Cloudhunter77/szakdolgozat/docs/kontextus/DONTESEK.md

# Döntésnapló

Állapot: **elfogadva** = Balázs megerősítette · **javaslat** = Claude javasolta, nincs megerősítve ·
**elvetve** = már nem érvényes. Új sor a táblázat aljára. Ha egy döntés megváltozik, a régi sort ne töröld,
hanem állítsd *elvetve*-re, és hivatkozz az újra.

> **Számozás (2026-10-14-i összefésülés):** a repóban 2026-10-11-én D26-ként rögzített STM32F303RET6-döntés a
> claude.ai Projekt számozásában a **D27**; a D26 a projekt neve. A D04 elvetése (repó, 2026-10-11) a D04 sorába
> került. Innentől a Projekt és a repó számozása azonos.

| # | Dátum | Döntés | Indoklás | Állapot | Forrás |
|---|---|---|---|---|---|
| D01 | 2026-09-18 | A központi vezérlő MCU **ESP32-C6** | WiFi 6 + BLE 5.3 + 802.15.4 (Thread) egy chipen, hivatalos Matter SDK | elfogadva | [c6-firmware](beszelgetesek/2026-09-18-c6-firmware-tervezes.md) |
| D02 | 2026-09-18 | A C6 firmware-alapja az **ESP-Matter** (Espressif SDK, `connectedhomeip` alapon) | Gyártói, karbantartott, kész példák | elfogadva | [c6-firmware](beszelgetesek/2026-09-18-c6-firmware-tervezes.md) |
| D03 | 2026-09-30 | Relé: **Schrack 24 V SPDT** (~50 db, kézben) a Songle SRD-24VDC-SL-C helyett | Megbízhatóbb, VDE, megerősített tekercs–érintkező szigetelés a 230 V-os oldalon | javaslat (típuskód függ) | [relek](beszelgetesek/2026-09-30-schrack-relek-io-expander.md) |
| D04 | 2026-09-30 | I/O expander: **TCA9554/PCA9554** a PCF8574 helyett | A PCF8574 bootkor HIGH → a relék meghúznak; a TCA9554 bemenetként indul, push-pull, ESPHome támogatja | elvetve (2026-10-11 → D18, D27: az ULN2803A-t a modul STM32-je hajtja, nem kell I/O expander) | [relek](beszelgetesek/2026-09-30-schrack-relek-io-expander.md) |
| D05 | 2026-10-02 | Ajtóérzékelés: **AH1911 Hall-kapcsoló + mágnes** a lézeres modul helyett | ~1,6 µA, nincs lézer, egyszerű bekötés, a szakdolgozatban könnyű indokolni | elfogadva (a demó erre épül) | [alkatreszek](beszelgetesek/2026-10-02-alkatreszek-led-ajtoerzekelo.md) |
| D06 | 2026-10-02 | LED-meghajtás új tervben: **logic-level FET** (pl. AO3400A); a nem logic-level FET-ek csak driverrel | 3,3 V-on a nagy FET-ek nem nyitnak ki rendesen | elvetve (→ D17) | [alkatreszek](beszelgetesek/2026-10-02-alkatreszek-led-ajtoerzekelo.md) |
| D07 | 2026-10-09 | Fejlesztés **Linux Mint** alatt, Claude Code-dal a laptopon | – | elfogadva | [mai nap](beszelgetesek/2026-10-09-esphome-demo-matter-git.md) |
| D08 | 2026-10-09 | Gyors demó **ESPHome**-mal: helyi (edge) logika a node-on, webes felület, relé bootkor KI | Még aznap bemutatható legyen, HA nélkül is működjön | elfogadva, tesztelve (`cp-01`) | [mai nap](beszelgetesek/2026-10-09-esphome-demo-matter-git.md) |
| D09 | 2026-10-09 | Végleges irány: **Matter over Thread**, vezérlő: **Home Assistant** | Balázs otthoni hálózata HA + Thread | elfogadva | [mai nap](beszelgetesek/2026-10-09-esphome-demo-matter-git.md) |
| D10 | 2026-10-09 | Matter kiindulás: esp-matter `release/v1.6` `managed_component_light`, ESP-IDF v5.5.5, `esp_matter` ~1.5.0 komponens | Nem kell connectedhomeip klón; a hivatalos CI ugyanígy fordítja a C6 Thread buildet | kiinduló alap | [mai nap](beszelgetesek/2026-10-09-esphome-demo-matter-git.md) |
| D11 | 2026-10-09 | Verziókezelés: GitHub, `firmware/` szerkezet, `cp-NN-*` annotált tag csak **hardveren tesztelt** állapotra + `CHECKPOINTS.md` | Visszaállítható, bemutatható mérföldkövek | elfogadva | [mai nap](beszelgetesek/2026-10-09-esphome-demo-matter-git.md) |
| D12 | 2026-10-09 | Munkaszabály: **minden módosító lépés előtt kérdezni** | Balázs kérése | elfogadva | [mai nap](beszelgetesek/2026-10-09-esphome-demo-matter-git.md) |
| D13 | 2026-10-09 | A megbeszéltek a repóban (`docs/kontextus/`) és a claude.ai Projekt tudástárában is | A Claude Code és a claude.ai chatek ugyanazt a képet lássák | elfogadva | [mai nap](beszelgetesek/2026-10-09-esphome-demo-matter-git.md) |
| D14 | 2026-10-09 | Fejlesztéshez a HA Matter Serverben **test-net DCL** bekapcsolva (teszt PAA/DAC elfogadása) | A példa firmware teszt tanúsítvánnyal (VID 0xFFF1) jelentkezik, enélkül a HA az attesztációnál elutasítja | elfogadva | [NAPLO](NAPLO.md) 2026-10-09 |
| D15 | 2026-10-09 | Breadboard LED-meghajtó: kétfokozatú NPN szintillesztő (BC546B) + **FDP2532** low-side, ≈ 12 V gate, 2 csatorna (GPIO20, GPIO21), PWM ≤ 1 kHz | A kézben lévő alkatrészekből; nem invertál, bootkor KI | elfogadva, megépítve és bemérve | [led-breadboard](beszelgetesek/2026-10-09-led-meghajto-breadboard-cct.md) |
| D16 | 2026-10-10 | Egy **CCT szalag** (3000/6000 K, 24 V, 16 W/m, 18 m; táp 15 A) a két csatornán: Matter Color Temperature Light, maximális fényerős keverés, áramszünet után KI, 0,5 s átmenet, BOOT 1×: ki/be, 2×: színléptetés; a board RGB LED-je állapotjelző; GPIO20 = meleg, GPIO21 = hideg (nem végleges) | Balázs válaszai | elfogadva (firmware még nincs kész) | [led-breadboard](beszelgetesek/2026-10-09-led-meghajto-breadboard-cct.md) |
| D17 | 2026-10-10 | Végleges LED-modul: csatornánként **10 A**, PWM **20 kHz felett (25 kHz)**, **gate driver** (pl. UCC27524, 12 V) + **60 V-os normál FET** (pl. IPD053N06N); a PWM-et a modul MCU-ja adja | 3,3 V-ról a logic-level FET sem nyit ki biztosan, a PWM-forrás kevés áramot ad → 25 kHz-en W-os veszteség; driverrel kb. 1 W/csatorna, hűtőborda nélkül | követelmény és irány elfogadva; típusok javaslat; csatornaszám → D39, D43 | [architektura](beszelgetesek/2026-10-10-node-modul-architektura.md) |
| D18 | 2026-10-10 | **Node = ESP32-C6 vezérlő + modulok**; minden modulon saját MCU (STM32), modul–vezérlő ≤ 0,5 m, JST-lánc; a node-ok Matter over Thread / WiFi / Ethernet kapcsolattal | Okos, cserélhető modulok; kb. 20 STM32 kézben | elfogadva | [architektura](beszelgetesek/2026-10-10-node-modul-architektura.md) |
| D19 | 2026-10-10 | Modul-busz: **CAN** (C6 TWAI + 3,3 V transceiver, pl. TCAN330); JST-XH 4 tű: +24 V, GND, CAN_H, CAN_L; 120 Ω a vezérlőn + lezáródugó a lánc végén | UID-alapú címkiosztás plusz vezeték nélkül, eseményvezérelt, bírja a GND-eltolódást; az RS-485 itt nem ad többet | elfogadva; a feltétel (CAN az STM32-ben) teljesül → D27; a lánc kiosztása és a modulok transceivere módosult → D28; a lezárás módja → D49, D52; a vezérlő transceivere TCAN1044AV → D60 | [architektura](beszelgetesek/2026-10-10-node-modul-architektura.md) |
| D20 | 2026-10-10 | Okos modulok: **automatikus címkiosztás az STM32 UID-jával**, egységes regisztertábla (típus, HW/FW verzió, UID, képességek, állapot, hőmérséklet, hibaszámlálók); modul-firmware frissítése a buszon **bootloaderrel** | Minden automatikus legyen; 20 modult nem lehet egyenként ST-Linkkel frissíteni | elfogadva (a bootloader a NYÁK-rendelés után; a NYÁK-on: SWD, BOOT0 pad, ≥ 64 KB flash) | [architektura](beszelgetesek/2026-10-10-node-modul-architektura.md) |
| D21 | 2026-10-10 | Matter: a node **Matter-híd** (Aggregator + modulonként Bridged Node endpoint, Reachable attribútum, UID → endpoint az NVS-ben) | Új modul újrapárosítás nélkül jelenik meg a HA-ban | elfogadva (a váltás egyszer újrapárosítással jár; a HA dinamikus endpoint-kezelését tesztelni kell) | [architektura](beszelgetesek/2026-10-10-node-modul-architektura.md) |
| D22 | 2026-10-10 | Állapot: busz- vagy vezérlőkiesésnél a modul **tartja az utolsó állapotot**; a hiteles állapot a vezérlőnél, modul-újrainduláskor visszaküldi; teljes áramszünet → StartUpOnOff | Balázs kérése; a modul nem koptatja a flash-t | elfogadva | [architektura](beszelgetesek/2026-10-10-node-modul-architektura.md) |
| D23 | 2026-10-10 | Táp: a JST-láncon csak logikai táp; nagyáramú modulnak saját sorkapocs + biztosíték; csillagpont; a 24 V bemeneten TVS + fordított polaritás elleni P-FET; modulonként ≥ 60 V-os buck (pl. LMR36006) | Földhurok, túlfeszültség (a TVS kb. 45 V-on vág), JST-áramkorlát | elfogadva (típusok javaslat); a láncon nincs többé 24 V, csak a busz 5 V-ja → D28; a modulmag buckja helyett P78E05 + NCP1117 → D56, D57 · a fordított polaritás elleni P-FET helyett Schottky / ideális dióda (D65, D71) | [architektura](beszelgetesek/2026-10-10-node-modul-architektura.md) |
| D24 | 2026-10-10 | EMC: fázistolás és frekvencia-dithering firmware-ből, lassított él, kis hurkok; CAN ESD-dióda + osztott lezárás; snubber / CM fojtó / ferrit csak footprintként | A kereskedelmi termékek olcsó eszközei; alkatrész csak mérés alapján | elfogadva (irányelv); az osztott lezárás helyett sima 120 Ω → D52 | [architektura](beszelgetesek/2026-10-10-node-modul-architektura.md) |
| D25 | 2026-10-10 | Védésre: **vezérlő + 3 modul** (LED CCT, relé, szenzor), közös „modulmag” blokk; NYÁK-rendelés legkésőbb **≈ 2026-10-31** | Balázs határideje; a modulmagot egyszer kell megtervezni | elfogadva | [architektura](beszelgetesek/2026-10-10-node-modul-architektura.md) |
| D26 | 2026-09-18 | A projekt neve: **Moduláris okosotthon platform** (a ModuNode munkanév helyett) | Balázs döntése („a modunode-ot felejtsd el”) | elfogadva (a dokumentumokban még ModuNode szerepel) | [can-izolacio](beszelgetesek/2026-10-13-can-izolacio-stm32f303.md) |
| D27 | 2026-10-11 / 2026-10-13 | Modul-MCU a prototípushoz: **STM32F303RET6** (8 db kézben): 1× bxCAN, 512 KB flash, 72 MHz, LQFP64. CAN a **PA11/PA12** lábakon. A gyári ROM bootloader nem tud CAN-t → saját bootloader (D20). Firmware: MCU-független protokoll + vékony hardverréteg (`can_hw`, `pwm_hw`, `flash_hw`) | Van benne CAN → a D19 feltétele teljesül; 25 kHz-en ~11,5 bites PWM; 3 modul + 5 tartalék. A PA11/PA12, mert a G4-en a PB8 = BOOT0 | elfogadva (MCU); a repóban 2026-10-11-én D26-ként rögzítve. Csereút: STM32G431RBT6 (FDCAN) – javaslat; az ST AN5094 szerint a G4 LQFP64-es lábkiosztása eltér az F303-étól → új layout kell, a CAN-meghajtó absztrakciós réteg mögé · MCU → **D78** (STM32L433RCT3, 75 db kézben) | [can-izolacio](beszelgetesek/2026-10-13-can-izolacio-stm32f303.md), [NAPLO](NAPLO.md) 2026-10-11 |
| D28 | 2026-10-13 | **Galvanikusan leválasztott modulbusz:** modulonként izolált CAN transceiver; lánc, JST-XH 4 tű: **V_BUS 5 V, GND_BUS, CAN_H, CAN_L** – nincs 24 V a láncon; a V_BUS-t a vezérlő adja áramkorlátozva, a modulok V_BUS-bemenete védett (polyfuse + TVS); a szenzormodul járhat V_BUS-ról | Bármely modul bármely tápra / fázisra köthető; elvesző föld esetén nincs út a 10–20 A-nek a vékony láncon; a lánc zárlata nem zár rövidre 24 V-os tápot; a busz túléli a félredugást | irány elfogadva (Balázs: „hajlok az igen felé”); a kiosztás javaslat; az IC → D33; a prototípusban opcionális → D35, D36; a V_BUS túlfeszültség-védelme → D55. Elvetve: ISOW1044 (drága, ~47 % hatásfok, EMC); ISO1540 (I²C-izolátor, nem CAN) · **a galvanikus leválasztás, a GND_BUS és a modulok saját 24 V-os logikai tápja megszűnt → D71** (közös föld, V_BUS = minden modul logikai tápja) | [can-izolacio](beszelgetesek/2026-10-13-can-izolacio-stm32f303.md) |
| D29 | 2026-10-13 | **Audió kikerül a modulrendszerből:** a hangkijátszó egység önálló, saját Wi-Fi-vel; a vezérlőnek nem kell I²S | Balázs döntése; CAN-en hang egyébként sem vihető (≤ 1 Mbit/s vs. ~1,4 Mbit/s) | elfogadva | [can-izolacio](beszelgetesek/2026-10-13-can-izolacio-stm32f303.md) |
| D30 | 2026-10-13 | Tűzvédelem a teljesítményúton: biztosíték a forrás oldalán; a LED-táp ágakra bontva (≤ 100 W/ág, ágankénti biztosíték); rugós sorkapocs + érvéghüvely; álmennyezetben/tetőtérben V-0 vagy fém ház, relémodul elosztódobozban; firmware-NTC csak harmadik réteg | Az izoláció a jelutat védi, a teljesítményutat nem | javaslat · a blokk-biztosíték értéke a szalaghoz → D76 · a LED-modul 20 A-es útján csavaros sorkapocs → D79 | [can-izolacio](beszelgetesek/2026-10-13-can-izolacio-stm32f303.md) |
| D31 | 2026-10-13 | Modul-protokoll: saját, **CANopen-fogalmakra** építve (heartbeat, SDO-szerű regiszterelérés, PDO-szerű események, LSS-szerű UID-címkiosztás), nem teljes CANopen-stack | Egyszerű, de szabványra hivatkozható a dolgozatban | javaslat | [can-izolacio](beszelgetesek/2026-10-13-can-izolacio-stm32f303.md) |
| D32 | 2026-10-13 | Multi-protocol: a node felé a **Matter** (Thread / Wi-Fi / Ethernet, node-onként választható firmware; MQTT később); a modulbusz egységes CAN marad, a protokoll-sokféleség a modulon belül van (átjáró-modul = új modultípus) | C6: egyszerre egy 802.15.4-stack, a Wi-Fi a Threaddel osztozik; egy busz = egy modulmag, kevesebb tesztelés | javaslat | [can-izolacio](beszelgetesek/2026-10-13-can-izolacio-stm32f303.md) |
| D33 | 2026-10-13 | Izolált CAN transceiver: **TI ISO1042BDWVR** (8 lábú SOIC, 7,5 mm széles test, 1,27 mm lábtáv), 10 db DigiKey-ről; az ISO1050DUBR elvetve | ±70 V-os buszlábak (48 V-ot is bír), 5 kVrms; a TI új tervekhez ezt ajánlja; DigiKey-n 30 221 db raktáron. Az ISO1050 csak −27 … +40 V, más tok (2,54 mm) és felcserélt RXD/TXD → nem csereszabatos | típus elfogadva; a DigiKey-rendelés elvetve (költség) → beszerzés: D35 · **→ D71: a v1-ben nincs ISO1042, minden lapon TCAN1044AV** | [can-izolacio](beszelgetesek/2026-10-13-can-izolacio-stm32f303.md) |
| D34 | 2026-10-13 | **24 V-ra tervezünk.** Esetleges 48 V-os (pl. kerti, nagyobb távolságú) változat később: a busz oldal kész (ISO1042), a teljesítményoldalt (TVS, buck, FET, relé, kondenzátorok) és a V_BUS táplálását akkor kell újratervezni; a CAN-bitráta firmware-ből állítható | A 48 V nem fix; a határidőig a 24 V-os prototípus a cél | elfogadva (→ `V2-OTLETEK.md`) · a busz-oldal D71 óta TCAN1044AV (±58 V); a táp 12–26 V (D71) | [can-izolacio](beszelgetesek/2026-10-13-can-izolacio-stm32f303.md) |
| D35 | 2026-10-13 | Az ISO1042 **csak TI-sample-ből**; ha nem érkezik meg, a prototípus **izoláció nélkül** készül. A modulmagon kettős footprint: ISO1042 (DWV) **vagy** szabványos SO-8-as, 3,3 V-os nem izolált CAN transceiver; nem izolált módban a GND_BUS–modul-GND átkötés polyfuse-on át, és minden modul + a vezérlő egy tápról, csillagpontos földdel | Balázs: most nem fér bele a költség, a prototípusban az izoláció elhagyható | beszerzés (TI-sample) elfogadva; a kettős footprint elvetve → D36 · → D71 (izoláció nincs) | [can-izolacio](beszelgetesek/2026-10-13-can-izolacio-stm32f303.md) |
| D36 | 2026-10-13 | A modulmag NYÁK-ján **csak az ISO1042 (DWV) footprintje** van, nincs kettős footprint. Ha a sample nem érkezik meg: ideiglenesen nem izolált 3,3 V-os transceiver-breakout (pl. SN65HVD230) az ISO1042 padjeire kötve (1 VCC1 → 3V3, 2 TXD, 3 RXD, 4 GND1 → GND, 5 GND2 összekötve a 4-gyel, 6 CANL, 7 CANH; a 8 VCC2 szabad); a breakout 120 Ω-os lezárását le kell venni; minden modul + a vezérlő egy tápról | Balázs: a végleges változatban biztosan ISO1042 lesz → tiszta NYÁK. Izolált transceiver nélkül a modul egyáltalán nem kommunikálna, ezért kell a tartalék | elfogadva; a breakout-tartalék javaslat · → D71 (izoláció nincs, a breakout-tartalék tárgytalan) | [can-izolacio](beszelgetesek/2026-10-13-can-izolacio-stm32f303.md) |
| D37 | 2026-10-13 | **v2-re halasztva:** fogyasztásmérés a relémodulon (ADE7953 / SCT-013-030) és PoE a vezérlőn; a v2-ötletek külön jegyzetben | Balázs döntése; a határidőbe nem férnek, a v1 maradjon egyszerű | elfogadva | [V2-OTLETEK](V2-OTLETEK.md) |
| D38 | 2026-10-13 | Buszcsatlakozó: **JST-XH** (2,5 mm) a PH (2,0 mm) helyett | A láncon már nincs 24 V, így az áram (XH 3 A vs. PH 2 A) nem szempont; az XH kézzel könnyebben krimpelhető, vastagabb eret is fogad (AWG 22–30 vs. 24–32), mindenhol olcsón kapható; a helykülönbség egy 4 tűs csatlakozónál kb. 2 mm. Biztos reteszhez ugyanebben a méretben a JST XA lenne, de nehezebben beszerezhető | elfogadva | [NYAK-ELOKESZITES](NYAK-ELOKESZITES.md) |
| D39 | 2026-10-13 | **LED-modul: 5 csatorna** (R, G, B, CW, WW): 3 db UCC27524 (egy csatornája szabad), 5 FET + 5 Schottky; PWM az STM32 két szinkronizált timerén (pl. TIM1 CH1–4 + egy csatorna egy másikon); kimenet 6 pólusú push-in (közös +24 V + 5 csatorna, a szalagok közös anódúak); csatornánként 10 A, a modul össz-árama 20 A (betáp, biztosíték, NYÁK-sáv), a csatornák összegét a firmware korlátozza | Balázs döntése; RGBCCT szalag is van | elvetve → D43 (6 csatorna) | [NYAK-ELOKESZITES](NYAK-ELOKESZITES.md) |
| D40 | 2026-10-13 | **Szenzormodul: 8 általános digitális bemenet** (a 6 fiókos komód + 2 tartalék), az érzékelők 3,3 V-ot kapnak (polyfuse-on át); bemenetenként soros ellenállás + RC-szűrő + ESD (2 × TPD4E05U06); egyetlen 10 tűs XH-csatlakozó (8 jel + 3,3 V + GND); a 8 bemenet különböző lábszámú legyen (külön EXTI-vonal) + HDC3020 | Bemenetenként csak pár fillér; 8 felett már a csatlakozó növeli a lapot; általános bemenetként Hall-szenzor, reed, nyomógomb, PIR is mehet | elvetve → D44 (érzékelőnként külön csatlakozó, minél több bemenet) | [NYAK-ELOKESZITES](NYAK-ELOKESZITES.md) |
| D41 | 2026-10-13 | **Ethernet-hely a vezérlőn**, opcionálisan beültetve (PoE nélkül; a PoE v2, D37) | Balázs döntése | elfogadva; a megvalósítás (tüskesor a W5500-modulnak) elvetve → D45 (W5500 közvetlenül a NYÁK-on) | [NYAK-ELOKESZITES](NYAK-ELOKESZITES.md) |
| D42 | 2026-10-13 | **Lapméret minél kisebb; 4 rétegű NYÁK, ha nem sokkal drágább** | Balázs döntése; a 4 réteg tömör földsíkot ad (EMC a 25 kHz-es PWM mellett, CAN) és sűrűbb, kisebb lapot | elfogadva (az árat a JLC-ajánlatkérőben a tényleges méretekkel ellenőrizni); a lapméretek → D50 | [NYAK-ELOKESZITES](NYAK-ELOKESZITES.md) |
| D43 | 2026-10-13 | **LED-modul: 6 csatorna** → 2 × RGB, 3 × CCT vagy 6 × egyszínű szalag. 3 db UCC27524 (mind a 6 drivercsatorna kihasználva), 6 FET + 6 Schottky. Low-side kapcsolás → a szalagok **közös vezetéke a +24 V** (nem a GND). Kimenet 3 × 3 pólusú push-in blokk: [+24 V, CH1, CH2] [+24 V, CH3, CH4] [+24 V, CH5, CH6] – CCT: blokkonként egy szalag; RGB: R-G-B három egymást követő csatornán, bármelyik +24 V-ról; egyszínű: két szalag egy +24 V-on, iker érvéghüvellyel. Csatornánként 10 A, **össz-áram max. 20 A** (firmware-korlát). Betáp: 2 pólusú push-in 2,5 mm²-hez, **3 eres kábel** (barna +24 V, kék GND, a zöld-sárga nem használható, a kábelt „24 V DC” jelöléssel), 20 A-es mini lapos biztosíték a NYÁK-on. PWM: TIM1 CH1–3 + TIM8 CH1–3, szinkronizálva | Balázs döntése; a 6 csatorna 3 driverrel kihasználja az UCC27524 mindkét csatornáját; a 3 blokkos kiosztás mindhárom szalagtípushoz jó. 20 A-hez 2,5 mm² kell (1,5 mm² kevés, és 24 V-on a feszültségesés is számít) | elfogadva (6 csatorna, 20 A, 3 eres kábel); a kiosztás, a keresztmetszet, a biztosíték és a timerek javaslat | [NYAK-ELOKESZITES](NYAK-ELOKESZITES.md) |
| D44 | 2026-10-13 | **Szenzormodul → általános bemeneti modul:** érzékelőnként külön 3 tűs JST-XH (3,3 V, GND, JEL); a lehető legtöbb STM32-lábat kihasználni (az F303RET6-on kb. 36–38 szabad láb). Javaslat: **16 csatlakozó** a lap két hosszú élén + a többi szabad láb egy **bővítő tüskesoron**; bemenetenként soros ellenállás + ESD (4 × TPD4E05U06) + opcionális felhúzó/lehúzó-ellenállás footprint (osztóként 12/24 V-os jelhez is); néhány csatlakozó ADC-képes lábon; az érzékelők 3,3 V-ja polyfuse-on át; + HDC3020 | Balázs: ahol csak egy dolgot kell figyelni, ne kelljen 10 tűs csatlakozó; minél több láb legyen kihasználva. Mind a ~36 láb külön csatlakozóval kb. 100 × 100 mm-es lapot adna; 16-tal kb. 80–90 mm hosszú | elfogadva (külön csatlakozó, általános bemenetek); a darabszám és a bővítő tüskesor → D48; a csatlakozótípus → D51 | [NYAK-ELOKESZITES](NYAK-ELOKESZITES.md) |
| D45 | 2026-10-13 | **Ethernet közvetlenül a vezérlő NYÁK-ján:** W5500 (LQFP48) + RJ45 beépített trafóval (MagJack) + 25 MHz-es kvarc, a WIZnet referencia-kapcsolása szerint, opcionálisan beültetve; a két differenciális érpár rövid, 100 Ω-os, folytonos földsík fölött (4 réteg, a JLC impedancia-kalkulátorával) | Balázs: nem akar külön modult. A W5500-ban MAC és PHY is van, kevés a külső alkatrész; a trafó egyben galvanikus leválasztás | elfogadva | [NYAK-ELOKESZITES](NYAK-ELOKESZITES.md) |
| D46 | 2026-10-13 | **Vezérlő tápja: két buck a 24 V-ról** – LMR36015 → 3,3 V (C6 + W5500 + TCAN330), LMR36006 → 5 V (V_BUS). Ugyanaz a buck-blokk (hierarchikus lap), mint a modulmagban, csak más IC-vel / visszacsatoló ellenállással; a NYÁK mellé stencil a reflow-hoz | Egyszer kell megtervezni és bemérni; 5 V → 3,3 V LDO-val a C6 + W5500 áramánál túl melegedne | lezárva → D59: a 3,3 V marad LMR36015, a V_BUS-t a P78E05 adja (az LMR36006 elmarad) | [NYAK-ELOKESZITES](NYAK-ELOKESZITES.md) |
| D47 | 2026-10-13 | **LED-modul mérései:** (1) bemeneti 24 V (biztosíték előtt) és a biztosíték utáni +24 V-os sín (= a LED-ek felé menő feszültség) – 100 kΩ/10 kΩ-os osztók az ADC-re; (2) **össz-áram**: 1 mΩ-os sönt (2512, ≥ 1 W, Kelvin-bekötés) a közös visszatérő ágban + **INA181A3** (×100 → 20 A = 2,0 V); offset-nullázás induláskor; (3) **hardveres túláramvédelem**: az F303 belső komparátora az INA kimenetén → a TIM1/TIM8 break bemenete (a PWM firmware nélkül leáll); (4) **csatornánkénti áram nincs**: induláskori önteszt (csatornánként rövid, halvány villanás, kisebb PWM-frekvencián, a bekapcsolt szakasz közepén timer-triggerelt ADC-vel) → csatornánkénti csúcsáram; üzem közben a csatornánkénti teljesítmény a kitöltésből és a mért feszültségből becsülve | Balázs: az össz-áram + kitöltés-alapú becslés elég, az indulási villanás elfogadható. Kb. 8 alkatrész; a hardveres lekapcsolás a tűzvédelemhez sokat ad | elfogadva (alkatrészértékek javaslat); az erősítő, a küszöb és az osztók pontosítva → D53, D54 | [NYAK-ELOKESZITES](NYAK-ELOKESZITES.md) |
| D48 | 2026-10-13 | **Bemeneti modul: 16 általános bemenet**, mindegyik külön 3 tűs csatlakozón, **bővítő tüskesor nélkül**. Ha egy helyen több kell, még egy bemeneti modul kerül a láncra – modulhoz nem kerül kiegészítő modul. A fel nem használt STM32-lábak firmware-ben analóg módban (legkisebb fogyasztás, EMC) | Balázs: 16-nál több bemenet sehol nem kell; a modulrendszer épp a bővítésre való | elvetve → D100 (7 bemenet) | [NYAK-ELOKESZITES](NYAK-ELOKESZITES.md) |
| D49 | 2026-10-13 | **CAN-lezárás jumperrel** minden modulon és a vezérlőn (a vezérlőn és a lánc utolsó modulján bedugva); a jumper az osztott lezárást (2 × 60 Ω + 4,7 nF) kapcsolja; lezáródugó nincs | Balázs döntése; nem vész el egy dugó, és a vezérlő a lánc közepére is kerülhet | elfogadva (jumper); a kapcsolás pontosítva → D52 (sima 120 Ω) | [NYAK-ELOKESZITES](NYAK-ELOKESZITES.md) |
| D50 | 2026-10-13 | **Mechanika: DIN 43880 szerinti moduláris ház-forma** (90 mm magas, 45 mm-es előlap, szélesség 17,5/18 mm-es modulosztásban, kb. 53–58 mm mély), a NYÁK a ház alján fekszik. **Felső váll:** 24 V-os betáp + CAN-busz be/ki (XH) + lezáró jumper; **alsó váll:** a „terepi” csatlakozók (LED-kimenetek, relékimenetek, érzékelők); **előlap:** állapot-LED-ek fényvezetővel. A NYÁK-ot egy kereskedelmi DIN-ház (pl. Camdenboss CNMB) belső méretére tervezni, a 3D-nyomtatott ház ugyanezt a formát követi. Becsült méretek: vezérlő 4 M (~70 mm, NYÁK ~66 × 85 mm), LED-modul 4 M, relémodul 4 M, bemeneti modul 6 M (~106 mm, NYÁK ~100 × 85 mm) | Elosztószekrény fedele alá is befér (a relémodulnak ott a helye, D30); a kábelek a vállakon a kábelcsatornába futnak; a 230 V (relé) és a törpefeszültség természetes módon felül/alul szétválik; a gyári ház és a nyomtatott ház is jó | javaslat · a ház kiválasztva → D73 | [NYAK-ELOKESZITES](NYAK-ELOKESZITES.md) |
| D51 | 2026-10-13 | **Érzékelőcsatlakozók: 3 tűs JST-PH** (2,0 mm) a bemeneti modulon; a busz marad XH | Egy 3 tűs PH kb. 8 mm, az XH kb. 10 mm széles → a 16 bemenet a busz mellett kényelmesen elfér egy 6 modulos ház két vállán. Ráadásul egy érzékelő-dugó fizikailag nem dugható a buszcsatlakozóba (más lábtáv) | javaslat · megvalósítva (bemeneti modul, J301–J316) | [NYAK-ELOKESZITES](NYAK-ELOKESZITES.md) |
| D52 | 2026-10-13 | **CAN-lezárás: sima 120 Ω egy jumperrel** (CAN_H → jumper → 120 Ω → CAN_L), nem osztott lezárás; csak a lánc két végén bedugva | Egyetlen jumperrel az osztott lezárás nem kapcsolható ki tisztán (nyitva a 60 Ω + 4,7 nF a CAN_L-en maradna → aszimmetrikus terhelés); 0,5 m-es buszon a sima 120 Ω tökéletes | javaslat | [MODULMAG-SPEC](MODULMAG-SPEC.md) |
| D53 | 2026-10-13 | **LED-modul túláramvédelem pontosítva:** **INA181A2** (×50; 20 A → 1,0 V, ~66 A-ig mér) alacsony oldali 1 mΩ-os söntön; a kimenet a PA7-re (ADC2_IN4 + COMP2 nem invertáló bemenet); a COMP2 invertáló bemenete a **DAC1_OUT1 (PA4, foglalt)** → telepítésenként állítható küszöb (alapból ~22 A; tartalék fix küszöb: VREFINT ≈ 24 A, ¾ ≈ 18 A, ½ ≈ 12 A); a COMP2 kimenete a TIM1 BKIN2 + TIM8 BKIN2-re; a firmware a COMP2-t és a DAC-ot a DRV_EN előtt állítja be | Egy fix 24 A-es küszöb egy 15 A-es tápnál soha nem oldana ki; a DAC-küszöbbel a ténylegesen beállított maximumhoz igazítható | javaslat | [MODULMAG-SPEC](MODULMAG-SPEC.md) |
| D54 | 2026-10-13 | **Modulmag-lábkiosztás és -tápleágazás:** CAN = PA11/PA12, SWD = PA13/PA14, debug-UART = USART1 PC4/PC5, HSE = PF0/PF1, állapot-LED = PC13 (nyelő), HW-ID = PC0, VIN_SENSE = PC1 (150 kΩ/10 kΩ); modulspecifikus lábak a MODULMAG-SPEC 7. fejezete szerint (LED: TIM1 PA8–PA10, TIM8 PC6–PC8, I_SENSE PA7, DAC PA4, V_RAIL PC2, NTC PC3, DRV_EN PB12 4,7 kΩ lehúzással; relé: PB12–PB15; bemeneti: IN0–IN15 = PA0–PA10, PB11–PB15, I²C1 PB8/PB9). A LED-modul logikai tápja a 20 A-es főbiztosíték **előtt** ágazik le (saját 0,5 A-es F1) | Az ST pin-adatai alapján ütközésmentes; a bemenetek 16 különböző EXTI-vonalon; a főbiztosíték kiégése így jelezhető | javaslat (CubeMX-ben ellenőrizendő) | [MODULMAG-SPEC](MODULMAG-SPEC.md) |
| D55 | 2026-10-13 | **V_BUS túlfeszültség-védelem a modulokon:** (1) TVS + PTC („legjobb erőfeszítés”), vagy (2) TPS2660 eFuse (OVP ~5,7 V) minden modulon | Az ISO1042 VCC2-je és a TLV75533 bemenete abszolút max. 6 V; az 5 V-os TVS ~6,4 V-tól vezet, a PTC lassú → egy félredugott 24 V-ot nem véd biztosan | **lezárva (Balázs, 2026-10-14): nincs 24 V elleni védelem** („nem lesz 24 V a buszon”, D28); a modulokról a PTC is kikerül (a TPS2553 előbb korlátoz), az 5 V-os TVS marad az ESD / hot-plug ellen; TPS2660 nem kell · → D71: a túlfeszültség (5,7 V) és a túláram (2 A) ellen központi TPS2595 eFuse véd a vezérlőn | [MODULMAG-SPEC](MODULMAG-SPEC.md) |
| D56 | 2026-10-13 | **Modulmag tápja (A változat): P78E05-1000** (CUI/Bel, 24 V → 5 V, 1 A, SIP-3, a 7805 lábkiosztásával) **+ NCP1117ST33** (onsemi LDO, 5 V → 3,3 V, SOT-223) az LMR36006BRNXR helyett; az 5 V-os sín a modul lapján elérhető. A B változat (TLV75533 a V_BUS-ról) változatlan | Kézben ~200 db P78E05 és egy tekercs NCP1117 → nem kell TI-sample, tekercs, buck-layout és VQFN-reflow; a modulmag 3,3 V-os fogyasztása < 100 mA → az LDO-n ~0,17 W. Ára: a P78E05 bemenete max. 36 V (abszolút maximum nincs megadva) a 60 V-os buck helyett → kisebb tüsketartalék (→ D57); egy 48 V-os változathoz (D34) más táp kell | elfogadva (Balázs: „van vagy 200 db a p78e05-ből, úgyhogy szerintem az lesz”); az értékek javaslat (MODULMAG-SPEC 2.); a vezérlő tápja → D59 · **→ D71: a modulokon nincs P78E05/NCP1117, a logika a V_BUS-ról jár (AP2112K)** | [alkatreszkeszlet](beszelgetesek/2026-10-14-alkatreszkeszlet-p78e05.md) |
| D57 | 2026-10-14 | **A modulmag 24 V-os bemenetének védelme a P78E05 36 V-os határa miatt:** (1) a bemeneti **elektrolit kötelező** (C12, 47 µF / 50 V, low-ESR) a kerámiák mellett; (2) az SMBJ28A marad; (3) a 24 V-os tápot **≤ 26 V**-ra állítani; (4) opcionális **10 Ω-os soros ellenállás** (R6, 1206, impulzusbíró) a D1 után, 0 Ω-mal áthidalható | Bedugáskor / hosszú betápkábelen csak kerámiával az LC-lengés a 24 V közel kétszereséig (~48 V) is felmehet – az elkó ESR-je csillapítja. Az SMBJ28A kis áramnál ~31–35 V-on, teljes impulzusáramnál ~45 V-on fog → R6 nélkül csak kiegészítő védelem; az R6 a C12-vel ~0,5 ms-os RC-szűrő, és korlátozza a TVS áramát. A tüske-veszély a modul **24 V-os betápján** van – a JST-láncon D28 óta nincs 24 V | (1)–(3) elfogadva (Balázs: „rendben”); (4) javaslat · → D71: a modulmagon nincs 24 V; a ≤ 26 V szabály a vezérlő LMR33630-a (36 V) miatt marad; a 47 µF a vezérlőn és a relémodul tekercs-tápján | [alkatreszkeszlet](beszelgetesek/2026-10-14-alkatreszkeszlet-p78e05.md) |
| D58 | 2026-10-13 | **Vezérlő kialakítása:** az USB-C-ről is jár (programozás, asztali teszt), de akkor busz nélkül; **2 átmenő XH** (a vezérlő a lánc végén vagy közepén is lehet); állapotjelzés: **RGB LED (GPIO8) + táp-LED**; bővítő tüskesor nincs, csak debug (UART0 + EN + BOOT) | Balázs válaszai; a 2 XH a D49 indoklását követi (a vezérlő a lánc közepére is kerülhet); az RGB LED-et a mostani firmware (D16) is használja | elfogadva · **→ D71: USB-ről a busz is jár (LM66200)** | [VEZERLO-SPEC](VEZERLO-SPEC.md) |
| D59 | 2026-10-14 | **Vezérlő tápja:** V_BUS (és a CAN transceiver, az RGB LED) a kézben lévő **P78E05-1000**-ről (5,0 V ± 3 %), a 3,3 V (C6 + W5500) **LMR36015BRNXR** buckról (6,8 µH); az LMR36006 elmarad. A P78E05 elé a modulmaggal azonos védelem: 10 Ω (2512) + 47 µF-os elkó + SMBJ28A | Kézben van, nem kell hozzá TI-sample; USB-ről (8 V alatt) magától nem indul. A modulon legrosszabb esetben ~4,7 V marad (az ISO1042-nek 4,5 V kell) – szűken belefér. A 3,3 V-hoz a C6 + W5500 ~0,55 A-je miatt buck kell (D46 indoklása) | elfogadva (Balázs, 2026-10-14) · **→ D71: az 5 V LMR33630 + LM66200, a V_BUS-kapcsoló TPS2595** | [VEZERLO-SPEC](VEZERLO-SPEC.md) |
| D60 | 2026-10-14 | **Vezérlő CAN transceivere: TCAN1044AVDRQ1** (SOIC-8, 5 V-os VCC + 3,3 V-os VIO) a TCAN330 helyett; két 3 padas forrasztható jumperrel ugyanarra a footprintre MCP2562FD, TCAN330 vagy SN65HVD230 is beültethető | A TCAN330 buszlábai csak ±14 V-ot bírnak, a TCAN1044AV ±58 V-ot (az MCP2562FD is) – közel az ISO1042 ±70 V-jához; a busz oldali 5 V azonos a modulokéval | elfogadva (Balázs, 2026-10-14); a TI-sample-listára fel kell venni | [VEZERLO-SPEC](VEZERLO-SPEC.md) |
| D61 | 2026-10-14 | **Vezérlő táp- és busz-logikája, lábkiosztása:** az USB külön diódás ágon (60 V-os Schottky) csak a 3,3 V-os buckot táplálja; a V_BUS-kapcsoló (TPS2553) EN-je osztóval a 24 V-os ágról jön → a V_BUS hardveresen csak 24 V mellett kapcsol be, a C6 újraindulása alatt is bekapcsolva marad, a GPIO20 BAT54-en át letilthatja; áramkorlát 61,9 kΩ (382/425/476 mA); RGB LED (WS2812B-V5) az 5 V-ról, 74HCT14-es szintillesztéssel (vagy közvetlenül); C6-lábak: W5500 SPI GPIO6/7/2 + CS 10, RST 11, INT 3; CAN 18/19; VBUS_EN 20, FAULT 21; VIN_SENSE 0, VBUS_SENSE 1; tartalék 4, 5, 22, 23 | A független ellenőrzés szerint alapból bekapcsolt V_BUS USB-ről táp-ingadozási hurkot okozna, a 40 V-os USB-dióda túlfeszültségnél zárlatosan tönkremehetne (24 V az USB-portra), a WS2812B 3,3 V-ról specifikáción kívül van | javaslat · → D71: USB-ről is van V_BUS, a TPS2595 EN-je a +5V-ról jön (a GPIO20-as tiltás marad) | [VEZERLO-SPEC](VEZERLO-SPEC.md) |
| D62 | 2026-10-14 | **Relémodul:** 4 × **Schrack RTD14024** (RT1, 1 váltóérintkező, 16 A / 250 V AC, 24 V DC-s, 400 mW-os tekercs; 5 mm-es lábtáv, mosásálló – KiCad: `Relay_THT:Relay_SPDT_Schrack-RT1-16A-FormC_RM5mm`) + ULN2803A; kimenet **csak COM + NO, 4 × 2 pólus** (az NC nincs kivezetve); **230 V-ra tervezve:** ≥ 8 mm kúszóút és légköz a törpefeszültségű résztől, marás a relék alatt, a hálózati rész alatt egyik rétegen sincs törpefeszültségű réz | A kézben lévő ~50 relé típusa (Balázs leolvasta); az NC otthoni kapcsolásban ritkán kell, a 8 pólus kisebb lapot ad; forrasztható választó 16 A-hez / 230 V-hoz nem alkalmas; a 230 V-os kialakítás törpefeszültségre is jó, fordítva nem | elfogadva (Balázs, 2026-10-14) · 230 V a belső rétegeken, csatornák közti távolság → D77 | [ATTEKINTES](ATTEKINTES.md) |
| D63 | 2026-10-14 | **ESP32-C6-WROOM-1 és -1U ugyanazon a footprinten** (`modularis:ESP32-C6-WROOM-1`), saját footprint nem kell | Az Espressif adatlap (v1.4, 11-1/11-2. ábra) és KiCad-footprintjei szerint a jelpadek és a GND-pad (EPAD) is azonos helyen vannak; a korábbi „2,5 mm-es EPAD-eltolás” téves volt | elfogadva (Balázs, 2026-10-14) | [VEZERLO-SPEC](VEZERLO-SPEC.md) |
| D64 | 2026-10-14 | **V_BUS marad 5 V-os, a TPS2553 425 mA-en (R12 = 61,9 kΩ)**; a V_BUS-mérleg pontosítva: I ≈ 73 mA (az éppen adó ISO1042) + 4 mA × A változatú modul + ~80 mA × bemeneti modul → 2 bemeneti modul mellett ~35 további modul is belefér. A TPS2553 marad (a P78E05 zárlatbiztos, de a TPS2553 ad távoli busz-újraindítást, FAULT-jelzést, bedugási áramkorlátot). 24 V a buszon (helyi 5 V-tal) elvetve | Az ISO1042 VCC2 recesszívben ≤ 4,1 mA, a 73 mA csak adáskor; a korábbi „modulonként 73 mA” becslés túl szigorú volt. A 24 V-os busz az izoláció értelmét vinné el (modulonként második P78E05 a busz-oldalra), és az XH-n nagyobb a hibaáram | elfogadva (Balázs, 2026-10-14) · **→ D71: V_BUS 2 A (TPS2595), a modulok teljes logikai fogyasztása a buszról** | [MODULMAG-SPEC](MODULMAG-SPEC.md) |
| D65 | 2026-10-14 | **LED-modul részletei:** (1) csatorna-FET **NTD5C648NL** (60 V, ~4–5 mΩ, DPAK), tartalék IRFR1205 ugyanarra a footprintre; (2) a 20 A-es főbiztosíték mellett **blokkonként SMD biztosíték** (Littelfuse NANO² 451/453, 2410, alapból 10 A) a 3 kimeneti blokk +24 V-ján; (3) csatornánként **gate-LED** (driver-kimenet → 4,7 k → LED) és **drain-LED** (blokk +24 V → 10 k → LED → drain); (4) **drain-feszültség az ADC-re** (470 k / 56 k, 10 nF) a PA0–PA3, PA5, PA6 lábakon – kikapcsolva ≈ V_RAIL (szalag rajta), ≈ V_RAIL − ~2 V (nincs szalag, a drain-LED-en át), ~0 V (kiolvadt blokk-biztosíték); bekapcsolva ≈ V_RAIL × (1 − kitöltés); mindig ~0 V = átütött FET; a gate nincs visszakötve; (5) **6 × RC snubber footprint** (10 Ω + 2,2 nF, 1206) DNP, közös módusú fojtó nincs; (6) **fordított polaritás:** LM74700-Q1 ideális dióda-vezérlő + NTMFS5C604NL (60 V, ~1,2 mΩ, SO-8FL) a +24 V-os ágban a főbiztosíték után, S–D dróttal áthidalható; egyéb: szabadonfutó B360B (SMB) a blokk +24 V-jára, gate 10 Ω + 10 k lehúzás, 12 V: MC78L12 a sínről, 470 µF + 3 × 10 µF a sínen (a GND-oldaluk a sönt előtt), NTC 10 k (PC3), HW-ID 10 k / 3,3 k; **DRV_EN-lehúzás 1 kΩ** (a D54 4,7 kΩ-ja helyett: a 6 EN-láb 200 kΩ-os belső felhúzása párhuzamosan ~33 kΩ → 4,7 kΩ-mal ~1,5 V lenne, a küszöb 0,8 V) | Balázs válaszai; a SUM110P08 (készlet) 20 A-en 4,5–6 W-ot fűtene, a GND-ágbeli N-FET a sönt- és a feszültségmérést eltolná; a drain-mérés firmware-ből hibajelzést ad a HA felé | elfogadva (Balázs, 2026-10-14) · a HW-ID értéke → D71 (16 sáv: 10 k / 715 Ω) · gate-LED 10 k, blokk-biztosíték a szalaghoz → D76 · az ideális dióda (LM74700) helyett N-FET a GND-ágban, az NTC helyett MCP9701A → D78 | [led-modul.py](../../hardware/gen/led-modul.py) |
| D66 | 2026-10-16 | **Bemeneti modul részletei:** (1) **saját 24 V-ról jár** (A változat, izolált) – a B változat (TLV75533 a V_BUS-ról) elvetve; (2) a modulmagon **opcionális buszos táp**: D6 (SS14, `V_BUS_P` → `+5V`) + JP2 (`GND_BUS` ↔ `GND`), alapból üres – így bármelyik modul 24 V nélkül, izoláció nélkül a buszról is járhat; (3) bemenetenként **1 k soros + 10 k felhúzás + 10 nF**, + üres lehúzás-footprint osztónak (5 V: 2k2/3k9; 12/24 V: 68k/10k) + ESD (4 × TPD4E05U06, MCU-oldalon); (4) **érzékelő-táp: 4 csoport × 4 PH**, csoportonként 3 padas forrasztható választó (alap 3,3 V, átforrasztva 5 V) + PTC 0,2 A; a 3,3 V-os érzékelősín külön NCP1117 az 5 V-ról; (5) **HDC3020 a NYÁK-on** (0x44, ALERT → PC2) + **4 tűs PH I²C-csatlakozó** külső érzékelőhöz (100 Ω + ESD, saját PTC); (6) bemenetenkénti LED nincs; HW-ID 3,3 k / 10 k (6. sáv) | Balázs: „a lehető legtöbb szenzor bekötése”; az A változattal mindhárom modulon azonos a modulmag és megmarad az izoláció, a busz terhelése nem nő; a 24 V nélküli használatot a buszos táp opció adja; az STM32F303 ADC-s lábai TTa (≤ 3,6 V), csak a PA8–PA10 5 V-tűrő | elfogadva (Balázs, 2026-10-16) · **→ D71: (1)–(2) megszűnt – nincs 24 V a bemeneti modulon, a buszos táp az egyetlen; az érzékelősín LDO-ja AP2112K; HW-ID 10 k / 2,49 k** · a bemeneti szűrő (felhúzás a csatlakozó oldalán, 10 k soros) → D75 | [bemeneti-modul.py](../../hardware/gen/bemeneti-modul.py) |
| D67 | 2026-10-19 | **Kapcsolási rajzok forrása:** amíg egy lapot Balázs nem szerkeszt kézzel, a `hardware/gen/*.py` generátor a forrás; amint kézzel átrendez rajta valamit, **onnantól a `.kicad_sch` a forrás**, arra a lapra a generátort nem futtatjuk újra (a szkript csak kiindulásként marad). Claude ezután közvetlenül a fájlban vagy a KiCad MCP-vel (írható mód) módosít, ERC + netlista-összevetés + vizuális ellenőrzés mellett; egyszerre csak egyikünk szerkeszti a lapot (Balázs ment → Claude módosít → KiCad-ben újratöltés) | A generátor minden futáskor a teljes fájlt újraírja, a kézi mozgatások elvesznének; a mozgatásokat visszavezetni a szkriptbe lassú és hibalehetőség | elfogadva (Balázs, 2026-10-19) | [gen/](../../hardware/gen/) |
| D68 | 2026-10-19 | **LoRa-előkészítés a vezérlőn, minden DNP:** Ebyte **E22-900M22S** (SX1262, 868 MHz, 22 dBm, 14 × 20 mm) + **u.FL** (J7, pigtail a ház SMA-jához); SPI a W5500-zal közös; **CS = GPIO22** (R51 10k felhúzás), **BUSY = GPIO23**, **DIO1 = GPIO4**, **NRST = W5500_RST (közös reset)**; TXEN = DIO2, RXEN = ¬DIO2 (U11 74LVC1G04) → firmware: `setDio2AsRfSwitch`; táp: R46 0 Ω + C51 10 µF + C52 100 nF (+3V3_LORA). A TP1–TP4 (GPIO4/5/22/23) tesztpontok megszűntek | Balázs: kerti eszközhöz később kapcsolat, a bemutatóig nem kell működnie; a közös reset egy GPIO-t (GPIO5) szabadon hagy; a DIO1 magas aktív, a W5500 INT alacsony aktív → nem közösíthető | elfogadva (Balázs, 2026-10-19) · EU-s TX-teljesítmény (14 dBm) → D77 | [vezerlo.py](../../hardware/gen/vezerlo.py) |
| D69 | 2026-10-19 | **Future-proofing:** (1) vezérlő: **J8 bővítő** (PH 3 tűs: 3V3, GPIO5 = ADC1_CH5, GND) + DNP 4,7k felhúzás és DNP lehúzás/osztó; (2) vezérlő: **mérőpontok** +24V_P, +5V, +3V3, V_BUS, CAN_H, CAN_L, GND; (3) modulmag: **revízió-osztó** egy szabad ADC-lábon (HW_REV); (4) modulmag: **DNP 2 × 5-ös bővítő-tüskesor** a szabad STM32-lábakra (SPI, I²C, PA15) – ha a layoutban elfér; (5) relémodul: **DNP SCT-013-jack** + terhelő-ellenállás + középfeszültség egy szabad ADC-lábon (D37 előkészítése); (6) layout: 3 fiducial, szerelőfuratok, selyemnyomat-feliratok, revízió + dátum. Közben a VEZERLO-SPEC hiányzó DNP-footprintjei is bekerültek (USB C49/C50, R47 1 MΩ, R48–R50 PMODE, L2 CAN-fojtó + JP4/JP5 áthidaló), és az U1 saját RNX-footprintet kapott | olcsó (többnyire DNP), a v2-ig újrarendelés nélkül bővíthető | elfogadva (Balázs, 2026-10-19) · a HW_REV v1-értéke → D71 (1. sáv) | [vezerlo.py](../../hardware/gen/vezerlo.py) |
| D70 | 2026-10-19 | **A 24 V-os bemeneti soros ellenállás 0 Ω** a modulmagon (R6, 1206) és a vezérlőn (R7, 2512); a footprint marad, szükség esetén 10 Ω impulzusbíró ültethető (módosítja a D57-et). A 47 µF-os elkó és a TVS marad. A VIN_SENSE firmware-korrekciójából az R-esés kimarad | Balázs: nem szükséges. 10 Ω-mal a relémodulon ~1 V / 0,1 W, a bemeneti modulon legrosszabb esetben ~2,4 V / 0,6 W esett volna rajta; az ára, hogy bedugáskor a TVS nagyobb áramon, magasabban fog (a P78E05 36 V-os határához közelebb) – a 24 V-os táp ≤ 26 V szabály ezért fontosabb | elfogadva (Balázs, 2026-10-19) · a modulmagon az R6 a D71-gyel megszűnt; a vezérlő R7-je marad | D57 |
| D71 | 2026-10-20 | **Központi 5 V (konzultáció után):** a 24 V → 5 V-os átalakító **csak a vezérlőn** van, 2–3 A-re méretezve; ez táplálja a buszon (V_BUS) a modulokat és minden ráköthető eszközt. A modulokról a P78E05 (és a hozzá tartozó 5 V-os ág) kikerül, a modul logikája a V_BUS-ról jár (módosítja a D56-ot, D64-et, D66-ot). **Balázs válaszai (10-20):** (1) a CAN-izoláció **elmarad** – közös föld, sima transceiver; (2) a busz **marad 4 tűs XH** (a 3 A bőven elég, a nagy fogyasztók 24 V-ot kapnak); (3) a **bemeneti modulon nincs 24 V**, csak a buszról jár. Grilling 1. kör (10-20): 5 V = **LMR33630** (TI, 36 V, 3 A, HSOIC-8, 400 kHz, ~2 A-re méretezve; a ≤ 26 V szabály marad); V_BUS-kapcsoló = **TPS2595** eFuse (5,7 V-os túlfeszültség-vágás, **2 A** korlát) a TPS2553 helyett; modul-transceiver = **TCAN1044AV** (VCC = V_BUS, VIO = 3,3 V); a **modulmag 24 V-mentes** (F1/SS16/SMBJ28A/elkó/VIN_SENSE kikerül; a LED-modul a saját ágán méri a 24 V-ot, a relémodul kis 24 V-os bemenetet kap a tekercseknek + VIN_SENSE); a D66 buszos tápja lesz az egyetlen: D6 és JP2 kikerül, V_BUS közvetlenül +5V, GND fixen összekötve; a modulokon csak az 5 V-os ESD-TVS; a vezérlő 3,3 V-ja marad az LMR36015; a HW-ID és a HW_REV marad; **USB-ről is legyen 5 V a buszon** (1–2 modul teszteléséhez 24 V nélkül – a D61 „USB-ről a V_BUS KI” elve módosul); a modulok 3,3 V-ja kis ejtésű LDO lesz (vásárolva). 2. kör (10-20): **közös föld + bekötési szabály** (a vezérlő és minden modul ugyanarról a tápról, csillagpontosan); modul-LDO = **AP2112K-3.3** (a bemeneti modul érzékelősínjén is, az NCP1117 helyett); USB-ág: **LM66200** kettős ideális dióda (buck 5,2 V + VUSB) → TPS2595, a V_BUS bármelyik forrásról magától bekapcsol, GPIO20-szal kikapcsolható; **12–26 V-os táp** mindenhol (a szalag feszültsége = a tápé); relémodul 12 V-on: **beültetési változat** 12 V-os tekercsű relével, a firmware a VIN_SENSE alapján tilt; HW-ID és HW_REV **16 sáv**: 1–14 modulfajta/revízió, 0 = hiba, **15 = a firmware-ből megadott érték** (ha nincs kéznél ellenállás) 3. kör (10-20): a modulmag **PC1 = V_BUS_SENSE** (10 k / 10 k), a 24 V-mérés a LED- és a relélapra kerül; HW-ID **2 = relé 24 V-os tekercs, 4 = relé 12 V-os tekercs**; 15 = csak a felső 10 k beültetve, a fajta a flash-beállításból, ha nincs beírva: minden kimenet KI; busz-kábel AWG22, a nagy fogyasztású modulok a vezérlő közelében; beszerzés: LMR33630ADDA, TPS2595 (5,7 V), LM66200, TCAN1044AV ×3 → DigiKey/Mouser, AP2112K-3.3 → kínai kör; rajzlezárás **10-22**; utána a rendszerleírás és a kurzus frissül **Megvalósítás (10-20, Claude):** vezérlő: U2 LMR33630ADDA 5,22 V (L3 8,2 µH, 4 × 22 µF), U12 LM66200, U3 TPS259531 (R_ILM 1,02 k → 2 A, dVdt 22 nF, EN-osztó 100 k / 47 k a +5V-ról); a 12 V-os működéshez **F1 2 A, D1 B360** (a bemeneti áram 12 V-on ~1,2 A); modulmag: U5 AP2112K, U2 TCAN1044AV (STB → R12 0 Ω), R3/R4 10 k / 10 k → PC1; HW-ID R_bottom: LED 715 Ω, relé 1,54 k, bemeneti 2,49 k (12 V-os relé 3,65 k), HW_REV v1 = 715 Ω; relémodul: F100 0,5 A, D100 SS16, D105 SMBJ28A, C104/C105, VIN_SENSE (PB11). | Konzultáció 2026-10-20: egy erős táp a központban, a modulokon ne legyen külön 24 V → 5 V átalakító | elfogadva (Balázs, 2026-10-20) · modul-MCU → D78 (L433), modul-transceiver → D79 (SN65HVD230) | — |
| D72 | 2026-10-20 | **W5500: nincs breadboard-teszt, a kapcsolás a WIZnet „W5500-Ref-RJ45WithMag” referencia szerint.** Az RX-oldal ehhez igazítva: soros 6,8 nF (C19, C61) a W5500 RX-lábai és a MagJack között, a 2 × 49,9 Ω közös pontja az RCT-re megy + 10 nF a GND-re (C17); a MagJack 8-as lába (Bob Smith-lezárás) és árnyékolása `ETH_CGND`, ami 1 nF / 2 kV-on (C20) át megy a GND-re. Az SPI-lábak (GPIO6/7/2 – IO_MUX, CS GPIO10) az ESP-IDF W5500-driverével kompatibilisek | Balázs: a W5500-modul mégsincs nála; a referenciától eltérő RX-lezárás (a VEZERLO-SPEC korábbi 4.2-je) kockázat lett volna; a W5500 opcionálisan beültethető, a C6 Thread/Wi-Fi-vel enélkül is működik | elfogadva (Balázs, 2026-10-20) | [VEZERLO-SPEC 4.2](VEZERLO-SPEC.md) |
| D73 | 2026-10-21 | **DIN-ház és NYÁK-körvonal:** a vezérlő, a LED- és a relémodul **86,5 × 68 mm** (a 4 modulos DIN 43880-as házak alsó NYÁK-helye); a **bemeneti modul 6 modul, 86,5 × 103 mm** (16 PH ≈ 128 mm + busz/I²C ≈ 35 mm élhossz – a 4 modulos ház két vállán ~136 mm van, ez nem elég). Ház a prototípushoz: **Gainta D4MG** (71 × 90,2 × 57,5 mm, ABS UL94 V-0, ~4,4 €, TME-n raktáron); ugyanez a NYÁK megy a **CamdenBoss CNMB/4**-be és az **OKW RAILTEC C 4 M**-be is (azonos NYÁK-táblázat). A felső szintek (57 × 67, 42 × 67 mm) opcionálisak | Balázs: olcsó és beszerezhető legyen, a 86 × 68-ra mindennek rá kell férnie; három gyártó azonos méretű házába illik → nincs beszerzési függés. A Phoenix BC 71,6 (81,5 × 67) és a Hammond 1597DIN4 (~82,8 × 65) más méretű, elvetve | elfogadva (Balázs, 2026-10-21) · a bemeneti modul 6 M-es része elvetve → D100 (4 M) | [beszélgetés 10-21] |
| D74 | 2026-10-21 | **Busz-GND és CAN-fojtó a modulokon (szakértői átnézés):** (1) a busz GND-sávja (XH 2-es tű) a modulmagon `GND_BUS` hierarchikus jel, amit a modul a saját lapján egy 1206-os ellenálláson át köt a GND-re: **LED-modul R293 = 1 Ω**, relémodul R113 = 0 Ω, bemeneti modul R390 = 0 Ω; a TCAN1044, az ESD2CAN24 és a D5 a modul GND-jén marad; (2) a TCAN1044 és a busz közé **L1 közös módusú fojtó (DNP) + JP2/JP3 zárt áthidaló**, mint a vezérlőn | A D71 óta (közös föld) a LED-modul 20 A-es visszatérő árama a busz GND-ján is folyhat: ~10 mΩ-os tápvezeték és ~100 mΩ-os busz-út mellett 0 Ω-mal 1–2 A, 1 Ω-mal ~0,2 A; a CAN ±12 V közös módust tűr. Izoláció nélkül a fojtó olcsó EMC-tartalék a 25 kHz-es PWM mellett | elfogadva (Balázs: „ami meg tudsz csinálni csináld”, 2026-10-21) | [MODULMAG-SPEC 5.1](MODULMAG-SPEC.md) |
| D75 | 2026-10-21 | **Védelmi kiegészítések:** (1) vezérlő: **D10 SMBJ6.0A a +5V_BUCK-on** – a buck átütésekor rövidre zár, az F1 kiolvad, a TPS2595 közben 5,7 V-ra vág; (2) vezérlő: **D11 SMF5.0A a VUSB-n** (USB-bedugási túllövés, az LM66200 VIN2 abs. max. 6 V); (3) bemeneti modul: **a felhúzás (R330–R345, 10 k) a csatlakozó oldalára, a soros ellenállás (R310–R325) 1 k → 10 k** | (1) az LM66200 (6 V) és a TPS2595 (20 V) abs. maximuma a 12–26 V alatt van – az eFuse csak enyhe túlfeszültség ellen véd; (3) egy osztó nélküli bemenetre kötött 24 V eddig ~20 mA-t hajtott volna az MCU védődiódájába (megengedett ±5 mA), most ~2 mA-t; a zárt érintkező továbbra is ~0 V | elfogadva (Balázs: „ami meg tudsz csinálni csináld”, 2026-10-21) | [VEZERLO-SPEC 2.3, 7.](VEZERLO-SPEC.md), [bemeneti-modul.py](../../hardware/gen/bemeneti-modul.py) |
| D76 | 2026-10-21 | **LED-modul:** (1) a blokk-biztosíték (F202–F204) értéke a bekötött szalaghoz igazodik: **≤ 100 W-os ághoz 4 A (24 V) / 8 A (12 V)**, legfeljebb 10 A – így a D30 (≤ 100 W/ág) és a D65 (10 A-es blokkok) összhangban van; (2) a gate-LED-ek ellenállása (R241–R246) **4,7 k → 10 k** | (1) a D30 és a D65 eddig ellentmondott (10 A × 24 V = 240 W/ág); (2) a 12 V-os sínt (MC78L12, 26 V-ról ~0,3 W) kevésbé terheli, ~1 mA-en is jól látható | elfogadva (Balázs: „ami meg tudsz csinálni csináld”, 2026-10-21) | [led-modul.py](../../hardware/gen/led-modul.py) |
| D77 | 2026-10-21 | **230 V, rádió, dokumentáció:** (1) relémodul NYÁK: a 230 V-os padok körül **8 mm-en belül a belső rétegeken nincs réz** (rule area, a legfelső 230 V-os pad 59,6 mm-nél → 51,6 mm-től); a csatornák között ≥ 4 mm (két fázisra kötés esetére), különben csak egyfázisú bekötés; (2) vezérlő NYÁK: az ESP-modul antennája alatt **minden rézrétegen tiltás** (rule area); (3) SCT-013-jack footprint: CUI SJ1-3513N (élkivágás nélkül); (4) LoRa: a firmware a TX-teljesítményt 14 dBm-re korlátozza (22 dBm csak 869,4–869,65 MHz-en); (5) HDC3020: a ház belsejét méri, a szobához a külső I²C-érzékelő (nem 0x44-en); (6) a busz bővítése áramtalanítva; (7) több lebegő SELV-táp megengedett, 0 V egy ponton; (8) BOOT0: a ROM-bootloader USART1-e a PA9/PA10-en (AN2606), a J1-ről csak SWD | Szakértői átnézés (2026-10-21); a régi CUI SJ1-3523N élkivágása nyitott körvonalat adott a DRC-ben | elfogadva (Balázs: „ami meg tudsz csinálni csináld”, 2026-10-21) | [pcbgen.py](../../hardware/gen/pcbgen.py), [MODULMAG-SPEC 5.5](MODULMAG-SPEC.md) |
| D78 | 2026-10-22 | **Modul-MCU: STM32L433RCT3 (75 db kézben) – mindhárom v1-modulra** (a D27 F303RET6-ja helyett; a patch-jegyzetben „D74” néven). Lábra kompatibilis (LQFP64, azonos táp- és földlábak; 48 = VDDUSB, 60 = PH3-BOOT0), ugyanaz a bxCAN a PA11/PA12-n. Átpinezés: VIN_SENSE PB11 → **PB1** (LED- és relémodul); a LED-modulon CH4–CH6 a TIM8 helyett TIM15/TIM16-ra, az I_SENSE a COMP2 új bemenetére (részletek: 2. kör). A relé- és a bemeneti lap az F303-mal is beültethető marad. **Ugyanebben a körben (Balázs, 10-22):** N-FET a GND-ágban a vezérlőn, a LED- és a relémodulon (fordított polaritás közös földdel; az LM74700 és a vezérlő D1-e kikerül); a W5500-nál **marad a 25 MHz-es kvarc** (Hestore); **TC2117-3.3** (SOT-223, 200 db kézben) az AP2112K helyett (modulmag U5, bemeneti modul U301); **MCP9701A** a LED-modul NTC-je helyett; **nincs** MCP121-es reset-IC a C6 EN-jén; a zöld táp-LED-ek (modulmag D3, vezérlő D5) a **+5V**-ról; **nincs** TSR 1-2433-tartalékhely; RFID-olvasó modul (MFRC522) a V2-ötletek közé | 75 db kézben (az F303-ból csak 8, otthon ~10 modul a cél); a modul-firmware még nincs megírva, így most a legolcsóbb váltani; L433-on a COMP2 a TIM1, TIM15 és TIM16 break-bemenetét is meghajtja (CubeMX-adatbázis), így a hardveres túláram-lekapcsolás mind a 6 csatornán megmarad; −40…125 °C. Ára: 1 ADC (13 csatorna elég), 256 KB flash, a LED-lap F303-mal nem megy | elfogadva (Balázs, grilling 1. kör, 2026-10-22); a részletek a 2. körben | [alkatreszkeszlet-2](beszelgetesek/2026-10-21-alkatreszkeszlet-2.md) |
| D79 | 2026-10-22 | **A D78 részletei (grilling 2. kör, Balázs):** (1) a LED-modul lábkiosztása L433-ra: CH4/CH5 = **TIM15 CH1/CH2 (PB14/PB15)**, CH6 = **TIM16 CH1 (PB8)**, I_SENSE a **PA3**-on (COMP2+ és ADC1_IN8), DS4 a PA7-en, VIN_SENSE a **PB1**-en (relémodulon is); a COMP2 kimenete a TIM1, TIM15 és TIM16 break-bemenetére, a DRV_EN marad második rétegnek; (2) **NUCLEO-L433RC-P** a Mouser-rendelésbe (firmware a NYÁK-ok előtt); (3) a modulokon a kézben lévő **SN65HVD230** a TCAN1044AV helyett (3,3 V; buszlábak −4…16 V – Balázs vállalja: „ha sikerül kiégetni egy sort 24 V-tal, nem gáz”, más csatlakozó); a vezérlőn marad a TCAN1044AV (JP2/JP3-mal HVD230 is mehet); (4) **2 oz-os külső réz a LED- és a relémodulon**; a LED-modul is a Gainta-házba kerül (Balázs: nem fog 20 A menni rajta), a 24 V-os betáp a felső vállon marad (D50); (5) sorkapocs: **csavaros (Phoenix MKDS 3, 5,08 mm) a LED-modul 20 A-es útján**, push-in a relé 230 V-os kimenetein és a kis áramú betápokon; (6) a buck marad **5,22 V** (Balázs: 1 A-es terhelés mellett egy laptop sem ad 5,25 V-ot, így a buck nyer) | A D78 után minden L433-specifikus láb rögzítése, a layout előtt; a kézben lévő alkatrészek előnyben | elfogadva (Balázs, grilling 2. kör, 2026-10-22) · a 2 oz → D82 (1 oz + fedetlen sávok) · a relékimenet sorkapcsa → D83 (5,08 mm-es THT a készletből) | [led-modul.py](../../hardware/gen/led-modul.py), [cubemx.py](../../hardware/gen/cubemx.py) |
| D80 | 2026-10-22 | **A modulok 3,3 V-os LDO-ja marad az AP2112K-3.3** (modulmag U5, bemeneti modul U301); a kézben lévő TC2117-3.3 nem kerül a NYÁK-ra | A TC2117 adatlapja (DS21665D, 4.1) 0,2–10 Ω ESR-ű kimeneti kondenzátort ír elő (tantál / elektrolit) – csupa kerámiával az adatlapon kívül esne, és a modulmag 3,3 V-ján sok a kerámia; tantált is venni kellene, így a TC2117 nem spórol beszerzést. Az AP2112K kerámiával stabil, a footprint kész | elfogadva (Balázs, 2026-10-22: „legyen az a LDO”) | [MODULMAG-SPEC](MODULMAG-SPEC.md) 2. fejezet |
| D81 | 2026-10-22 | **Javaslat (Balázs dönt): a bemeneti modul U303–U306 ESD-tömbje TPD4E05U06 → TPD4E02B04** (lábra azonos USON-10 / DQA: 1, 2, 4, 5 IO; 3, 8 GND; 6, 7, 9, 10 NC – TI SLVSD85B); az U307 (külső I²C) marad TPD4E05U06. A D75 állítása („24 V-os félrekötésnél ~2 mA az MCU védődiódájába, nem teszi tönkre”) pontatlan volt: az L433 (és az F303) 5 V-tűrő lábán nincs dióda a VDD felé – a ~2 mA az MCU-oldali ESD-tömbbe folyik, és a láb a tömb letörési feszültségére áll be | A TPD4E05U06 letörése 6,4 V min., 8,7 V tip. (1 mA) – a láb abszolút határa VDD + 4 V ≈ 7,3 V, így 12/24 V-os félrekötésnél ez túlléphető. A TPD4E02B04: VRWM ±3,6 V, letörés 5,5–7,5 V (tip. 6,4 V), utána 5,8 V-on tart (snapback) → a láb tipikusan 6 V körül marad. Ára: a 3,6 V-os standoff miatt osztó nélküli 5 V-os jelnél már szivárghat (a D66 szerint 5 V-hoz amúgy is osztó kell); be kell szerezni (~4 db). Az U307 a külső I²C-n 5 V-os felhúzást is kaphat, ott a 3,6 V-os tömb rossz lenne | **elvetve** (Balázs, 2026-10-22): marad a TPD4E05U06 – 12/24 V-os jelhez az osztó beültetése kötelező (D66) | [TPD4E02B04 adatlap](https://www.ti.com/lit/ds/symlink/tpd4e02b04.pdf) |
| D82 | 2026-10-22 | **1 oz-os réz minden NYÁK-on (a D79 2 oz-a helyett); a nagyáramú vezetősávok fedetlenek** (forrasztásgátló lakk nélkül), és beültetés után ónnal vagy csupasz rézvezetékkel megvastagítva: LED-modul – a +24 V-os út (J201 → F201 → sín → F202–F204 → J202–J204), a csatornák drain-sávjai a sorkapcsokig, a visszatérő út (FET-source-ok → PGND_SH → sönt → GND → Q201 → J201); relémodul – a COM/NO sávok a relétől a J101–J104-ig. **A söntöt (R209) és a Kelvin-pontjait nem szabad ónnal áthidalni** | A JLC 2 oz-nál ≥ 8 mil (0,2 mm) szélességet és távolságot kér – az LQFP-64 padjai közti rés épp 0,2 mm; 1 oz-zal ez a gond megszűnik, és kb. 25–50 e Ft-tal olcsóbb. Balázs: a LED-modulon úgysem fog 20 A menni; ha kell, ónnal / vezetékkel erősíti | elfogadva (Balázs, 2026-10-22) | [NYAK-ELOKESZITES](NYAK-ELOKESZITES.md) |
| D83 | 2026-10-22 | **A relémodul 230 V-os kimenetein (J101–J104) 5,08 mm-es THT sorkapocs a kézben lévő készletből** (a D79 push-in-je helyett); a footprint marad (2 pólus, 5,08 mm) | Balázsnak van belőle egy csomag, így nem kell venni, és a footprint sem változik. Beültetés előtt: a névleges érték ≥ 16 A / ≥ 250 V legyen (az olcsó kék 5,08-asok jellemzően 16 A / 300 V – épp elég); a LED-modul 20 A-es betápjára (J201) ez kevés lehet, oda 24 A-es (MKDS 3) kell; a magasság a Gainta-ház vállához | elfogadva (Balázs, 2026-10-22) | [rele-modul.py](../../hardware/gen/rele-modul.py) |
| D84 | 2026-10-22 | **Beszerzés a legolcsóbb úton: Hestore + DigiKey**, és ahol a Hestore-ban van megfelelő, oda igazítjuk a rajzot (a layout még nem indult el – Balázs: „legyen a lehető legolcsóbb”): vezérlő **J1** és relé **J100** → Degson **DG250-3.5-02P** (rugós, 8 A); LED-modul **J201** → Degson **DG128-5.0-02P** (15 A UL / 18 A IEC), **J202–J204** → **KF128-5.0-3P** (10 A; a blokkbiztosíték ≤ 10 A), mindkettő 5,00 mm-es MKDS-1,5 footprinten; **F201 20 A → 15 A** (a J201 névleges árama – a LED-modul össz-árama így 15 A); **L1/L3** → FerroCore **HPI0630-6R8 / -8R2** (saját footprint `modularis:L_FerroCore_HPI0630`; a 8R2 DCR-je 59,5 mΩ – 2 A-en ~0,24 W); **R209** → Bourns CRE2512 (2 kivezetésű, a Kelvin-padokon összeforrasztva); **C40/C41 18 → 12 pF** (Kyocera CX3225 kvarc, CL = 10 pF, ESR ≤ 30 Ω); SW1/SW2 → PTS525S5215A (a TL3342-footprinten jó); típuscserék a rajzon is: D3 SS56C, D9 BAT54HT1G, D211–D216 STPS3L60U, FB1 BLM18EG221 (vezérlő + modulmag), C4 10 µF / 50 V, C9 22 pF, U4 **ESP32-C6-WROOM-1-N8**. A DigiKey-re marad: LMR33630, TPS2595, NUCLEO-L433RC-P, NTD5C648NL, NTMFS5C604NL, MC78L12ACD, SMBJ28A / 6.0A, NANO², 1206-os biztosítékok, Keystone 3568 + 15 A-es mini betét, néhány kondenzátor és az E96-os ellenállások | A Hestore-ban a Phoenix MKDS/PT, a Coilcraft/Bourns tekercs, a WSK2512 és a TL3342 nincs; a DigiKey-nél 15 000 Ft felett ingyenes a szállítás (a Mousernél csak 75 € felett), és a maradék ennél többet ér. A típusok a Hestore-adatlapok alapján ellenőrizve (padkép, lábköz, névleges áram); a firmware 4 MB-os flashre van állítva, így az N8 elég. Ellenőrzés: `gen/ellenorzes.py` 0 hiba; bekötés változatlan (netlista 0 / 0). Lista: `hardware/bom/beszerzes.csv` |
| D85 | 2026-10-23 | **Beszerzés: LCSC (a JLC-s NYÁK-rendeléshez csapva) – a D84 Hestore + DigiKey felállása helyett; Hestore-rendelés nincs.** Balázs: „keresd meg a legolcsóbb megoldást, mindegy hogyan”; a házak (Gainta D4MG/D6MG) később, ST-Link és Nucleo kézben (a NUCLEO-L433RC-P nem kell – D79 módosul). A rajzon: **Q202–Q207 NTD5C648NL → NCE6080K** (60 V, 8,5 mΩ, DPAK; az NTD megszűnt), **Q201 NTMFS5C604NL → NCEP6090AGU** (60 V, 2,8 mΩ, power-SO8 az SO-8FL padképén; az NTMFS nem kapható), **F201 → NANO² 15 A** (0451015.MRL, beforrasztva; a Keystone 3568 nem kapható), **D211–D216 → SS56B**, **J1 és J100 → Degson DG128-5.0-02P** (mint a J201), L1/L3 → LCSC-s 0630-as tekercs (SLO0630H6R8MTT / APS0630M8R2A, ugyanaz a footprint), Y1 (vezérlő) → SX3B25.000F1010F30 (CL 10 pF, ESR ≤ 30 Ω), Y1 (modulmag) → 3TJ480000JWLAC (CL 10 pF, ESR ≤ 120 Ω) | A DigiKey-rész ~100 USD + ÁFA lett volna (az NTD5C648NL 10 db 37 USD; a 15 000 Ft-os ingyenes küszöb téves volt, valójában 90 USD), a Hestore-kosár 42,9 eFt. Az LCSC-n ugyanez ~15,2 eFt ÁFA-val (~33 USD, 1 USD = 360 Ft-tal), és a JLC-s csomaggal jön. A 8 MHz-es kvarcnál nem a legolcsóbb (300 Ω): azzal az L4 HSE erősítési tartaléka ~3 lenne (ST AN2867: ≥ 5), a választottal ~7. Ellenőrzés: `gen/ellenorzes.py` 0 hiba, bekötés változatlan (netlista 0 / 0). Lista: `hardware/bom/beszerzes.csv`, kosár: `hardware/bom/lcsc-kosar.csv` |
| D86 | 2026-10-23 | **Layout-előkészítés:** (1) **gyártói szabályok laponként `.kicad_dru`-ban** (JLC, 4 réteg, 1 oz: sáv / rés ≥ 0,127 mm, lapszél 0,3 mm, szitanyomat ≥ 0,8 / 0,15 mm), név szerinti feltételekkel (a nyitott KiCad nem írja felül); **via: jel 0,3 / 0,45 mm** (a JLC felár nélküli legkisebbje), **táp 0,4 / 0,7 mm** (1 A felett több), **nagyáram (LED-modul 15 A) 0,6 / 1,0 mm viamezőben**, 230 V-on nincs via; táp- és nagyáramú sávszélességek; 230 V ↔ SELV ≥ 8 mm, 230 V ↔ 230 V ≥ 3 mm (az NC-láb is 230 V-os); Ethernet 0,2 / 0,15 mm, USB 0,25 mm (a USB_DP/DM-et a KiCad nem ismeri fel párnak). (2) **Modulmag-blokk** (`pcbgen.py` `MODULMAG_BLOKK`, ~34 × 42 mm): mindhárom modulon azonos relatív elrendezés – felül a busz (J2, J3, JP1), alatta védelem és CAN (U2 a lábaival a PA11/PA12 felé), balra a táp, középen az STM32 a hidegítőkkel, kvarccal, VDDA-szűrővel, jobbra az SWD; LED- és relémodulon a jobb felső részen, a bemeneti modulon a bal felsőn – a jelölések azonosak, a kész layout átvihető. (3) **Gainta D4MG** (`docs/d4mg.pdf`): a belső tér 86,7 × 68 mm (a NYÁK 86,5 × 68 ✓); a vállfedél (GUARD) 12 csavarfurata 5,08 mm-es osztású, a ház közepére szimmetrikus (68 mm-es lapon x = 6,06 … 61,94 mm) – a sorkapcsok csavarjai ide esnek (a lábak ≤ 0,08 mm-re: J1, J100, J201–J204, J101–J104; a relék a sorkapcsuk fölött); (4) a mechanikailag kötött helyű alkatrészek (betáp- és kimeneti sorkapcsok, busz, relék, ESP32, USB-C, RJ45, PH-k) **zárolva** (`lock`); (5) **elrendezés** (`pcbgen.py`): a modulmag-blokkba más alkatrész nem kerül, minden nem zárolt alkatrész 0,25 mm-es rácson; LED-modul: a 12 csatorna-LED egy sorban a saját FET-je fölött, alatta az ellenállásaik, a meghajtók két-két FET között, a táphálózatos kondenzátorok / TVS a saját alkatrészüknél; relé: a 24 V-os elemek a betápnál, a relé-LED-ek egy sorban; bemeneti modul: bemenetenként egy oszlop (felhúzó, soros 10 k, 10 nF, osztóhely) a csatlakozó mellett, az ESD-tömbök a blokk szélén; (6) **lábhoz rendelés** (`pin_attach`): hidegítő a tápjához, gate-ellenállás / -lehúzás a FET gate-jéhez, kvarc-kondenzátor a kvarchoz – szakértői mérés (kritikus párok pad-távolsága): a három modulon rendben (a relé 3 kisáramú eleme 0,3–2 mm-rel a küszöb felett); **a vezérlő még nincs elrendezve** (az U4 helye Balázs döntése, utána a buckok környéke) | Balázs: „kezdd a szabályokkal és a ház méreteivel”, „a modulmag egy négyzetbe?”, „via a JLC alapján a lehető legkisebb, amiért nem kell fizetni; ahol nagyobb áram megy, ott nagyobb”. Forrás a viára: JLC felár nélküli fúrt via 0,3 / 0,45 mm (JITX JLC-könyvtár, JLC-fórum). Ellenőrzés: `ellenorzes.py` 0 hiba; a blokk ütközésmentes mindhárom lapon |
| D87 | 2026-10-23 | **A vezérlő elrendezése és a LED-modul huzalozásának indulása:** (1) **U4 (ESP32-C6) a jobb élen**, az antenna kifelé (az oldalfal felé), az előlapi ablak magasságában (y 24,9–44,8 mm) – a J1/J2/J3 sorkapcsoktól, az RJ45-től és az USB-C-től ≥ 15 mm-re; antenna-tiltás minden rézrétegen x ≥ 60,7 mm, y 20,9–48,8 mm (±4 mm a modul két oldalán), ide alkatrész sem kerül; (2) **a két buck a TI-adatlapok layout-ajánlása szerint, rögzített relatív elrendezéssel** (`pcbgen.py` `VEZ_U1`, `VEZ_U2`): LMR36015 – C5/C6 a két VIN–PGND lábpáron, a SW lefelé az L1-re (~2 mm), a kimeneti 3 × 22 µF az L1 alatt, közvetlenül az U4 3V3-lába fölött (a C27 100 nF / C26 22 µF ~1,5 mm-re a lábtól), az FB-osztó (R4) az FB-lábnál, távol a SW-től; LMR33630 – C53 a VIN–PGND lábakon, C2 mögötte, C55 a BOOT–SW-n, C54 a VCC-n, az L3 a SW fölött, a 4 × 22 µF tőle balra, a GND-padjuk a C53 GND-je mellett; (3) bal felül a betáp (F1, Q1 a GND-ágban, TVS-ek, R7 + C1), a csatlakozók alatt az U12/U3 (V_BUS) és a CAN (U7 a J2–J3 között, L2, U6 a TXD/RXD-vel lefelé); lent balra a LoRa (DNP) az u.FL-lel, a W5500 az RJ45 fölött (MDI lefelé, SPI felfelé, kvarc a XI/XO-nál); jobbra lent a kezelőszervek (SW1, SW2, D5, D6) és az U9; (4) **lábhoz rendelés javítva:** a felhúzó a jel-, nem a táplábhoz kerül, és több azonos tápú lábnál (W5500 VDD-k) sorban mindegyikhez jut egy hidegítő; (5) **a LED-modul NYÁK-ját Balázs huzalozza** (10-23) – onnantól a `.kicad_pcb` a forrás (D67), a `pcbgen` nem írja felül; (6) a LED-FET-ek egy sorban maradnak (11–12 mm-es osztás): a melegedést a FET-enkénti réz dönti el – drain-kitöltés felül és alul, 6–8 via a fül mellett (nem a padben) | Balázs: „mehet a jobb él … de akkor a kondenzátorok nem lesznek messze a lábaktól?”, „minden komponens egyoldalon legyen?” (igen, D42), „az nem baj, hogy egyhelyen van az összes mosfet?”. A hidegítők az IC-jükhöz kerülnek, nem az U4-hez; a 3,3 V a buck kimenetéről rövid úton jut a modulhoz. Becslés (NCE6080K, ~12 mΩ melegen): 3,3 A/csatorna ~0,15 W (+7 °C), 10 A ~1,3 W (+55–65 °C 2–3 cm² rézzel). Ellenőrzés: szakértői mérés – a vezérlő 47 kritikus párja rendben; DRC: csak huzalozatlan + szitanyomat; `ellenorzes.py` 0 hiba |
| D88 | 2026-10-23 | **Nincs via-in-pad, legkisebb furat 0,3 mm:** (1) a JLC-nél a kitöltött-lefedett via-in-pad (POFV) 4 rétegen felárat kérnek érte (6 rétegtől ingyenes) → nem használjuk: a kis padeknél (0603, SOT, SOIC, a FET-fülek) a via a pad mellé kerül rövid sávval; a nagy hűtőpadekbe (U2 PowerPAD, ESP32 GND-pad, U1) mehet több 0,3 mm-es nyitott via; (2) **U3 (TPS2595) a via nélküli WSON-8 footprinten** (`Texas_DSG0008A_WSON-8-1EP_2x2mm_P0.5mm_EP0.9x1.6mm`) – a `_ThermalVias` változat két 0,2 mm-es furata miatt az egész lap a kisfurat-felárba esett volna; 2 A-en ~0,15 W, a GND-láb és a kitöltés elég (szükség esetén egy 0,3 mm-es via a pad mellé); (3) a NYÁK legkisebb furata 0,3 mm (`pcbgen.py`, a `.kicad_dru` már eddig is ezt kérte) | Balázs: „jlc-nél extrába kerül az in pad via?” → „igen” (a footprint-csere). Forrás: JLC-blog „Free Via in Pad on 6-20 Layer PCBs with POFV” („POFV for 4-layer PCBs still requires charges”). Ellenőrzés: a bekötés változatlan (netlista 117/117), ERC 0, `ellenorzes.py` 0 hiba, a vezérlő legkisebb furata 0,3 mm |
| D89 | 2026-10-26 | **A HW_REV-osztó a modul saját lapjára (mint a HW-ID):** (1) a modulmag-lapról kikerült az R10/R11/C20, a PB0 `HW_REV` hierarchikus jel lett, a lapszimbólumon új láb; a modul saját lapján 10 k / 715 Ω / 100 nF (v1 = 1. sáv) – LED: R295/R296/C295, relé: R115/R116/C107, bemeneti: R303/R304/C308; (2) a NYÁK-on is a blokkon kívül (a hálózat neve `/HW_REV`): a LED-lapon a HW-ID-oszlop mellett (x ≈ 130 mm), a régi helyükhöz vezető sávok törölve (8 × HW_REV, 4 × +3V3 a C7-től); relé / bemeneti: `pcbgen.py` `pin_attach` az U6 PB0-lábához (26), a blokk-sablonból kivéve; (3) `pcbgen.py` a rajz DNP-jelzőjét, BOM-kizárását és mezőit (pl. Megjegyzés) is átviszi – a relé- és a bemeneti NYÁK újragenerálva, NYÁK ↔ rajz 0 eltérés (előtte 54 / 124: DNP, mezők) | Balázs: „a led modulon a hw rev ellenallasok meg mindig a modulmagon belul vannak”, „generáld újra a relét és a bemenetit”;  Balázs: „a hwid ne kerüljön be a modulmagba? vagy akkor a rev id is kerüljön ki?” → „csináld, vedd ki a rev id-t is”. Indok: a modulmag közös lap, az értékei mindhárom modulban azonosak; a revízió az adott NYÁK tulajdonsága – ha csak egy modulból lesz v2, csak az ő ellenállása változik. Ellenőrzés: netlista 119/119, 100/100, 120/120 (csak a szándékolt eltérés), ERC 0 (relé: a 4 ismert lib-jelzés), NYÁK ↔ rajz: a HW_REV-re 0 eltérés, `ellenorzes.py` 1–5. lépés hibátlan |
| D90 | 2026-10-27 | **A konzulens (Pali) visszajelzése alapján:** (1) **NRST: 10 k felhúzás a +3V3-ra** a modulmagon (mindhárom modul); (2) **a ferritgyöngyök törölve** (modulmag FB1 a VDDA előtt, vezérlő FB1 a W5500 AVDD-je előtt) – a +3V3A a +3V3 része lesz; (3) vezérlő: **D7 törölve** (a második SMBJ28A a +24V_F-en – az R7 = 0 Ω miatt a D2-vel egy csomóponton); (4) vezérlő: **R31 törölve** (33 Ω a WS2812 DIN előtt) – vezeték; (5) relémodul: **D100 törölve** (soros SS16 a tekercs-tápban – a GND-ági FET, D78, már véd) – vezeték; (6) **tápszimbólum minden tápsínen** a hálózati címke helyett (a hálózatnév a „/” előtag nélkül; a LED-NYÁK és a `.kicad_dru` átnevezve); (7) **olvashatóság:** a D-hivatkozások kikerülnek a rajzokról és a konzulensnek szánt anyagokból, a mérőpontok a hálózatukra, vezeték címke helyett ahol rövid (C19/C61, VIN_BUCK, USB-C a D3/D8 mellett), a gombok az ESP32 mellé, a polaritásvédő FET-ek a GND-visszatérő úton rajzolva, az STM32-lábaknál a címke vezetékcsonk végén, a LED-modul PGND_SH-ja csatornánként vezetékkel | Konzulensi átnézés (2026-10-26, a kapcsolási rajzok PDF-je + komponenslista). Balázs: „a 0 ohmok helyett csak legyen törölve”; a ferritekről: „elhagyhatjuk szerintem, legyenek törölve”. A ferritgyöngy a kerámiákkal csillapítatlan LC-kör (rezonanciáján erősít, DC-áramnál az induktivitása is csökken); az NRST belső felhúzása (~40 k) gyenge. A többi kérdés (5,2 V, C1/D57, polaritásvédelem leírása, LED-modul földelése, Schottky, I_SENSE-szűrő, ULN2803A, bemeneti modul méretezése) a megbeszélésre | elfogadva (Balázs, 2026-10-27), folyamatban | konzulensi e-mail (Discord), 2026-10-26 |
| D91 | 2026-10-27 | **Táp-sávok minimuma 0,2 mm a DRC-szabályban, a fő áramutakat külön ellenőrizzük:** mind a négy lap `.kicad_dru`-jában a táp- és nagyáramú szabályok `min`-je 0,2 mm (az `opt` marad – a huzalozó azt használja); kivétel a relémodul 230 V-os érintkező-útja (2 mm, ott nincs mellékág). A fő utak legszűkebb pontját a `gen/aramut.py` nézi (a keskenyebb sávokat elhagyva egyben marad-e az út): nagyáramú út ≥ 1,5 mm (hiba), javasolt ≥ 2,5 mm; busz +5V / GND_BUS ≥ 0,5 mm; relé-érintkező ≥ 2 mm – az `ellenorzes.py` 6. lépése futtatja | A szabály az egész hálózatra vonatkozott, így a mérő- és LED-ágak (0,2 mm) 180 álhibát adtak a LED-lapon, a vezérlőn a kis lábaknál is zavart volna; a valódi kérdés az, hogy a fő út elég széles-e. Balázs: „igen, csináld meg a szabályokat” (0,25 mm-t javasoltam, a LED-lap meglévő 0,2 mm-es ágai miatt 0,2 lett). A LED-lapon az egyetlen figyelmeztetés: FET-ek → sönt 2,4 mm (a Q203-nál 1,65 mm) | elfogadva (Balázs, 2026-10-27) | – |
| D92 | 2026-10-28 | **LED-vezérlés: prémium minőség kis fényerőn is (firmware-követelmény):** 16 bites belső fényerő-skála érzeti (CIE-L*/gamma) görbével; a 25 kHz-es PWM 3200 lépése között kitöltés-dithering (szigma-delta), hogy a legalsó tartományban se legyen látható lépcső; a legalsó tartományra kalibrációs görbe (a kábel ~1,5 µs-os időállandója miatt a rövid impulzusok nem futnak fel); sima átmenetek (Matter TransitionTime); minden csatorna azonos frekvencián (közös órajel), a fázistolás fix, a frekvencia-dithering csak minden időzítőn egyszerre; bekapcsoláskor villanás nélkül | Balázs: „szeretném, ha kis fényerőn is szépen működne, profi megoldásként … tényleg prémium érzetű vezérlés”; eltérő frekvenciáknál lebegés (látható lüktetés) lenne | elfogadva (cél); a hardvert nem érinti | [valaszok](../konzultacio/2026-10-27-valaszok.md) |
| D93 | 2026-11-01 | **A konzultáció (10-28) után:** (1) **vezérlő: az R7 és a `+24V_F` törölve** – a buck bemenete a `+24V_P`-n, a csillapítást a C1 elkó ESR-je adja (a megjegyzés pontosítva: ESR ~0,2–1 Ω, nem polimer; a `+24V_F` PWR_FLAG-je is törölve); (2) **LED-modul: R207 100 Ω → 1 kΩ** (az INA181 kimenetén); (3) a bemeneti modulon **marad a TPD4E05U06** | (1) Balázs: „nem kell a külön 24V F és P” – a 10 Ω-os opció a központi 5 V óta úgysem használható; (2) az INA181 közvetlenül legfeljebb 1 nF-ot bír (adatlap), a nagyobb soros ellenállás jobban leválaszt, és a sávszélességet az erősítőéhez igazítja (~160 kHz); (3) a funkcióra kell (ESD-lefogás a hosszú érzékelőkábeleken), olcsó és kézben van – a GHz-es tulajdonsága itt nem számít, de nem is árt | elfogadva (Balázs, 2026-11-01) | [valaszok](../konzultacio/2026-10-27-valaszok.md) |
| D94 | 2026-11-01 | **A LED-modul leválasztása a busztól – a busz bemeneténél („A” változat):** (1) a modulmag CAN-transceivere **CA-IS3052G** (Chipanalog, izolált, 5 kVrms, ±58 V, 1 Mbit/s, SOIC8-WB; lábkompatibilis a TI ISO1042BDWVR-rel) mindhárom modulon, az SN65HVD230 és az R12 helyett; (2) a busz-oldal (J2/J3, ESD2CAN24, D5, lezárás, fojtó, a transceiver VCC2/GND2-je + C20/C21) a **`V_BUS` / `GND_BUS`**-on, a modul-oldal (+5V, GND) a modul lapján kapcsolódik: **relé R100 + R113, bemeneti R300 + R390 0 Ω** (nincs leválasztva), **LED-modul U208 B0505S-1WR3** (1 W-os izolált DC-DC, SIP-4) + C216/C217, **C218** EMC-kondenzátor helye (DNP), az **R293 kikerült**; (3) LED-NYÁK: a busz-oldal és a modul-oldal között ≥ 0,8 mm minden rétegen (DRC-szabály), a GND_BUS-nak külön zóna; (4) a modulmag-blokk új elrendezése a `pcbgen.py`-ban (az U2 fekve, bal oldalt a modul-, jobb oldalt a busz-oldal) – a relé- és a bemeneti NYÁK újragenerálva | A konzultáción (10-28) Pali: a GND_IN szakadásakor a szalag árama ne mehessen a buszon (a hibaút: R293 → D5 → V_BUS, a V_BUS ~7 V-ra is felment volna). Két helyet javasolt: a busz bemenetén vagy a MOSFET-ek előtt; a MOSFET-eknél ~18 jel lépne át (6 PWM, hibajel, ~10 analóg mérés, a COMP2-es túláramvédelem is), a busznál csak a CAN és a táp – ott a legolcsóbb és a LED-modul áramköre változatlan marad. A TI ISO1042BDWVR az LCSC-n kis tételben ~6000 Ft/db, a CA-IS3052G ~540 Ft/db; a DC-DC ~315 Ft. A B_S-1WR3 család (B1205S, B2405S) ugyanerre a footprintre – nagyobb buszfeszültséghez a V_BUS TVS-ét és a transceiver VCC2-jét is át kellene tervezni (V2) | elfogadva (Balázs: „mehet az A”, 2026-11-01) | [MODULMAG-SPEC 4–5.](MODULMAG-SPEC.md), [valaszok](../konzultacio/2026-10-27-valaszok.md) |
| D95 | 2026-11-01 | **A relé- és a bemeneti modulon is az izolált DC-DC helye (DNP):** U100 + C100/C108/C109 (relé), U300 + C300/C309/C326 (bemeneti) – ugyanaz a B0505S-1WR3 blokk, mint a LED-modulon, a 0 Ω-os átkötők (R100+R113, R300+R390) mellett, „vagy-vagy” (a kettő együtt ne legyen); a leválasztási DRC-szabály (≥ 0,8 mm) ezeken a lapokon is | Balázs: „a footprint mindenképp legyen ott, legfeljebb átkötöm”. Alapból nincs leválasztva, mert: a relén csak ~70 mA-es tekercsáram folyik, a GND_IN szakadásakor sem okoz gondot; a bemeneti modul érzékelői (≤ ~1 A) az 1 W-os DC-DC-ből nem kapnának elég áramot (leválasztva ~100 mA marad nekik). A relé-NYÁK középső sávja tele van: a generátor a DC-DC-t a C105 helyére tette, a C105 (és a korábban is kimaradt J4) kézzel helyezendő | elfogadva (Balázs, 2026-11-01) | [MODULMAG-SPEC 5.1](MODULMAG-SPEC.md) |
| D96 | 2026-11-02 | **A konzultáció (10-28) után nyitott három kérdés lezárva:** (1) **vezérlő: az U2 (LMR33630, 36 V) marad**, nincs 60 V-os buck; (2) **relé: D107 BZT52C15** a ULN2803A COM-lába (10) és a `+24V_P` közé (katód a COM-on) + **R117 0 Ω (0603, DNP)** áthidalás – NYÁK: a D107/R117 a COM mellé, a C104 a D105 (+24V_P TVS) mellé, az R9 a D4 mellé, a többi elhelyezés változatlan; (3) **bemeneti: nincs új alkatrész**, a rajzon és a komponenslistában leírva: osztó nélkül csak ≤ 5 V-os jel; 12/24 V-os aktív érzékelőhöz az osztót beültetni, a felhúzást (R_fel) kihagyni | (1) a ≤ 26 V-os bekötési szabály (D57) + a C1 ESR-je elég, a csere a huzalozás előtt újratervezést kérne; (2) a puszta diódás kioltás lassítja az elengedést → 230 V-on, induktív terhelésnél nagyobb ív; a Zenerrel a kimenet ~24 + 15 V-on fog (26 V-nál ~42 V, az ULN2803A 50 V-os határa alatt); a BZT52C15 már a BOM-ban van; (3) a visszatáplálás (félrekötött 24 V-nál bemenetenként ~2 mA a +3V3-ra) csak hibás bekötésnél lép fel | elfogadva (Balázs: „1 marad, 2 mehet, 3 elég leírni”, 2026-11-02) | [valaszok](../konzultacio/2026-10-27-valaszok.md) |
| D97 | 2026-11-02 | **Új NYÁK-rendelési dátum: 2026-11-05** (a D25-ös 10-31 helyett) – vezérlő + LED- + relé- + bemeneti modul, stencillel, az LCSC-s alkatrészekkel együtt (D85) | A konzultáció (10-28) utáni módosítások (D93–D96) a huzalozás előtt kellettek | elfogadva (Balázs, 2026-11-02) | [UTEMTERV](UTEMTERV.md) |
| D98 | 2026-11-02 | **LED-modul: az U208 (B0505S-1WR3, ~10 mm magas) a J3 alatt marad** (y ≈ 9–21 mm, Balázs elrendezése) – átnyúlik a Gainta D4MG ~13 mm-es belső bordáján (ott ~2–2,5 mm a szabad magasság), ezért **a bordát helyben ~7 mm szélesen ki kell vágni** (x ≈ 54–61 mm); a J3 fölött a fésűfogakat amúgy is le kell vágni. A busz-sarok: a kondenzátorok szerep szerint (C20/C21 az U2 VCC2/GND2-je fölött, C18/C19 a VCC1/GND1 alatt, C216 az U208 bemenete mellett, C217 a kimenete mellett), a JP2/JP3 állva az U2 fölött; **az In1-en GND_BUS-zóna a busz-sarokban** (a modul GND-síkja nincs a busz-oldal alatt – D94), a 0,8 mm-es rést a DRC-szabály adja | A borda alatti hely (y ≥ 15) csak a jobb felső rész teljes átrendezésével (J1, U2, C6) lenne meg, három nappal a rendelés előtt; a vezérlő RJ45-jénél (J6) is kell bordakivágás. A ház méreteit (±1 mm) a rendelés előtt egy valódi házon le kell mérni | elfogadva (Balázs, 2026-11-02) | [NYAK-ELOKESZITES](NYAK-ELOKESZITES.md) |
| D99 | 2026-11-03 | **LED-modul: 15 A össz / 10 A csatornánként – az áram- és hőátnézés után:** (1) **F201 20 A** (Littelfuse 0451020.MRL, NANO² 2410, ugyanaz a footprint) a 15 A helyett – a biztosíték tartósan legfeljebb a névleges 75 %-ával terhelhető; a blokkbiztosítékoknál (F202–F204) a szalag árama ≤ a biztosíték 75 %-a, 10 A-es csatornához 15 A (0451015.MRL); (2) **a csatorna-FET-ek (Q202–Q207) drain-hűtése:** CHx_D-zóna az In2-n és a B.Cu-n a FET alatt + 9–19 termikus via (0,3/0,6 mm, alul lefedve) a fülben → a drain-réz ~0,9 cm²-ről ~2,5–3 cm²-re; (3) **réz drót (~1 mm²) forrasztva** a 15 A-es és a 10 A-es utakra (+24V_IN, +24V_RAIL, +24V_B1–B3, CHx_D, PGND_SH, a felső GND-sáv a söntől a Q201-ig, GND_IN) – 1 oz-on a 2,4–3 mm-es sávok ónozva sem elegendők; (4) **C203 low-ESR** (ERG50V470M10X20, 1,56 A @ 100 kHz, 43 mΩ – nem polimer, az ESR csillapítja a bemeneti LC-kört) a 705 mA-es általános elkó helyett, és **firmware: a TIM1 csatornái fázisban eltolva** (azonos fázisban 3 × 5 A, 50 % → ~7,5 A RMS a pufferen); (5) a GND-visszatérés (sönt → Q201) a felső GND-sávon marad, a dróttal ez viszi az áram nagyobb részét, a maradék az In1-en | Átnézés (11-03): 10 A-en egy FET ~1,3–1,5 W (vezetés forrón + kapcsolás, Qg = 90 nC) – 0,9 cm²-en ~120 °C-os melegedés; a 15 A-es biztosíték tartósan ~11 A-t engedne; 1 oz-on 2,4 mm-en 15 A ~150 °C (IPC-2221). Balázs: „nagyobb biztosíték”, „kapjanak rézkitöltést és viákat”, „forrasztok rá rezet”, „van egy vastag GND-sáv a top layeren”, „15/10” | elfogadva (Balázs, 2026-11-03) | [NYAK-ELOKESZITES](NYAK-ELOKESZITES.md) |
| D100 | 2026-11-03 | **Bemeneti modul: 7 bemenet (IN0–IN6 = PA0–PA6, mind ADC-képes) a 16 helyett, 2 érzékelő-tápcsoport (IN0–IN3, IN4–IN6; csoportonként 3,3/5 V-os jumper + PTC), a HDC3020 és a külső I²C-csatlakozó marad; a NYÁK 4 M-es, 86,5 × 68 mm (Gainta D4MG, mint a többi lap)** – a rajzról kikerült a J308–J316 és a csatornáik (R317–R325, R337–R345, R357–R365, C317–C325), az U305/U306 (ESD), a JP303/JP304, az F303/F304, a C306/C307; a modulmag PA7–PA10 és PB11–PB15 lába szabad (no-connect); a NYÁK kezdő elhelyezése újragenerálva (alul a 7 PH egy sorban) | Balázs: „a bemeneti modul túl nagy, sok a 15 bemenet, legyen csak 7 és fele ekkora a NYÁK”. A 3 M-es (~52 mm) lapon a 7 PH (~56 mm) egy vállon nem fér el, a felső vállon a busz (~31 mm) mellett sem – ezért a 4 M (a mostani 103 mm ~2/3-a). Több bemenethez még egy modul kerül a láncra (D48) | elfogadva (Balázs, 2026-11-03) | [MODULMAG-SPEC 7.](MODULMAG-SPEC.md) |
| D101 | 2026-11-03 | **A vezérlő-NYÁK blokkokba rendezve (a D87 elrendezését módosítja):** bal oldalt a betáp (F1, Q1, D2, R56/D12, C1) a VIN-méréssel (R1/R2/C3), alatta a mérőpont-sor (GND, +24V_P, +5V, V_BUS); a J2 alatt a V_BUS (U12 + U3 eFuse, EN-osztó R10/R11/D9, VBUS-mérés R13/R14/C14, R34); középen az 5 V-os buck (U2, TI-elrendezés, a kimeneti oszlop a V_BUS felé, FB-osztó az U2 alatt); a J3 alatt a CAN fentről lefelé (U7 → L2 + JP4/JP5 → U6 → R35/C42/C43 → JP2/JP3); jobbra fent a 3,3 V-os buck 90°-kal elforgatva (SW jobbra) – **az L1 a vállon, a ~13 mm-es borda fölött**, a kimeneti 1206-osok alatta; ez alatt a VIN_BUCK VAGY-diódák (D3, D8) + C4; az U4 felső lábsora fölött egy sorban az ESP-alkatrészek (R26/R27, C49/C50, C28/R19, C15/R15, C26/C27); az alsó fél: Ethernet (az U5 körül, a lezárás az RJ45 felé), LoRa (DNP), USB, kezelő (R17 az SW1 fölött), debug/bővítő. A blokkok körvonala és neve a User.Comments rétegen (gyártásba nem megy) | Balázs: „nagyon össze vissza vannak a komponensek … rendezd el értelmesen, hogy felismerhetőbbek legyenek a részek pl buck, can, eth”, majd „rakj át mindent, még ha be is van kötve, inkább megcsinálom újra”. A felső fél bekötése törölve (189 sáv/via), újrahuzalozandó; az L1 korábbi határesete a bordánál így megszűnt | elfogadva (Balázs, 2026-11-03) | [VEZERLO-SPEC 10.](VEZERLO-SPEC.md) |
| D102 | 2026-11-06 | **A vezérlő-NYÁK kész (Balázs huzalozta, 11-03 – 11-06), átnézés után:** GND-via minden GND-pad mellé (141 db, a D88 szerint nem a padba), F.Cu GND-kitöltés az 5 V-os buck és az ESP középső padjai alatt (tömör bekötés), a két buck forró hurka F.Cu-n zárva; kvarc: az Y1 és az R47 180°-kal elforgatva, a C40 az XI-, a C41 az XO-láb mellé (rövid, via nélküli XI/XO); a +3V3 a J8 felé In2-n az USB-C alatt; **feliratok** szkripttel: a hivatkozási jelek nem lógnak padra és egymásra (1,0 / 0,8 mm; 33 apró alkatrészé nem fér ki → beültetési PDF), felül a JP2/JP3 állásai („5V: 1044/2562 · 3V3: 330/230”, VEZERLO-SPEC 5.), RESET/BOOT, CAN H/L, 120Ω; alul a csatlakozók lábkiosztása (J1, J2/J3, J5, J8), a jumperek és a mérőpontok magyarázata, a lap neve + „JLCJLCJLCJLC” (a rendelésszám helye). DRC: 0 hiba, 0 bekötetlen, rajz ↔ NYÁK 0. Konzulensnek: `hardware/out/zip/modularis-vezerlo-2026-11-06.zip` (a LED-modul zipjének formájában). Nyitva, opcionális: az R40 (EXRES1) a W5500 10-es lábától 11 mm-re, az Ethernet-párok nem szorosan párban | A DRC-n túli átnézés: a GND-padok viái, a buckok hurka, a kvarc XO-ja egy ~10 mm-es kerülőn (~1 pF), a +3V3 az USB-C fém háza alatt, a JP2 felirata a spec szerint kötelező (rossz állásban a 3,3 V-os CAN-meghajtó tönkremegy) | elfogadva (Balázs: „igen mindenre, a vezerlot most kuldom”, 2026-11-06) | [VEZERLO-SPEC](VEZERLO-SPEC.md) |
| D103 | 2026-11-06 | **A relé-NYÁK huzalozása (Claude, egy második agent, saját szkriptelt routerrel):** minden kisfeszültségű háló bekötve (+24V_IN / GND_IN 0,8 mm, +24V_P és COIL1–4 0,5 mm, V_BUS / GND_BUS / +5V 0,6 mm a D95-ös 0,8 mm-es leválasztással, +3V3 0,4 mm, jelek 0,2–0,25 mm), 22 új GND-via; a C105 a C104 és az ULN2803A közé (6,85; 29,1); a K1–K4-en a dupla lábak jumpernek jelölve (a relén belül összekötve); **230 V: rézzónák a felső és az alsó rétegen** (a NO-utak ~4–6 mm, a K2 COM-ja a K2–K3 közti résen ~3,8 mm), a .kicad_dru 8 mm / 3 mm-es szabályával; **a K1, K3, K4 COM-ja (11-es láb) → a sorkapocs 1-es lába: 1,5 mm²-es szigetelt réz drót alul, beültetéskor** (a DRC-ben 3 várt bekötetlen pont; az alsó szitanyomaton kiírva); feliratok, mint a D102-ben. Zip: `hardware/out/zip/modularis-rele-modul-2026-11-06.zip` | A COM-sor a NC- és a NO-sor között van, a sorkapocs a NO-sor alatt: a COM-nak a NO-padok mellett kellene elmennie, de a két NO-pad között 4,5 mm, a szomszéd reléig 4,74 mm, a lapszélig 3,35 mm a hely (3 + sáv + 3 mm kellene); csak a K2 mellett van 9,8 mm-es rés. A drót 16 A-re jobb is, mint egy sáv; a relésor újratervezése (fekvő relék) túl nagy munka a rendelés előtt, a szabály lazítása 16 A-re nem jó | elfogadva (Balázs: „igen mindenre”, 2026-11-06) | [rele-modul.kicad_dru](../../hardware/rele-modul/rele-modul.kicad_dru) |
| D104 | 2026-11-06 | **A bemeneti NYÁK huzalozása (Claude, egy második agent; a relé saját routerének átírt másolatával – D103):** minden háló bekötve (V_BUS / GND_BUS 0,6–0,8 mm a D95-ös 0,8 mm-es leválasztással, +5V 0,5–0,6 mm, SUP1 / SUP2 / +3V3S / SUP_I2C és a jumperek közepe 0,4 mm, +3V3 0,3–0,6 mm, IN0–IN6, I²C és a többi jel 0,2–0,25 mm), GND-via a padok mellé (D88; összesen 52); **kis mozgatás:** az R390 (0 Ω, GND_BUS ↔ GND) 1 mm-rel lejjebb (y 30,75 → 31,75), mert a 0,8 mm-es leválasztása miatt az U304 középső bemenete (IN5) nem tudott kijönni; az U303/U304 két GND-lába (3 és 8) a tok alatt összekötve, egy-egy via a felső GND-láb fölött; a HDC3020 2-es GND-lába saját viát kapott; a modulmag-blokk másolásából maradt lógó csonkok (+5V, HW_ID, HW_REV, STATUS_LED) törölve. **Feliratok** a D102 szerint: felül a JP301/JP302 „3V3 / 5V”, alul a lap neve + „JLCJLCJLCJLC”, bemenetenként „+ G S” és IN0–IN6, az I²C és a busz lábkiosztása, „LEZÁRÁS”, a tápcsoportok magyarázata; 25 apró alkatrész jele nem fér ki → beültetési PDF. DRC: 0 hiba, 0 bekötetlen, rajz ↔ NYÁK 0 (előtte 140 bekötetlen, 4 lógó csonk). Zip: `hardware/out/zip/modularis-bemeneti-modul-2026-11-06.zip` | A rendelés előtti időhiány (D97): Balázs nem tudja kézzel huzalozni. **Kompromisszum:** az ESD-diódák (U303/U304) az MCU mellett vannak, nem a csatlakozóknál, ezért a bemeneti vezetékek a lap alján lévő szűrőtől (10 k + 10 nF) végigfutnak a lapon (~50 mm, sok hosszú átlós sáv) – villamosan rendben, a v2-ben az U303/U304 a csatlakozók mellé | elfogadva (Balázs: „mehet mindkettő hajrá”, 2026-11-06) | [bemeneti-modul.kicad_dru](../../hardware/bemeneti-modul/bemeneti-modul.kicad_dru) |
