Cloudhunter77/szakdolgozat/docs/konzultacio/2026-10-27-valaszok.md

# Pali visszajelzése (2026-10-26) – válaszok és amit átvezettem

Jegyzet a megbeszéléshez. Az új rajzok: `hardware/out/kapcsolasi-rajzok-2026-10-27.pdf` (a döntés: D90).

## Amit már átvezettem

- **„D70, D71…”:** a saját döntésnaplóm sorszámai voltak – kívülről tényleg nem érthetők. Kivettem a rajzokból és a komponenslistából.
- **Ferritgyöngyök:** kivettem (a modulmag VDDA-ja és a W5500 analóg tápja előtt is). A videóból azt tanultam, hogy a gyöngy a
  hidegítő kerámiákkal csillapítatlan LC-kört alkot, a rezonanciáján inkább erősít, és DC-áramnál az induktivitása is csökken.
  A VDDA-nál az 1 µF + 10 nF maradt a lábnál.
- **NRST:** 10 k felhúzás került rá (R6) – mindhárom modulon, mert a modulmag közös lap.
- **CAN-fojtó:** a footprintje (L1, a vezérlőn L2) rajta volt a NYÁK-on, a forrasztott áthidaló (JP) csak kiváltja, amíg nincs
  beültetve. A megjegyzés tényleg félreérthető volt, átírtam. *Kérdés: így jó, vagy máshogy gondoltad?*
- **Polaritásvédelem rajza:** a FET most a csatlakozó negatív pólusa és a GND közötti vonalon ül (vezérlő Q1, LED-modul Q201,
  relémodul Q100), így látszik, hogy a visszafolyó áram útjában van.
- **Mérőpontok** a saját hálózatukon; **C19/C61** és a **VIN_BUCK** vezetékkel. A D3 (USB) a D8 (24 V) mellé került, így a
  buck bemenetének dióda-VAGY-a egy helyen látszik. Az USB-C blokk a helyén maradt, mert a táp-rész mellé nem fért.
- **D2 / D7:** igen, elég az egyik – az R7 most 0 Ω, így ugyanazon a csomóponton voltak. A D7-et kivettem.
- **Tápszimbólumok** minden tápsínen (címke helyett).
- **Gombok** az ESP32 mellett: a RESET a CHIP_EN vezetéken, a BOOT a felhúzó ellenállása mellett (a GPIO9 lábánál nem fért el).
- **R31:** kivettem.
- **STM32:** a címkék rövid vezeték végén vannak, nem közvetlenül a lábon. **LED-modul:** a PGND_SH csatornánként egy vezeték.
- **Relémodul D100:** kivettem (lásd lent).

## A kérdésekre

### Polaritásvédelem – a magyarázat
Ahogy én értem: N-FET a GND-ágban, a drain a csatlakozó negatív pólusán, a source a lap GND-jén. Helyes bekötésnél először a
body-dióda vezet, utána a gate (a 24 V-ról, 10 k-n át, 15 V-os Zenerrel korlátozva) kinyitja a FET-et, és a csatorna söntöli a diódát – az áram tehát
„visszafelé”, a source-tól a drain felé folyik. Fordított bekötésnél a gate–source feszültség nulla (bedugott busszal) vagy
≈ −0,7 V, a FET zár, és a body-dióda is záróirányú – így a táp + pólusa nem jut a lap GND-jére. A védelem a body-dióda irányán
múlik: fordítva beforgatott FET-tel nem működne. Ez a közös föld miatt fontos: a + ági védelem a saját lapot megvédené, de a GND_IN
kapocs közvetlenül a lap GND-je lenne, így a táp + pólusa a busz GND-erén át, a többi modulon keresztül zárlatot okozna.
A TVS a FET utáni oldalon van (különben fordított bekötésnél nyitóirányban rövidre zárná a tápot).
Egy hibát biztosan találtam a leírásban: a LED-modulnál „20 A-en ~24 mV” állt, pedig 2,8 mΩ × 15 A ≈ 42 mV (~0,6 W).
*Kérdés: mi sántít még benne?*

### C1 – a D57-es megjegyzés
Az eredeti indok: hosszú betápkábelnél és csak kerámia kondenzátorokkal, élő tápra kötéskor a kábel induktivitása és a kerámia
LC-kört alkot, a feszültség a táp közel kétszereséig is túllőhet (Linear Technology AN88). Az elkó ezt csillapítja.
Amit utólag pontosítanék:
- **Nem a kapacitás csillapít, hanem az elkó ESR-je.** A kerámiák a 24 V-on DC-előfeszítés miatt kb. 10 µF-ot adnak, a kábel 2–5 m-en
  ~1,5–3,5 µH → a rezgőkör hullámimpedanciája √(L/C) ≈ 0,4–0,6 Ω, a csillapító ág ideális ESR-je ennek kb. a fele (~0,2–0,4 Ω),
  a kapacitása pedig a kerámiák többszöröse. A rajzon „low-ESR” állt – egy nagyon kis ESR-ű (polimer) kondenzátor nem csillapítana,
  csak lejjebb vinné a rezonanciát. A választott RVT-sorozatú elkó általános célú, az ESR-je nincs megadva, ezért ezt pontosítani kell.
- **A „kétszeres” a veszteségmentes legrosszabb eset:** a kábel és az F1 ellenállása is csillapít, és csak élő tápra kötéskor fordul
  elő (a tápegység lágyindítása mellett nem).
- **A „≤ 26 V” szabály, nem hardveres védelem:** az SMBJ28A kis áramnál ~31–35 V-on, névleges impulzusáramnál ~45 V-on vág, az
  LMR33630 pedig 36 V-ig üzemel – a TVS egymagában nem védi meg. A tisztább megoldás egy 60 V-os 5 V-os buck lenne (az U1 már 60 V-os).
- **Az R7-nél a „szükség esetén 10 Ω” elavult:** a központi 5 V óta az U2 24 V-on ~0,5 A-t, 12 V-on ~1 A-t vesz fel, ezen 10 Ω 5–10 V-ot
  ejtene.
- **Alternatíva – soros ellenállás az R7 helyén:** ~0,5 Ω (2512, ≥ 1 W) az U2 ágában a C1-gyel együtt túlcsillapítja a kört, akármekkora
  az elkó ESR-je (√(L/C) ≈ 0,2 Ω a 47 µF-tal), és ~25 µs-os RC-szűrőt ad az U2 elé. Ára: 24 V-on teljes terhelésnél ~0,25 V és ~0,1 W,
  12 V-on ~0,5 V és ~0,5 W; tipikus terhelésnél elhanyagolható. Az U1 ágát (D8 után) és a tartós túlfeszültséget nem védi.
*Kérdés: melyik részével nem értesz egyet – és a 36 V-os buckot cseréljem 60 V-osra, vagy elég a csillapítás + a szabály?
Az R7 = 0,5 Ω jobb-e, mint az elkó ESR-jére hagyatkozni?*
**Döntés (2026-11-02, D96):** az U2 (LMR33630) marad; a ≤ 26 V-os szabály és a C1 ESR-je a csillapításhoz (az R7 a D93-mal kikerült).

### Miért 5,2 V a busz?
Három feltétel közé kellett beférni (névlegesen 5,22 V: 1,0 V-os FB, 100 k / 23,7 k; a tűrésekkel kb. 5,1–5,35 V):
- **Alsó korlát – az USB fölött:** az LM66200 a két bemenete közül a nagyobbat választja; a bucknak az USB fölött kell lennie, hogy
  24 V mellett ne a laptop USB-portja táplálja a modulokat. A laptop-portok terhelve 5,0 V körül vannak. Ha egy töltő mégis
  magasabb (USB 2.0: ≤ 5,25 V, USB-C: ≤ 5,5 V), az USB csak addig visz terhet, amíg a kábelén le nem esik 5,2 V alá – ez önkorlátozó,
  és az ideális diódák a visszatáplálást is megakadályozzák.
- **Felső korlát – az 5 V-os alkatrészek:** a WS2812B-V5 ajánlott tartománya ≤ 5,3 V (a tűrés legrosszabb sarkán épp a határon), a
  TCAN1044AV, a 74HCT14 és az LM66200 ≤ 5,5 V, a TPS2595 5,7 V-on vág. Az SMF5.0A záróirányú feszültsége 5,0 V – 5,2 V-on többet
  szivárog, de a letörése ≥ 6,4 V, kárt nem okoz.
- **Ejtés a lánc végéig:** modulonként tipikusan 50–100 mA, a 2 A az eFuse korlátja. 2 A-nél a vezérlő kapcsolóin ~0,15 V, 2 m
  AWG22-n oda-vissza ~0,4 V, és laponként az átmenő sáv + 4 XH-érintkező is pár tíz mΩ → a lánc végén ~4,5 V. Az AP2112K-nak ~3,6 V is
  elég; szűk csak a bemeneti modul 5 V-os érzékelőinek lehet, teljes terhelésnél.
*Kérdés: maradjon így, vagy inkább 5,0 V és egy prioritásos tápválasztó (pl. TPS2121)? – az utóbbi új alkatrész, és az ejtésre
kevesebb tartalék marad.*

### A (D76) megjegyzés
A megjegyzés két korábbi döntésem ellentmondását oldotta fel, de a rajzon csak a végeredmény látszott:
- A LED-modulon 3 blokk van, mindegyik egy 3 tűs sorkapocs (+24 V, CHa, CHb). A szalag közös + vezetéke a blokk + kapcsára megy,
  és ebben a vezetékben ül a blokk biztosítéka (F202–F204). Egy szalag vagy kábel zárlata így csak a saját blokkját viszi le, a
  15 A-es F201 és a többi blokk megmarad, és a kis biztosíték a vékony szalagvezetéket is védi.
- A blokkot (FET-ek, sávok, sorkapocs) 10 A-re terveztem, a tűzvédelmi elvem viszont ágonként ≤ 100 W (a kis teljesítményű
  források 100 VA-es határa nyomán). 10 A × 24 V = 240 W – a kettő ellentmondott.
- A feloldás: a NYÁK 10 A-t bír, de a beültetett biztosíték a bekötött szalaghoz igazodik: 100 W-hoz 24 V-on 100 / 24 ≈ 4 A,
  12 V-on 100 / 12 ≈ 8 A; nagyobb szalaghoz legfeljebb 10 A (ekkor az ág tudatosan 100 W fölött van).
- Gyenge pontja: a NANO² beforrasztott, tehát az értéket építéskor kell eldönteni, a szerelő nem cseréli. A kiolvadást a firmware
  látja: kikapcsolt csatornánál a drain ~0 V.
A rajzon a megjegyzést érthetőbbre írom: „Blokkbiztosíték a szalag + vezetékében: 100 W-os szalaghoz 4 A (24 V) / 8 A (12 V);
legfeljebb 10 A (a blokk terhelhetősége)”.

### A LED-modul földelése
**Hol milyen áram folyik:**
- **Teljesítmény (≤ 15 A):** betáp + → F201 → sín → blokkbiztosíték → szalag → csatorna-FET → PGND_SH → 1 mΩ-os sönt → GND → Q201 →
  betáp −. A PWM-élek áramát a sínen lévő 470 µF (C203) helyben zárja, a vezetékpáron csak a középérték megy.
- **Logika (~0,1 A):** a buszról jön (+5V → AP2112K), és a modul GND-jéről két úton tér vissza: az R293-on át a busz-GND-n, vagy a
  modul tápvezetékén át a csillagpontba, onnan a vezérlő tápvezetékén – a nagyobb része az utóbbin, mert az kisebb ellenállású.
- **Hurokáram:** a busz-GND a tápvezetékekkel hurkot alkot. A 15 A a modul GND-vezetékén (2 m, 2,5 mm² ≈ 14 mΩ) ~0,2 V-ot ejt, és ez
  a hurokban áramot hajt. R293 nélkül ~1,2 A menne PWM-mel modulálva az AWG22-es busz-GND-n és az XH-n át; 1 Ω-mal ~0,2 A, a modul
  GND-je ~0,2 V-tal a busz fölött ül (a CAN közös módusú tartománya −2…7 V).

**Mitől csillagpontos:** a vezérlő és minden modul külön vezetékpárral megy a tápegységhez, a 0 V-ok egy ponton találkoznak. A busz-GND
elkerülhetetlen második kapcsolat (a CAN referenciája és a V_BUS visszatérője) – az R293 azt biztosítja, hogy a teljesítményáram ne
ezt válassza.

**Mi történik, ha nem az:**
- **Nem csillagpontos bekötés** (pl. a LED-modul 0 V-ja a vezérlő kapcsáról): a 15 A a vezérlő tápvezetékén is átfolyik, a vezérlő
  földje voltokkal elmozdul, és a hurokáram is nagyobb.
- **Leesik a GND_IN vezeték működés közben:** a szalag árama a busz felé keres utat. Végiggondolva:
  1. Először az R293-on át: a modul GND-je néhány V-tal a busz fölé ugrik, az R293-on amperek folynak (1206-os – hosszabb ideig nem
     bírja).
  2. ~6 V-nál a D5 (az 5 V-os TVS a modul +5V-ján) nyitóirányba kerül, és a hibaáram a V_BUS-vezetékbe folyik. Ez a V_BUS-t ~7 V-ra
     húzhatja (a vezérlő D4-e fogja meg), ami a többi modul LDO-jának (abs. max. ~6,5 V) határa fölött van; a modul CAN-lábai is a
     −4 V-os határ közelébe kerülnek.
  3. A modul MCU-ja eközben táp nélkül marad (a +5V és a GND közti különbség eltűnik), a gate driver EN-je lehúzva → a FET-ek
     lekapcsolnak, a hibaáram megszűnik. Ha ez gyors (a 3,3 V a kondenzátorokon ~0,1–1 ms alatt esik le), az első eseményt
     valószínűleg minden túléli.
  4. **A veszély az újraindulás:** az MCU feléled, a firmware visszaállítja az utolsó állapotot, és kezdődik elölről – ismétlődő
     impulzusok, amíg valami ki nem ég.
- Valódi biztosíték vagy PTC az R293 helyén **nem segítene**: ha kiold, a hibaáram a V_BUS-on és a CAN-vonalakon keres utat.

**Javaslatom (hardvermódosítás nélkül, firmware-ből):** a VBUS_SENSE (PC1) a busz +5V-ját a modul saját GND-jéhez méri, ezért látja
a földeltolódást. ADC-watchdoggal: ha a mért +5V hirtelen ~0,7 V-nál többet esik, miközben a szalagon áram folyik → DRV_EN le,
reteszelve, és hibajelzés a buszon; indulásnál pedig ne kapcsoljon vissza, amíg a VBUS_SENSE nincs rendben. A végleges megoldás a
galvanikus leválasztás lenne (izolált CAN + izolált 5 V), de azt a költség miatt elhagytam.
**Amit a rendelés előtt még fontolgatok:** a LED-modul busz-oldali leválasztása – ISO1042 (izolált CAN) + 1 W-os izolált DC-DC
(5 V → 5 V, pl. B0505S-1WR3) a V_BUS-ról. Ezzel a modul GND-je és a busz GND-je között nincs galvanikus kapcsolat: nincs hurokáram,
a GND_IN szakadásakor a szalag egyszerűen kialszik, és a LED-modul tápja bárhogy beköthető (a csillagpont-szabály csak a nem
leválasztott lapokra marad). Ára: két új alkatrész, a modulmag módosítása és a LED-modul busz-sarkának újrahuzalozása.
*Kérdés: elég a bekötési szabály + R293 + firmware-es felismerés, vagy érdemes most leválasztani – és ha igen, ez a felépítés jó?*

**A konzultáció után (10-28):** a leválasztás kell. Pali két helyet javasolt – összevetés (2026-11-01):

| | **(A) a busz bemenetén** – ISO1042 + izolált 5 V-os DC-DC | **(B) a MOSFET-ek előtt** – a teljesítményfokozat külön földön |
|---|---|---|
| Mi lép át a határon | a CAN (2 digitális jel, az ISO1042-ben) + a logika tápja (1 W) | 6 PWM + DRV_EN ki, hibajel vissza, ~10 analóg mérés be (összáram, 2 × 24 V, hőmérséklet, 6 drain) |
| A LED-modul áramköre | változatlan (mérések, COMP2 + DAC + TIM-break, PWM) | a mérésekhez izolált erősítők vagy egy második MCU, a túláramvédelemhez külső komparátor kell |
| Új alkatrész | ISO1042 (+ a relén/bemenetin is, a közös modulmag miatt), 1 W-os DC-DC | 2 db 4 csatornás digitális izolátor + táp a túloldalon + izolált analóg átvitel |
| Érintett lapok | modulmag (mindhárom modul), a LED-NYÁK busz-sarka | csak a LED-modul, de szinte az egész NYÁK |
| Halványítás (D92) | nem érinti | az izolátorok néhány ns-os impulzustorzítása a legkisebb lépéseknél (12,5 ns) számít |
| Egyéb | a DC-DC SIP-4, ~10 mm magas; debug közben a laptop összekötheti a földeket | a logika a buszon marad (nincs DC-DC), a nagyáramú rész a legtisztábban elválik |

Javaslatom: **(A)** – a határ ott a legolcsóbb, ahol a legkevesebb és leglassabb jel lép át: a busznál ez 2 digitális jel és a táp, a
MOSFET-eknél ~18 jel, köztük gyors analógok. Ez az izolált CAN-csomópontok bevett felépítése is. A Q201 (polaritásvédelem) marad:
fordított bekötésnél nélküle a TVS nyitna, és az F201 kiolvadna.

**Döntés (2026-11-01, D94):** (A) – a transceiver CA-IS3052G (a TI ISO1042-vel lábkompatibilis, de az LCSC-n ~540 Ft az
ISO1042 ~6000 Ft-jával szemben), a LED-modul logikája B0505S-1WR3 izolált DC-DC-ről jár, az R293 kikerült.

### Schottky-dióda a szalag mellett
Nem a szalag induktivitása a gond, hanem a kábelé. A szalagon a + és a − vezeték egymás mellett fut (kis hurok), és az áram a
hossza mentén oszlik el – becslésem szerint néhány tized µH. A modul és a szalag közti kábel viszont egy 5 m-es érpárnál ~3–4 µH
(szétváló ereknél több). 10 A-nél kikapcsoláskor ½·L·I² ≈ 175 µJ; 25 kHz-en ez ~4 W, ami dióda nélkül minden ciklusban a FET
lavinaletörésében (~70 V) alakulna hővé. Ez a drain-mérőosztót is túlhajtaná (70 V → ~7 V az ADC-lábon).
A dióda (SS56B, a drain és a blokk +24 V-ja között) a kikapcsoláskor körbe vezeti a kábel áramát: + vezeték → szalag → csatorna-
vezeték → dióda → vissza. Az energia néhány µs alatt a szalagban és a diódában emésztődik el; a dióda átlagárama kicsi (~0,4 A),
a csúcs 10 A bőven a lökőáram-tűrésén belül van. Mellette egy RC-snubber helye is ott van (10 Ω + 2,2 nF, alapból nincs beültetve,
mérés után).

### Az I_SENSE szűrője
Őszintén: nem szűrőként méreteztem. Az R207 (100 Ω) + C241 (1 nF) töréspontja ~1,6 MHz – ez az ADC mintavevőjének töltéstartaléka
(1 nF a ~5 pF-os mintavevő mellett: < 0,5 % visszarúgás) és az INA181 kimenetének leválasztása a kapacitív terheléstől. A
sávszélességet valójában az INA181A2 (~200 kHz, τ ≈ 0,75 µs) korlátozza.
A jelnek két felhasználója van, eltérő igénnyel – ezért nem akartam lassú szűrőt:
- **COMP2 → TIM-break (hardveres zárlatvédelem):** a szalag zárlatakor az áramot a kábel induktivitása korlátozza (24 V / 3,5 µH
  ≈ 7 A/µs). A lánc késése: INA181 + RC ~1 µs, a COMP2 és a break ~0,1 µs, a FET kikapcsolása ~0,1 µs → ~30 A-es küszöbnél a csúcs
  ~40 A körül marad, ezt a FET impulzusárama bőven bírja. A bekapcsolási tüskék ellen a COMP2 kioltását (blanking a timerről) és a
  break digitális szűrőjét tervezem, nem RC-t.
- **ADC (firmware-es árammérés):** a PWM-mel szinkronban mintavételez (timer-trigger), így ismert pillanatokban – akár
  csatornánként – lehet mérni; az átlagot (a 15 A-es korláthoz) a firmware számolja. Ehhez a jelnek gyorsan be kell állnia, a lassú
  szűrő elrontaná.
Amit közben észrevettem: a fázistolt csatornák átlapolódásakor a pillanatnyi összáram jóval 15 A fölött is lehet (pl. 3 csatorna
× 10 A egyszerre), ezért a COMP2 küszöbe zárlati szint (a beállított csatornaáramokból), nem a 15 A; a 15 A-es korlát a firmware
dolga.
**Lehetséges megoldások (egyszerűtől a nagyobb változtatásig):**
1. **R207 → 1 kΩ** (~160 kHz, az INA181 sávszélességéhez igazítva): a zajt és az INA-nál gyorsabb, csatolt tüskéket levágja, a
   komparátor ~1 µs-mal lassabb – csak alkatrészcsere, a NYÁK marad.
2. **Kioltás + digitális szűrő (firmware):** a COMP2 blanking a timerről (a bekapcsolás utáni első pillanatban nem figyel) és a
   TIM-break bemenet digitális szűrője – hardver nem kell hozzá, az 1.-gyel együtt is mehet.
3. **Külön láb a mérésnek:** az INA181 kimenetéről két ág – a gyors (kis RC) a COMP2-re (PA3), egy lassú (pl. 10 k + 100 nF,
   ~160 Hz) egy másik ADC-lábra az átlagáramhoz. Ehhez szabad ADC-láb és NYÁK-módosítás kell.
**Fázistolás:** a csatornák nem egyszerre kapcsolnak be – a terv (EMC-döntés, 10-10) szerint el vannak tolva egymáshoz képest. Így
kisebb a pillanatnyi összáram, a bemeneti kondenzátor és a tápvezeték áramlüktetése, kevesebb az egyidejű él (kisebb zavarkibocsátás),
és a bekapcsolási tüskék sem adódnak össze a komparátoron. Korlát: a TIM1 három csatornája (CH1–CH3) közös számlálón jár, ezek között
csak a PWM-módok (elöl / hátul igazított impulzus) adnak eltolást; a TIM15 és a TIM16 az indítási időponttal tolható el. A mérésnél
(ADC) a firmware tudja, mikor melyik csatorna van bekapcsolva – a „szinkron mintavétel” azt jelenti, hogy az ADC-t a PWM-időzítő
indítja, nem azt, hogy a csatornák egyszerre kapcsolnak.
Villogás nem lesz belőle, mert minden csatorna pontosan ugyanazon a frekvencián jár (közös órajel), az eltolás csak a 40 µs-os
perióduson belüli sorrendet változtatja. Lebegés (lassú, látható ingadozás) csak eltérő frekvenciáknál lenne – ezért a frekvencia-
ditheringet minden időzítőn egyszerre kell állítani, vagy el kell hagyni. Látható lépcső inkább a legkisebb fényerőn lehet (80 MHz /
25 kHz = 3200 lépés, és a kábel ~1,5 µs-os időállandója miatt a nagyon rövid impulzusok nem futnak fel teljesen) – ez firmware-es
kalibrációs görbe és kitöltés-dithering kérdése.
**Az árammérés felbontása:** 1 mΩ × 50 = 50 mV/A; 12 bites ADC, 3,3 V-os referencia → 0,8 mV ≈ **16 mA / lépés**, ~65 A-ig
(hardveres túlmintavétellel finomabb). A pontosságot nem a felbontás, hanem az INA181 ofszetje (max. ±150 µV → ±0,15 A) és a
sönt, az erősítés és a referencia ~1–2 %-os tűrése határozza meg: kb. ±(2–3 % + 0,15 A); indításkori nullpont-kalibrálással
(minden csatorna KI) az ofszet kiesik, így kis áramnál ~±30 mA. Egy csatorna árama akkor mérhető, ha legalább néhány µs-ig be van
kapcsolva (a jel ~2–3 µs alatt áll be).
*Kérdés: te hogy méreteznéd – elég az 1. + 2., vagy válasszam szét a gyors (komparátor) és a lassú (ADC) ágat?*

### Relémodul: D100 és a FET-es polaritásvédelem
A D100 volt az eredeti védelem a + ágban. Amikor a közös föld miatt bekerült a GND-ági FET, a D100 feleslegessé vált –
bennmaradt. Kivettem.

### Elég-e az ULN2803A belső diódája?
Áramra bőven: a tekercs 400 mW / 24 V ≈ 17 mA – kikapcsoláskor ennyi folyik tovább a diódán, ami több száz mA-t bír; az energia
(½·L·I², ~1 H-s tekercsnél ~0,1 mJ) elhanyagolható. A COM láb (10) a tekercs-tápon (+24V_P) van, a kimenet ~25 V-ra van fogva, az
ULN2803A 50 V-ot bír.
Amit a kérdés mögött sejtek: a puszta diódás kioltás **lassítja a relé elengedését** (a tekercsáram lassan cseng le), ezért az
érintkezők lassabban nyílnak, és 230 V-on, induktív terhelésnél (motor, szivattyú) nagyobb az ív → rövidebb élettartam.
Megoldás: Zener-dióda a COM és a +24V_P közé (katód a COM-on) – a kioltás ~24 + Vz feszültségen történik, az áram gyorsabban
lecseng. A már használt BZT52C15-tel 26 V-os tápnál ~42 V, az ULN2803A 50 V-os határa alatt; mellé 0 Ω-os áthidalás, ha mégsem kell.
A relé-NYÁK még nincs huzalozva, így ez könnyen belefér. *Kérdés: érdemes a Zenert betenni?*
**Döntés (2026-11-02, D96):** bekerült – D107 (BZT52C15, katód a COM-on) + R117 0 Ω áthidalás (alapból nincs beültetve).

### Bemeneti modul
- **Jelek:** nyomógomb, reed, Hall-érzékelő (ajtó), PIR, impulzusos mérőóra (S0: ≥ 30 ms-os impulzus) – ezek 100 Hz alatt
  vannak. A leggyorsabb, amire gondoltam, egy Hall-es átfolyásmérő: néhány száz Hz. A pergésmentesítés firmware-ben lesz.
- **Méretezés** (bemenetenként, a csatlakozótól a lábig): 10 k felhúzás a csatlakozó oldalán a +3V3-ra (ez ad áramot a száraz
  érintkezőnek és a nyitott kollektoros érzékelőnek), 10 k soros ellenállás, 10 nF a mikrovezérlő lábánál → τ = 100 µs (~1,6 kHz),
  zárásnál; nyitáskor a felhúzáson át 200 µs. A töréspont így a leggyorsabb jel fölött van, de a hosszú érzékelőkábelen beszedett
  nagyfrekvenciás zavart levágja. A soros 10 k a félrekötést is korlátozza (24 V-nál ~2 mA), és az ESD-áramot is. Az osztó alsó
  tagjának helye (DNP) a 12/24 V-os aktív érzékelőkhöz van.
- **ESD-tömb:** a TPD4E05U06 a soros 10 k *után*, a láb mellett ül. Az RC a tüskét csak lassítja: egy 8 kV-os ESD-impulzus a 10 k-n
  ~0,8 A-t hajtana a csomópontba, és lefogás nélkül a 10 nF-ot több tíz V-ig töltené – a mikrovezérlő lábai csak néhány mA-es
  befolyó áramot engednek (az 5 V-tűrő lábakon a +3V3 felé nincs is dióda). Ezért kell egy lefogó elem. A gyorsaságára és a
  0,5 pF-os kapacitására itt nincs szükség – mellette ott a 10 nF. Azért választottam, mert TI-mintaként kértem, és egy kis tokban
  4 csatorna; bármelyik 4 csatornás 5 V-os ESD-tömb (olcsóbb is) megfelelne.
- **Amit most vettem észre:** a felhúzás a mikrovezérlő +3V3-jára megy, így egy félrekötött 24 V bemenetenként ~2 mA-t tol vissza a
  3,3 V-os sínre (16 bemeneten ~33 mA), amit az LDO nem tud elnyelni – a sín feszültsége megemelkedhet. Lehetőségek:
  1. elfogadni és leírni: osztó nélkül csak ≤ 5 V-os jel mehet; 12/24 V-os aktív érzékelőhöz az osztót beültetni és a felhúzást
     kihagyni;
  2. a felhúzás egy Schottky-diódán át a +3V3-ra (bemenetenként vagy csoportonként) – a dióda a visszatáplálást megakadályozza,
     a magas szint ~3,0 V lesz;
  3. egy 3,6 V-os Zener / kis terhelés a +3V3-on, ami a visszatáplált áramot elnyeli.
  *Kérdés: melyiket javasolnád – vagy a felhúzás menjen az érzékelő saját tápjára?*
  **Döntés (2026-11-02, D96):** az 1. – leírás a rajzon és a komponenslistában, új alkatrész nincs.

## Időpont
A NYÁK-rendelés ≈ 10-30/31, és a még huzalozatlan lapok (vezérlő, relé, bemeneti) előtt jó lenne lezárni a nyitott kérdéseket –
ezért inkább ma vagy holnap, mint péntek.
