Cloudhunter77/szakdolgozat/docs/kontextus/beszelgetesek/2026-10-21-alkatreszkeszlet-2.md

# Alkatrészkészlet átnézése (2. kör), STM32L433RCT3 – 2026-10-21

Forrás: claude.ai chat, a `2026-10-14-alkatreszkeszlet-p78e05.md` folytatása. Balázs fotókat küld a készletéről;
minden fotónál: mi az, kell-e a szakdolgozathoz, más projekthez jó-e. Döntés: **D74 (nyitott – Balázs este dönt)**.

## Átnézett alkatrészek

| Alkatrész | Db | Mi ez | Szakdolgozat | Verdikt |
|---|---|---|---|---|
| **WNS20S100CQ** (WeEn) | 395 | kettős Schottky, 100 V, 2 × 10 A, közös katód, TO-220AB | a NYÁK-okra nem kell (SMD-s, ideális dióda a LED-modulon); breadboardon szabadonfutó diódának jó | 10–20 db marad, a többi mehet |
| **MT48LC4M32B2P-6A IT:L** (Micron) | ? | SDRAM, 128 Mbit (16 MB), ×32, 3,3 V, 166 MHz, TSOP-II-86; „IT” = ipari hőmérséklet-tartomány (−40…85 °C), gyártás 2017/30 | nem kell: az F303RET6 64 lábú tokjában nincs FMC, a C6-hoz nem köthető külső RAM; az audiómodulnál sem segít (a squeezelite PSRAM-ja SPI-s) | FPGA-s / STM32F4–H7-es projekthez 2–3 db, különben mehet; MSL – kisütni (2020-as zacskó) |
| **MFRC52202HN1** (NXP MFRC522) | 15 | 13,56 MHz-es RFID/NFC olvasó (ISO 14443A, MIFARE), 3,3 V, SPI/I²C/UART, HVQFN32 | v1-be nem; **v2-ötlet: RFID-olvasó modul** (kártyás zár, jelenlét-tag) – I²C-n a bemeneti modul I²C-csatlakozójára is köthető; kell hozzá NYÁK-hurokantenna + illesztőhálózat + 27,12 MHz-es kvarc | mind a 15 marad |
| **ATWINC1500** (Microchip, -MR210UB1961, u.FL) | két zacskó: ~120 + 150 | 2,4 GHz-es Wi-Fi-modul SPI-n (a TCP/IP és a TLS a modulon) | nem kell (a C6-ban van Wi-Fi, a modulokon CAN; a modul ne beszéljen közvetlenül Wi-Fi-n, D18) | 3–5 db marad; MSL – kisütni (2020), régi firmware → WiFi101 FirmwareUpdater; u.FL-es antenna kell |
| **BC857B** (Nexperia) | 248 | PNP, 45 V, 100 mA, SOT-23 | a kapcsolási rajzokon nincs kis tranzisztor (2026-10-21-i ellenőrzés), legfeljebb javításhoz | ~50 db marad (vagy az egész orsó, ha nem foglal helyet) |
| **SN65HVD230D** (TI) | 86 | 3,3 V-os CAN transceiver, 1 Mbit/s, SO-8 | **tartalék a TCAN1044AV helyett:** a vezérlőn a JP2/JP3 jumperrel ugyanarra a footprintre ültethető (JP2 → 3V3, JP3 nyitva, D60); a modulmagon **nem** (ott a 3-as láb fixen +5V, az 5-ös fixen 3V3 – a HVD230 5-ös lába Vref-kimenet) | mind marad – a transceiver-kockázatot fedezi |
| **MC33063ADR** (TI) | 10 | klasszikus kapcsolóüzemű szabályzó (buck/boost/invertáló), 3–40 V, 1,5 A-es kapcsoló, SO-8 | nem kell (LMR33630, LMR36015, a 12 V-os gate-táp lineáris MC78L12) | maradhat, kicsi; más tápos projekthez |
| **ISM97-3251BH-25.000** (ILSI) | 35 | **25 MHz-es, 3,3 V-os CMOS oszcillátor** (aktív, nem kvarc), 3,2 × 2,5 mm | **kiválthatja a W5500 25 MHz-es kvarcát** (beszerzési listán volt): a W5500 adatlapja szerint az XI/CLKIN-re 3,3 V-os külső órajel köthető, az XO nyitva marad; a két terhelőkondenzátor elmarad. Rajz-változtatás kell (oszcillátor-footprint: 1 OE → VDD, 2 GND, 3 OUT → XI, 4 VDD + 100 nF). Forgalmazói adatok: ±50 ppm (az Ethernet-határ ±50 ppm – épp megfelel; a W5500 kvarcra ±30 ppm-et ír), −40…85 °C, max. 20 mA, az 1-es láb tri-state (OE) – a lábkiosztást a ILSI-adatlapból ellenőrizni | mind marad; **javaslat a vezérlőre – Balázs dönt** |
| **MCP2517FDT-H/SL** (Microchip) | 105 | külső CAN FD vezérlő SPI-n, SOIC-14 (4/20/40 MHz-es órajel kell) | a NYÁK-okra nem kell (C6: 2 TWAI, STM32: bxCAN); **fejlesztői eszköznek jó:** Raspberry Pi + MCP2517FD + SN65HVD230 = CAN-buszfigyelő (Linux `mcp251xfd` driver, `candump`, Wireshark) a modulforgalom hibakereséséhez és a dolgozat méréseihez. v2: CAN FD a vezérlőn (a C6 TWAI-ja csak klasszikus CAN; a TCAN1044AV FD-képes) – a modulokon FDCAN-os MCU kellene (G0/G4; az L433 bxCAN-ja nem FD) | ~10 db marad, a többi eladható |
| **MAX3232EIDR** (TI) | 10 | RS-232 transceiver, 3–5,5 V, 2 meghajtó + 2 vevő, SOIC-16 | nem kell | marad – soros konzol régi / hálózati eszközökhöz (pl. switch-konzol), ipari berendezésekhez |
| **INA170EA/2K5** (TI) | 2500 (orsó) | **felső oldali**, kétirányú söntáram-figyelő, áramkimenet (az erősítést a kimeneti ellenállás adja), közös módus 2,7–60 V, táp 2,7–40 V, MSOP-8 | a mostani LED-modulhoz **nem jó**: ott a sönt alsó oldali (közös módus ~0 V), az INA170-nek min. 2,7 V kell – marad az INA181A2. **v2-höz jó:** blokkonkénti árammérés a három kimeneti blokk +24 V-ján (felső oldali sönt, 60 V-ig bírja) → a „csatornánkénti árammérés” v2-ötlet olcsóbb változata | 20–50 db marad, a többi eladható |
| **MCP2120-I/SL** (Microchip) | 1 cső | IrDA infravörös kódoló/dekódoló (UART ↔ IrDA SIR-impulzusok), 2,5–5,5 V, SOIC-14, 2019/07 | nem kell | mehet (legfeljebb 2–3 db érdekességnek) – IR-távirányítóhoz (38 kHz) és a fogyasztásmérők optikai portjához (IEC 62056-21) sem jó |
| **NCD9830DBR2G** (onsemi) | 350 | 8 bites, 8 csatornás (vagy 4 differenciális) ADC I²C-n, 2,7–5,5 V, belső 2,5 V-os referencia, címek 0x48–0x4B, max. 70 kS/s, TSSOP-16 | v1-hez nem kell (az STM32-kben bőven van ADC). A bemeneti modul I²C-csatlakozójára köthető bővítőnek (a HDC3020 0x44–0x47-en van, nincs ütközés), de a 8 bit durva (~10 mV/lépés) | ~10 db marad (pl. Raspberry Pi-hez, amiben nincs ADC), a többi eladható |
| **AT32UC3A0512-U** (Atmel) | 1 tálca | 32 bites AVR32 (UC3A0) MCU, 66 MHz, 512 KB flash, 64 KB SRAM, 10/100-as Ethernet-MAC, USB OTG; 144 lábú tok (a tálcán valószínűleg BGA), 2012/27 | nem kell | mehet – az AVR32 elhalt architektúra (régi, külön GCC, csak a Microchip Studio/ASF támogatja), új tervbe nem való; BGA-nál a forrasztás sem ellenőrizhető röntgen nélkül |
| **CPC1014N** (IXYS/Littelfuse OptoMOS) | ~90 | félvezető relé, 1 záró érintkező (SPST-NO), 60 V AC/DC, 400 mA, 2 Ω, LED-vezérlés (max. 50 mA), SOP-4, galvanikus leválasztás | a v1 NYÁK-okon nincs helye (a relémodul 230 V-os, erre nem jó). **v2-ötlet:** kis áramú, potenciálmentes kimeneti modul – kazán-/termosztát-bemenet (24 V AC), kapunyitó, kaputelefon, klíma-vezérlőjel (hasonló a kézben lévő LH1522-höz) | mind marad |
| **MIC5504-2.8YM5-TR** (Microchip) | 100 | 300 mA-es LDO, **fix 2,8 V**, bemenet 2,5–5,5 V, SOT-23-5 (1 VIN, 2 GND, 3 EN, 4 NC, 5 VOUT – ugyanaz, mint az AP2112K-é) | nem kell. Lábra ugyan beférne a modulmag AP2112K-3.3 helyére (az F303 2,8 V-on is megy), de akkor a VDDA = 2,8 V, és a 3,3 V-ra méretezett mérőosztók végkitérése megváltozik – nem javaslom | 10–20 db marad – 2,8 V-os tápághoz, pl. kameraszenzor (OV2640: 2,8 V-os analóg táp) |
| **STM32F756BGT6** (ST) | 1 | Cortex-M7, 216 MHz, 1 MB flash, 320 KB RAM, LCD-TFT-vezérlő, kripto/hash, Ethernet-MAC, FMC, 2 × bxCAN, USB OTG HS/FS, LQFP208 (0,5 mm-es lábtáv) | v1-hez nem kell. Az FMC-n a kézben lévő **MT48LC4M32B2 SDRAM**-mal párban (mint az ST STM32F746G-DISCO-n) → v2-ötlet: **fali érintőkijelzős panel** a rendszerhez (bxCAN-nel a buszra vagy Ethernettel) – nagy munka (LQFP208, 4–6 réteg); egyszerűbb út egy kész ESP32-S3-as kijelzőpanel | marad |
| **STM32L031F6P6TR** (ST) | 100 | Cortex-M0+, 32 MHz, 32 KB flash, 8 KB RAM, 1 KB EEPROM, rendkívül kis fogyasztás, TSSOP-20; **nincs CAN és USB** | modul-MCU-nak nem jó (nincs CAN). **v2-ötlet:** elemes LoRa-érzékelők (postaláda, kert, garázs) az L031 + Ebyte E22 párossal, a vezérlő LoRa-előkészítéséhez (D68) – pont-pont LoRa belefér a 32 KB-ba, LoRaWAN-hoz kevés; vagy kis I²C-s érzékelőpanel a bemeneti modul I²C-csatlakozójára | mind marad |
| **CT10-1030-G1** (Coto) | 5 | SMD reed-kontaktus (záró), 10–30 AT érzékenység, 10 W, 11,6 × 2,9 × 2,4 mm, műanyag tokban | **jól jön:** a bemeneti modul bármilyen kapcsoló-érzékelőt fogad (D44) – a reed a JEL és a GND közé, a modul felhúzása miatt mágnesnél LOW, mint az AH1911-nél; táp nem kell, 2 ér elég. **5 AH1911 + 5 reed = 10 → a 6 fiókos komódhoz nem kell AH1911-et rendelni, csak mágnest** (javaslat). A reed a tengelye irányú mezőre érzékeny – a mágnes helyzetét ki kell próbálni | mind marad |
| **TSV632IYDT** (ST) | 1 zacskó szalagdarab | kettős, rail-to-rail ki-/bemenetű, mikrofogyasztású műveleti erősítő (~60 µA/csatorna, ~880 kHz), 1,5–5,5 V, SO-8, autóipari (IY) | nem kell. Az INA181A2 tartalékának **nem jó**: a néhány mV-os ofszet az 1 mΩ-os söntön ×50-nel több amperes hibát adna | marad – elemes érzékelők jelkondicionálásához, kis fogyasztású analóg részekhez |
| **ABS07L-32.768KHZ-T** (Abracon) | 60 | 32,768 kHz-es órakvarc, CL = 12,5 pF, 3,2 × 1,5 mm | v1-hez nem kell (a moduloknak nem kell RTC, az idő a vezérlőnél van). STM32 LSE-hez 12,5 pF-nál közepes/nagy LSE-meghajtás kell (LSEDRV) | marad – az elemes L031/L433-as érzékelők RTC-jéhez / LPTIM-ébresztéséhez |
| **MCOT064032A1V-YI** (Midas) | 10 | 0,49"-os, 64 × 32-es sárga OLED, I²C, beépített töltéspumpa, VDD 2,8–3,3 V, 14 tűs TAB-kivezetés (~0,7 mm), külső 4 kondenzátor + IREF-ellenállás, 14,5 × 11,6 mm | v1-be nem: a NYÁK a DIN-ház alján fekszik, az előlapi ablak ~40 mm-rel feljebb van → kijelzőhöz felálló kis lap kellene (a LED-ek is fényvezetőt kapnak, D50) | mind marad – kis kütyük, elemes eszközök állapotkijelzője |
| **ATWINC1500-XPRO** (Microchip) | 2 | Xplained Pro bővítőpanel: ATWINC1510 Wi-Fi-modul + ATECC108 és ATSHA204 kriptochip, 3,3 V, SPI/I²C | nem kell | mind marad – ezzel a kézben lévő ATWINC1500-ak forrasztás nélkül kipróbálhatók (WiFi101, firmware-frissítés); az ATECC108 kripto-hitelesítéshez érdekes |
| **NCS20072DR2G** (onsemi) | 200 | kettős műveleti erősítő, 3 MHz, rail-to-rail kimenet, a bemenet a negatív tápig ér, táp 2,7–36 V (±1,35…±18 V), SO-8 | nem kell (az INA181A2 tartalékának az ofszet miatt ez sem jó) | 20–30 db marad – általános célú, az LM358/LM2904 jobb utódja, 12/24 V-ról is megy (érzékelő-erősítő, puffer, vonalszintű hang) |
| **VSMB3940X01-GS08** (Vishay) | 5 | 940 nm-es infravörös LED, 100 mA, SMD, MSL3 | v1-hez nem kell. **v2-ötlet: IR-adó modul** – a 940 nm a távirányítók szabványos hullámhossza (38 kHz-es vivő: STM32-timer vagy a C6 RMT-perifériája) → klíma, TV, hifi vezérlése a HA-ból; tanuláshoz IR-vevő kell mellé (pl. TSOP38238) | mind marad |
| **MCP6542-E/P** (Microchip) | néhány | kettős komparátor, push-pull kimenet, rail-to-rail bemenet, 1,6–5,5 V, ~1 µA, **DIP-8** (2019) | nem kell (az STM32-kben van belső komparátor) | marad – DIP-tokja miatt breadboardra jó (ablakkomparátor, akkufeszültség-figyelés, Schmitt-trigger) |
| **MCP9701AT-E/TT** (Microchip) | ~21 (a címke szerint, 2 zacskóban) | lineáris analóg hőmérséklet-érzékelő: 19,5 mV/°C, 0 °C-on 400 mV (125 °C-on ~2,84 V), VDD 3,1–5,5 V, SOT-23-3 | **jól jöhet a LED-modulon:** a FET-ek melletti NTC (TH201 10k B3435 + R208 10k, PC3) helyett – lineáris kimenet közvetlenül az ADC-re, nincs táblázat, és az NTC-t nem kell megvenni. Bekötés: 3V3 + 100 nF, kimenet → `NTC` net (PC3); a meglévő 100 nF-os C242 elé ~200 Ω soros ellenállás kell (nagy kapacitív terhelés – az adatlapban ellenőrizni). Rajz-változtatás – **javaslat, Balázs dönt** | mind marad |
| **LT4320IMSE#PBF** (ADI/Linear) | 29 | ideális diódás hídvezérlő: 4 N-FET-tel váltja ki a diódahidat (9–72 V, DC vagy 50/60 Hz AC), MSOP-12 | **Rávilágított egy v1-es hibára (lásd lent: „Fordított polaritás közös földdel”).** Híddal a modul bármelyik polaritással működne, de a 20 A-es ágon 2 FET vezet egyszerre és 4 FET kell; egyszerűbb megoldás a GND-ágba tett N-FET. v2: PoE-PD bemenet (37–57 V) a diódahidak helyett | mind marad – 24 V AC-s eszközökhöz (termosztát, csengő, öntözőszelep) és a v2 PoE-hez |
| **MCP121T-300E/TT** (Microchip) | 22 | feszültségfelügyelő (reset-IC), ~2,9–3,0 V-os küszöb, open-drain, aktív alacsony, SOT-23-3 | **opcionális a vezérlőn:** a C6 EN-lábára, a meglévő RC (R15 10 k / C15 1 µF) és az SW1 mellé párhuzamosan – a C6-ot addig tartja resetben, amíg a 3,3 V el nem éri a ~3,0 V-ot (lassú felfutásnál és tápletörésnél az Espressif reset-IC-t javasol). Az STM32-nek nem kell (belső POR/PDR + PVD) | marad – 3,3 V-os MCU-s projektekhez |
| **LM2676S-12** (NSC/TI) | 1 tubus | 3 A-es, 12 V-os fix kimenetű buck (Simple Switcher), 8–40 V be, 260 kHz, TO-263-7 | nem kell: a LED-modul gate-driver-tápja néhány mA (MC78L12 elég), és 12 V-os tápról nem tudna 12 V-ot adni | marad – 24 V → 12 V, 3 A-es táp más projektekhez (ventilátor, 12 V-os eszközök a 24 V-os sínről) |
| **Schrack RT334005** (TE) | ≥ 2 | RT1-es teljesítményrelé, 1 záró (NO), 16 A / 250 V AC, **5 V-os tekercs** (~80 mA) | a relémodul footprintjére illik (csak COM + NO van kivezetve, D62), de a tekercssín ott 24 V (12 V-os változat: HW-ID 4); 4 db 5 V-os tekercs a V_BUS-ról ~320 mA lenne – a D71 szerint a nagy fogyasztók 24 V-ot kapnak, ezért v1-hez nem | marad – 5 V-os relés panelekhez (ESP32/Arduino), 230 V-os kapcsolás |
| **MCP3008-I/SL** (Microchip) | 10 | 10 bites, 8 csatornás SPI-s ADC, 2,7–5,5 V, SOIC-16 | nem kell: az STM32-k 12 bites ADC-je bőven elég, a vezérlőn nincs szükség több analóg bemenetre | marad – Raspberry Pi-hoz (nincs saját ADC-je) |
| **TEMD7100X01** (Vishay) | 5 | PIN fotodióda, IR-re érzékeny (~950 nm), 0805 | v1-hez nem kell. A **VSMB3940X01** (940 nm-es IR LED) párja: reflexiós vagy fénysorompós érzékelő, v2-ben akár a bemeneti modul egy bemenetére (pl. fiók- vagy ajtóérzékelés mágnes nélkül) | marad – IR-közelítés, fénysorompó; az MCP2120-szal + VSMB3940-nel saját IrDA-adó-vevő |
| **DS1307Z+** (Maxim/ADI) | 50 | I²C-s valós idejű óra (RTC) + 56 bájt elemes SRAM, **csak 4,5–5,5 V-os táp**, SO-8; külső 32,768 kHz-es kvarc (12,5 pF) + gombelem kell | nem kell: a vezérlő a hálózatról (SNTP/Matter) kapja az időt, a modulok nem igényelnek pontos időt (az STM32-ben belső RTC is van) | marad – offline órákhoz, adatgyűjtőkhöz 5 V-os Arduinóval; a kézben lévő ABS07L kvarc illik hozzá, ha 12,5 pF-os (ellenőrizni). Pontosabb időhöz DS3231 kell |
| **VSMY1940ITX01** (Vishay) | ? | **gyors** 940 nm-es IR LED, adatátvitelre (IrDA, optikai link), SMD, MSL4 | v1-hez nem kell. Ugyanabból a DigiKey-rendelésből (2024-10), mint a TEMD7100 fotodióda – a kettő + MCP2120 egy komplett IrDA-/optikai adatkapcsolat; v2-ben esetleg galvanikusan leválasztott szervizport egy modulhoz | marad |
| **HL-PST-1608U51GC** (Honglitronic) | 150 | **zöld 0603-as LED**, 522 nm (InGaN „igazi” zöld, nyitófeszültség ~2,8–3,2 V) | **igen, v1:** a rajzokon ~20 db zöld 0603-as LED van egy készletben (LED-modul: 6 gate + 6 drain, relé: 4, modulmag: 1/modul, vezérlő: 1 táp-LED). A 12/24 V-ról járókhoz (gate 4,7 k, drain és relé 10 k) tökéletes. **A 3,3 V-ról járó táp-LED-eknél (modulmag D3, vezérlő D5, 2,2 k) alig marad feszültség** → halvány, példányonként eltérő; megoldás: a felső végüket a +5V-ra kötni (~1 mA), vagy oda sárgászöld (~570 nm, ~2 V-os) LED | **felhasználni a v1-ben** |
| **MIC94070YC6-TR** (Microchip/Micrel) | 24 | felső oldali terheléskapcsoló, 1,7–5,5 V, 1,2 A, ~120 mΩ, SC-70-6; EN belső lehúzással (alapból KI), lágyindítás és áramkorlát nélkül | v1-hez nem kell (a V_BUS-t a TPS2595 kapcsolja). **v2-ötlet:** a bemeneti modul 4 érzékelő-tápcsoportja (D66) a PTC után egy-egy ilyen kapcsolóval → a firmware ki-be tudja kapcsolni egy lefagyott érzékelő tápját (4 szabad GPIO kell). Nagy kondenzátoros terhelésnél a gyors bekapcsolás miatt áramlökés lehet (a lágyindításos a MIC94072/73) | marad |
| **IRFR120NTRLPBF** (Infineon/IR) | 20 | N-FET, 100 V, 9,4 A, **~0,21 Ω**, DPAK | a LED-modul csatorna-FET-jének (NTD5C648NL, 4–5 mΩ) nem jó: 10 A-nél ~21 W-ot fűtene, pedig a footprint azonos. Ha a fordított polaritásra az (a) megoldás jön: **a relémodul GND-ági FET-jének jó** (ott csak a tekercsek ~70 mA-je folyik → ~15 mV) | marad – 24–48 V-os kis áramú kapcsolás (szelep, relé, mágnes) |
| **LM2675M-5.0** (NSC/TI) | 2 | 1 A-es, 5 V-os fix kimenetű buck (Simple Switcher), 6,5–40 V be, 260 kHz, SO-8; kell hozzá ~33–47 µH fojtó + Schottky | v1-hez nem: a V_BUS-hoz 2 A kell (LMR33630, 3 A); tartaléknak is kevés. Breadboardon jól jöhet 24 V → 5 V-ra (DevKit, 1–2 modul) | marad – 12/24 V → 5 V, 1 A-es táp ESP32-es/érzékelős projektekhez |
| **LM339DG4** (TI) | 1 tubus | 4 komparátor, open-collector kimenet, egytápos 2–36 V, a bemenet a GND-ig ér, SO-14 | nem kell: a LED-modul túláram-lekapcsolása az STM32 belső COMP2 + DAC → TIM-break útján megy, a bemeneti modul bemenetei közvetlenül a (Schmitt-triggeres) GPIO-kra mennek | marad – küszöbfigyelés 12/24 V-ról (akkufigyelő, ablakkomparátor), szintillesztés, egyszerű oszcillátor |
| **IR2104S** (Infineon/IR) | 1 tubus | félhíd-gate-driver: bootstrapos felső + alsó FET, 600 V, IN + SD bemenet, beépített holtidő (~0,5 µs), gyenge meghajtás (0,13/0,27 A), Vcc 10–20 V, SO-8 | nem kell: a LED-modul low-side csatornáit a UCC27524 hajtja (2 csatorna/tok, 4 A); az IR2104 tokonként csak 1 alsó FET-et tudna, lassan | marad – H-híd (2 db), BLDC-motor (3 db), szinkron buck, D-osztályú erősítő |
| **IQD LFSPXO050757** | 60 | 40 MHz-es CMOS-oszcillátor, 3,2 × 2,5 mm (a tápfeszültséget az adatlapból ellenőrizni) | a NYÁK-okra nem kell (STM32 HSE: max. 32 MHz, 8 MHz-es kvarc; W5500: 25 MHz; a C6-modulban saját kvarc van). **Az MCP2517FD (105 db) órajele** – az ajánlott 40 MHz → a kézben lévő alkatrészekből megépíthető a **CAN-FD-s buszfigyelő** (Raspberry Pi + MCP2517FD + SN65HVD230/TCAN1044, Linuxon `mcp251xfd` driver) a modul-protokoll fejlesztéséhez | marad |
| **STM32F407ZET6** (ST) | 1 | Cortex-M4F, 168 MHz, 512 KB flash, 192 KB RAM, Ethernet-MAC, 2 × bxCAN, USB OTG FS/HS, FSMC, LQFP144 | v1-hez nem: a vezérlő a C6 (Thread/Matter), a modulok F303-asok (LQFP64). Elvben Ethernet + CAN vezérlő lehetne, de Thread nélkül | marad – egyedi projekthez (pl. Ethernet–CAN átjáró, saját fejlesztőpanel) |
| **TP0610K-T1-E3** (Vishay) | 350 | P-FET, 60 V, 185 mA, ~6 Ω, SOT-23 | nem kell (kis áramú felső oldali kapcsolás, szintillesztés; 24 V-on a gate-et ±20 V-ra korlátozni) | marad |
| **BSS138P,215** (Nexperia) | ? (a címke alig látszik) | N-FET, 60 V, 0,36 A, SOT-23 – a klasszikus I²C-szintillesztő (3,3 ↔ 5 V) | **ha a fordított polaritásra az (a) megoldás jön: a relémodul GND-ági FET-je lehet** (SOT-23, kisebb, mint a DPAK-os IRFR120N; ~70 mA folyik). A bemeneti modul külső I²C-je 3,3 V-os, oda nem kell | marad |
| **MCSJK-3N-25.00-3.3-50-C** (Multicomp Pro; az EM-matricán „ISM97-3251BH25.00”) | 28 | 25 MHz-es, 3,3 V-os CMOS-oszcillátor, ±50 ppm, 3,2 × 2,5 mm | ugyanaz a szerep, mint a fenti ISM97-é: **a W5500 órajele** az XI/CLKIN-re. Ha ez egy második zacskó (nem a 35 db-os), **összesen ~63 db** – Balázs megerősítésére vár. A lábkiosztást a Multicomp-adatlapból ellenőrizni (a 3225-ös oszcillátoroké általában 1 OE, 2 GND, 3 OUT, 4 VDD) | marad – a vezérlőre |
| **BSS84P** (Infineon) | 50 | P-FET, −60 V, −0,17 A, SOT-23 – a BSS138 P-csatornás párja | nem kell (ugyanaz a szerep, mint a TP0610K-é: kis áramú felső oldali kapcsolás, szintillesztés) | marad |
| **74HC4051D** (NXP) | 1 tubus | 8 csatornás analóg multiplexer/demultiplexer, 2–10 V, SO-16 | nem kell: a bemeneti modul 16 bemenete külön EXTI-vonalon van, az F303-ban bőven van ADC-csatorna | marad – analóg bemenet-bővítés ESP32-höz/Arduinóhoz (1 ADC-láb → 8 jel), jelkapcsolás |
| **MIC4422ZM** (Micrel/Microchip) | 1 tubus | 9 A-es (csúcs) low-side MOSFET-driver, nem invertáló, 4,5–18 V, TTL-bemenet (3,3 V-ról is megy), SO-8 | a LED-modulon a UCC27524 marad (2 csatorna/tok, EN-lábakkal – a „bekapcsoláskor minden KI” elvhez kell). A MIC4422 nem cserélhető be: tokonként 1 csatorna, más lábkiosztás, nincs EN. **Breadboardon** jó (pl. a 24 V-os LED-meghajtó tesztjéhez, SO-8 adapteren) | marad – nagy FET-ek/IGBT-k, motor, mágnesszelep, kapcsolóüzemű táp |
| **TRACO TSR 1-2433** | 1 tubus (db ?) | kapcsolóüzemű 78xx-csere modul: 3,3 V / 1 A, bemenet 4,75–36 V, SIP-3 (THT), külső alkatrész nélkül | **a vezérlő 3,3 V-os tápjának tartaléka:** a `SAMPLE-KERESEK.md` szerint az LMR36015-nek „nincs tartaléka”; a 3,3 V-os mérleg ≈ 0,54 A (+ LoRa adáskor ~0,1 A) → az 1 A elég, a 12–26 V-os bemenet belefér. Más footprint (SIP-3), ezért vagy egy DNP-footprint kell a vezérlőre, vagy csak vezetékkel beépíthető vész-megoldás. Breadboardon 24 V → 3,3 V-ra azonnal használható | **marad – tartalék a vezérlőhöz** |
| **BT139-800E** (NXP) | 10 | triak, 16 A, 800 V, érzékeny gate (E), TO-220 | v1-hez nem (a relémodul mechanikus relékkel kapcsol). v2-ötlet: 230 V-os fázishasításos dimmer-modul – nullátmenet-érzékelés, optotriak és szigorú leválasztás kell hozzá | marad – AC-dimmer, fűtésvezérlés (a BT137 mellé) |
| **TC2117-3.3VDBTR** (Microchip) | 200 | 3,3 V-os CMOS LDO, 800 mA, ejtés 600 mV @ 800 mA (kis áramnál jóval kevesebb), 80 µA nyugalmi áram, SOT-223-3, **1117-es lábkiosztás**; bemenet max. ~6 V | **kiválthatja az AP2112K-t** (modulmag U5 + bemeneti modul U301 – a „kínai kör” beszerzési tétele): a V_BUS 5 V-járól a modul ~0,1 A-jénél az ejtés < 0,1 V, és a TPS2595 5,7 V-on vág → belefér. Ára: nagyobb footprint (SOT-223 a SOT-23-5 helyett), nincs EN (az AP2112K EN-je amúgy is VIN-re van kötve); a kerámia kimeneti kondenzátorral való stabilitást az adatlapból ellenőrizni | **marad – javaslat a modulokra, Balázs dönt** |
| **STM32L433RCT3** (ST) | **75** | Cortex-M4F, 80 MHz, 256 KB flash, 64 KB RAM, **LQFP64**, bxCAN, USB FS, 1 ADC, 2 komparátor, 2 csatornás DAC | **a legfontosabb lelet:** a v2 „olcsóbb modul-MCU” sora kézben van → lásd lent, D74 | **mind a 75 marad**; MSL3 (2022-es zacskó) |

## STM32L433RCT3 vs. STM32F303RET6 (ST STM32_open_pin_data alapján ellenőrizve, 2026-10-21)

**Azonos:** LQFP64-es tok; a táplábak helye (1 VBAT, 12/13 VSSA/VDDA, 18/31/47/63 VSS, 19/32/64 VDD; a **48-as láb
az L433-on VDDUSB** – a 3,3 V-ra kötve ugyanúgy jó); HSE az 5/6-os lábon (L433-on PH0/PH1); NRST; a **60-as láb
PH3-BOOT0** (a 10 kΩ-os lehúzással jó); **bxCAN a PA11/PA12-n** – ugyanaz a CAN-periféria, a `can_hw` réteg
átvihető; SWD (PA13/PA14); PC0, PC1 ADC-s (HW-ID, VBUS_SENSE); PB0 ADC-s (HW_REV); TIM1 CH1–3 a PA8–PA10-en;
DAC1_OUT1 a PA4-en; COMP2_INM a PA4-en; I²C1 a PB8/PB9-en; PB12–PB15 GPIO.

**Eltér:**
- **Nincs TIM8 (és TIM3/TIM4 sincs)** – időzítők: TIM1, TIM2, TIM15, TIM16, TIM6/7, LPTIM1/2. → A LED-modul
  CH4–CH6 (PC6–PC8, TIM8) nem megy.
- **Csak 1 ADC, 16 külső csatornával:** PA0–PA7, PC0–PC5, PB0, PB1. → A **PB11 nem ADC-s** (VIN_SENSE a LED- és a
  relémodulon), a PB12–PB15 sem (a bemeneti modul IN12–IN15 analóg módja).
- **COMP2 nem invertáló bemenete:** F303-on PA7, L433-on PA3 / PB4 / PB6. → A LED-modul I_SENSE-útja nem megy.
  (A COMP2 kimenete az L433-on is mehet belül a TIM1 break bemenetére.)
- A debug-UART a PC4/PC5-ön az L433-on **USART3** (az F303-on USART1) – csak firmware.
- 256 KB flash (az F303-é 512 KB) – a CAN-bootloaderhez + két firmware-képhez is elég.

**Modulonként, a mostani rajzokkal:**

| Modul | L433-mal | Mi kellene hozzá |
|---|---|---|
| **Bemeneti** | **változtatás nélkül megy** | – (8 ADC-s bemenet a 12 helyett: IN0–IN7; a IN11–IN15 csak digitális) |
| **Relé** | **egy változtatással** | VIN_SENSE: PB11 → **PB1** (mindkét MCU-n ADC-s: F303 ADC3_IN1, L433 ADC1_IN16; a spec 7. táblája szerint szabad – a rajzon ellenőrizni) |
| **LED** | nem megy | CH4–CH6 új timerre (pl. TIM15 CH1/CH2 a PB14/PB15-ön – mindkettőn megvan – + egy TIM2-csatorna), I_SENSE közös COMP2-bemenetre, a drain-mérés (DS) lábainak átrendezése; a PWM-szinkron és a hardveres lekapcsolás (COMP → break) bonyolultabb |

## Nyitott döntés – D74 (Balázs: „jegyezd fel, este döntök”)
1. **(a) javaslat:** a v1 marad F303-ra tervezve (8 db: 3 modul + 5 tartalék), az L433 a v2. Olcsó kiegészítés most,
   a layout előtt: **VIN_SENSE PB11 → PB1** → a relé- és a bemeneti modul NYÁK-ja már most mindkét MCU-val
   beültethető. A LED-modul marad F303-only.
2. **(b):** most átrakni a teljes lábkiosztást úgy, hogy mindhárom modulra mindkét MCU beültethető legyen (a LED-modul
   PWM- és túláram-útja is) – kb. 1 nap a CubeMX-ellenőrzéssel együtt, a 10-30-i határidő előtt.

## Nyitott – fordított polaritás közös földdel (az LT4320 kapcsán, 2026-10-21) – a layout előtt
- **A probléma:** a D71 óta a busz GND-je minden lap GND-jét összeköti. Ha egy modul (vagy a vezérlő) 24 V-os
  bemenetét fordítva kötik be, a GND-sorkapcsára +24 V kerül, és ez a **busz GND-érén (AWG22, JST-XH 3 A) át
  rövidzár** a vezérlő GND-je, vagyis a táp − pólusa felé. A mostani védelem (LED: LM74700 ideális dióda, relé és
  vezérlő: soros Schottky) a + ágat zárja le, a GND-utat nem. A D65 (10-14) még izolált busszal (ISO1042) készült,
  akkor ez nem jelentett gondot.
- **(a) javaslat:** **N-FET a GND-ágban** minden 24 V-os bemenetű lapon (vezérlő, LED-, relémodul). A gate a +24 V-ról
  kap feszültséget (10 k + 15 V-os Zener), így fordított bekötésnél a FET zárva marad, és a GND-ág nem vezet.
  A LED-modulon egy 20 A-es FET kell (pl. a Q201-gyel azonos NTMFS5C604NL), a másik két lapon egy kis FET – kézből is megoldható: a relémodulon BSS138P (SOT-23) vagy IRFR120N (DPAK) – ott csak ~70 mA folyik, a vezérlőn IRFR1205 (DPAK, 27 mΩ; 12 V-on ~1,2 A folyik).
  Az LM74700 ezután elhagyható.
- **(b):** LT4320 + 4 FET (hídkapcsolás) – a lap bármelyik polaritással működik, de több alkatrész és helyigény.
- **(c):** marad így, csak bekötési szabály és kódolt (polarizált) csatlakozó – olcsó, de a vezeték a dugóban
  így is fordítva köthető.

## Nyitott (nem sürgős)
- RFID-olvasó modul (MFRC522) felvétele a `V2-OTLETEK.md`-be – Balázs még nem válaszolt.
- **25 MHz-es oszcillátor a W5500-hoz** (ISM97, 35 db kézben) a kvarc helyett – a vezérlő rajzán Y1 + 2 kondenzátor
  → oszcillátor-footprint; a layout előtt kellene eldönteni. Javaslat: igen (egy beszerzendő tétellel kevesebb).
- **MCP9701A a LED-modul NTC-je helyett** (lásd a táblázatot) – a layout előtt; javaslat: igen, ha a rajzot úgyis módosítjuk
  (pl. a D74 vagy az oszcillátor miatt), különben marad az NTC.
- Opcionális: a vezérlő JP2/JP3-megoldása (3 padas jumper a transceiver 3-as és 5-ös lábán) a modulmagra is → a
  kézben lévő 86 SN65HVD230 a modulokon is tartalék lenne. A TCAN1044AV a TI-rendelésben van, így ez csak biztosíték.
- **MCP121T-300 a vezérlő EN-lábára** (22 db kézben): egy SOT-23-3-as footprint az RC mellé, beültethető vagy DNP –
  olcsó biztosíték lassú tápfelfutás és tápletörés ellen. Javaslat: igen, ha a vezérlő layoutjában még elfér.
- **Zöld táp-LED-ek a 3,3 V-ról** (modulmag D3, vezérlő D5): a kézben lévő 150 db 522 nm-es zöld LED nyitófeszültsége
  ~2,8–3,2 V, 3,3 V-ról 2,2 k-on át alig világítana. Javaslat: a két LED felső végét a +5V-ra kötni (csak a net változik,
  footprint nem) – a layout előtt. Alternatíva: oda sárgászöld vagy piros LED.
- **TSR 1-2433 mint az LMR36015 tartaléka** a vezérlőn: opcionális SIP-3 footprint (DNP) a 3,3 V-os ágra – ha az LMR36015 nem
  érkezik meg, vagy a VQFN-HR forrasztása nem sikerül. Balázs dönt, a layout előtt; ha nem fér el, vezetékkel is beköthető.
- **TC2117-3.3 az AP2112K helyett** (200 db kézben): modulmag U5 + bemeneti modul U301 → kiesik egy „kínai kör”-ös
  beszerzési tétel (és a szállítási idő kockázata). Ára a nagyobb SOT-223-as footprint. A layout előtt kell eldönteni.

## Források
- [ST STM32_open_pin_data – STM32L433R(B-C)Tx, STM32F303R(D-E)Tx](https://github.com/STMicroelectronics/STM32_open_pin_data)
- [STM32L433RC – ST termékoldal](https://www.st.com/en/product/stm32l433rc)
