Cloudhunter77/szakdolgozat/firmware/matter-c6/matter-qr.png

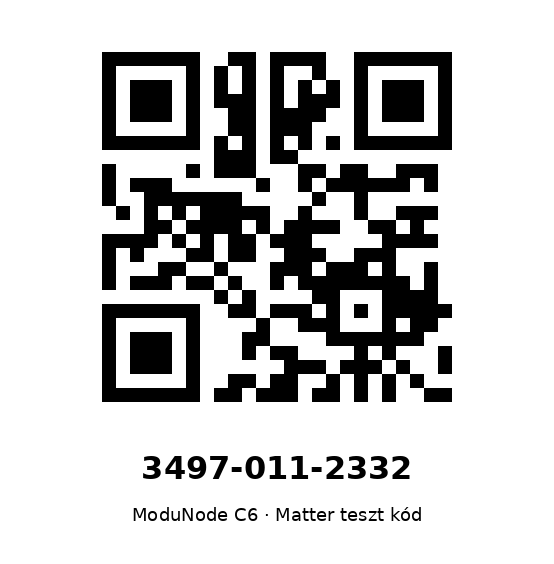
firmware/matter-c6/matter-qr.png
