Cloudhunter77/szakdolgozat/hardware/bom/bemeneti-modul.csv

Jelölés | Érték | Footprint | Db | Megjegyzés
C2 C3 C303 | 10µ | Capacitor_SMD:C_0805_2012Metric | 3 | X7R, 10 V – kerámia,X7R, 10 V – kerámia (az AP2112 stabil vele),X7R, 16 V – a buszról érkező 5 V puffere
C4-C9 C16 C18 C20 C301 C308 C330 | 100n | Capacitor_SMD:C_0603_1608Metric | 12
C10 C11 | 12p | Capacitor_SMD:C_0603_1608Metric | 2 | C = 2 × (CL − 3…5 pF) a választott kvarcból
C13 C19 C21 | 4µ7 | Capacitor_SMD:C_0603_1608Metric | 3
C14 C304 C305 | 1µ | Capacitor_SMD:C_0603_1608Metric | 3
C15 C310-C316 | 10n | Capacitor_SMD:C_0603_1608Metric | 8
C302 | 10µ/10V | Capacitor_SMD:C_0805_2012Metric | 1
D3 | zöld | LED_SMD:LED_0603_1608Metric | 1 | táp-LED: a busz 5 V-ja (HL-PST-1608U51GC, 522 nm)
D4 | piros | LED_SMD:LED_0603_1608Metric | 1 | állapot-LED, a PC13 nyeli
D5 | SMF5.0A | Diode_SMD:D_SOD-123F | 1 | ESD / hot-plug tüskék ellen, a J2/J3 mellé
F301 F302 F305 | PTC 0,2A | Fuse:Fuse_1206_3216Metric | 3 | tartóáram ≈ 0,2 A, ≥ 6 V (pl. Bourns MF-NSMF020)
J1 | DEBUG | Connector_PinHeader_2.54mm:PinHeader_1x07_P2.54mm_Vertical | 1
J2 | BUS_IN | Connector_JST:JST_XH_B4B-XH-A_1x04_P2.50mm_Vertical | 1
J3 | BUS_OUT | Connector_JST:JST_XH_B4B-XH-A_1x04_P2.50mm_Vertical | 1
J301 | IN0 | Connector_JST:JST_PH_B3B-PH-K_1x03_P2.00mm_Vertical | 1 | 1. tápcsoport
J302 | IN1 | Connector_JST:JST_PH_B3B-PH-K_1x03_P2.00mm_Vertical | 1 | 1. tápcsoport
J303 | IN2 | Connector_JST:JST_PH_B3B-PH-K_1x03_P2.00mm_Vertical | 1 | 1. tápcsoport
J304 | IN3 | Connector_JST:JST_PH_B3B-PH-K_1x03_P2.00mm_Vertical | 1 | 1. tápcsoport
J305 | IN4 | Connector_JST:JST_PH_B3B-PH-K_1x03_P2.00mm_Vertical | 1 | 2. tápcsoport
J306 | IN5 | Connector_JST:JST_PH_B3B-PH-K_1x03_P2.00mm_Vertical | 1 | 2. tápcsoport
J307 | IN6 | Connector_JST:JST_PH_B3B-PH-K_1x03_P2.00mm_Vertical | 1 | 2. tápcsoport
J320 | I2C KÜLSŐ | Connector_JST:JST_PH_B4B-PH-K_1x04_P2.00mm_Vertical | 1 | külső HDC3020 / I²C-érzékelő, kábel ≤ 2 m, 100 kHz
JP1 | LEZÁRÁS | Connector_PinHeader_2.54mm:PinHeader_1x02_P2.54mm_Vertical | 1
JP2 JP3 | áthidaló | Jumper:SolderJumper-2_P1.3mm_Bridged_RoundedPad1.0x1.5mm | 2 | alapból zárt; fojtó beültetésekor átvágni
JP301 | CSOPORT 1 | Jumper:SolderJumper-3_P1.3mm_Bridged12_RoundedPad1.0x1.5mm | 1 | 1. csoport tápja: 1–2 = 3,3 V (alap), 2–3 = 5 V
JP302 | CSOPORT 2 | Jumper:SolderJumper-3_P1.3mm_Bridged12_RoundedPad1.0x1.5mm | 1 | 2. csoport tápja: 1–2 = 3,3 V (alap), 2–3 = 5 V
R1 R2 R6 R310-R316 R330-R336 R373 | 10k | Resistor_SMD:R_0603_1608Metric | 18 | BOOT0 lehúzás – normál indulás a flashből,NRST felhúzás (a belső ~40 k mellé, zavarvédelem),felhúzás a csatlakozó oldalán; 12/24 V-os jelnél kivenni,soros: 24 V-os félrekötésnél ~2 mA az ESD-tömbbe (U303–U306), a láb a letörési feszültségén – 12/24 V-os jelhez osztó (68k)
R3 R4 R301 R303 | 10k 1% | Resistor_SMD:R_0603_1608Metric | 4 | HW_REV felső ellenállása mindig 10 k; az alsó adja a revíziót (16 sáv, 0 és 15 fenntartva)
R5 | 120R | Resistor_SMD:R_0805_2012Metric | 1
R8 | 2k2 | Resistor_SMD:R_0603_1608Metric | 1 | A +5V-ról – a kézben lévő zöld LED (522 nm) nyitófeszültsége ~3 V, a 3,3 V-ról alig világítana
R9 | 1k | Resistor_SMD:R_0603_1608Metric | 1
R300 R390 | 0R | Resistor_SMD:R_1206_3216Metric | 2 | 0 Ω – a bemeneti modul teljesen a buszról jár, itt ellenállás nem lehet,0 Ω: V_BUS → +5V – ez a modul nincs leválasztva a busztól (a LED-modulon itt izolált DC-DC van)
R302 | 2k49 1% | Resistor_SMD:R_0603_1608Metric | 1
R304 | 715R 1% | Resistor_SMD:R_0603_1608Metric | 1 | v1 = 1. sáv (0,22 V); csak a felső: 15. sáv = a firmware-ből megadott
R371 R372 | 4k7 | Resistor_SMD:R_0603_1608Metric | 2
R374 R375 | 100R | Resistor_SMD:R_0603_1608Metric | 2
TP1 | BOOT0 | TestPoint:TestPoint_Pad_D1.5mm | 1 | 3V3-ra húzva: ROM-bootloader – a USART-jai nem a J1-en vannak (AN2606; a PC4/PC5 a USART3, F303-on USART1); a programozás SWD-n
TP2 | 3V3 | TestPoint:TestPoint_Pad_D1.5mm | 1
U2 | CA-IS3052G | Package_SO:SOIC-8_7.5x5.85mm_P1.27mm | 1 | VCC1 = +3V3 (modul-oldal), VCC2 = V_BUS (busz-oldal, 4,5–5,5 V); lábkompatibilis: TI ISO1042BDWVR (a CA-IS3050G nem!). A LED-modulon leválaszt, a relé- és a bemeneti modulon a két oldal 0 Ω-mal össze van kötve
U3 | ESD2CAN24-Q1 | Package_TO_SOT_SMD:SOT-23 | 1
U5 U301 | AP2112K-3.3TRG1 | Package_TO_SOT_SMD:SOT-23-5 | 2 | 600 mA, ejtés ~0,25 V; bemenet abs. max. 6,5 V,600 mA, kis ejtésű; csak az érzékelőknek – az MCU 3,3 V-ja a modulmag U5-je
U6 | STM32L433RCT3 | Package_QFP:LQFP-64_10x10mm_P0.5mm | 1 | 75 db kézben, −40…125 °C, MSL3 – reflow előtt kisütni; tartalék: STM32F303RET6 (a LED-modulon nem)
U302 | HDC3020DEFR | modularis:TI_WSON-8-1EP_2.5x2.5mm_DEF0008A | 1 | a ház belsejének klímáját méri (elosztószekrény), nem a szobáét – szobához a külső I²C-érzékelő; cím 0x44, a külső ne legyen 0x44
U303 U304 U307 | TPD4E05U06DQAR | Package_SON:USON-10_2.5x1.0mm_P0.5mm | 3
Y1 | 8MHz | Crystal:Crystal_SMD_3225-4Pin_3.2x2.5mm | 1 | 3TJ480000JWLAC (LCSC C3031779) – CL = 10 pF, ESR ≤ 120 Ω (HSE gm-tartalék ~7)
