Cloudhunter77/szakdolgozat/hardware/bom/beszerzes.csv

Forrás | Kód | Termék | Kell | Vesz | Egységár | Összesen | Készlet | Mire | Megjegyzés | Link | Alternatíva
LCSC | C151133 | 0466.500NRHF – -55℃~+90℃ 0.006 1.6mm 3.2mm 500mA 50A 63V 63V Surface Mount Fuse 1206 Disposable fuses ROHS | 1 | 2 | 32.8 | 66 | LCSC: 234091 db | 0,5A ×1 (rele-modul F100) |  | https://www.lcsc.com/product-detail/C151133.html
LCSC | C49652988 | GR0603F0RT5G00 – -55℃~+155℃ 0Ω 100mW 75V Thick Film Resistor ±1% 0603 Chip Resistor - Surface Mount ROHS | 2 | 10 | 0.6 | 6 | LCSC: 29632 db | 0R ×2 (vezerlo R19 R43) |  | https://www.lcsc.com/product-detail/C49652988.html | Hestore 100.436.34: 101 Ft
LCSC | C54921387 | HRC1206F0000HNTN – 0Ω 250mW Thick Film Resistor ±1% 1206 Chip Resistor - Surface Mount ROHS | 4 | 10 | 1.7 | 17 | LCSC: 1292918 db | 0R ×4 (rele-modul R100 R113, bemeneti-modul R300 R390) |  | https://www.lcsc.com/product-detail/C54921387.html | Hestore 100.013.21: 101 Ft
LCSC | C3016170 | SCR0603F1K02 – -55℃~+155℃ 1.02kΩ 100mW 75V Thick Film Resistor ±1% ±100ppm/℃ 0603 Chip Resistor - Surface Mount ROHS | 1 | 10 | 0.5 | 5 | LCSC: 46 db | 1,02k 1% ×1 (vezerlo R12) |  | https://www.lcsc.com/product-detail/C3016170.html
LCSC | C177652 | RCT03100RFLF – -55℃~+155℃ 100mW 100Ω 75V Thick Film Resistor ±1% ±100ppm/℃ 0603 Chip Resistor - Surface Mount ROHS | 2 | 10 | 0.7 | 7 | LCSC: 54163 db | 100R ×2 (bemeneti-modul R374 R375) |  | https://www.lcsc.com/product-detail/C177652.html | Hestore 100.514.17: 123 Ft
LCSC | C177608 | RCT03100KFLF – -55℃~+155℃ 100kΩ 100mW 75V Thick Film Resistor ±1% ±100ppm/℃ 0603 Chip Resistor - Surface Mount ROHS | 5 | 10 | 0.7 | 7 | LCSC: 765056 db | 100k 1% ×2 (vezerlo R3 R54); 100k ×3 (vezerlo R10 R13, led-modul R203) |  | https://www.lcsc.com/product-detail/C177608.html | Hestore 100.433.66: 96 Ft
LCSC | C30926 | 0603B104K500NT – 100nF 50V X7R ±10% 0603 Multilayer Ceramic Capacitors MLCC - SMD/SMT ROHS | 61 | 74 | 2.7 | 200 | LCSC: 1619511 db | 100n ×61 (vezerlo C3 C7 C14 C23 C24 C27 C31-C37 C42 C44-C46 C55, led-modul C4-C9 C16 C18 C20 C201 C207 C211 C213 C215 C240 C242 C243 C290 C295, rele-modul C4-C9 C16 C18 C20 C101 C106 C107, bemeneti-modul C4-C9 C16 C18 C20 C301 C308 C330) |  | https://www.lcsc.com/product-detail/C30926.html | Hestore 100.243.56: 645 Ft
LCSC | C44479 | 0451010.MRL – -55℃~+125℃ 10A 125V 125V 2.5mm 26.46 35A、50A 6.1mm Surface Mount Fuse 2410 Disposable fuses ROHS | 3 | 4 | 108.7 | 435 | LCSC: 28908 db | 10A ×3 (led-modul F202-F204) | D76: a szalaghoz kisebb is (0451004.MRL, 4 A) | https://www.lcsc.com/product-detail/C44479.html
LCSC | C177661 | RCT0310RFLF – -55℃~+155℃ 100mW 10Ω 75V Thick Film Resistor ±1% ±200ppm/℃ 0603 Chip Resistor - Surface Mount ROHS | 7 | 10 | 0.7 | 7 | LCSC: 891185 db | 10R 1% ×1 (vezerlo R24); 10R ×6 (led-modul R211-R216) |  | https://www.lcsc.com/product-detail/C177661.html | Hestore 100.494.31: 115 Ft
LCSC | C702829 | RCT0510KFLF – -55℃~+155℃ 10kΩ 125mW 150V Thick Film Resistor ±1% ±100ppm/℃ 0805 Chip Resistor - Surface Mount ROHS | 10 | 12 | 1.3 | 15 | LCSC: 224533 db | 10k ×10 (led-modul R251-R256, rele-modul R103-R106) |  | https://www.lcsc.com/product-detail/C702829.html | Hestore 100.403.38: 121 Ft
LCSC | C25804 | 0603WAF1002T5E – -55℃~+155℃ 100mW 10kΩ 75V Thick Film Resistor ±1% ±100ppm/℃ 0603 Chip Resistor - Surface Mount ROHS | 64 | 77 | 0.7 | 56 | LCSC: 36871881 db | 10k ×52 (vezerlo R2 R15-R18 R34-R38 R56, led-modul R1 R2 R6 R204 R221-R226 R241-R246 R291 R294, rele-modul R1 R2 R6 R112 R114, bemeneti-modul R1 R2 R6 R310-R316 R330-R336 R373); 10k 1% ×12 (led-modul R3 R4 R201 R295, rele-modul R3 R4 R101 R115, bemeneti-modul R3 R4 R301 R303) |  | https://www.lcsc.com/product-detail/C25804.html | Hestore 100.239.10: 389 Ft
LCSC | C100042 | CC0603KRX7R9BB103 – 10nF 50V X7R ±10% 0603 Multilayer Ceramic Capacitors MLCC - SMD/SMT ROHS | 19 | 23 | 2.4 | 56 | LCSC: 1785670 db | 10n ×19 (vezerlo C16 C17 C30, led-modul C15 C231-C236, rele-modul C15, bemeneti-modul C15 C310-C316) |  | https://www.lcsc.com/product-detail/C100042.html | Hestore 100.277.91: 325 Ft
LCSC | C1713 | CL21A106KOQNNNE – 10uF 16V X5R ±10% 0805 Multilayer Ceramic Capacitors MLCC - SMD/SMT ROHS | 12 | 15 | 18.1 | 272 | LCSC: 756617 db | 10µ/16V ×1 (vezerlo C25); 10µ ×10 (vezerlo C38 C39, led-modul C2 C3 C217, rele-modul C2 C3, bemeneti-modul C2 C3 C303); 10µ/10V ×1 (bemeneti-modul C302) |  | https://www.lcsc.com/product-detail/C1713.html | Hestore 100.344.52: 588 Ft
LCSC | C9807 | CL31A106KAHNNNE – 10uF 25V X5R ±10% 1206 Multilayer Ceramic Capacitors MLCC - SMD/SMT ROHS | 1 | 10 | 23.9 | 239 | LCSC: 528957 db | 10µ/25V ×1 (led-modul C209) |  | https://www.lcsc.com/product-detail/C9807.html
LCSC | C172721 | C1210X106K050T – 10uF 50V X7R ±10% 1210 Multilayer Ceramic Capacitors MLCC - SMD/SMT ROHS | 6 | 10 | 102.0 | 1020 | LCSC: 5113 db | 10µ/50V ×6 (vezerlo C2 C4, led-modul C204-C206, rele-modul C104) |  | https://www.lcsc.com/product-detail/C172721.html | Hestore 100.383.74: 2110 Ft
LCSC | C22356561 | RCA0312K4FLF – -55℃~+155℃ 100mW 12.4kΩ 75V Thick Film Resistor ±1% ±100ppm/℃ 0603 Chip Resistor - Surface Mount ROHS | 1 | 10 | 0.5 | 5 | LCSC: 54428 db | 12,4k 1% ×1 (vezerlo R40) |  | https://www.lcsc.com/product-detail/C22356561.html | Hestore 100.494.35: 167 Ft
LCSC | C5140933 | SC0805F1200F4ANRH – -55℃~+155℃ 120Ω 125mW 150V Thick Film Resistor ±1% ±100ppm/℃ 0805 Chip Resistor - Surface Mount ROHS | 4 | 10 | 0.8 | 8 | LCSC: 12 db | 120R ×4 (vezerlo R25, led-modul R5, rele-modul R5, bemeneti-modul R5) |  | https://www.lcsc.com/product-detail/C5140933.html | Hestore 100.277.57: 100 Ft
LCSC | C482468 | HGC0603G0120J500NTHJ – 12pF 50V C0G ±5% 0603 Multilayer Ceramic Capacitors MLCC - SMD/SMT ROHS | 8 | 10 | 1.7 | 17 | LCSC: 17 db | 12p ×8 (vezerlo C40 C41, led-modul C10 C11, rele-modul C10 C11, bemeneti-modul C10 C11) |  | https://www.lcsc.com/product-detail/C482468.html
LCSC | C328337 | AECR0603F150KK9 – -55℃~+155℃ 100mW 150kΩ 50V Thick Film Resistor ±1% ±100ppm/℃ 0603 Chip Resistor - Surface Mount ROHS | 3 | 10 | 0.3 | 3 | LCSC: 17 db | 150k ×3 (vezerlo R1, led-modul R290, rele-modul R111) |  | https://www.lcsc.com/product-detail/C328337.html | Hestore 100.494.38: 102 Ft
LCSC | C177649 | RCT031KFLF – -55℃~+155℃ 100mW 1kΩ 75V Thick Film Resistor ±1% ±100ppm/℃ 0603 Chip Resistor - Surface Mount ROHS | 5 | 10 | 0.7 | 7 | LCSC: 395447 db | 1k ×5 (led-modul R9 R205 R207, rele-modul R9, bemeneti-modul R9) |  | https://www.lcsc.com/product-detail/C177649.html | Hestore 100.494.34: 104 Ft
LCSC | C100784 | CR0603FA1541G – -55℃~+125℃ 1.54kΩ 100mW 50V Thick Film Resistor ±1% ±100ppm/℃ 0603 Chip Resistor - Surface Mount ROHS | 1 | 10 | 0.5 | 5 | LCSC: 12 db | 1k54 1% ×1 (rele-modul R102) |  | https://www.lcsc.com/product-detail/C100784.html
LCSC | C349181 | ECSR2512FR001K9 – 1mΩ 3W Current Sense Resistor ±1% ±100ppm/℃ 2512 Current Sense Resistors / Shunt Resistors ROHS | 1 | 2 | 19.2 | 38 | LCSC: 7966 db | 1m 1% ×1 (led-modul R209) | 2 kivezetésű 2512 – a Kelvin-footprint két-két padját összeforrasztja | https://www.lcsc.com/product-detail/C349181.html | Hestore 100.370.11: 639 Ft
LCSC | C77438 | 0603B102K101CT – 100V 1nF X7R ±10% 0603 Multilayer Ceramic Capacitors MLCC - SMD/SMT ROHS | 1 | 10 | 2.4 | 24 | LCSC: 77169 db | 1n ×1 (led-modul C241) |  | https://www.lcsc.com/product-detail/C77438.html | Hestore 100.277.92: 118 Ft
LCSC | C23631 | CC1206KKX7RDBB102 – 1nF 2kV X7R ±10% 1206 Multilayer Ceramic Capacitors MLCC - SMD/SMT ROHS | 1 | 10 | 9.9 | 99 | LCSC: 1629239 db | 1n/2kV ×1 (vezerlo C20) |  | https://www.lcsc.com/product-detail/C23631.html
LCSC | C89188 | 0603X105K160NT – 16V 1uF X5R ±10% 0603 Multilayer Ceramic Capacitors MLCC - SMD/SMT ROHS | 11 | 14 | 5.1 | 71 | LCSC: 7398 db | 1µ/16V ×2 (vezerlo C8 C54); 1µ ×9 (vezerlo C15 C21 C22 C43, led-modul C14, rele-modul C14, bemeneti-modul C14 C304 C305) |  | https://www.lcsc.com/product-detail/C89188.html | Hestore 100.360.59: 270 Ft
LCSC | C146681 | FS21X105K250ECG – 1uF 25V X7R ±10% 0805 Multilayer Ceramic Capacitors MLCC - SMD/SMT ROHS | 3 | 10 | 6.2 | 62 | LCSC: 10 db | 1µ/25V ×3 (led-modul C210 C212 C214) |  | https://www.lcsc.com/product-detail/C146681.html | Hestore 100.277.53: 369 Ft
LCSC | C28323 | CL21B105KBFNNNE – 1uF 50V X7R ±10% 0805 Multilayer Ceramic Capacitors MLCC - SMD/SMT ROHS | 1 | 10 | 14.3 | 143 | LCSC: 2078219 db | 1µ/50V ×1 (led-modul C208) |  | https://www.lcsc.com/product-detail/C28323.html | Hestore 100.330.68: 196 Ft
LCSC | C3152135 | SC0603F2201F2BNRH – -55℃~+155℃ 100mW 2.2kΩ 75V Thick Film Resistor ±1% ±100ppm/℃ 0603 Chip Resistor - Surface Mount ROHS | 5 | 10 | 0.5 | 5 | LCSC: 11 db | 2,2k ×2 (vezerlo R30 R44); 2k2 ×3 (led-modul R8, rele-modul R8, bemeneti-modul R8) |  | https://www.lcsc.com/product-detail/C3152135.html | Hestore 100.368.42: 96 Ft
LCSC | C3016249 | SCR0603F200R – -55℃~+155℃ 100mW 200Ω 75V Thick Film Resistor ±1% ±100ppm/℃ 0603 Chip Resistor - Surface Mount ROHS | 1 | 10 | 0.5 | 5 | LCSC: 49 db | 200R ×1 (led-modul R208) |  | https://www.lcsc.com/product-detail/C3016249.html | Hestore 100.514.18: 116 Ft
LCSC | C178980 | 0451020.MRL – -55℃~+125℃ 100A、150A 154 2.5mm 20A 6.1mm 65V 65V Surface Mount Fuse 2410 Disposable fuses ROHS | 1 | 2 | 172.8 | 346 | LCSC: 25405 db | 20A ×1 (led-modul F201) | D99: F201 – 20 A, a 75 %-os szabállyal tartósan 15 A | https://www.lcsc.com/product-detail/C178980.html
LCSC | C344195 | TCC0603X7R224K500CT – 220nF 50V X7R ±10% 0603 Multilayer Ceramic Capacitors MLCC - SMD/SMT ROHS | 3 | 10 | 5.9 | 59 | LCSC: 1210160 db | 220n/50V ×3 (vezerlo C5 C6 C53) |  | https://www.lcsc.com/product-detail/C344195.html
LCSC | C54920884 | HRC0603F22R0ENTN – -55℃~+155℃ 100mW 22Ω 50V Thick Film Resistor ±1% ±200ppm/℃ 0603 Chip Resistor - Surface Mount ROHS | 2 | 10 | 0.5 | 5 | LCSC: 407752 db | 22R ×2 (vezerlo R26 R27) |  | https://www.lcsc.com/product-detail/C54920884.html | Hestore 100.239.27: 96 Ft
LCSC | C103416 | RTT032202FTP – -55℃~+155℃ 100mW 22kΩ 75V Thick Film Resistor ±1% ±100ppm/℃ 0603 Chip Resistor - Surface Mount ROHS | 1 | 10 | 0.6 | 6 | LCSC: 21 db | 22k ×1 (vezerlo R14) |  | https://www.lcsc.com/product-detail/C103416.html | Hestore 100.238.90: 15 Ft
LCSC | C282677 | TCC0603X7R223K500CT – 22nF 50V X7R ±10% 0603 Multilayer Ceramic Capacitors MLCC - SMD/SMT ROHS | 2 | 10 | 2.6 | 26 | LCSC: 43387 db | 22n ×2 (vezerlo C18 C60) |  | https://www.lcsc.com/product-detail/C282677.html | Hestore 100.277.96: 280 Ft
LCSC | C465158 | HGC0603G0220J500NTHJ – 22pF 50V C0G ±5% 0603 Multilayer Ceramic Capacitors MLCC - SMD/SMT ROHS | 1 | 10 | 1.7 | 17 | LCSC: 13 db | 22p ×1 (vezerlo C9) |  | https://www.lcsc.com/product-detail/C465158.html | Hestore 100.277.87: 118 Ft
LCSC | C29277 | CL21A226MPQNNNE – 10V 22uF X5R ±20% 0805 Multilayer Ceramic Capacitors MLCC - SMD/SMT ROHS | 1 | 10 | 18.7 | 187 | LCSC: 465916 db | 22µ ×1 (vezerlo C26) |  | https://www.lcsc.com/product-detail/C29277.html | Hestore 100.494.25: 885 Ft
LCSC | C5672 | CL31A226KPHNNNE – 10V 22uF X5R ±10% 1206 Multilayer Ceramic Capacitors MLCC - SMD/SMT ROHS | 8 | 10 | 39.1 | 391 | LCSC: 86848 db | 22µ ×7 (vezerlo C10-C12 C56-C59); 22µ/10V ×1 (vezerlo C13) |  | https://www.lcsc.com/product-detail/C5672.html
LCSC | C168293 | WR06X2372FTL – -55℃~+155℃ 100mW 23.7kΩ 75V Thick Film Resistor ±1% ±100ppm/℃ 0603 Chip Resistor - Surface Mount ROHS | 1 | 10 | 0.3 | 3 | LCSC: 18 db | 23,7k 1% ×1 (vezerlo R55) |  | https://www.lcsc.com/product-detail/C168293.html
LCSC | C711349 | DG128-5.0-02P-14-00A(H) – -40℃~+105℃ 1 12~30 1x2P 2 2.5 20A 2P 300V 5mm Green Through Hole 插件,P=5mm Screw Terminal Blocks ROHS | 3 | 4 | 121.9 | 488 | LCSC: 16068 db | 24V IN ×2 (vezerlo J1, rele-modul J100); 24V IN 15A ×1 (led-modul J201) | Degson DG128, 15 A UL / 18 A IEC (J1, J100, J201 – D85) | https://www.lcsc.com/product-detail/C711349.html | Hestore 100.433.73: 808 Ft
LCSC | C2901684 | SX3B25.000F1010F30 – -40℃~+85℃ 10pF 25MHz 30Ω Crystal Oscillator ±10ppm ±30ppm SMD3225-4P Crystals ROHS | 1 | 2 | 39.6 | 79 | LCSC: 8031 db | 25MHz ±30ppm ×1 (vezerlo Y1) | CL = 10 pF, ESR ≤ 30 Ω (W5500) → C40/C41 = 12 pF | https://www.lcsc.com/product-detail/C2901684.html
LCSC | C3105 | 0466002.NRHF – -55℃~+90℃ 0.2326 1.6mm 2A 3.2mm 50A 63V 63V Surface Mount Fuse 1206 Disposable fuses ROHS | 1 | 2 | 33.2 | 66 | LCSC: 68544 db | 2A ×1 (vezerlo F1) |  | https://www.lcsc.com/product-detail/C3105.html
LCSC | C22356472 | RCA032K49FLF – -55℃~+155℃ 100mW 2.49kΩ 75V Thick Film Resistor ±1% ±100ppm/℃ 0603 Chip Resistor - Surface Mount ROHS | 1 | 10 | 0.6 | 6 | LCSC: 121396 db | 2k49 1% ×1 (bemeneti-modul R302) |  | https://www.lcsc.com/product-detail/C22356472.html
LCSC | C328355 | AECR0603F330RK9 – -55℃~+155℃ 100mW 330Ω 50V Thick Film Resistor ±1% ±100ppm/℃ 0603 Chip Resistor - Surface Mount ROHS | 2 | 10 | 0.4 | 4 | LCSC: 19 db | 330R ×2 (vezerlo R41 R42) |  | https://www.lcsc.com/product-detail/C328355.html | Hestore 100.238.83: 101 Ft
LCSC | C101043 | CR0603FA4322G – -55℃~+125℃ 100mW 43.2kΩ 50V Thick Film Resistor ±1% ±100ppm/℃ 0603 Chip Resistor - Surface Mount ROHS | 1 | 10 | 0.5 | 5 | LCSC: 2901 db | 43,2k 1% ×1 (vezerlo R4) |  | https://www.lcsc.com/product-detail/C101043.html
LCSC | C54920920 | HRC0603F4703ENTN – -55℃~+155℃ 100mW 470kΩ 50V Thick Film Resistor ±1% ±100ppm/℃ 0603 Chip Resistor - Surface Mount ROHS | 6 | 10 | 0.5 | 5 | LCSC: 69183 db | 470k ×6 (led-modul R261-R266) |  | https://www.lcsc.com/product-detail/C54920920.html | Hestore 100.239.41: 15 Ft
LCSC | C51904474 | ERG50V470M10X20 – -40℃~+105℃ 1.56A@100kHz 10mm 20mm 3000hrs@105℃ 43mΩ@100kHz 470uF 50V 5mm Polarized ±20% Plugin,D10xL20mm Aluminum Electr | 1 | 2 | 75.1 | 150 | LCSC: 25718 db | 470µ/50V ×1 (led-modul C203) | D99: low-ESR, 1,56 A @ 100 kHz (nem polimer – az ESR csillapít); Ø10 × 20 mm | https://www.lcsc.com/product-detail/C51904474.html
LCSC | C103657 | RTT034702FTP – -55℃~+155℃ 100mW 47kΩ 75V Thick Film Resistor ±1% ±100ppm/℃ 0603 Chip Resistor - Surface Mount ROHS | 1 | 10 | 0.7 | 7 | LCSC: 199 db | 47k ×1 (vezerlo R11) |  | https://www.lcsc.com/product-detail/C103657.html | Hestore 100.239.01: 96 Ft
LCSC | C970679 | RVT1H470M0607 47UF 50V – -55℃~+105℃ 2800hrs@105℃ 47uF 50V 6.3mm 66mA@120Hz 7.7mm ±20% SMD,D6.3xL7.7mm Aluminum Electrolytic Capacitors - SMD ROHS | 2 | 3 | 17.1 | 51 | LCSC: 38035 db | 47µ/50V ×2 (vezerlo C1, rele-modul C105) |  | https://www.lcsc.com/product-detail/C970679.html
LCSC | C168328 | WR06X4990FTL – -55℃~+155℃ 100mW 499Ω 75V Thick Film Resistor ±1% ±100ppm/℃ 0603 Chip Resistor - Surface Mount ROHS | 1 | 10 | 0.4 | 4 | LCSC: 12 db | 499R ×1 (vezerlo R39) |  | https://www.lcsc.com/product-detail/C168328.html
LCSC | C3016250 | SCR0603F49R9 – -55℃~+155℃ 100mW 49.9Ω 75V Thick Film Resistor ±1% ±100ppm/℃ 0603 Chip Resistor - Surface Mount ROHS | 4 | 10 | 0.5 | 5 | LCSC: 515 db | 49R9 ×4 (vezerlo R20-R23) |  | https://www.lcsc.com/product-detail/C3016250.html | Hestore 100.444.61: 116 Ft
LCSC | C177609 | RCT034K7FLF – -55℃~+155℃ 100mW 4.7kΩ 75V Thick Film Resistor ±1% ±100ppm/℃ 0603 Chip Resistor - Surface Mount ROHS | 2 | 10 | 0.7 | 7 | LCSC: 88306 db | 4k7 ×2 (bemeneti-modul R371 R372) |  | https://www.lcsc.com/product-detail/C177609.html | Hestore 100.315.70: 94 Ft
LCSC | C107365 | CL21B475KOFNNNE – 16V 4.7uF X7R ±10% 0805 Multilayer Ceramic Capacitors MLCC - SMD/SMT ROHS | 2 | 10 | 15.6 | 156 | LCSC: 48893 db | 4µ7 ×2 (vezerlo C29, led-modul C216) |  | https://www.lcsc.com/product-detail/C107365.html | Hestore 100.427.11: 268 Ft
LCSC | C167655 | 0603X475M6R3NT – 4.7uF 6.3V X5R ±20% 0603 Multilayer Ceramic Capacitors MLCC - SMD/SMT ROHS | 9 | 11 | 5.3 | 58 | LCSC: 6744 db | 4µ7 ×9 (led-modul C13 C19 C21, rele-modul C13 C19 C21, bemeneti-modul C13 C19 C21) |  | https://www.lcsc.com/product-detail/C167655.html | Hestore 100.371.67: 173 Ft
LCSC | C177641 | RCT035K1FLF – -55℃~+155℃ 100mW 5.1kΩ 75V Thick Film Resistor ±1% ±100ppm/℃ 0603 Chip Resistor - Surface Mount ROHS | 2 | 10 | 0.6 | 6 | LCSC: 80 db | 5,1k ×2 (vezerlo R28 R29) |  | https://www.lcsc.com/product-detail/C177641.html | Hestore 100.365.39: 15 Ft
LCSC | C5140721 | SC0603F5602F2BNRH – -55℃~+155℃ 100mW 56kΩ 75V Thick Film Resistor ±1% ±100ppm/℃ 0603 Chip Resistor - Surface Mount ROHS | 6 | 10 | 0.2 | 2 | LCSC: 19 db | 56k ×6 (led-modul R271-R276) |  | https://www.lcsc.com/product-detail/C5140721.html | Hestore 100.239.37: 15 Ft
LCSC | C123518 | 0603B682K500CT – 50V 6.8nF X7R ±10% 0603 Multilayer Ceramic Capacitors MLCC - SMD/SMT ROHS | 2 | 10 | 2.3 | 23 | LCSC: 39573 db | 6,8n ×2 (vezerlo C19 C61) |  | https://www.lcsc.com/product-detail/C123518.html | Hestore 100.494.21: 202 Ft
LCSC | C207841 | SLO0630H6R8MTT – 4.5A 45mΩ 6.8uH 8A Magnetic Shielded Inductor ±20% SMD,7.3x6.6mm Power Inductors ROHS | 1 | 2 | 49.1 | 98 | LCSC: 4844 db | 6,8µH ×1 (vezerlo L1) |  | https://www.lcsc.com/product-detail/C207841.html | Hestore 100.428.09: 492 Ft
LCSC | C170667 | WR06X7150FTL – -55℃~+155℃ 100mW 715Ω 75V Thick Film Resistor ±1% ±100ppm/℃ 0603 Chip Resistor - Surface Mount ROHS | 4 | 10 | 0.4 | 4 | LCSC: 22 db | 715R 1% ×4 (led-modul R202 R296, rele-modul R116, bemeneti-modul R304) |  | https://www.lcsc.com/product-detail/C170667.html
LCSC | C47327206 | APS0630M8R2A – 5.05A 59.5mΩ 6.05A 8.2uH ±20% SMD,7.7x6.6mm Power Inductors ROHS | 1 | 2 | 59.1 | 118 | LCSC: 6588 db | 8,2µH ×1 (vezerlo L3) |  | https://www.lcsc.com/product-detail/C47327206.html | Hestore 100.428.10: 459 Ft
LCSC | C3031779 | 3TJ480000JWLAC – 10pF 120Ω 8MHz Crystal Oscillator ±20ppm SMD3225-4P Crystals ROHS | 3 | 4 | 94.9 | 379 | LCSC: 1973 db | 8MHz ×3 (led-modul Y1, rele-modul Y1, bemeneti-modul Y1) | CL = 10 pF, ESR ≤ 120 Ω (STM32L4 HSE: gm-tartalék ~7) → a rajz szerinti 12 pF | https://www.lcsc.com/product-detail/C3031779.html | Hestore 100.430.00: 924 Ft
LCSC | C22365427 | AP2112K-3.3TRG1(MS) – -40℃~+125℃@(Tj) 1 2uA 3.3V 320mV@(600mA) 600mA 6V 75dB@(1kHz) Fixed Over Current Protection、Over Temperature Protection、 | 4 | 5 | 36.3 | 182 | LCSC: 42745 db | AP2112K-3.3TRG1 ×4 (led-modul U5, rele-modul U5, bemeneti-modul U5 U301) |  | https://www.lcsc.com/product-detail/C22365427.html | Hestore 100.474.83: 525 Ft
LCSC | C55019941 | B0505S-1WR3 – -40℃~+85℃ 1 1.5kV 10mm 11.5mm 15mA 1W 200mA 2400uF 250kHz 4.5V~5.5V 5V 6mm 80mVp-p 88.3% Short Circuit Protection Unregu | 1 | 2 | 315.0 | 630 | LCSC: 3053 db | B0505S-1WR3 ×1 (led-modul U208) | SIP-4, 1 W; a B1205S / B2405S-1WR3 ugyanerre a footprintre (más buszfeszültséghez) | https://www.lcsc.com/product-detail/C55019941.html
LCSC | C397611 | BAT54WS – -55℃~+125℃ 1V@520mA 200mA 2uA@25V 30V 600mA Independent SOD-323 Schottky Diodes ROHS | 1 | 2 | 5.2 | 10 | LCSC: 2371 db | BAT54HT1G ×1 (vezerlo D9) |  | https://www.lcsc.com/product-detail/C397611.html | Hestore 100.345.67: 217 Ft
LCSC | C474951 | KF128-5.0-3P – -40℃~+105℃ 1 12~22 1x3P 2.5 24A 250V 3 3P 5mm Green Through Hole 插件,P=5mm Screw Terminal Blocks ROHS | 3 | 4 | 111.1 | 444 | LCSC: 9605 db | BLOKK 1 ×1 (led-modul J202); BLOKK 2 ×1 (led-modul J203); BLOKK 3 ×1 (led-modul J204) | KF128-5.0-3P, 10 A (Hestore) / 24 A (LCSC-adat) | https://www.lcsc.com/product-detail/C474951.html | Hestore 100.522.28: 961 Ft
LCSC | C144395 | B4B-XH-A(LF)(SN) – -25℃~+85℃ 1 12.4mm 1x4P 2.5mm 250V 3A 4 4P 5.75mm 7mm Brass K Pin PA66 Through Hole Tin UL94V-0 White XH 插件,P=2.5mm Wire | 8 | 9 | 26.1 | 235 | LCSC: 595483 db | BUS (XH) ×2 (vezerlo J2 J3); BUS_IN ×3 (led-modul J2, rele-modul J2, bemeneti-modul J2); BUS_OUT ×3 (led-modul J3, rele-modul J3, bemeneti-modul J3) |  | https://www.lcsc.com/product-detail/C144395.html | Hestore 100.415.51: 947 Ft
LCSC | C571376 | BZT52C15 – 1 Independent 100nA@10.5V 13.8V~15.6V 15V 200Ω 30Ω 500mW SOD-123 Zener Diodes ROHS | 4 | 5 | 5.6 | 28 | LCSC: 2988 db | BZT52C15 ×4 (vezerlo D12, led-modul D202, rele-modul D106 D107) |  | https://www.lcsc.com/product-detail/C571376.html | Hestore 100.399.13: 281 Ft
LCSC | C51940127 | XY-B3B-PH-K-S – -25℃~+85℃ 1 1x3P 250V 2A 2mm 3 3P Brass PA66 Surface Mount, Right Angle Tin UL94V-0 White SMD,P=2mm,卧贴 Wire To Board Con | 8 | 9 | 13.0 | 117 | LCSC: 16 db | BŐVÍTŐ ×1 (vezerlo J8); IN0 ×1 (bemeneti-modul J301); IN1 ×1 (bemeneti-modul J302); IN2 ×1 (bemeneti-modul J303); IN3 ×1 (bemeneti-modul J304); IN4 ×1 (bemeneti-modul J305); IN5 ×1 (bemeneti-modul J306); IN6 ×1 (bemeneti-modul J307) |  | https://www.lcsc.com/product-detail/C51940127.html | Hestore 100.491.14: 692 Ft
LCSC | C528764 | CA-IS3052G – -40℃~+125℃ 150kV/us 1Mbps 5000 Bus Fault Detection and Protection、Fail-safe SOIC-8-300mil Isolated CAN Transceivers ROHS | 3 | 4 | 540.0 | 2160 | LCSC: 6330 db | CA-IS3052G ×3 (led-modul U2, rele-modul U2, bemeneti-modul U2) | lábkompatibilis: TI ISO1042BDWVR (LCSC C484409, ~6000 Ft/db) – a CA-IS3050G NEM | https://www.lcsc.com/product-detail/C528764.html
LCSC | C53200710 | XY-PZ254V-11-40P – -40℃~+105℃ 1 1x40P 2.54mm 2.5mm 3A 3mm 40P 6mm Black Brass Gold Pin Header Through Hole 弯插,P=2.54mm Pin Headers ROHS | 8 | 2 | 94.0 | 188 | LCSC: 270 db | DEBUG ×1 (vezerlo J5); LEZÁRÁS ×4 (vezerlo JP1, led-modul JP1, rele-modul JP1, bemeneti-modul JP1); DEBUG ×3 (led-modul J1, rele-modul J1, bemeneti-modul J1) | 40 pólusú, tördelhető (35 tű kell) | https://www.lcsc.com/product-detail/C53200710.html
LCSC | C5366877 | ESP32-C6-WROOM-1-N8 – -40℃~+85℃ -99.2dBm 2.4GHz 20.5dBm 382mA 3V~3.6V 78mA ESP32-C6 On-board PCB Antenna UART、SPI、I2C、I2S、USB SMD,25.5x18mm Wi | 1 | 1 | 1880.9 | 1881 | LCSC: 4219 db | ESP32-C6-WROOM-1-N8 ×1 (vezerlo U4) | 8 MB flash – a firmware 4 MB-ra van beállítva | https://www.lcsc.com/product-detail/C5366877.html | Hestore 100.494.43: 2784 Ft
LCSC | C131334 | B4B-PH-K-S(LF)(SN) – -25℃~+85℃ 1 100V 1x4P 2A 2mm 4 4.5mm 4P 6mm 9.9mm Brass K Pin PA66 PH Through Hole Tin UL94V-0 White 插件,P=2mm Wire To Bo | 1 | 2 | 20.8 | 42 | LCSC: 180572 db | I2C KÜLSŐ ×1 (bemeneti-modul J320) |  | https://www.lcsc.com/product-detail/C131334.html
LCSC | C3235556 | LM66200DRLR – -40℃~+125℃ 1.32uA 1.6V~5.5V 2 74mΩ Reverse current blocking、Over temperature protection、With enable SOT-583 ORing Contro | 1 | 2 | 191.4 | 383 | LCSC: 13129 db | LM66200DRLR ×1 (vezerlo U12) |  | https://www.lcsc.com/product-detail/C3235556.html | Hestore 100.515.66: 403 Ft
LCSC | C841384 | LMR33630ADDAR – -40℃~+125℃@(TJ) 1 1V~24V 24uA 3.8V~36V 3A 400kHz Adjustable Buck Buck Built-in Yes ESOP-8 DC-DC Converters ROHS | 1 | 2 | 336.4 | 673 | LCSC: 34085 db | LMR33630ADDA ×1 (vezerlo U2) |  | https://www.lcsc.com/product-detail/C841384.html
LCSC | C19626999 | MC78L12ACDR2G-HXY – 0℃~+125℃ 1 1.7V 100mA 12V 35V 42dB@(120Hz) 80uV Fixed Over Temperature Protection、Short Circuit Protection Positive SOP- | 1 | 2 | 68.0 | 136 | LCSC: 459 db | MC78L12ACDR2G ×1 (led-modul U205) |  | https://www.lcsc.com/product-detail/C19626999.html
LCSC | C341705 | NCE6080K – -55℃~+175℃ 1 N-channel 110W 210pF 4V 4nF 60V 8.5mΩ@10V 80A 90nC@10V N-Channel TO-252-2L MOSFETs ROHS | 6 | 7 | 154.9 | 1085 | LCSC: 15017 db | NCE6080K ×6 (led-modul Q202-Q207) | D85 – az NTD5C648NL megszűnt | https://www.lcsc.com/product-detail/C341705.html
LCSC | C502993 | NCEP6090AGU – -55℃~+150℃ 1 N-channel 100W 1V 2.8mΩ@10V 23pF 4nF 60V 67nC@30V 90A DFN5X6-8L MOSFETs ROHS | 1 | 2 | 332.7 | 665 | LCSC: 5364 db | NCEP6090AGU ×1 (led-modul Q201) | D85 – az NTMFS5C604NL nem kapható; power-SO8 (5 × 6), az SO-8FL padképére | https://www.lcsc.com/product-detail/C502993.html
LCSC | C561573 | JK-NSMD020-30V – 1.6mm 200mA 3.2mm 30V 40A 460mA 600mW 80ms 1206 Resettable Fuses ROHS | 3 | 4 | 13.4 | 54 | LCSC: 79634 db | PTC 0,2A ×3 (bemeneti-modul F301 F302 F305) |  | https://www.lcsc.com/product-detail/C561573.html | Hestore 100.397.42: 492 Ft
LCSC | C318884 | TS-1187A-B-A-B – -30℃~+85℃ 1.5mm 1.6N 100,000 cycles 12V 5.1mm 5.1mm 50mA Gold No Round Button SPST Surface Mount,Vertical Without Bracke | 2 | 3 | 9.5 | 28 | LCSC: 1180012 db | RESET ×1 (vezerlo SW1); BOOT ×1 (vezerlo SW2) | 5,1 × 5,1-es, 4 lábú (TS4415/PTS525-típus): lábköz 3,7 mm, a TL3342-footprinten jó | https://www.lcsc.com/product-detail/C318884.html | Hestore 100.409.03: 198 Ft
LCSC | C2892469 | KSMBJ28A-E3/52 – -55℃~+150℃ 1 13.3A 1uA 28V 34.4V 45.4V 600W TVS Unidirectional SMB ESD and Surge Protection (TVS/ESD) ROHS | 3 | 4 | 18.1 | 72 | LCSC: 3000 db | SMBJ28A ×3 (vezerlo D2, led-modul D201, rele-modul D105) |  | https://www.lcsc.com/product-detail/C2892469.html
LCSC | C284027 | SMBJ6.0A – -55℃~+150℃ 10.3V 58.25A 6.67V 600W@10/1000us 6V 800uA TVS Unidirectional SMB(DO-214AA) ESD and Surge Protection (TVS/ESD | 1 | 2 | 17.8 | 36 | LCSC: 5823 db | SMBJ6.0A ×1 (vezerlo D10) |  | https://www.lcsc.com/product-detail/C284027.html
LCSC | C2857263 | SMF5.0A – -55℃~+150℃ 1 200W@10/1000us 200uA 21.7A 5V 6.4V 9.2V TVS Unidirectional SOD-123FL ESD and Surge Protection (TVS/ESD) ROH | 5 | 6 | 8.6 | 52 | LCSC: 335626 db | SMF5.0A ×5 (vezerlo D4 D11, led-modul D5, rele-modul D5, bemeneti-modul D5) |  | https://www.lcsc.com/product-detail/C2857263.html | Hestore 100.489.02: 405 Ft
LCSC | C908233 | SS16 – -55℃~+150℃ 100uA@60V 1A 60V 700mV@1A Independent SMA(DO-214AC) Schottky Diodes ROHS | 1 | 2 | 4.5 | 9 | LCSC: 81923 db | SS16 ×1 (vezerlo D8) |  | https://www.lcsc.com/product-detail/C908233.html | Hestore 100.389.74: 125 Ft
LCSC | C5343335 | SS56B – 20uA@60V 5A 60V 700mV@5A Standalone SMB Schottky Diodes ROHS | 6 | 7 | 16.1 | 113 | LCSC: 58272 db | SS56B ×6 (led-modul D211-D216) |  | https://www.lcsc.com/product-detail/C5343335.html
LCSC | C53433007 | SS56C – SMC Schottky Diodes ROHS | 1 | 2 | 22.7 | 45 | LCSC: 2570 db | SS56C ×1 (vezerlo D3) |  | https://www.lcsc.com/product-detail/C53433007.html | Hestore 100.432.11: 317 Ft
LCSC | C2155674 | TPS259531DSGR – -40℃~+125℃@(Tj) 0.75mm 1 2.7V~18V 2mm 2mm 34mΩ Integrated FET Surface Mount WSON-8-EP(2x2) Surge Protection Devices (SPD | 1 | 2 | 400.7 | 801 | LCSC: 2245 db | TPS259531DSGR ×1 (vezerlo U3) |  | https://www.lcsc.com/product-detail/C2155674.html
LCSC | C165948 | TYPE-C-31-M-12 – -30℃~+80℃ 1 10,000 cycles 16P 20V 5A 7.35mm Female Surface Mount, Right Angle Type-C SMD USB Connectors ROHS | 1 | 2 | 85.4 | 171 | LCSC: 332629 db | USB-C 16P ×1 (vezerlo J4) |  | https://www.lcsc.com/product-detail/C165948.html | Hestore 100.502.33: 464 Ft
LCSC | C5180249 | USBLC6-2SC6-ES – -40℃~+85℃ 0.6pF 15V 1uA 2 4.5A 5V 6V 70W@8/20us ESD IEC 61000-4-2 Unidirectional SOT-23-6L ESD and Surge Protection (TVS | 1 | 2 | 13.8 | 28 | LCSC: 4 db | USBLC6-2SC6 ×1 (vezerlo U8) |  | https://www.lcsc.com/product-detail/C5180249.html | Hestore 100.343.99: 272 Ft
LCSC | C32843 | W5500 – -40℃~+85℃ 10BASE-T、100BASE-TX 3.3V 32KB 8 SPI SPI Yes LQFP-48(7x7) Ethernet Controllers ROHS | 1 | 1 | 1292.6 | 1293 | LCSC: 11757 db | W5500 ×1 (vezerlo U5) |  | https://www.lcsc.com/product-detail/C32843.html | Hestore 100.356.22: 1447 Ft
LCSC | C2874885 | WS2812B-V5/W – -40℃~+65℃ 0.6mA 1.57mm 2kHz 5.4mm 5V 5mm 800Kbit/s B:465nm~475nm、R:620nm~630nm、G:515nm~525nm Built-in power-on reset cir | 1 | 2 | 54.9 | 110 | LCSC: 40461 db | WS2812B-V5 ×1 (vezerlo D6) |  | https://www.lcsc.com/product-detail/C2874885.html | Hestore 100.488.41: 253 Ft
LCSC | C100114 | 2.54Short Circuit Cap Closed – 1x2 2.54mm 3A Black Capped Unshrouded P=2.54mm Shunts, Jumpers ROHS | 4 | 5 | 4.3 | 21 | LCSC: 442030 db | jumper a LEZÁRÁS tüskesorokra (JP1) |  | https://www.lcsc.com/product-detail/C100114.html
LCSC | C205445 | ORH-R36A – -25℃~+80℃ 1.6V~2.4V 100mW 120° 20mA 618nm~630nm 630nm 63mcd~210mcd Discrete Diode Orange Red Water Clear 0603 LED Indica | 3 | 4 | 3.0 | 12 | LCSC: 260832 db | piros ×3 (led-modul D4, rele-modul D4, bemeneti-modul D4) |  | https://www.lcsc.com/product-detail/C205445.html | Hestore 100.366.70: 222 Ft
LCSC | C12074 | HR911105A – 0℃~+70℃ 1 Filtered Gold Non-PoE Phosphor bronze RJ45 Jack Right Angle Shielded With LED 插件 Ethernet Connectors / Modular | 1 | 1 | 787.9 | 788 | LCSC: 53688 db | HR911105A ×1 (vezerlo J6) | opcionális (D45) | https://www.lcsc.com/product-detail/C12074.html | Hestore 100.435.64: 1456 Ft
LCSC | C54583245 | XY-PHR-3PJK – P=2mm Housings (Wire To Board / Wire To Wire ) ROHS | 10 | 10 | 3.0 | 30 | LCSC: 1700 db | kábeloldal: PH-ház, 3 pólusú (érzékelőkábelek) | opcionális | https://www.lcsc.com/product-detail/C54583245.html | Hestore 100.406.23: 289 Ft
LCSC | C42422476 | CPHR-4N-JK – -25℃~+85℃ 1 1x4P 2mm 4 Female Non-Latching PA66 PH UL94V-0 White Without Fins P=2mm Housings (Wire To Board / Wire To Wi | 1 | 2 | 4.6 | 9 | LCSC: 3902 db | kábeloldal: PH-ház, 4 pólusú (külső I²C) | opcionális | https://www.lcsc.com/product-detail/C42422476.html | Hestore 100.465.85: 119 Ft
LCSC | C111515 | SPH-002T-P0.5S – 0.05~0.22 0.8mm~1.5mm 24~30 PH Phosphor bronze Tin - Housing Contact ROHS | 34 | 40 | 3.9 | 157 | LCSC: 1748776 db | kábeloldal: PH-érintkező | opcionális | https://www.lcsc.com/product-detail/C111515.html | Hestore 100.385.22: 756 Ft
LCSC | C54110151 | W-XHP-4-J – P=2.5mm Housings (Wire To Board / Wire To Wire ) ROHS | 8 | 8 | 4.3 | 34 | LCSC: 1394 db | kábeloldal: XH-ház a buszkábelekhez (4 kábel × 2 vég) | opcionális | https://www.lcsc.com/product-detail/C54110151.html | Hestore 100.415.45: 543 Ft
LCSC | C140573 | SXH-001T-P0.6 – 0.08~0.33 0.9mm~1.9mm 22~28 Phosphor bronze Tin XH - Housing Contact ROHS | 32 | 40 | 5.9 | 236 | LCSC: 760788 db | kábeloldal: XH-érintkező | opcionális | https://www.lcsc.com/product-detail/C140573.html | Hestore 100.350.76: 1321 Ft
TI-rendelés |  |  | 4 |  |  |  |  | ESD2CAN24-Q1 ×4 (vezerlo U7, led-modul U3, rele-modul U3, bemeneti-modul U3)
TI-rendelés |  |  | 1 |  |  |  |  | HDC3020DEFR ×1 (bemeneti-modul U302) |  |  | ha nem jön: LCSC C7472806 HDC3020DEFR – -40℃~+125℃ 0%RH~100%RH 1.6 – 2308 Ft
TI-rendelés |  |  | 1 |  |  |  |  | INA181A2IDBVR ×1 (led-modul U206) |  |  | ha nem jön: LCSC C53198613 INA181A2IDBVR(LX) – -200mV~3V -40℃~+125℃ – 138 Ft
TI-rendelés |  |  | 1 |  |  |  |  | LMR36015BRNXR ×1 (vezerlo U1) |  |  | ha nem jön: LCSC C1850340 LMR36015BRNXR – -40℃~+150℃@(TJ) 1 1.5A 1 – 2726 Ft
TI-rendelés |  |  | 1 |  |  |  |  | TCAN1044AVDRQ1 ×1 (vezerlo U6) |  |  | ha nem jön: LCSC C3234993 TCAN1044AVDRQ1 – -40℃~+150℃ 1.5uA 4.5V~5 – 396 Ft
TI-rendelés |  |  | 3 |  |  |  |  | TPD4E05U06DQAR ×3 (bemeneti-modul U303 U304 U307) |  |  | ha nem jön: LCSC C5199181 TPD4E05U06DQAR-ES – -40℃~+125℃ 0.6pF 12V – 51 Ft
TI-rendelés |  |  | 3 |  |  |  |  | UCC27524DR ×3 (led-modul U201-U203) |  |  | ha nem jön: LCSC C20623206 UCC27524DR(UMW) – -40℃~+125℃ 1.5mA 15ns – 568 Ft
TI-rendelés |  |  | 1 |  |  |  |  | ULN2803ADWR ×1 (rele-modul U101) |  |  | ha nem jön: LCSC C493377 ULN2803A – -40℃~+85℃ 1.6V 15pF 40V 4mA 5 – 195 Ft
kézben |  |  | 1 |  |  |  |  | 74HCT14D ×1 (vezerlo U9)
kézben |  |  | 1 |  |  |  |  | IRFR1205 ×1 (vezerlo Q1)
kézben |  |  | 1 |  |  |  |  | IRFR120N ×1 (rele-modul Q100)
kézben |  |  | 1 |  |  |  |  | MCP9701AT-E/TT ×1 (led-modul U207)
kézben |  |  | 4 |  |  |  |  | RELÉ 1 ×1 (rele-modul J101); RELÉ 2 ×1 (rele-modul J102); RELÉ 3 ×1 (rele-modul J103); RELÉ 4 ×1 (rele-modul J104) | D83: 5,08 mm-es THT a készletből – a csomagot megnézni (≥ 16 A / 250 V)
kézben |  |  | 4 |  |  |  |  | RTD14024 ×4 (rele-modul K1-K4)
kézben |  |  | 3 |  |  |  |  | STM32L433RCT3 ×3 (led-modul U6, rele-modul U6, bemeneti-modul U6)
kézben |  |  | 20 |  |  |  |  | zöld ×20 (vezerlo D5, led-modul D3 D221-D226 D231-D236, rele-modul D3 D101-D104, bemeneti-modul D3)
később | 100.399.81 | D4MG – Műszerdoboz, DIN sínre, Mód. szám: 4, 71mm, 90.2mm, 57.5mm, szürke, ABS | 4 | 4 | 1928.9 | 7716 | Raktáron > 5; 3 munkanap > 7500 | DIN-ház, 4 M: vezérlő, LED-, relé- és bemeneti modul – D73, D100 |  | https://www.hestore.hu/prod_10039981.html
