Cloudhunter77/szakdolgozat/hardware/bom/led-modul.csv

Jelölés | Érték | Footprint | Db | Megjegyzés
C2 C3 C217 | 10µ | Capacitor_SMD:C_0805_2012Metric | 3 | X7R, 10 V – kerámia (az AP2112 stabil vele),X7R, 16 V – a buszról érkező 5 V puffere
C4-C9 C16 C18 C20 C201 C207 C211 C213 C215 C240 C242 C243 C290 C295 | 100n | Capacitor_SMD:C_0603_1608Metric | 19
C10 C11 | 12p | Capacitor_SMD:C_0603_1608Metric | 2 | C = 2 × (CL − 3…5 pF) a választott kvarcból
C13 C19 C21 | 4µ7 | Capacitor_SMD:C_0603_1608Metric | 3
C14 | 1µ | Capacitor_SMD:C_0603_1608Metric | 1
C15 C231-C236 | 10n | Capacitor_SMD:C_0603_1608Metric | 7
C203 | 470µ/50V | Capacitor_THT:CP_Radial_D10.0mm_P5.00mm | 1 | low-ESR, ≥ 1,5 A ripple 100 kHz-en (pl. ERG50V470M10X20), nem polimer – az ESR csillapítja a bemeneti LC-kört; GND-oldala a sönt ELŐTT
C204-C206 | 10µ/50V | Capacitor_SMD:C_1210_3225Metric | 3 | a FET-ek mellett
C208 | 1µ/50V | Capacitor_SMD:C_0805_2012Metric | 1
C209 | 10µ/25V | Capacitor_SMD:C_1206_3216Metric | 1
C210 C212 C214 | 1µ/25V | Capacitor_SMD:C_0805_2012Metric | 3
C216 | 4µ7 | Capacitor_SMD:C_0805_2012Metric | 1
C241 | 1n | Capacitor_SMD:C_0603_1608Metric | 1
D3 D221-D226 D231-D236 | zöld | LED_SMD:LED_0603_1608Metric | 13 | CH1 gate – előlap, fényvezető,CH1 kimenet (drain) – előlap,CH2 gate – előlap, fényvezető,CH2 kimenet (drain) – előlap,CH3 gate – előlap, fényvezető,CH3 kimenet (drain) – előlap,CH4 gate – előlap, fényvezető,CH4 kimenet (drain) – előlap,CH5 gate – előlap, fényvezető,CH5 kimenet (drain) – előlap,CH6 gate – előlap, fényvezető,CH6 kimenet (drain) – előlap,táp-LED: a busz 5 V-ja (HL-PST-1608U51GC, 522 nm)
D4 | piros | LED_SMD:LED_0603_1608Metric | 1 | állapot-LED, a PC13 nyeli
D5 | SMF5.0A | Diode_SMD:D_SOD-123F | 1 | ESD / hot-plug tüskék ellen, a J2/J3 mellé
D201 | SMBJ28A | Diode_SMD:D_SMB | 1 | TVS a sínen
D202 | BZT52C15 | Diode_SMD:D_SOD-123 | 1 | 15 V – a gate–source ±20 V-os határa alatt tartja (12 V-os tápnál nem vezet)
D211-D216 | SS56B | Diode_SMD:D_SMB | 6 | szabadonfutó, 5 A / 60 V, SMB
F201 | 20A | Fuse:Fuse_Littelfuse-NANO2-451_453 | 1 | Littelfuse 0451020.MRL (NANO² 20 A, 2410, 65 V) – beforrasztott; tartósan legfeljebb a 75 %-a → 15 A
F202-F204 | 10A | Fuse:Fuse_Littelfuse-NANO2-451_453 | 3 | Littelfuse 451/453 NANO² (2410), a szalaghoz választva: a szalag árama legfeljebb a biztosíték 75 %-a. ≤ 100 W-os ághoz 4 A (24 V) / 8 A (12 V) → a szalag ≤ 3 A / 6 A; 10 A-es csatornához 15 A (0451015.MRL)
J1 | DEBUG | Connector_PinHeader_2.54mm:PinHeader_1x07_P2.54mm_Vertical | 1
J2 | BUS_IN | Connector_JST:JST_XH_B4B-XH-A_1x04_P2.50mm_Vertical | 1
J3 | BUS_OUT | Connector_JST:JST_XH_B4B-XH-A_1x04_P2.50mm_Vertical | 1
J201 | 24V IN 15A | TerminalBlock_Phoenix:TerminalBlock_Phoenix_MKDS-1,5-2_1x02_P5.00mm_Horizontal | 1 | csavaros, liftes: Degson DG128-5.0-02P (5,0 mm, 15 A UL / 18 A IEC, 2,5 mm²); barna = +24 V, kék = GND
J202 | BLOKK 1 | TerminalBlock_Phoenix:TerminalBlock_Phoenix_MKDS-1,5-3_1x03_P5.00mm_Horizontal | 1 | 1 = +24 V, 2 = CH1, 3 = CH2; csavaros, KF128-5.0-3P (5,0 mm, 10 A – a blokkbiztosíték ≤ 10 A)
J203 | BLOKK 2 | TerminalBlock_Phoenix:TerminalBlock_Phoenix_MKDS-1,5-3_1x03_P5.00mm_Horizontal | 1 | 1 = +24 V, 2 = CH3, 3 = CH4; csavaros, KF128-5.0-3P (5,0 mm, 10 A – a blokkbiztosíték ≤ 10 A)
J204 | BLOKK 3 | TerminalBlock_Phoenix:TerminalBlock_Phoenix_MKDS-1,5-3_1x03_P5.00mm_Horizontal | 1 | 1 = +24 V, 2 = CH5, 3 = CH6; csavaros, KF128-5.0-3P (5,0 mm, 10 A – a blokkbiztosíték ≤ 10 A)
JP1 | LEZÁRÁS | Connector_PinHeader_2.54mm:PinHeader_1x02_P2.54mm_Vertical | 1
JP2 JP3 | áthidaló | Jumper:SolderJumper-2_P1.3mm_Bridged_RoundedPad1.0x1.5mm | 2 | alapból zárt; fojtó beültetésekor átvágni
Q201 | NCEP6090AGU | Package_SO:ONSemi_SO-8FL_488AA | 1 | NCE 60 V, 2,8 mΩ, DFN5×6 (power-SO8, az SO-8FL padképére; az NTMFS5C604NL nem kapható); D = GND_IN (J201), S = GND
Q202-Q207 | NCE6080K | Package_TO_SOT_SMD:TO-252-2 | 6 | NCE 60 V, 8,5 mΩ @ 10 V, DPAK (az NTD5C648NL megszűnt); 10 A-en ~0,85 W; tartalék: IRFR1205
R1 R2 R6 R204 R221-R226 R241-R246 R291 R294 | 10k | Resistor_SMD:R_0603_1608Metric | 18 | BOOT0 lehúzás – normál indulás a flashből,NRST felhúzás (a belső ~40 k mellé, zavarvédelem),gate a +24V_RAIL-ről (26 V-on ~1,1 mA),gate–source lehúzás
R3 R4 R201 R295 | 10k 1% | Resistor_SMD:R_0603_1608Metric | 4 | HW_REV felső ellenállása mindig 10 k; az alsó adja a revíziót (16 sáv, 0 és 15 fenntartva)
R5 | 120R | Resistor_SMD:R_0805_2012Metric | 1
R8 | 2k2 | Resistor_SMD:R_0603_1608Metric | 1 | A +5V-ról – a kézben lévő zöld LED (522 nm) nyitófeszültsége ~3 V, a 3,3 V-ról alig világítana
R9 R205 R207 | 1k | Resistor_SMD:R_0603_1608Metric | 3 | NE legyen nagyobb: 4,7 k-val ~1,5 V → a driverek engedélyezve lehetnek
R202 R296 | 715R 1% | Resistor_SMD:R_0603_1608Metric | 2 | v1 = 1. sáv (0,22 V); csak a felső: 15. sáv = a firmware-ből megadott
R203 | 100k | Resistor_SMD:R_0603_1608Metric | 1
R208 | 200R | Resistor_SMD:R_0603_1608Metric | 1 | a VOUT nagy kapacitív terhelés esetén soros ellenállást kér
R209 | 1m 1% | Resistor_SMD:R_Shunt_Vishay_WSK2512_6332Metric_T1.19mm | 1 | Bourns CRE2512-FZ-R001E-3 (2512, 3 W; 15 A-en 0,23 W) – 2 kivezetésű: a Kelvin-padokon összeforrasztva
R211-R216 | 10R | Resistor_SMD:R_0603_1608Metric | 6 | gate-ellenállás (élmeredekség, EMC)
R251-R256 | 10k | Resistor_SMD:R_0805_2012Metric | 6
R261-R266 | 470k | Resistor_SMD:R_0603_1608Metric | 6
R271-R276 | 56k | Resistor_SMD:R_0603_1608Metric | 6
R290 | 150k | Resistor_SMD:R_0603_1608Metric | 1 | fordított polaritásnál a Q201 zár, a lap nem kap feszültséget
TP1 | BOOT0 | TestPoint:TestPoint_Pad_D1.5mm | 1 | 3V3-ra húzva: ROM-bootloader – a USART-jai nem a J1-en vannak (AN2606; a PC4/PC5 a USART3, F303-on USART1); a programozás SWD-n
TP2 | 3V3 | TestPoint:TestPoint_Pad_D1.5mm | 1
TP201 | DAC_THR | TestPoint:TestPoint_Pad_D1.5mm | 1 | PA4 = DAC1_OUT1, a COMP2 küszöbe – kívül nincs bekötve
TP202 | I_SENSE | TestPoint:TestPoint_Pad_D1.5mm | 1
U2 | CA-IS3052G | Package_SO:SOIC-8_7.5x5.85mm_P1.27mm | 1 | VCC1 = +3V3 (modul-oldal), VCC2 = V_BUS (busz-oldal, 4,5–5,5 V); lábkompatibilis: TI ISO1042BDWVR (a CA-IS3050G nem!). A LED-modulon leválaszt, a relé- és a bemeneti modulon a két oldal 0 Ω-mal össze van kötve
U3 | ESD2CAN24-Q1 | Package_TO_SOT_SMD:SOT-23 | 1
U5 | AP2112K-3.3TRG1 | Package_TO_SOT_SMD:SOT-23-5 | 1 | 600 mA, ejtés ~0,25 V; bemenet abs. max. 6,5 V
U6 | STM32L433RCT3 | Package_QFP:LQFP-64_10x10mm_P0.5mm | 1 | 75 db kézben, −40…125 °C, MSL3 – reflow előtt kisütni; tartalék: STM32F303RET6 (a LED-modulon nem)
U201-U203 | UCC27524DR | Package_SO:SOIC-8_3.9x4.9mm_P1.27mm | 3
U205 | MC78L12ACDR2G | Package_SO:SOIC-8_3.9x4.9mm_P1.27mm | 1
U206 | INA181A2IDBVR | Package_TO_SOT_SMD:SOT-23-6 | 1
U207 | MCP9701AT-E/TT | Package_TO_SOT_SMD:SOT-23 | 1 | kézben ~21 db; ±2 °C (A); a 100 nF-os terhelés elé 200 Ω soros ellenállás
U208 | B0505S-1WR3 | Converter_DCDC:Converter_DCDC_TRACO_TME_03xxS_05xxS_12xxS_Single_THT | 1
Y1 | 8MHz | Crystal:Crystal_SMD_3225-4Pin_3.2x2.5mm | 1 | 3TJ480000JWLAC (LCSC C3031779) – CL = 10 pF, ESR ≤ 120 Ω (HSE gm-tartalék ~7)
