Cloudhunter77/szakdolgozat/hardware/bom/rele-modul.csv

Jelölés | Érték | Footprint | Db | Megjegyzés
C2 C3 | 10µ | Capacitor_SMD:C_0805_2012Metric | 2 | X7R, 10 V – kerámia (az AP2112 stabil vele),X7R, 16 V – a buszról érkező 5 V puffere
C4-C9 C16 C18 C20 C101 C106 C107 | 100n | Capacitor_SMD:C_0603_1608Metric | 12
C10 C11 | 12p | Capacitor_SMD:C_0603_1608Metric | 2 | C = 2 × (CL − 3…5 pF) a választott kvarcból
C13 C19 C21 | 4µ7 | Capacitor_SMD:C_0603_1608Metric | 3
C14 | 1µ | Capacitor_SMD:C_0603_1608Metric | 1
C15 | 10n | Capacitor_SMD:C_0603_1608Metric | 1
C104 | 10µ/50V | Capacitor_SMD:C_1210_3225Metric | 1
C105 | 47µ/50V | Capacitor_SMD:CP_Elec_6.3x7.7 | 1 | elektrolit: a betápkábel LC-lengését csillapítja (mint a vezérlőn a C1)
D3 D101-D104 | zöld | LED_SMD:LED_0603_1608Metric | 5 | 1. relé BE – előlap, fényvezető alatt,2. relé BE – előlap, fényvezető alatt,3. relé BE – előlap, fényvezető alatt,4. relé BE – előlap, fényvezető alatt,táp-LED: a busz 5 V-ja (HL-PST-1608U51GC, 522 nm)
D4 | piros | LED_SMD:LED_0603_1608Metric | 1 | állapot-LED, a PC13 nyeli
D5 | SMF5.0A | Diode_SMD:D_SOD-123F | 1 | ESD / hot-plug tüskék ellen, a J2/J3 mellé
D105 | SMBJ28A | Diode_SMD:D_SMB | 1 | TVS, 28 V standoff
D106 D107 | BZT52C15 | Diode_SMD:D_SOD-123 | 2 | 15 V – a gate–source-feszültség határa (±20 V) alatt,Tekercs-kioltás a COM-ágban: a kimenet ~24 + 15 V-on fog (26 V-os tápnál ~42 V, az ULN2803A 50 V-os határa alatt) → gyorsabb elengedés, kisebb ív az érintkezőn
F100 | 0,5A | Fuse:Fuse_1206_3216Metric | 1 | ≥ 32 V, gyors, 1206; 4 tekercs × ~17 mA
J1 | DEBUG | Connector_PinHeader_2.54mm:PinHeader_1x07_P2.54mm_Vertical | 1
J2 | BUS_IN | Connector_JST:JST_XH_B4B-XH-A_1x04_P2.50mm_Vertical | 1
J3 | BUS_OUT | Connector_JST:JST_XH_B4B-XH-A_1x04_P2.50mm_Vertical | 1
J100 | 24V IN | TerminalBlock_Phoenix:TerminalBlock_Phoenix_MKDS-1,5-2_1x02_P5.00mm_Horizontal | 1 | Degson DG128-5.0-02P – csavaros, 5,0 mm, 15 A (UL), 2,5 mm²
J101 | RELÉ 1 | TerminalBlock_Phoenix:TerminalBlock_Phoenix_MKDS-3-2-5.08_1x02_P5.08mm_Horizontal | 1 | 1 = COM, 2 = NO; 5,08 mm-es THT sorkapocs a készletből – névleges érték ≥ 16 A, ≥ 250 V AC
J102 | RELÉ 2 | TerminalBlock_Phoenix:TerminalBlock_Phoenix_MKDS-3-2-5.08_1x02_P5.08mm_Horizontal | 1 | 1 = COM, 2 = NO; 5,08 mm-es THT sorkapocs a készletből – névleges érték ≥ 16 A, ≥ 250 V AC
J103 | RELÉ 3 | TerminalBlock_Phoenix:TerminalBlock_Phoenix_MKDS-3-2-5.08_1x02_P5.08mm_Horizontal | 1 | 1 = COM, 2 = NO; 5,08 mm-es THT sorkapocs a készletből – névleges érték ≥ 16 A, ≥ 250 V AC
J104 | RELÉ 4 | TerminalBlock_Phoenix:TerminalBlock_Phoenix_MKDS-3-2-5.08_1x02_P5.08mm_Horizontal | 1 | 1 = COM, 2 = NO; 5,08 mm-es THT sorkapocs a készletből – névleges érték ≥ 16 A, ≥ 250 V AC
JP1 | LEZÁRÁS | Connector_PinHeader_2.54mm:PinHeader_1x02_P2.54mm_Vertical | 1
JP2 JP3 | áthidaló | Jumper:SolderJumper-2_P1.3mm_Bridged_RoundedPad1.0x1.5mm | 2 | alapból zárt; fojtó beültetésekor átvágni
K1-K4 | RTD14024 | Relay_THT:Relay_SPDT_Schrack-RT1-16A-FormC_RM5mm | 4
Q100 | IRFR120N | Package_TO_SOT_SMD:TO-252-2 | 1 | kézben; 100 V, ~0,21 Ω – a tekercsek ~70 mA-jén ~15 mV
R1 R2 R6 R112 R114 | 10k | Resistor_SMD:R_0603_1608Metric | 5 | BOOT0 lehúzás – normál indulás a flashből,NRST felhúzás (a belső ~40 k mellé, zavarvédelem)
R3 R4 R101 R115 | 10k 1% | Resistor_SMD:R_0603_1608Metric | 4 | HW_REV felső ellenállása mindig 10 k; az alsó adja a revíziót (16 sáv, 0 és 15 fenntartva)
R5 | 120R | Resistor_SMD:R_0805_2012Metric | 1
R8 | 2k2 | Resistor_SMD:R_0603_1608Metric | 1 | A +5V-ról – a kézben lévő zöld LED (522 nm) nyitófeszültsége ~3 V, a 3,3 V-ról alig világítana
R9 | 1k | Resistor_SMD:R_0603_1608Metric | 1
R100 R113 | 0R | Resistor_SMD:R_1206_3216Metric | 2 | 0 Ω (a tekercsek kis árama miatt); ha a busz GND-jén hurokáram mérhető: 1 Ω,0 Ω: V_BUS → +5V – ez a modul nincs leválasztva a busztól (a LED-modulon itt izolált DC-DC van)
R102 | 1k54 1% | Resistor_SMD:R_0603_1608Metric | 1 | 24 V-os tekercs: 1,54k (2. sáv); 12 V-os tekercs: 3,65k (4. sáv)
R103-R106 | 10k | Resistor_SMD:R_0805_2012Metric | 4
R111 | 150k | Resistor_SMD:R_0603_1608Metric | 1
R116 | 715R 1% | Resistor_SMD:R_0603_1608Metric | 1 | v1 = 1. sáv (0,22 V); csak a felső: 15. sáv = a firmware-ből megadott
TP1 | BOOT0 | TestPoint:TestPoint_Pad_D1.5mm | 1 | 3V3-ra húzva: ROM-bootloader – a USART-jai nem a J1-en vannak (AN2606; a PC4/PC5 a USART3, F303-on USART1); a programozás SWD-n
TP2 | 3V3 | TestPoint:TestPoint_Pad_D1.5mm | 1
U2 | CA-IS3052G | Package_SO:SOIC-8_7.5x5.85mm_P1.27mm | 1 | VCC1 = +3V3 (modul-oldal), VCC2 = V_BUS (busz-oldal, 4,5–5,5 V); lábkompatibilis: TI ISO1042BDWVR (a CA-IS3050G nem!). A LED-modulon leválaszt, a relé- és a bemeneti modulon a két oldal 0 Ω-mal össze van kötve
U3 | ESD2CAN24-Q1 | Package_TO_SOT_SMD:SOT-23 | 1
U5 | AP2112K-3.3TRG1 | Package_TO_SOT_SMD:SOT-23-5 | 1 | 600 mA, ejtés ~0,25 V; bemenet abs. max. 6,5 V
U6 | STM32L433RCT3 | Package_QFP:LQFP-64_10x10mm_P0.5mm | 1 | 75 db kézben, −40…125 °C, MSL3 – reflow előtt kisütni; tartalék: STM32F303RET6 (a LED-modulon nem)
U101 | ULN2803ADWR | Package_SO:SOIC-18W_7.5x11.6mm_P1.27mm | 1
Y1 | 8MHz | Crystal:Crystal_SMD_3225-4Pin_3.2x2.5mm | 1 | 3TJ480000JWLAC (LCSC C3031779) – CL = 10 pF, ESR ≤ 120 Ω (HSE gm-tartalék ~7)
