Cloudhunter77/szakdolgozat/hardware/bom/vezerlo.csv

Jelölés | Érték | Footprint | Db | Megjegyzés
C1 | 47µ/50V | Capacitor_SMD:CP_Elec_6.3x7.7 | 1 | elektrolit, 105 °C – KÖTELEZŐ: az ESR-je (~0,2–1 Ω) csillapítja a betápkábel LC-lengését; polimer / nagyon kis ESR-ű ne legyen
C2 C4 | 10µ/50V | Capacitor_SMD:C_1210_3225Metric | 2 | CIN az U2 VIN-lábánál; mellette C53 220 nF
C3 C7 C14 C23 C24 C27 C31-C37 C42 C44-C46 C55 | 100n | Capacitor_SMD:C_0603_1608Metric | 18 | AVDD-lábanként,D6 VDD,U9 VCC,VDD (28),a 3V3-lábnál
C5 C6 C53 | 220n/50V | Capacitor_SMD:C_0603_1608Metric | 3 | CHF – közvetlenül a VIN–PGND lábaknál,a 10-es VIN-lábnál,a 2-es VIN-lábnál
C8 C54 | 1µ/16V | Capacitor_SMD:C_0603_1608Metric | 2 | VCC – csak ez a kondenzátor,VCC–AGND, más terhelés nem mehet rá
C9 | 22p | Capacitor_SMD:C_0603_1608Metric | 1 | CFF, R3-mal párhuzamosan (20 pF helyett a kapható 22 pF)
C10-C12 C56-C59 | 22µ | Capacitor_SMD:C_1206_3216Metric | 7 | X7R, 10 V, 1206
C13 | 22µ/10V | Capacitor_SMD:C_1206_3216Metric | 1
C15 C21 C22 C43 | 1µ | Capacitor_SMD:C_0603_1608Metric | 4 | RC-késleltetés az EN-en
C16 C17 C30 | 10n | Capacitor_SMD:C_0603_1608Metric | 3 | a TXB csomópontnál,a WIZnet-referencia C15-je: az RX-lezárás közepe és az RCT, 10 nF a GND-re
C18 C60 | 22n | Capacitor_SMD:C_0603_1608Metric | 2 | dVdt: lassú felfutás, kis bekapcsolási áram
C19 C61 | 6,8n | Capacitor_SMD:C_0603_1608Metric | 2 | soros, a W5500 RX-lába és a MagJack között
C20 | 1n/2kV | Capacitor_SMD:C_1206_3216Metric | 1 | WIZnet-referencia C16: a MagJack árnyékolása és a Bob Smith-lezárás (8-as láb) → 1 nF / 2 kV → GND
C25 | 10µ/16V | Capacitor_SMD:C_0805_2012Metric | 1
C26 | 22µ | Capacitor_SMD:C_0805_2012Metric | 1 | a 3V3-lábnál
C29 | 4µ7 | Capacitor_SMD:C_0805_2012Metric | 1
C38 C39 | 10µ | Capacitor_SMD:C_0805_2012Metric | 2
C40 C41 | 12p | Capacitor_SMD:C_0603_1608Metric | 2 | C = 2 × (CL − 3…5 pF); a CX3225 CL-je 10 pF → 12 pF
D2 | SMBJ28A | Diode_SMD:D_SMB | 1
D3 | SS56C | Diode_SMD:D_SMC | 1 | 60 V-os kell (túlfeszültségnél VIN_BUCK ~45 V, VUSB ~0 V); SS56C: 60 V, 5 A, SMC
D4 D11 | SMF5.0A | Diode_SMD:D_SOD-123F | 2 | USB-bedugáskor a kábel induktivitása miatt túllövés – az LM66200 VIN2-je abs. max. 6 V
D5 | zöld | LED_SMD:LED_0603_1608Metric | 1 | táp-LED
D6 | WS2812B-V5 | LED_SMD:LED_WS2812B_PLCC4_5.0x5.0mm_P3.2mm | 1
D8 | SS16 | Diode_SMD:D_SMA | 1 | az USB ne táplálja vissza a 24 V-os oldalt
D9 | BAT54HT1G | Diode_SMD:D_SOD-323 | 1 | anód az EN-en, katód a GPIO20-on
D10 | SMBJ6.0A | Diode_SMD:D_SMB | 1 | Ha az U2 átüt (24 V a kimenetén), rövidre zár és kiolvasztja az F1-et – az LM66200 (6 V) és a TPS2595 (20 V) védelme
D12 | BZT52C15 | Diode_SMD:D_SOD-123 | 1 | 15 V – a gate–source ±20 V-os határa alatt
F1 | 2A | Fuse:Fuse_1206_3216Metric | 1 | ≥ 32 V, gyors; 12 V-on és 2 A-es buszterhelésnél ~1,2 A
J1 | 24V IN | TerminalBlock_Phoenix:TerminalBlock_Phoenix_MKDS-1,5-2_1x02_P5.00mm_Horizontal | 1 | Degson DG128-5.0-02P – csavaros, 5,0 mm, 15 A (UL), 2,5 mm² (mint a LED-modul J201-e)
J2 J3 | BUS (XH) | Connector_JST:JST_XH_B4B-XH-A_1x04_P2.50mm_Vertical | 2
J4 | USB-C 16P | Connector_USB:USB_C_Receptacle_HRO_TYPE-C-31-M-12 | 1
J5 | DEBUG | Connector_PinHeader_2.54mm:PinHeader_1x06_P2.54mm_Vertical | 1
J6 | HR911105A | Connector_RJ:RJ45_Hanrun_HR911105A_Horizontal | 1 | a lábkiosztást a megvett darab adatlapjából ellenőrizni (TCT és RCT külön lábon)
J8 | BŐVÍTŐ | Connector_JST:JST_PH_B3B-PH-K_1x03_P2.00mm_Vertical | 1 | 1 3V3 · 2 GPIO5 · 3 GND (mint a bemeneti modul PH-i)
JP1 | LEZÁRÁS | Connector_PinHeader_2.54mm:PinHeader_1x02_P2.54mm_Vertical | 1
JP2 | VCC: 1-2=5V / 2-3=3V3 | Jumper:SolderJumper-3_P1.3mm_Bridged12_RoundedPad1.0x1.5mm | 1 | SOHA ne legyen mindkét oldal összeforrasztva!
JP3 | VIO: 1-2=3V3 / 2-3=GND | Jumper:SolderJumper-3_P1.3mm_Bridged12_RoundedPad1.0x1.5mm | 1 | SN65HVD230-nál nyitva
JP4 JP5 | áthidaló | Jumper:SolderJumper-2_P1.3mm_Bridged_RoundedPad1.0x1.5mm | 2 | alapból zárt; fojtó beültetésekor átvágni
L1 | 6,8µH | modularis:L_FerroCore_HPI0630 | 1 | 0630-as árnyékolt, 6,8 µH, Isat ≥ 4,5 A – SLO0630H6R8MTT (LCSC) vagy HPI0630-6R8 (Hestore)
L3 | 8,2µH | modularis:L_FerroCore_HPI0630 | 1 | 0630-as árnyékolt, 8,2 µH, Isat ≥ 3,8 A, ≤ 60 mΩ – APS0630M8R2A (LCSC) vagy HPI0630-8R2 (Hestore)
Q1 | IRFR1205 | Package_TO_SOT_SMD:TO-252-2 | 1 | Polaritásvédelem a GND-ágban; kézben; 55 V, ~27 mΩ (12 V-on ~1,2 A → ~40 mW)
R1 | 150k | Resistor_SMD:R_0603_1608Metric | 1
R2 R15-R18 R34-R38 R56 | 10k | Resistor_SMD:R_0603_1608Metric | 11 | FLT felhúzás (nyitott drain),gate a +24V_P-ről,reset alatt recesszív busz,strapping: letöltéshez GPIO8 = 1
R3 R54 | 100k 1% | Resistor_SMD:R_0603_1608Metric | 2
R4 | 43,2k 1% | Resistor_SMD:R_0603_1608Metric | 1 | → 3,31 V (VFB = 1,0 V)
R10 R13 | 100k | Resistor_SMD:R_0603_1608Metric | 2
R11 | 47k | Resistor_SMD:R_0603_1608Metric | 1
R12 | 1,02k 1% | Resistor_SMD:R_0603_1608Metric | 1 | R = 2000 / (I − 0,04) → 2,0 A
R14 | 22k | Resistor_SMD:R_0603_1608Metric | 1
R19 R43 | 0R | Resistor_SMD:R_0603_1608Metric | 2 | 33 Ω-hoz footprint,STB → normál mód (nyitva készenlét!)
R20-R23 | 49R9 | Resistor_SMD:R_0603_1608Metric | 4 | 1 %
R24 | 10R 1% | Resistor_SMD:R_0603_1608Metric | 1
R25 | 120R | Resistor_SMD:R_0805_2012Metric | 1
R26 R27 | 22R | Resistor_SMD:R_0603_1608Metric | 2 | a C6 közelében
R28 R29 | 5,1k | Resistor_SMD:R_0603_1608Metric | 2
R30 R44 | 2,2k | Resistor_SMD:R_0603_1608Metric | 2 | A +5V-ról – a zöld LED (522 nm) nyitófeszültsége ~3 V,levezető: a D3 szivárgása ne húzza fel a kihúzott aljzat VBUS-át
R39 | 499R | Resistor_SMD:R_0603_1608Metric | 1 | Espressif-ajánlás
R40 | 12,4k 1% | Resistor_SMD:R_0603_1608Metric | 1
R41 R42 | 330R | Resistor_SMD:R_0603_1608Metric | 2 | sárga = aktivitás,zöld = link
R55 | 23,7k 1% | Resistor_SMD:R_0603_1608Metric | 1 | → 5,22 V (VFB = 1,0 V)
SW1 | RESET | Button_Switch_SMD:SW_SPST_TL3342 | 1
SW2 | BOOT | Button_Switch_SMD:SW_SPST_TL3342 | 1
TP1 | +24V_P | TestPoint:TestPoint_Pad_D1.5mm | 1
TP2 | +5V | TestPoint:TestPoint_Pad_D1.5mm | 1
TP3 | +3V3 | TestPoint:TestPoint_Pad_D1.5mm | 1
TP4 | V_BUS | TestPoint:TestPoint_Pad_D1.5mm | 1
TP5 | CAN_H | TestPoint:TestPoint_Pad_D1.5mm | 1
TP6 | CAN_L | TestPoint:TestPoint_Pad_D1.5mm | 1
TP7 | GND | TestPoint:TestPoint_Pad_D1.5mm | 1
U1 | LMR36015BRNXR | modularis:TI_VQFN-HR-12_RNX0012B | 1
U2 | LMR33630ADDA | Package_SO:Texas_HSOP-8-1EP_3.9x4.9mm_P1.27mm_ThermalVias | 1 | 400 kHz; TI 9-2. táblázat (5 V): L 8 µH, 4 × 22 µF, 10 µF + 220 nF
U3 | TPS259531DSGR | Package_SON:Texas_DSG0008A_WSON-8-1EP_2x2mm_P0.5mm_EP0.9x1.6mm | 1 | WSON-8 2 × 2 mm, a PAD a GND-re; abs. max. 20 V
U4 | ESP32-C6-WROOM-1-N8 | modularis:ESP32-C6-WROOM-1 | 1
U5 | W5500 | Package_QFP:LQFP-48_7x7mm_P0.5mm | 1
U6 | TCAN1044AVDRQ1 | Package_SO:SOIC-8_3.9x4.9mm_P1.27mm | 1
U7 | ESD2CAN24-Q1 | Package_TO_SOT_SMD:SOT-23 | 1
U8 | USBLC6-2SC6 | Package_TO_SOT_SMD:SOT-23-6 | 1
U9 | 74HCT14D | Package_SO:SOIC-14_3.9x8.7mm_P1.27mm | 1
U12 | LM66200DRLR | Package_TO_SOT_SMD:SOT-583-8 | 1 | VIN max. 5,5 V (abs. 6 V); a buck 5,2 V-ja 24 V mellett biztosan az USB fölött van
Y1 | 25MHz ±30ppm | Crystal:Crystal_SMD_3225-4Pin_3.2x2.5mm | 1 | SX3B25.000F1010F30 (LCSC C2901684) – CL = 10 pF, ESR ≤ 30 Ω; vagy Kyocera CX3225FB25000F0FZZH1
