Cloudhunter77/szakdolgozat/hardware/bemeneti-modul/bemeneti-modul.kicad_pcb

## KiCad design hardware/bemeneti-modul/bemeneti-modul.kicad_pcb (2026-11-06)

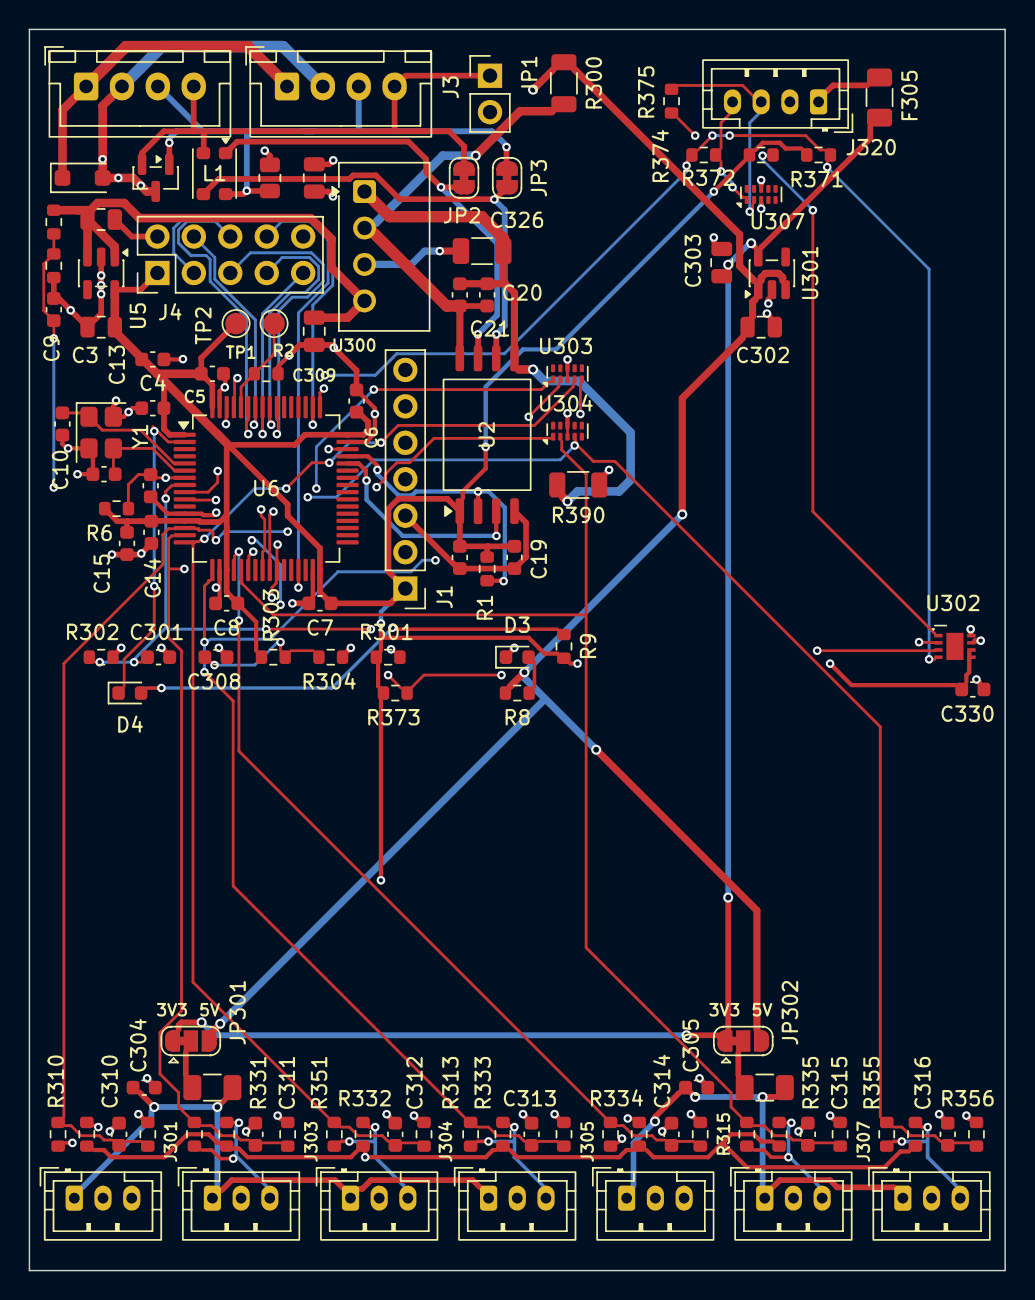
[picture p2: board bemeneti-modul.kicad_pcb from above]

Board: 4 copper layers, 68.0 x 86.5 mm, 112 parts (0 on the bottom side), 58 nets.

Parts:
C2, C3, C303, C309: 10µ; C_0805_2012Metric
C4, C5, C6, C7, C8, C9, C16, C18, C20, C301, C308, C330: 100n; C_0603_1608Metric
C10, C11: 12p; C_0603_1608Metric
C13, C19, C21: 4µ7; C_0603_1608Metric
C14, C304, C305: 1µ; C_0603_1608Metric
C15, C310, C311, C312, C313, C314, C315, C316: 10n; C_0603_1608Metric
C300: 4µ7; C_0805_2012Metric
C302: 10µ/10V; C_0805_2012Metric
C326: 2n2/1kV; C_1206_3216Metric
D3: zöld; LED_0603_1608Metric
D4: piros; LED_0603_1608Metric
D5: SMF5.0A; D_SOD-123F
F301, F302, F305: PTC 0,2A; Fuse_1206_3216Metric
J1: DEBUG; PinHeader_1x07_P2.54mm_Vertical
J2: BUS_IN; JST_XH_B4B-XH-A_1x04_P2.50mm_Vertical
J3: BUS_OUT; JST_XH_B4B-XH-A_1x04_P2.50mm_Vertical
J4: BŐVÍTŐ; PinHeader_2x05_P2.54mm_Vertical
J301: IN0; JST_PH_B3B-PH-K_1x03_P2.00mm_Vertical
J302: IN1; JST_PH_B3B-PH-K_1x03_P2.00mm_Vertical
J303: IN2; JST_PH_B3B-PH-K_1x03_P2.00mm_Vertical
J304: IN3; JST_PH_B3B-PH-K_1x03_P2.00mm_Vertical
J305: IN4; JST_PH_B3B-PH-K_1x03_P2.00mm_Vertical
J306: IN5; JST_PH_B3B-PH-K_1x03_P2.00mm_Vertical
J307: IN6; JST_PH_B3B-PH-K_1x03_P2.00mm_Vertical
J320: I2C KÜLSŐ; JST_PH_B4B-PH-K_1x04_P2.00mm_Vertical
JP1: LEZÁRÁS; PinHeader_1x02_P2.54mm_Vertical
JP2, JP3: áthidaló; SolderJumper-2_P1.3mm_Bridged_RoundedPad1.0x1.5mm
JP301: CSOPORT 1; SolderJumper-3_P1.3mm_Bridged12_RoundedPad1.0x1.5mm
JP302: CSOPORT 2; SolderJumper-3_P1.3mm_Bridged12_RoundedPad1.0x1.5mm
L1: DNP; L_CommonModeChoke_Coilank_ACM3225
R1, R2, R6, R310, R311, R312, R313, R314, R315, R316, R330, R331, R332, R333, R334, R335, R336, R373: 10k; R_0603_1608Metric
R3, R4, R301, R303: 10k 1%; R_0603_1608Metric
R5: 120R; R_0805_2012Metric
R8: 2k2; R_0603_1608Metric
R9: 1k; R_0603_1608Metric
R300, R390: 0R; R_1206_3216Metric
R302: 2k49 1%; R_0603_1608Metric
R304: 715R 1%; R_0603_1608Metric
R350, R351, R352, R353, R354, R355, R356: DNP; R_0603_1608Metric
R371, R372: 4k7; R_0603_1608Metric
R374, R375: 100R; R_0603_1608Metric
TP1: BOOT0; TestPoint_Pad_D1.5mm
TP2: 3V3; TestPoint_Pad_D1.5mm
U2: CA-IS3052G; SOIC-8_7.5x5.85mm_P1.27mm
U3: ESD2CAN24-Q1; SOT-23
U5, U301: AP2112K-3.3TRG1; SOT-23-5
U6: STM32L433RCT3; LQFP-64_10x10mm_P0.5mm
U300: B0505S-1WR3; Converter_DCDC_TRACO_TME_03xxS_05xxS_12xxS_Single_THT
U302: HDC3020DEFR; TI_WSON-8-1EP_2.5x2.5mm_DEF0008A
U303, U304, U307: TPD4E05U06DQAR; USON-10_2.5x1.0mm_P0.5mm
Y1: 8MHz; Crystal_SMD_3225-4Pin_3.2x2.5mm

Connections:
+3V3: C3.1, C4.1, C5.1, C6.1, C7.1, C8.1, C13.1, C14.1, C15.1, C18.1, C19.1, C330.1, J1.1, J4.1, R1.1, R6.1, R9.1, R301.1, R303.1, R330.1, R331.1, R332.1, R333.1, R334.1, R335.1, R336.1, R371.1, R372.1, R373.1, TP2.1, U2.1, U5.5, U6.1, U6.13, U6.19, U6.32, U6.48, U6.64, U302.5, U302.6
+3V3S: C303.1, F305.1, JP301.1, JP302.1, U301.5
+5V: C2.1, C302.1, C309.1, JP301.3, JP302.3, R3.1, R8.1, R300.2, U5.1, U5.3, U300.4, U301.1, U301.3
/GND_BUS: C20.2, C21.2, C300.2, C326.1, D5.2, J2.2, J3.2, R390.1, U2.5, U3.3, U300.1
/HDC_ALERT: R373.2, U6.10, U302.3
/HW_ID: C301.1, R301.2, R302.1, U6.8
/HW_REV: C308.1, R303.2, R304.1, U6.26
/I2C_SCL: R371.2, R374.1, U6.61, U302.4
/I2C_SDA: R372.2, R375.1, U6.62, U302.1
/IN0: C310.1, R310.2, R350.1, U6.14, U303.1
/IN1: C311.1, R311.2, R351.1, U6.15, U303.2
/IN2: C312.1, R312.2, R352.1, U6.16, U303.4
/IN3: C313.1, R313.2, R353.1, U6.17, U303.5
/IN4: C314.1, R314.2, R354.1, U6.20, U304.1
/IN5: C315.1, R315.2, R355.1, U6.21, U304.2
/IN6: C316.1, R316.2, R356.1, U6.22, U304.4
/SCL_EXT: J320.4, R374.2, U307.1
/SDA_EXT: J320.3, R375.2, U307.2
/modulmag/BOOT0: R2.1, TP1.1, U6.60
/modulmag/CAN_H: J2.4, J3.4, JP1.1, JP2.2, L1.2, U3.2
/modulmag/CAN_H_T: JP2.1, L1.1, U2.7
/modulmag/CAN_L: J2.3, J3.3, JP3.2, L1.4, R5.2, U3.1
/modulmag/CAN_L_T: JP3.1, L1.3, U2.6
/modulmag/CAN_RX: U2.3, U6.44
/modulmag/CAN_TX: R1.2, U2.2, U6.45
/modulmag/EXP_PA15: J4.3, U6.50
/modulmag/EXP_PB3: J4.5, U6.55
/modulmag/EXP_PB4: J4.7, U6.56
/modulmag/EXP_PB5: J4.9, U6.57
/modulmag/EXP_PB6: J4.4, U6.58
/modulmag/EXP_PB7: J4.6, U6.59
/modulmag/EXP_PB10: J4.8, U6.29
/modulmag/NRST: C16.1, J1.5, R6.2, U6.7
/modulmag/OSC_IN: C10.1, U6.5, Y1.1
/modulmag/OSC_OUT: C11.1, U6.6, Y1.3
/modulmag/STATUS_LED: D4.1, U6.2
/modulmag/SWCLK: J1.2, U6.49
/modulmag/SWDIO: J1.4, U6.46
/modulmag/UART_RX: J1.7, U6.25
/modulmag/UART_TX: J1.6, U6.24
/modulmag/VBUS_SENSE: C9.1, R3.2, R4.1, U6.9
GND: C2.2, C3.2, C4.2, C5.2, C6.2, C7.2, C8.2, C9.2, C10.2, C11.2, C13.2, C14.2, C15.2, C16.2, C18.2, C19.2, C301.2, C302.2, C303.2, C304.2, C305.2, C308.2, C309.2, C310.2, C311.2, C312.2, C313.2, C314.2, C315.2, C316.2, C326.2, C330.2, D3.1, J1.3, J4.2, J4.10, J301.2, J302.2, J303.2, J304.2, J305.2, J306.2, J307.2, J320.2, R2.2, R4.2, R302.2, R304.2, R350.2, R351.2, R352.2, R353.2, R354.2, R355.2, R356.2, R390.2, U2.4, U5.2, U6.12, U6.18, U6.31, U6.47, U6.63, U300.3, U301.2, U302.2, U302.7, U302.8, U303.3, U303.8, U304.3, U304.8, U307.3, U307.8, Y1.2, Y1.4
unnamed: D3.2, R8.2
unnamed: D4.2, R9.2
unnamed: J301.3, R310.1, R330.2
unnamed: J302.3, R311.1, R331.2
unnamed: J303.3, R312.1, R332.2
unnamed: J304.3, R313.1, R333.2
unnamed: J305.3, R314.1, R334.2
unnamed: J306.3, R315.1, R335.2
unnamed: J307.3, R316.1, R336.2
unnamed: JP1.2, R5.1
unnamed: F301.1, JP301.2
unnamed: F302.1, JP302.2
SUP1: C304.1, F301.2, J301.1, J302.1, J303.1, J304.1
SUP2: C305.1, F302.2, J305.1, J306.1, J307.1
SUP_I2C: F305.2, J320.1
V_BUS: C20.1, C21.1, C300.1, D5.1, J2.1, J3.1, R300.1, U2.8, U300.2
