Cloudhunter77/szakdolgozat/hardware/vezerlo/vezerlo.kicad_pcb

## KiCad design hardware/vezerlo/vezerlo.kicad_pcb (2026-11-06)

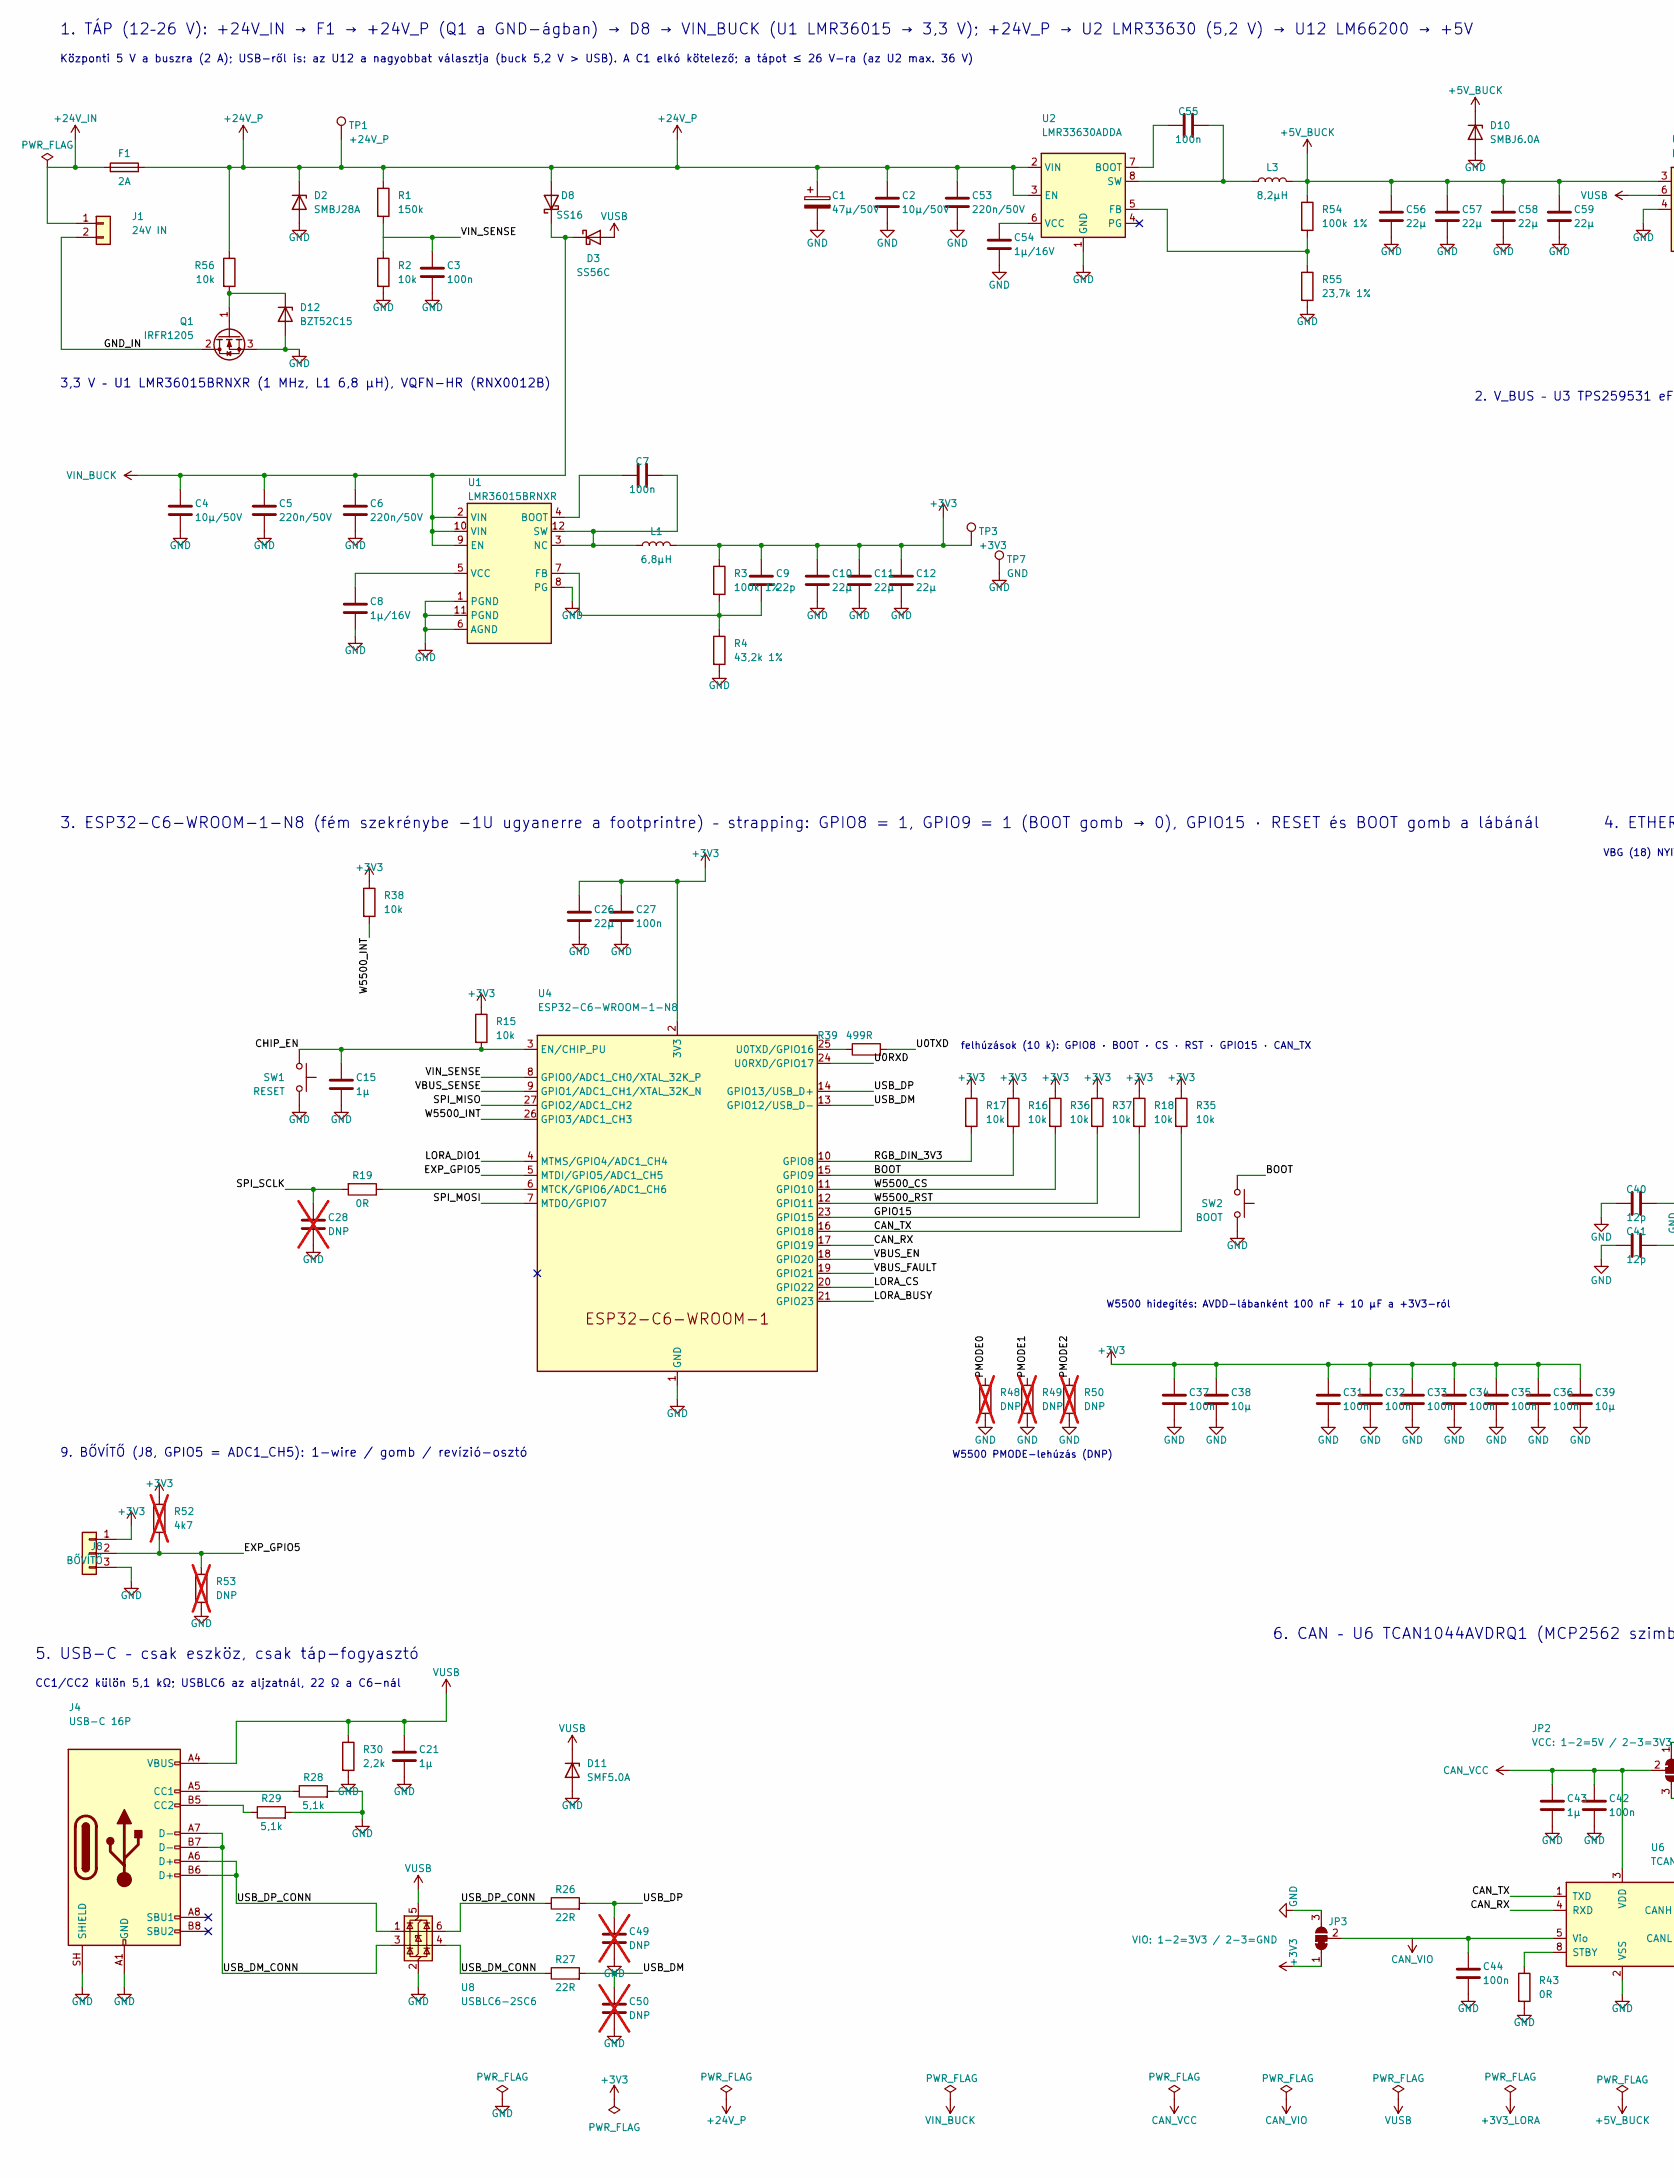
[picture p3: schematic vezerlo.kicad_sch, Vezérlő – ESP32-C6-WROOM-1 + W5500 + CAN + V_BUS, part in row 1, column 1]

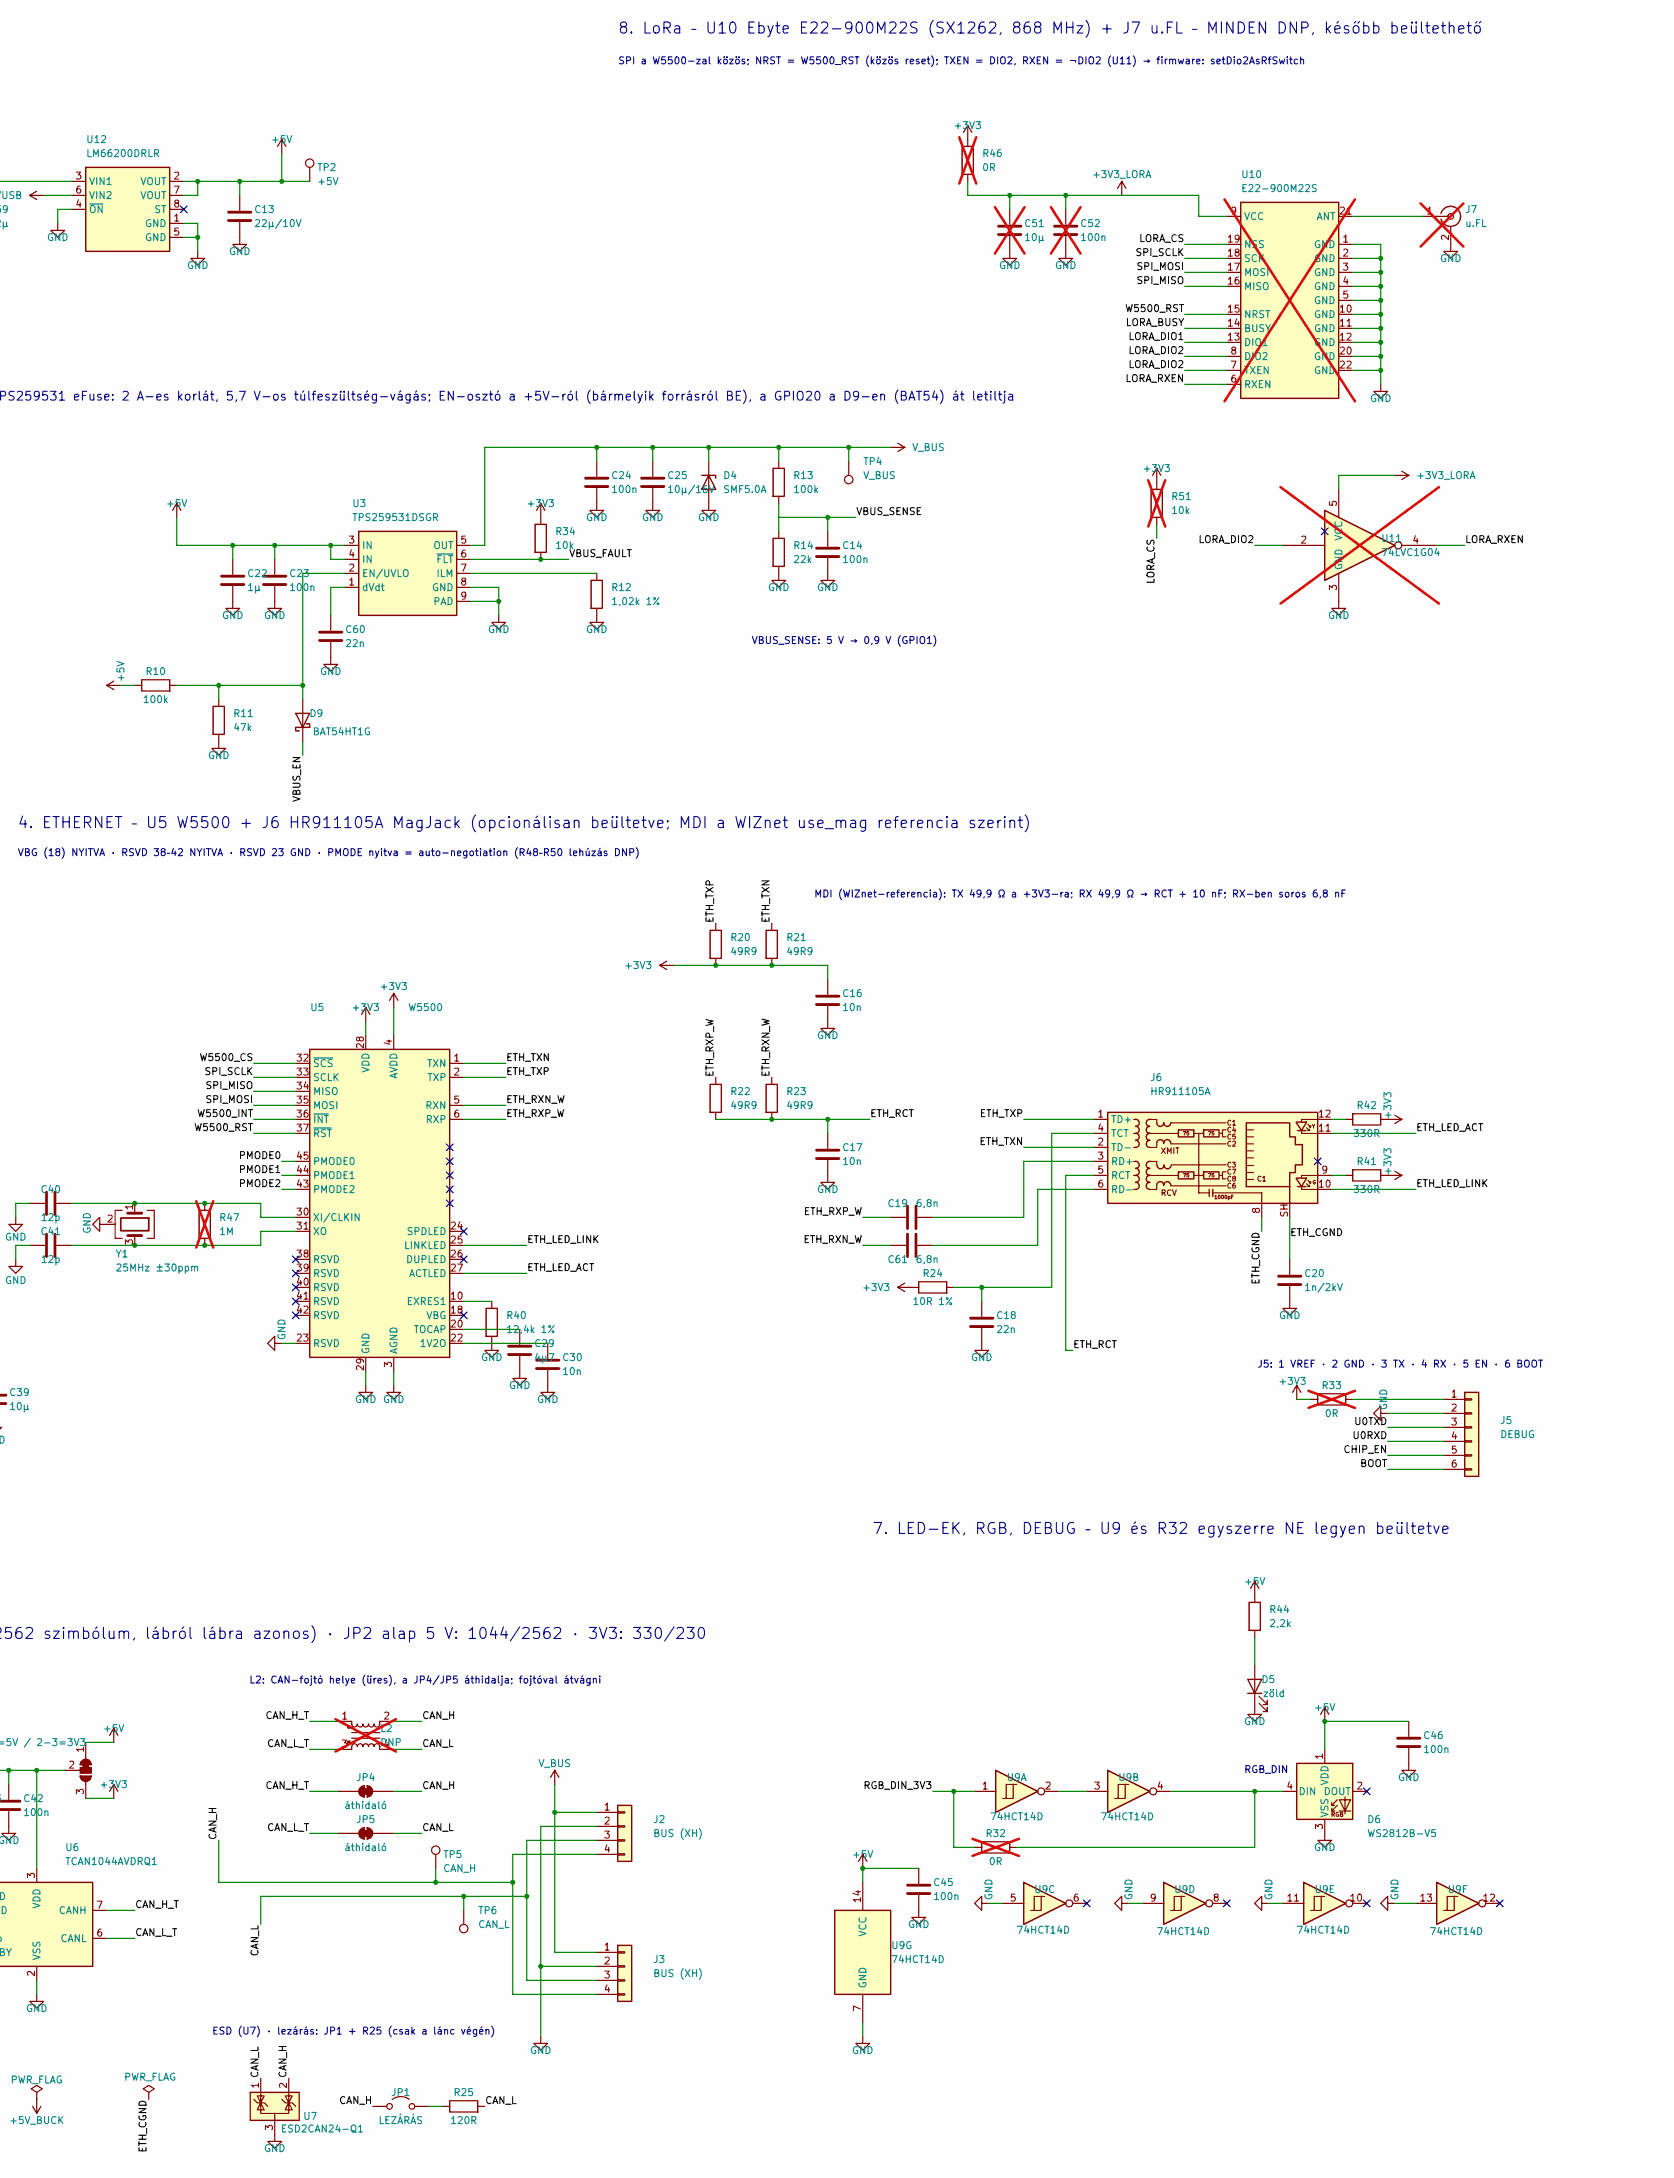
[picture p4: schematic vezerlo.kicad_sch, Vezérlő – ESP32-C6-WROOM-1 + W5500 + CAN + V_BUS, part in row 1, column 2]

Parts:
C1: 47µ/50V; CP_Elec_6.3x7.7
C2, C4: 10µ/50V; C_1210_3225Metric
C3, C7, C14, C23, C24, C27, C31, C32, C33, C34, C35, C36, C37, C42, C44, C45, C46, C55: 100n; C_0603_1608Metric
C5, C6, C53: 220n/50V; C_0603_1608Metric
C8, C54: 1µ/16V; C_0603_1608Metric
C9: 22p; C_0603_1608Metric
C10, C11, C12, C56, C57, C58, C59: 22µ; C_1206_3216Metric
C13: 22µ/10V; C_1206_3216Metric
C15, C21, C22, C43: 1µ; C_0603_1608Metric
C16, C17, C30: 10n; C_0603_1608Metric
C18, C60: 22n; C_0603_1608Metric
C19, C61: 6,8n; C_0603_1608Metric
C20: 1n/2kV; C_1206_3216Metric
C25: 10µ/16V; C_0805_2012Metric
C26: 22µ; C_0805_2012Metric
C28, C49, C50: DNP; C_0603_1608Metric; not fitted
C29: 4µ7; C_0805_2012Metric
C38, C39: 10µ; C_0805_2012Metric
C40, C41: 12p; C_0603_1608Metric
C51: 10µ; C_0805_2012Metric; not fitted
C52: 100n; C_0603_1608Metric; not fitted
D2: SMBJ28A; D_SMB
D3: SS56C; D_SMC
D4, D11: SMF5.0A; D_SOD-123F
D5: zöld; LED_0603_1608Metric
D6: WS2812B-V5; LED_WS2812B_PLCC4_5.0x5.0mm_P3.2mm
D8: SS16; D_SMA
D9: BAT54HT1G; D_SOD-323
D10: SMBJ6.0A; D_SMB
D12: BZT52C15; D_SOD-123
F1: 2A; Fuse_1206_3216Metric
J1: 24V IN; TerminalBlock_Phoenix_MKDS-1,5-2_1x02_P5.00mm_Horizontal
J2, J3: BUS (XH); JST_XH_B4B-XH-A_1x04_P2.50mm_Vertical
J4: USB-C 16P; USB_C_Receptacle_HRO_TYPE-C-31-M-12
J5: DEBUG; PinHeader_1x06_P2.54mm_Vertical
J6: HR911105A; RJ45_Hanrun_HR911105A_Horizontal
J7: u.FL; U.FL_Hirose_U.FL-R-SMT-1_Vertical; not fitted
J8: BŐVÍTŐ; JST_PH_B3B-PH-K_1x03_P2.00mm_Vertical
JP1: LEZÁRÁS; PinHeader_1x02_P2.54mm_Vertical
JP2: VCC: 1-2=5V / 2-3=3V3; SolderJumper-3_P1.3mm_Bridged12_RoundedPad1.0x1.5mm
JP3: VIO: 1-2=3V3 / 2-3=GND; SolderJumper-3_P1.3mm_Bridged12_RoundedPad1.0x1.5mm
JP4, JP5: áthidaló; SolderJumper-2_P1.3mm_Bridged_RoundedPad1.0x1.5mm
L1: 6,8µH; L_FerroCore_HPI0630
L2: DNP; L_CommonModeChoke_Coilank_ACM3225; not fitted
L3: 8,2µH; L_FerroCore_HPI0630
Q1: IRFR1205; TO-252-2
R1: 150k; R_0603_1608Metric
R2, R15, R16, R17, R18, R34, R35, R36, R37, R38, R56: 10k; R_0603_1608Metric
R3, R54: 100k 1%; R_0603_1608Metric
R4: 43,2k 1%; R_0603_1608Metric
R10, R13: 100k; R_0603_1608Metric
R11: 47k; R_0603_1608Metric
R12: 1,02k 1%; R_0603_1608Metric
R14: 22k; R_0603_1608Metric
R19, R43: 0R; R_0603_1608Metric
R20, R21, R22, R23: 49R9; R_0603_1608Metric
R24: 10R 1%; R_0603_1608Metric
R25: 120R; R_0805_2012Metric
R26, R27: 22R; R_0603_1608Metric
R28, R29: 5,1k; R_0603_1608Metric
R30, R44: 2,2k; R_0603_1608Metric
R32, R33, R46: 0R; R_0603_1608Metric; not fitted
R39: 499R; R_0603_1608Metric
R40: 12,4k 1%; R_0603_1608Metric
R41, R42: 330R; R_0603_1608Metric
R47: 1M; R_0603_1608Metric; not fitted
R48, R49, R50, R53: DNP; R_0603_1608Metric; not fitted
R51: 10k; R_0603_1608Metric; not fitted
R52: 4k7; R_0603_1608Metric; not fitted
R55: 23,7k 1%; R_0603_1608Metric
SW1: RESET; SW_SPST_TL3342
SW2: BOOT; SW_SPST_TL3342
TP1: +24V_P; TestPoint_Pad_D1.5mm
TP2: +5V; TestPoint_Pad_D1.5mm
TP3: +3V3; TestPoint_Pad_D1.5mm
TP4: V_BUS; TestPoint_Pad_D1.5mm
TP5: CAN_H; TestPoint_Pad_D1.5mm
TP6: CAN_L; TestPoint_Pad_D1.5mm
TP7: GND; TestPoint_Pad_D1.5mm
U1: LMR36015BRNXR; TI_VQFN-HR-12_RNX0012B
U2: LMR33630ADDA; Texas_HSOP-8-1EP_3.9x4.9mm_P1.27mm_ThermalVias
U3: TPS259531DSGR; Texas_DSG0008A_WSON-8-1EP_2x2mm_P0.5mm_EP0.9x1.6mm
U4: ESP32-C6-WROOM-1-N8; ESP32-C6-WROOM-1
U5: W5500; LQFP-48_7x7mm_P0.5mm
U6: TCAN1044AVDRQ1; SOIC-8_3.9x4.9mm_P1.27mm
U7: ESD2CAN24-Q1; SOT-23
U8: USBLC6-2SC6; SOT-23-6
U9: 74HCT14D; SOIC-14_3.9x8.7mm_P1.27mm
U10: E22-900M22S; Ebyte_E22-900M22S; not fitted
U11: 74LVC1G04; SOT-353_SC-70-5; not fitted
U12: LM66200DRLR; SOT-583-8
Y1: 25MHz ±30ppm; Crystal_SMD_3225-4Pin_3.2x2.5mm

Connections:
+3V3: C9.1, C10.1, C11.1, C12.1, C16.1, C26.1, C27.1, C31.1, C32.1, C33.1, C34.1, C35.1, C36.1, C37.1, C38.1, C39.1, J8.1, JP2.3 (B), JP3.1 (A), L1.2, R3.1, R15.1, R16.1, R17.1, R18.1, R20.2, R21.2, R24.1, R33.1, R34.1, R35.1, R36.1, R37.1, R38.1, R41.1, R42.1, R46.1, R51.1, R52.1, TP3.1 (1_1), U4.2 (3V3), U5.4 (AVDD), U5.8 (AVDD), U5.11 (AVDD), U5.15 (AVDD), U5.17 (AVDD), U5.21 (AVDD), U5.28 (VDD)
+3V3_LORA: C51.1, C52.1, R46.2, U10.9 (VCC), U11.5 (VCC)
+5V: C13.1, C22.1, C23.1, C45.1, C46.1, D6.1 (VDD), JP2.1 (A), R10.1, R44.1, TP2.1 (1_1), U3.3 (IN), U3.4 (IN), U9.14 (VCC), U12.2 (VOUT), U12.7 (VOUT)
+5V_BUCK: C56.1, C57.1, C58.1, C59.1, D10.1 (K), L3.2, R54.1, U12.3 (VIN1)
+24V_IN: F1.1, J1.1
+24V_P: C1.1, C2.1, C53.1, D2.1 (K), D8.2 (A), F1.2, R1.1, R56.1, TP1.1 (1_1), U2.2 (VIN), U2.3 (EN)
/BOOT: J5.6, R16.2, SW2.1, U4.15 (GPIO9)
/CAN_H: J2.4, J3.4, JP1.1 (A), JP4.2 (B), L2.2, TP5.1 (1_1), U7.2 (K)
/CAN_H_T: JP4.1 (A), L2.1, U6.7 (CANH)
/CAN_L: J2.3, J3.3, JP5.2 (B), L2.4, R25.2, TP6.1 (1_1), U7.1 (K)
/CAN_L_T: JP5.1 (A), L2.3, U6.6 (CANL)
/CAN_RX: U4.17 (GPIO19), U6.4 (RXD)
/CAN_TX: R35.2, U4.16 (GPIO18), U6.1 (TXD)
/CHIP_EN: C15.1, J5.5, R15.2, SW1.1, U4.3 (EN/CHIP_PU)
/ETH_CGND: C20.1, J6.8, J6.SH
/ETH_LED_ACT: J6.11, U5.27 (ACTLED)
/ETH_LED_LINK: J6.10, U5.25 (LINKLED)
/ETH_RCT: C17.1, J6.5 (RCT), R22.2, R23.2
/ETH_RXN_W: C61.1, R23.1, U5.5 (RXN)
/ETH_RXP_W: C19.1, R22.1, U5.6 (RXP)
/ETH_TXN: J6.2 (TD-), R21.1, U5.1 (TXN)
/ETH_TXP: J6.1 (TD+), R20.1, U5.2 (TXP)
/EXP_GPIO5: J8.2, R52.2, R53.1, U4.5 (MTDI/GPIO5/ADC1_CH5)
/GND_IN: J1.2, Q1.2 (D)
/GPIO15: R18.2, U4.23 (GPIO15)
/LORA_BUSY: U4.21 (GPIO23), U10.14 (BUSY)
/LORA_CS: R51.2, U4.20 (GPIO22), U10.19 (NSS)
/LORA_DIO1: U4.4 (MTMS/GPIO4/ADC1_CH4), U10.13 (DIO1)
/LORA_DIO2: U10.7 (TXEN), U10.8 (DIO2), U11.2
/LORA_RXEN: U10.6 (RXEN), U11.4
/PMODE0: R48.1, U5.45 (PMODE0)
/PMODE1: R49.1, U5.44 (PMODE1)
/PMODE2: R50.1, U5.43 (PMODE2)
/RGB_DIN_3V3: R17.2, R32.1, U4.10 (GPIO8), U9.1
/SPI_MISO: U4.27 (GPIO2/ADC1_CH2), U5.34 (MISO), U10.16 (MISO)
/SPI_MOSI: U4.7 (MTDO/GPIO7), U5.35 (MOSI), U10.17 (MOSI)
/SPI_SCLK: C28.1, R19.2, U5.33 (SCLK), U10.18 (SCK)
/U0RXD: J5.4, U4.24 (U0RXD/GPIO17)
/U0TXD: J5.3, R39.2
/USB_DM: C50.1, R27.2, U4.13 (GPIO12/USB_D-)
/USB_DM_CONN: J4.A7 (D-), J4.B7 (D-), R27.1, U8.3 (I/O2), U8.4 (I/O2)
/USB_DP: C49.1, R26.2, U4.14 (GPIO13/USB_D+)
/USB_DP_CONN: J4.A6 (D+), J4.B6 (D+), R26.1, U8.1 (I/O1), U8.6 (I/O1)
/VBUS_EN: D9.1 (K), U4.18 (GPIO20)
/VBUS_FAULT: R34.2, U3.6 (~FLT), U4.19 (GPIO21)
/VBUS_SENSE: C14.1, R13.2, R14.1, U4.9 (GPIO1/ADC1_CH1/XTAL_32K_N)
/VIN_SENSE: C3.1, R1.2, R2.1, U4.8 (GPIO0/ADC1_CH0/XTAL_32K_P)
/W5500_CS: R36.2, U4.11 (GPIO10), U5.32 (~SCS)
/W5500_INT: R38.2, U4.26 (GPIO3/ADC1_CH3), U5.36 (~INT)
/W5500_RST: R37.2, U4.12 (GPIO11), U5.37 (~RST), U10.15 (NRST)
CAN_VCC: C42.1, C43.1, JP2.2 (C), U6.3 (VDD)
CAN_VIO: C44.1, JP3.2 (C), U6.5 (Vio)
unnamed: D5.2 (A), R44.2
unnamed: D6.4 (DIN), R32.2, U9.4
unnamed: D9.2 (A), R10.2, R11.1, U3.2 (EN/UVLO)
unnamed: D12.1 (K), Q1.1 (G), R56.2
unnamed: J4.A5 (CC1), R28.1
unnamed: J4.B5 (CC2), R29.1
unnamed: J5.1, R33.2
unnamed: J6.9, R41.2
unnamed: J6.12, R42.2
unnamed: C19.2, J6.3 (RD+)
unnamed: C61.2, J6.6 (RD-)
unnamed: C18.1, J6.4 (TCT), R24.2
unnamed: J7.1 (In), U10.21 (ANT)
unnamed: JP1.2 (B), R25.1
unnamed: C7.1, U1.4 (BOOT)
unnamed: C9.2, R3.2, R4.1, U1.7 (FB)
unnamed: C7.2, L1.1, U1.3 (NC), U1.12 (SW)
unnamed: C8.1, U1.5 (VCC)
unnamed: C55.1, U2.7 (BOOT)
unnamed: R54.2, R55.1, U2.5 (FB)
unnamed: C55.2, L3.1, U2.8 (SW)
unnamed: C54.1, U2.6 (VCC)
unnamed: R12.1, U3.7 (ILM)
unnamed: C60.1, U3.1 (dVdt)
unnamed: R19.1, U4.6 (MTCK/GPIO6/ADC1_CH6)
unnamed: R39.1, U4.25 (U0TXD/GPIO16)
unnamed: R40.1, U5.10 (EXRES1)
unnamed: C29.1, U5.20 (TOCAP)
unnamed: C40.1, R47.1, U5.30 (XI/CLKIN), Y1.1
unnamed: C41.1, R47.2, U5.31 (XO), Y1.3
unnamed: R43.1, U6.8 (STBY)
unnamed: U9.2, U9.3
VIN_BUCK: C4.1, C5.1, C6.1, D3.1 (K), D8.1 (K), U1.2 (VIN), U1.9 (EN), U1.10 (VIN)
VUSB: C21.1, D3.2 (A), D11.1 (K), J4.A4 (VBUS), J4.A9 (VBUS), J4.B4 (VBUS), J4.B9 (VBUS), R30.1, U8.5 (VBUS), U12.6 (VIN2)
V_BUS: C24.1, C25.1, D4.1 (K), J2.1, J3.1, R13.1, TP4.1 (1_1), U3.5 (OUT)

Notes on the sheet:
L2: CAN-fojtó helye (üres), a JP4/JP5 áthidalja; fojtóval átvágni
9. BŐVÍTŐ (J8, GPIO5 = ADC1_CH5): 1-wire / gomb / revízió-osztó
felhúzások (10 k): GPIO8 · BOOT · CS · RST · GPIO15 · CAN_TX
3,3 V – U1 LMR36015BRNXR (1 MHz, L1 6,8 µH), VQFN-HR (RNX0012B)
VBUS_SENSE: 5 V → 0,9 V (GPIO1)
J5: 1 VREF · 2 GND · 3 TX · 4 RX · 5 EN · 6 BOOT
8. LoRa – U10 Ebyte E22-900M22S (SX1262, 868 MHz) + J7 u.FL – MINDEN DNP, később beültethető
Központi 5 V a buszra (2 A); USB-ről is: az U12 a nagyobbat választja (buck 5,2 V > USB). A C1 elkó kötelező; a tápot ≤ 26 V-ra (az U2 max. 36 V)
W5500 PMODE-lehúzás (DNP)
7. LED-EK, RGB, DEBUG – U9 és R32 egyszerre NE legyen beültetve
VBG (18) NYITVA · RSVD 38–42 NYITVA · RSVD 23 GND · PMODE nyitva = auto-negotiation (R48–R50 lehúzás DNP)
5. USB-C – csak eszköz, csak táp-fogyasztó
6. CAN – U6 TCAN1044AVDRQ1 (MCP2562 szimbólum, lábról lábra azonos) · JP2 alap 5 V: 1044/2562 · 3V3: 330/230
CC1/CC2 külön 5,1 kΩ; USBLC6 az aljzatnál, 22 Ω a C6-nál
4. ETHERNET – U5 W5500 + J6 HR911105A MagJack (opcionálisan beültetve; MDI a WIZnet use_mag referencia szerint)
W5500 hidegítés: AVDD-lábanként 100 nF + 10 µF a +3V3-ról
MDI (WIZnet-referencia): TX 49,9 Ω a +3V3-ra; RX 49,9 Ω → RCT + 10 nF; RX-ben soros 6,8 nF
ESD (U7) · lezárás: JP1 + R25 (csak a lánc végén)
3. ESP32-C6-WROOM-1-N8 (fém szekrénybe -1U ugyanerre a footprintre) – strapping: GPIO8 = 1, GPIO9 = 1 (BOOT gomb → 0), GPIO15 · RESET és BOOT gomb a lábánál
2. V_BUS – U3 TPS259531 eFuse: 2 A-es korlát, 5,7 V-os túlfeszültség-vágás; EN-osztó a +5V-ról (bármelyik forrásról BE), a GPIO20 a D9-en (BAT54) át letiltja
1. TÁP (12–26 V): +24V_IN → F1 → +24V_P (Q1 a GND-ágban) → D8 → VIN_BUCK (U1 LMR36015 → 3,3 V); +24V_P → U2 LMR33630 (5,2 V) → U12 LM66200 → +5V
SPI a W5500-zal közös; NRST = W5500_RST (közös reset); TXEN = DIO2, RXEN = ¬DIO2 (U11) → firmware: setDio2AsRfSwitch
RGB_DIN

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
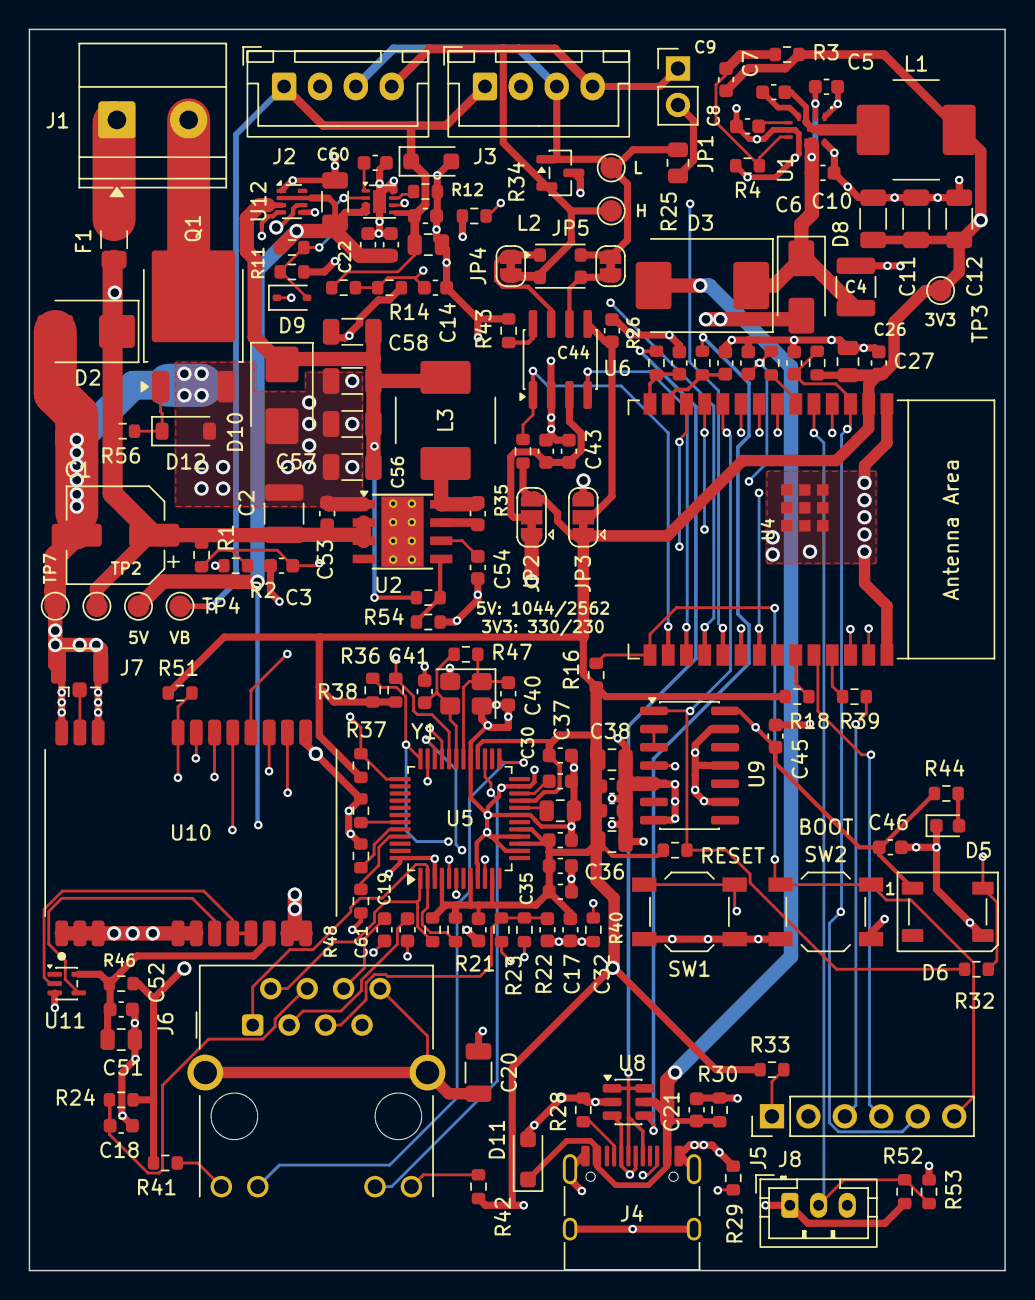
[picture p5: board vezerlo.kicad_pcb from above]

Board: 4 copper layers, 68.0 x 86.5 mm, 158 parts (0 on the bottom side), 89 nets.
