Cloudhunter77/szakdolgozat/hardware/cubemx/led-modul/led-modul.ioc

Mcu.UserName=STM32L433RCTx
PA0.GPIO_Label=DS1
PA0.Signal=ADCx_IN5
PA1.GPIO_Label=DS2
PA1.Signal=ADCx_IN6
PA10.GPIO_Label=CH3_PWM
PA10.Signal=S_TIM1_CH3
PA11.GPIO_Label=CAN_RX
PA11.Signal=CAN1_RX
PA12.GPIO_Label=CAN_TX
PA12.Signal=CAN1_TX
PA13.GPIO_Label=SWDIO
PA13.Signal=SYS_JTMS-SWDIO
PA14.GPIO_Label=SWCLK
PA14.Signal=SYS_JTCK-SWCLK
PA2.GPIO_Label=DS3
PA2.Signal=ADCx_IN7
PA3.GPIO_Label=I_SENSE
PA3.Signal=COMP2_INP
PA4.GPIO_Label=DAC_THR
PA4.Signal=COMP_DAC11_group
PA5.GPIO_Label=DS5
PA5.Signal=ADCx_IN10
PA6.GPIO_Label=DS6
PA6.Signal=ADCx_IN11
PA7.GPIO_Label=DS4
PA7.Signal=ADCx_IN12
PA8.GPIO_Label=CH1_PWM
PA8.Signal=S_TIM1_CH1
PA9.GPIO_Label=CH2_PWM
PA9.Signal=S_TIM1_CH2
PB0.GPIO_Label=HW_REV
PB0.Signal=ADCx_IN15
PB1.GPIO_Label=VIN_SENSE
PB1.Signal=ADCx_IN16
PB12.GPIO_Label=DRV_EN
PB12.Signal=GPIO_Output
PB14.GPIO_Label=CH4_PWM
PB14.Signal=S_TIM15_CH1
PB15.GPIO_Label=CH5_PWM
PB15.Signal=S_TIM15_CH2
PB8.GPIO_Label=CH6_PWM
PB8.Signal=S_TIM16_CH1
PC0.GPIO_Label=HW_ID
PC0.Signal=ADCx_IN1
PC1.GPIO_Label=VBUS_SENSE
PC1.Signal=ADCx_IN2
PC13.GPIO_Label=STATUS_LED
PC13.Signal=GPIO_Output
PC2.GPIO_Label=V_RAIL_SENSE
PC2.Signal=ADCx_IN3
PC3.GPIO_Label=T_SENSE
PC3.Signal=ADCx_IN4
PC4.GPIO_Label=UART_TX
PC4.Signal=USART3_TX
PC5.GPIO_Label=UART_RX
PC5.Signal=USART3_RX
