Cloudhunter77/szakdolgozat/hardware/gen/pcbgen.py

"""NYÁK-előkészítés (D73): board-fájl a netlistából – körvonal, rétegek, footprintek a hálózatokkal, kezdő elhelyezés.

Futtatás (a KiCad Flatpak Pythonjával, a pcbnew modul miatt):
    flatpak run --command=python3 org.kicad.KiCad hardware/gen/pcbgen.py <lap> [--force]

- A footprintek a kapcsolási rajz szimbólumaihoz kötve (KIID-útvonal) → később a KiCad „Update PCB from Schematic” működik.
- A csatlakozók a DIN-ház szerinti élre kerülnek és arra néznek; a többi alkatrész a hozzá kötött IC köré (a közös,
  nem tápjellegű hálózatok alapján), az IC régiójába. Huzalozás nincs – azt Balázs csinálja.
- D67 mintájára: amint a .kicad_pcb-t kézzel szerkesztjük, az a forrás; a szkript csak --force-szal írja felül.
"""
import sys, os, math
sys.path.insert(0, os.path.dirname(__file__))
import sx
import pcbnew

H = os.path.normpath(os.path.join(os.path.dirname(__file__), '..'))
SYS = '/app/extensions/Library/footprints'
OX, OY = 100.0, 100.0          # a NYÁK bal felső sarka a lapon (mm)
GAP = 0.5                      # minimális távolság két courtyard között (mm)
EDGE = 0.5                     # courtyard – NYÁK-él
POWER = {'GND', '+3V3', '+5V', '+3V3A', '+24V_P', '+24V_IN', '+24V_F', '+24V_RAIL', 'VIN_BUCK', '+5V_BUCK', 'VUSB',
         '+3V3S', '+12V', 'PGND_SH', 'ETH_CGND', '+3V3_LORA', 'V_BUS'}

# ---------------------------------------------------------------------------------------------------------------
# Lapok: méret, DIN-zónák, rögzített (él menti) alkatrészek, csoport-régiók
#   fixed:  ref -> (x, y, él)  – a courtyard középpontja a NYÁK-on (mm, bal felső sarok = 0,0); él: 'N','S','W','E'
#           (a csatlakozó nyílása / vezeték-bevezetése erre néz) vagy None (csak forgatás nélkül)
#   anchors: ref -> régió (x0, y0, x1, y1) – az IC és a hozzá rendelt kis alkatrészek ide kerülnek
# ---------------------------------------------------------------------------------------------------------------
W4, L = 68.0, 86.5
SH = 20.75                      # vállmélység: (86,5 − 45) / 2 – az előlapi ablak 45 mm (DIN 43880)
TOP, FRONT, BOT = (0, 0, W4, SH), (0, SH, W4, L - SH), (0, L - SH, W4, L)

# Gainta D4MG (D86, docs/d4mg.pdf): a vállfedél (GUARD) 12 csavarfurata 5,08 mm-es osztású, a ház közepére szimmetrikus →
# a 68 mm-es lapon x = 34 ± 2,54·(2k+1) = 6,06 / 11,14 / … / 61,94 mm. A sorkapcsok csavarja ide esik: 2 pólusúnál a két láb két
# szomszédos furatra (középpont 8,60 / 13,68 / … / 59,40), 3 pólusúnál a középső láb furatra (11,14 / 31,46 / 56,86 …).
# lock: a mechanikailag kötött helyű alkatrészek zárolva (KiCad-lakat) – kézzel is csak feloldás után mozdíthatók.

# Modulmag-blokk (D86): mindhárom modulon ugyanaz a relatív elrendezés (a jelölések azonosak → a kész layout átvihető).
# ref -> (dx, dy, forgatás) a courtyard közepe a blokk bal felső sarkához képest (a NYÁK felső éle y = 0); a blokk ~34 × 42 mm (a relémodulon a K1–K4 43 mm-től);
# a courtyardok között ≥ 0,5 mm (GAP) – a hidegítők így is 0,5–0,6 mm-re a tokjuktól.
# Felül a busz (J2, J3, JP1), alatta a védelem és a CAN (U3, L1/JP2/JP3, U2 a lábaival lefelé a PA11/PA12 felé), balra a táp
# (U5 a +5V-ról), középen az STM32 (U6) – minden VDD-lábnál 100 nF, a PH0/PH1 mellett a kvarc, a VDDA-nál C14/C15 –,
# jobbra az SWD (J1); a J4 bővítő és a táp-/állapot-LED a generátorra marad.
MODULMAG_BLOKK = {
    # busz és védelem (felső váll)
    'J2': (7.2, 4.5, 0), 'J3': (21.2, 4.5, 0), 'JP1': (31.6, 4.5, 0),
    'D5': (3.2, 10.5, 0), 'U3': (14.6, 10.5, 0), 'L1': (24.5, 10.6, 0), 'R5': (31.5, 10.0, 270),
    'JP2': (22.6, 14.0, 0), 'JP3': (26.5, 14.0, 0),          # D94: 0,4 mm-rel feljebb (az ISO1042 miatt)
    # 3,3 V a busz +5V-járól
    'C2': (4.6, 13.3, 0), 'U5': (4.6, 17.0, 270), 'C3': (4.6, 20.7, 0), 'TP2': (8.6, 20.0, 0),
    # CAN-transceiver (D94: ISO1042, SOIC-8 széles): fekve, bal oldalt a modul-oldal (VCC1, TXD, RXD, GND1 – a PA12 / PA11 felé),
    # jobb oldalt a busz-oldal (GND2, CANL, CANH, VCC2 – fölötte a C20/C21 hidegítés, a fojtó és a JP2/JP3 felé)
    'U2': (27.75, 19.09, 0), 'C18': (17.88, 17.77, 90), 'C19': (19.94, 17.77, 90), 'R1': (19.19, 20.73, 0),
    'C20': (29.52, 13.80, 90), 'C21': (31.58, 13.80, 90),
    # STM32 és hidegítés: a 100 nF-ok +3,3 V-os padja a VDD-, a GND-padja a VSS-láb felé
    'TP1': (15.8, 21.2, 0), 'C13': (8.6, 23.0, 0), 'C5': (12.25, 23.9, 0), 'R2': (15.9, 23.9, 0),
    'U6': (16.0, 32.0, 0), 'C4': (7.95, 28.0, 90), 'C6': (24.1, 28.2, 270),
    'C10': (4.4, 27.0, 0), 'Y1': (4.4, 30.3, 0), 'C11': (4.4, 33.6, 0), 'C16': (7.95, 31.6, 270),
    'C14': (7.95, 35.2, 90), 'C15': (5.8, 36.5, 90), 'R6': (3.6, 36.5, 90),    # D90: az FB1 helyén az NRST-felhúzás
    'C8': (13.25, 40.1, 180), 'C7': (19.75, 40.1, 180),
    'R3': (2.6, 40.2, 90), 'R4': (4.7, 40.2, 90), 'C9': (6.8, 40.2, 90),
    'J1': (31.2, 32.4, 0),
}
BLOKK_RACS = 0.25           # minden nem zárolt alkatrész a NYÁK sarkához mért 0,25 mm-es rácson (a footprint origója)
BLOKK_MERET = (34.7, 42.4)  # a blokk befoglalója – más alkatrész nem kerülhet bele

# LED-modul (D86): csatornánként a FET fölött a gate- (bal) és a drain-LED (jobb) egy sorban az előlapi ablakban, alattuk az
# ellenállásuk; a meghajtók (U201–U203) a LED-sor és a FET-ek között, két-két FET között középen
LED_CH_X = [5.5, 16.5, 28.5, 39.5, 51.5, 62.5]
LED_SOR = {}
for _n, _x in enumerate(LED_CH_X, 1):
    LED_SOR.update({f'D{220 + _n}': (_x - 1.85, 43.65, 0), f'D{230 + _n}': (_x + 1.85, 43.65, 0),
                    f'R{240 + _n}': (_x - 1.85, 45.75, 0), f'R{250 + _n}': (_x + 2.1, 45.95, 0)})
LED_SOR.update({'U201': (11.0, 50.25, 0), 'U202': (34.0, 50.25, 0), 'U203': (57.0, 50.25, 0)})


def blokk(o, rel):
    """relatív elrendezés (ref -> (dx, dy, forgatás), a courtyard közepe) → abszolút, az `o` origóhoz képest"""
    return {r: (o[0] + dx, o[1] + dy, rot) for r, (dx, dy, rot) in rel.items()}


# Vezérlő (D87): a két buck a TI-adatlapok layout-ajánlása szerint, az IC közepéhez képest.
# LMR36015 (U1, 180°): a VIN–PGND lábpárok lent két oldalt → C5/C6 közvetlenül rajtuk; a SW (12) lefelé → L1 alatta, a SW-csomópont
# ~2 mm; a kimeneti 22 µF-ok sorban az L1 alatt, a +3V3-padjuk felül; felül a VCC (C8) és az FB (R3/R4/C9), távol a SW-től.
VEZ_U1 = {'U1': (0, 0, 180), 'C5': (3.0, 1.0, 270), 'C6': (-3.0, 1.0, 270), 'C7': (3.0, -2.75, 90), 'C8': (0.25, -4.25, 90), 'R4': (-2.5, -4.25, 90),
          'L1': (0, 7.5, 270), 'C10': (-3.0, 15.0, 270), 'C11': (0, 15.0, 270), 'C12': (3.0, 15.0, 270)}
# LMR33630 (U2, 0°): balra a VIN–PGND (1–2) → C53 220 nF a lábakon, mögötte C2 10 µF; jobbra a BOOT–SW (7–8) → C55, alatta a VCC (C54);
# az L3 a SW (8) fölött, a kimeneti 22 µF-ok tőle balra egy oszlopban – a GND-padjuk a C53 GND-padja mellett (kis bemeneti hurok)
VEZ_U2 = {'U2': (0, 0, 0), 'C53': (-5.25, -1.25, 90), 'C2': (-8.25, -1.25, 90), 'C55': (5.25, -1.25, 90), 'C54': (5.25, 2.5, 270),
          'L3': (3.0, -7.75, 90), 'C56': (-3.5, -4.5, 180), 'C57': (-3.5, -7.5, 180), 'C58': (-3.5, -10.5, 180),
          'C59': (-3.5, -13.5, 180)}

BOARDS = {
    'rele-modul': dict(
        size=(W4, L),
        blokk=(33.0, 0),         # D86: modulmag-blokk a jobb felső részen
        fixed={'J100': (8.6, 6, 'N'), 'Q100': (7.5, 16.5, 0), 'F100': (16.0, 14.0, 90),
               'K1': (8.6, 58, 'coilN'), 'K2': (23.84, 58, 'coilN'), 'K3': (44.16, 58, 'coilN'), 'K4': (59.4, 58, 'coilN'),
               'J101': (8.6, 79.8, 'S'), 'J102': (23.84, 79.8, 'S'), 'J103': (44.16, 79.8, 'S'), 'J104': (59.4, 79.8, 'S'),
               'J105': (24, 9.3, 'N'),
               # relé-LED-ek egy sorban az előlapi ablakban (a blokktól balra, a relék fölött)
               'D101': (4.0, 41.0, 0), 'D102': (10.0, 41.0, 0), 'D103': (16.0, 41.0, 0), 'D104': (22.0, 41.0, 0),
               'D4': (28.0, 41.0, 0)},
        anchors={'U101': (0, 20, 33, 42)},
        hv=(0, 43, W4, L),       # 230 V-os tartomány: ide csak a relék érintkezői és a sorkapcsok kerülhetnek
        hv_parts=['K1', 'K2', 'K3', 'K4', 'J101', 'J102', 'J103', 'J104'],
        lock=['J100', 'J2', 'J3', 'JP1', 'J105', 'K1', 'K2', 'K3', 'K4', 'J101', 'J102', 'J103', 'J104'],
        attach={'D105': 'F100', 'C105': 'F100'},   # (F100 rögzített: '@F100' csoport)   # +24V_P: TVS, puffer a betáp-ágnál (D100 – D90)
        pin_attach={'R114': 'Q100', 'D106': 'Q100', 'C104': 'U101',   # a Q100 gate-eleme a gate-hez, a 10 µF a relé-táphoz
                    'D107': 'U101', 'R117': 'U101',                  # D96: a COM-ági Zener és az áthidalása (DNP) a COM (10) mellé
                    'R115': 'U6', 'R116': 'U6', 'C107': 'U6',        # D89: a HW_REV-osztó a blokkon kívül, a PB0 (26) mellett
                    'R9': 'D4', 'R113': 'J2', 'R100': 'J2',   # D94: V_BUS → +5V
                    'U100': 'U2', 'C100': 'U100', 'C108': 'U100', 'C109': 'U100'},   # D95: izolált DC-DC helye (DNP)                        # D90 után ezek nem fértek el: az állapot-LED-hez, a busz GND-jéhez
    ),
    'vezerlo': dict(
        size=(W4, L),
        # D87: az U4 a jobb élen, az antennája kifelé (az oldalfal felé), az előlapi ablak magasságában – a sorkapcsoktól, az RJ45-től
        # és az USB-C-től ≥ 15 mm-re. Fölötte a 3,3 V-os buck (a kimenete közvetlenül a 3V3-láb fölött), bal felül a betáp és a
        # GND-ági védelem, középen az 5 V-os buck, a csatlakozók alatt az U12/U3 (V_BUS) és a CAN; lent balra a LoRa (DNP) és
        # a W5500 az RJ45 fölött, jobbra a kezelőszervek (gombok, LED-ek) az előlapi ablakban.
        fixed={'J1': (8.6, 6, 'N'), 'J2': (21.5, 4.5, None), 'J3': (35.5, 4.5, None), 'JP1': (45.2, 4, None),
               'U4': (54.25, 34.85, 270), 'C27': (57.0, 22.75, 90), 'C26': (59.5, 22.5, 90),
               **blokk((51.5, 7.0), VEZ_U1), **blokk((25.75, 34.5), VEZ_U2),
               # betáp: F1 a J1 + lába alatt, Q1 (D78) a GND-lába alatt, a füle (GND_IN) felfelé; TVS, R7 + C1 a +24V_F-en (D7 – D90)
               'F1': (3.5, 14.5, 270), 'Q1': (10.5, 17.75, 90), 'D2': (3.5, 21.25, 270), 'R7': (8.5, 28.5, 270),
               'C1': (6.0, 37.25, 180),
               # VIN_BUCK: D8 (+24V_P) a betáp-oldalon, D3 (VUSB) az U6 és az U4 között (a VUSB alulról, az USB-C felől jön)
               'D8': (13.0, 28.5, 90), 'D3': (36.0, 38.0, 270),
               'U12': (21.5, 16.5, 0), 'U3': (25.0, 12.5, 0),
               # CAN: ESD a J2–J3 között, a fojtó (DNP) és a transceiver alatta; a TXD/RXD lefelé, az U4 felé
               'U7': (34.0, 10.5, 0), 'L2': (36.0, 17.0, 90), 'U6': (36.0, 24.0, 90), 'R25': (45.25, 9.5, 90),
               'J7': (3.25, 44.5, None), 'U10': (11.25, 56.0, 270),             # LoRa (DNP): az RF-láb (21) a J7 u.FL mellett
               'U5': (30.0, 55.0, 90), 'Y1': (30.0, 47.25, 0),                   # W5500: az MDI lefelé (J6), az SPI felfelé
               'U9': (45.5, 50.5, 0), 'SW1': (46.0, 61.5, 0), 'SW2': (55.5, 61.5, 0), 'D6': (64.0, 61.5, 0), 'D5': (64.0, 55.5, 0),
               'J6': (20, 76, 'S'), 'J4': (42, 82, 'S'), 'J8': (55, 82.5, 'S'), 'J5': (58.0, 75.75, 90)},
        anchors={},
        keepout=[(60.6, 20.8, W4, 48.9)],                                      # az antenna és ±4 mm – ide alkatrész sem kerül
        lock=['J1', 'J2', 'J3', 'JP1', 'U4', 'J6', 'J4', 'J8'],
        # lábhoz rendelés, fontossági sorrendben (az előbb elhelyezett kapja a lábhoz közelebbi helyet)
        pin_attach={'R3': 'U1', 'C9': 'U1', 'C4': 'U1', 'R54': 'U2', 'R55': 'U2',
                    'C40': 'Y1', 'C41': 'Y1', 'R47': 'U5', 'R40': 'U5', 'C29': 'U5', 'C30': 'U5',
                    **{f'C{i}': 'U5' for i in range(31, 40)}, 'C16': 'U5',
                    'R26': 'U4', 'R27': 'U4', 'C49': 'R26', 'C50': 'R27',              # USB: a 22 Ω-ok a modul lábainál
                    'C42': 'U6', 'C43': 'U6', 'C44': 'U6', 'R43': 'U6', 'R35': 'U6', 'JP4': 'L2', 'JP5': 'L2', 'D4': 'J2',
                    'D10': 'U12', 'C13': 'U12', 'C22': 'U3', 'C23': 'U3', 'C24': 'U3', 'C25': 'U3', 'R12': 'U3', 'C60': 'U3',
                    'D9': 'U3', 'R10': 'U3', 'R11': 'D9', 'R34': 'U3',
                    'R56': 'Q1', 'D12': 'Q1',
                    'R15': 'U4', 'C15': 'U4', 'R16': 'U4', 'R17': 'U4', 'R18': 'U4', 'R39': 'U4', 'R19': 'U4', 'C28': 'R19',
                    'R1': 'U4', 'R2': 'U4', 'C3': 'U4', 'R13': 'U4', 'R14': 'U4', 'C14': 'U4',
                    'C45': 'U9', 'C46': 'D6', 'R32': 'D6', 'R44': 'D5',
                    'U8': 'J4', 'R28': 'J4', 'R29': 'J4', 'D11': 'J4', 'R30': 'J4', 'C21': 'J4',
                    'R46': 'U10', 'C51': 'U10', 'C52': 'U10', 'U11': 'U10', 'R51': 'U10', 'R52': 'J8', 'R53': 'J8', 'R33': 'J5',
                    'R36': 'U5', 'R37': 'U5', 'R38': 'U5', 'R20': 'U5', 'R21': 'U5', 'R22': 'U5', 'R23': 'U5',
                    'C17': 'J6', 'C18': 'J6', 'R24': 'J6', 'C19': 'J6', 'C61': 'J6', 'C20': 'J6', 'R41': 'J6', 'R42': 'J6',
                    'JP2': 'U6', 'JP3': 'U6', 'TP1': 'F1', 'TP2': 'U12', 'TP3': 'L1', 'TP4': 'U3', 'TP5': 'U7', 'TP6': 'U7',
                    'TP7': 'U12'},
        antenna_of=('U4', 7.0, 'E'),      # az ESP32-C6-WROOM-1 antennarésze (~6,5 mm a modul végén) – rule area minden rétegen
    ),
    'led-modul': dict(
        size=(W4, L),
        # teljesítményút fentről lefelé: J201 → F201 → +24V_RAIL → F202–F204 → J202–J204; Q201 a GND-ágban a J201 mellett (D78);
        # a FET-ek drain-füle a kimenet felé, a szabadonfutó diódák és a blokk-biztosítékok a sorkapcsok fölött
        blokk=(33.0, 0),         # D86: modulmag-blokk a jobb felső részen; a betáp és a puffer balra
        fixed={'J201': (8.6, 6.5, 'N'),
               'Q201': (19.5, 8.5, None), 'F201': (9.5, 17, None), 'C203': (25.5, 28.5, None),
               'Q202': (5.5, 59.5, 'tabS'), 'Q203': (16.5, 59.5, 'tabS'), 'Q204': (28.5, 59.5, 'tabS'),
               'Q205': (39.5, 59.5, 'tabS'), 'Q206': (51.5, 59.5, 'tabS'), 'Q207': (62.5, 59.5, 'tabS'),
               'D211': (4.14, 69.3, 90), 'F202': (11.14, 69.3, None), 'D212': (18.14, 69.3, 90),
               'D213': (24.46, 69.3, 90), 'F203': (31.46, 69.3, None), 'D214': (38.46, 69.3, 90),
               'D215': (49.86, 69.3, 90), 'F204': (56.86, 69.3, None), 'D216': (63.86, 69.3, 90),
               'J202': (11.14, 79.8, 'S'), 'J203': (31.46, 79.8, 'S'), 'J204': (56.86, 79.8, 'S'),
               'R209': (22.5, 49.5, None),
               'U207': (34, 61, 90), **LED_SOR},    # D78: MCP9701A a FET-ek között (Q204–Q205)
        anchors={
                 'U206': (14, 40, 34, 54), 'U205': (0, 22, 14, 44)},
        attach={'C204': 'F202', 'C205': 'F203', 'C206': 'F204', 'D201': 'F201'},   # 10 µF / 50 V a blokkbiztosítékokhoz, TVS a főhöz
        # lábhoz rendelés (D86): a közös (nem GND) hálózatú lábhoz a lehető legközelebb – gate-ellenállás és -lehúzás a FET
        # gate-jéhez, a hidegítés a tápjához
        pin_attach={'R295': 'U6', 'R296': 'U6', 'C295': 'U6',       # D89: a HW_REV-osztó a blokkon kívül, a PB0 (26) mellett
                    'C211': 'U201', 'C210': 'U201', 'C213': 'U202', 'C212': 'U202', 'C215': 'U203', 'C214': 'U203',
                    **{f'R{210 + n}': f'Q{201 + n}' for n in range(1, 7)}, **{f'R{220 + n}': f'Q{201 + n}' for n in range(1, 7)},
                    'C240': 'U206', 'R207': 'U206', 'C243': 'U207', 'C208': 'U205', 'C209': 'U205', 'D202': 'Q201', 'R294': 'Q201'},
        lock=['J201', 'J2', 'J3', 'JP1', 'J202', 'J203', 'J204'],
    ),
    'bemeneti-modul': dict(
        # D100: 7 bemenet (IN0–IN6), 2 tápcsoport, 4 M-es lap (mint a többi modul)
        size=(W4, L),
        blokk=(0.5, 0),          # D86: modulmag-blokk a bal felső részen (mellette jobbra az I²C, az érzékelő-táp és a HDC3020)
        fixed={'U302': (64.5, 43, None)},        # HDC3020 a jobb szélen, a melegedő részektől távol (D66)
        lock=['J2', 'J3', 'JP1', 'J320'] + ['J3%02d' % i for i in range(1, 8)],
        # bemenetenként: felhúzó (csatlakozó-oldal) · soros 10 k · 10 nF · osztóhely (DNP) egy sorban a csatlakozó fölött;
        # az ESD-tömbök (MCU-oldali hálózatokon) a blokk jobb szélén, ahol a 7 jel az STM32 felé belép
        csatorna_oszlop={'esd': ['U303', 'U304'], 'esd_x': 37.5, 'esd_y0': 24.0},
        pin_attach={'R303': 'U6', 'R304': 'U6', 'C308': 'U6',       # D89: a HW_REV-osztó a blokkon kívül, a PB0 (26) mellett
                    'C303': 'U301', 'C302': 'U301', 'C330': 'U302', 'R371': 'J320', 'R372': 'J320', 'R374': 'J320', 'R375': 'J320',
                    'U307': 'J320', 'F305': 'J320', 'F301': 'J302', 'C304': 'J302', 'F302': 'J306', 'C305': 'J306',
                    'JP301': 'F301', 'JP302': 'F302', 'R300': 'J2',   # D94: V_BUS → +5V
                    'U300': 'U2', 'C300': 'U300', 'C309': 'U300', 'C326': 'U300'},   # D95: izolált DC-DC helye (DNP)
        anchors={'U301': (36, 10, 67, 24)},
        edge_rows={'N': (36, W4, ['J320']),                                                  # felső váll: I²C
                   'S': (0, W4, ['J3%02d' % i for i in range(1, 8)])},                      # alsó váll: a 7 bemenet
    ),
}


# ---------------------------------------------------------------------------------------------------------------
def load_fp(fpid):
    lib, name = fpid.split(':', 1)
    path = os.path.join(H, 'lib', 'modularis.pretty') if lib == 'modularis' else f'{SYS}/{lib}.pretty'
    fp = pcbnew.FootprintLoad(path, name)
    if fp is None:
        raise SystemExit(f'nincs footprint: {fpid}')
    fp.SetFPID(pcbnew.LIB_ID(lib, name))
    return fp


def mm(v):
    return pcbnew.FromMM(v)


def bbox_mm(fp):
    """courtyard-befoglaló (x0, y0, x1, y1) mm-ben, a lap koordinátáiban"""
    cy = fp.GetCourtyard(pcbnew.F_CrtYd)
    bb = cy.BBox() if cy.OutlineCount() else fp.GetBoundingBox(False)
    return (pcbnew.ToMM(bb.GetX()), pcbnew.ToMM(bb.GetY()),
            pcbnew.ToMM(bb.GetX() + bb.GetWidth()), pcbnew.ToMM(bb.GetY() + bb.GetHeight()))


def pads_centroid(fp, names=None):
    ps = [p for p in fp.Pads() if names is None or p.GetNumber() in names]
    if not ps:
        ps = list(fp.Pads())
    return (sum(pcbnew.ToMM(p.GetPosition().x) for p in ps) / len(ps),
            sum(pcbnew.ToMM(p.GetPosition().y) for p in ps) / len(ps))


def center_at(fp, cx, cy):
    """a courtyard középpontját (cx, cy)-ba (NYÁK-koordináta) teszi"""
    x0, y0, x1, y1 = bbox_mm(fp)
    pos = fp.GetPosition()
    fp.SetPosition(pcbnew.VECTOR2I(pos.x + mm(OX + cx - (x0 + x1) / 2), pos.y + mm(OY + cy - (y0 + y1) / 2)))


DIRV = {'N': (0, -1), 'S': (0, 1), 'W': (-1, 0), 'E': (1, 0)}


def orient(fp, mode):
    """forgatás úgy, hogy a csatlakozó nyílása / a vezeték-bevezetés (a courtyard a padokhoz képest) az él felé nézzen;
    'coilN': relé – a tekercs-lábak (A1/A2) felül; 'antN': ESP-modul – az antenna (a padok nélküli vég) felül"""
    if mode is None:
        return
    if isinstance(mode, (int, float)):
        fp.SetOrientationDegrees(mode)
        return
    best = None
    for rot in (0, 90, 180, 270):
        fp.SetOrientationDegrees(rot)
        x0, y0, x1, y1 = bbox_mm(fp)
        bc = ((x0 + x1) / 2, (y0 + y1) / 2)
        if mode == 'tabS':
            big = max(fp.Pads(), key=lambda p: p.GetSizeX() * p.GetSizeY())
            pc = (pcbnew.ToMM(big.GetPosition().x), pcbnew.ToMM(big.GetPosition().y))
            v, d = (pc[0] - bc[0], pc[1] - bc[1]), (0, 1)
        elif mode == 'coilN':
            pc = pads_centroid(fp, {'A1', 'A2'})
            v, d = (pc[0] - bc[0], pc[1] - bc[1]), (0, -1)
        elif mode == 'antN':
            pc = pads_centroid(fp)
            v, d = (bc[0] - pc[0], bc[1] - pc[1]), (0, -1)
        else:
            pc = pads_centroid(fp)
            v, d = (bc[0] - pc[0], bc[1] - pc[1]), DIRV[mode]
        score = v[0] * d[0] + v[1] * d[1]
        if best is None or score > best[0]:
            best = (score, rot)
    fp.SetOrientationDegrees(best[1])


def overlaps(r, rects):
    for q in rects:
        if r[0] < q[2] + GAP and r[2] + GAP > q[0] and r[1] < q[3] + GAP and r[3] + GAP > q[1]:
            return True
    return False


def try_place(fp, region, near, rects, size, forbid):
    """a régióban a `near` ponthoz legközelebbi szabad helyre (0,5 mm-es rács, 0°/90°)"""
    W, Hh = size
    best = None
    for rot in (0, 90):
        fp.SetOrientationDegrees(rot)
        x0, y0, x1, y1 = bbox_mm(fp)
        w, h = x1 - x0, y1 - y0
        rx0, ry0 = max(region[0], EDGE) + w / 2, max(region[1], EDGE) + h / 2
        rx1, ry1 = min(region[2], W - EDGE) - w / 2, min(region[3], Hh - EDGE) - h / 2
        if rx1 < rx0 or ry1 < ry0:
            continue
        cands = []
        x = rx0
        while x <= rx1 + 1e-6:
            y = ry0
            while y <= ry1 + 1e-6:
                cands.append(((x - near[0]) ** 2 + (y - near[1]) ** 2, x, y))
                y += 0.5
            x += 0.5
        cands.sort()
        for d, x, y in cands:
            if best and d >= best[0]:
                break
            r = (x - w / 2, y - h / 2, x + w / 2, y + h / 2)
            if not overlaps(r, rects) and not overlaps(r, forbid):
                best = (d, rot, x, y, r)
                break
    if not best:
        return None
    _, rot, x, y, r = best
    fp.SetOrientationDegrees(rot)
    center_at(fp, x, y)
    return r


def netlist(board):
    n = sx.parse(open(os.path.join(H, 'out', f'{board}.net')).read())
    comps = {}
    for c in sx.find(sx.first(n, 'components'), 'comp'):
        ref = sx.first(c, 'ref')[1]
        f = sx.first(c, 'footprint')
        sp = sx.first(sx.first(c, 'sheetpath'), 'tstamps')[1]
        # a rajz mezői (a Footprint kivételével), DNP / BOM-ból kizárás, lapnév – a NYÁK ↔ rajz egyezéshez
        fields = {}
        for fl in sx.find(sx.first(c, 'fields') or [], 'field'):
            nm = sx.first(fl, 'name')[1]
            if nm != 'Footprint':
                fields[nm] = fl[2] if len(fl) > 2 else ''
        props = {}
        for pr in sx.find(c, 'property'):
            v = sx.first(pr, 'value')
            props[sx.first(pr, 'name')[1]] = v[1] if v else ''
        comps[ref] = dict(fp=f[1] if f else None, value=sx.first(c, 'value')[1],
                          path=sp.rstrip('/') + '/' + sx.first(c, 'tstamps')[1], fields=fields,
                          dnp='dnp' in props, nobom='exclude_from_bom' in props,
                          sheetname=sx.first(sx.first(c, 'sheetpath'), 'names')[1], sheetfile=props.get('Sheetfile', ''))
    nets = {}
    for net in sx.find(sx.first(n, 'nets'), 'net'):
        nets[sx.first(net, 'name')[1]] = [(sx.first(x, 'ref')[1], sx.first(x, 'pin')[1]) for x in sx.find(net, 'node')]
    return comps, nets


def groups(comps, nets, anchors, fixed, attach=None):
    """minden nem rögzített alkatrész ahhoz a horgonyhoz (IC) tartozik, amellyel a legtöbb nem-táp hálózata közös;
    ami közvetlenül nem kapcsolódik, az a szomszédja csoportjába kerül"""
    adj = {r: {} for r in comps}
    for name, nodes in nets.items():
        if name.split('/')[-1] in POWER or name in POWER or len(nodes) > 12:
            continue
        refs = {r for r, _ in nodes}
        for a in refs:
            for b in refs:
                if a != b:
                    adj[a][b] = adj[a].get(b, 0) + 1
    grp = {a: a for a in anchors}
    for r in fixed:
        grp[r] = None
    for r, t in (attach or {}).items():         # kézi hozzárendelés (táphálózaton ülő elemek: TVS, puffer)
        if r in comps:
            grp[r] = t if t in anchors else '@' + t
    todo = [r for r in comps if r not in grp and comps[r]['fp']]
    for _ in range(6):
        left = []
        for r in todo:
            sc = {}
            for b, w in adj[r].items():
                g = grp.get(b)
                if g:
                    sc[g] = sc.get(g, 0) + w * (3 if b in anchors else 1)
            if sc:
                grp[r] = max(sc, key=sc.get)
            else:
                left.append(r)
        todo = left
    for r in todo:
        near_fixed = [b for b in adj[r] if b in fixed]
        grp[r] = '@' + max(near_fixed, key=lambda b: adj[r][b]) if near_fixed else '_misc'
    return grp


def add_stackup(path):
    """2 oz-os külső réz (outer_oz=2 a lap beállításában) – a KiCad 10 Python-felülete nem éri el a rétegrendet, ezért
    a mentett fájlba írjuk. D82 óta egyik lap sem használja (1 oz + fedetlen nagyáramú sávok, utólag ónozva)."""
    d = lambda n, t, th: f'(layer "dielectric {n}" (type "{t}") (thickness {th}) (material "FR4") (epsilon_r 4.5) (loss_tangent 0.02))'
    st = ('(stackup (layer "F.SilkS" (type "Top Silk Screen")) (layer "F.Paste" (type "Top Solder Paste")) '
          '(layer "F.Mask" (type "Top Solder Mask") (thickness 0.01)) (layer "F.Cu" (type "copper") (thickness 0.07)) '
          + d(1, 'prepreg', 0.2) + ' (layer "In1.Cu" (type "copper") (thickness 0.035)) ' + d(2, 'core', 1.0)
          + ' (layer "In2.Cu" (type "copper") (thickness 0.035)) ' + d(3, 'prepreg', 0.2)
          + ' (layer "B.Cu" (type "copper") (thickness 0.07)) (layer "B.Mask" (type "Bottom Solder Mask") (thickness 0.01)) '
          '(layer "B.Paste" (type "Bottom Solder Paste")) (layer "B.SilkS" (type "Bottom Silk Screen")) '
          '(copper_finish "None") (dielectric_constraints no))')
    t = open(path).read()
    assert '(stackup' not in t and t.count('(setup') == 1
    open(path, 'w').write(t.replace('(setup', '(setup\n\t\t' + st, 1))


def main():
    board = sys.argv[1]
    cfg = BOARDS[board]
    W, Hh = cfg['size']
    out = os.path.join(H, board, f'{board}.kicad_pcb')
    if os.path.exists(out) and '--force' not in sys.argv:
        raise SystemExit(f'{out} már létezik – kézi szerkesztés után az a forrás (D67); felülírás: --force')
    comps, nets = netlist(board)
    b = pcbnew.BOARD()
    b.SetCopperLayerCount(4)
    ds = b.GetDesignSettings()
    nc = ds.m_NetSettings.GetDefaultNetclass()
    nc.SetClearance(mm(0.15)); nc.SetTrackWidth(mm(0.2)); nc.SetViaDiameter(mm(0.6)); nc.SetViaDrill(mm(0.3))
    ds.m_TrackMinWidth = mm(0.127); ds.m_MinClearance = mm(0.127); ds.m_ViasMinSize = mm(0.45); ds.m_MinThroughDrill = mm(0.3)   # JLC: a 0,3 mm-es furat felár nélküli (D88 – az U3 via nélküli footprinttel)
    # körvonal
    rect = pcbnew.PCB_SHAPE(b, pcbnew.SHAPE_T_RECTANGLE)
    rect.SetStart(pcbnew.VECTOR2I(mm(OX), mm(OY))); rect.SetEnd(pcbnew.VECTOR2I(mm(OX + W), mm(OY + Hh)))
    rect.SetLayer(pcbnew.Edge_Cuts); rect.SetWidth(mm(0.1)); b.Add(rect)

    def guide(x0, y0, x1, y1, text, layer=pcbnew.Dwgs_User):
        s = pcbnew.PCB_SHAPE(b, pcbnew.SHAPE_T_RECTANGLE)
        s.SetStart(pcbnew.VECTOR2I(mm(OX + x0), mm(OY + y0))); s.SetEnd(pcbnew.VECTOR2I(mm(OX + x1), mm(OY + y1)))
        s.SetLayer(layer); s.SetWidth(mm(0.15)); b.Add(s)
        t = pcbnew.PCB_TEXT(b); t.SetText(text); t.SetLayer(layer)
        t.SetPosition(pcbnew.VECTOR2I(mm(OX + (x0 + x1) / 2), mm(OY + y0 + 1.5))); t.SetTextSize(pcbnew.VECTOR2I(mm(1), mm(1)))
        b.Add(t)

    guide(0, 0, W, SH, 'FELSŐ VÁLL (sorkapcsok, busz)')
    guide(0, Hh - SH, W, Hh, 'ALSÓ VÁLL (terepi csatlakozók)')
    guide(0, SH, W, Hh - SH, 'ELŐLAPI ABLAK (45 mm) – LED-ek fényvezetővel')
    forbid = []
    for k in cfg.get('keepout', []):
        guide(*k, 'ANTENNA – réz nélkül', pcbnew.Cmts_User)
        forbid.append(k)
    if 'hv' in cfg:
        guide(*cfg['hv'], '230 V – ≥ 8 mm a törpefeszültségtől', pcbnew.Cmts_User)
    # hálózatok
    ni = {}
    for name in nets:
        n_ = pcbnew.NETINFO_ITEM(b, name); b.Add(n_); ni[name] = n_
    padnet = {}
    for name, nodes in nets.items():
        for r, p in nodes:
            padnet[(r, p)] = ni[name]
    # footprintek
    fps = {}
    for ref, c in sorted(comps.items()):
        if not c['fp']:
            continue
        fp = load_fp(c['fp'])
        fp.SetReference(ref); fp.SetValue(c['value'])
        fp.SetPath(pcbnew.KIID_PATH(c['path']))
        fp.SetSheetname(c['sheetname']); fp.SetSheetfile(c['sheetfile'])
        fp.SetDNP(c['dnp']); fp.SetExcludedFromBOM(c['nobom'])
        for nm, v in c['fields'].items():
            fp.SetField(nm, v)
            if nm not in ('Datasheet', 'Description'):
                fl = fp.GetField(nm); fl.SetVisible(False); fl.SetLayer(pcbnew.F_Fab)
        for p in fp.Pads():
            n_ = padnet.get((ref, p.GetNumber()))
            if n_:
                p.SetNet(n_)
        b.Add(fp)
        fps[ref] = fp
    rects, report, unplaced = [], [], []
    fixed = {r: v for r, v in cfg['fixed'].items() if r in fps}
    if 'blokk' in cfg:                                   # D86: a modulmag-blokk rögzített elemként
        bx, by = cfg['blokk']
        fixed.update({r: (bx + dx, by + dy, rot) for r, (dx, dy, rot) in MODULMAG_BLOKK.items() if r in fps})
    # él menti PH-sorok (bemeneti modul)
    for edge, (xa, xb, refs) in cfg.get('edge_rows', {}).items():
        refs = [r for r in refs if r in fps]
        ws = []
        for r in refs:
            orient(fps[r], edge)
            q = bbox_mm(fps[r])
            ws.append(q[2] - q[0])
        gap = (xb - xa - sum(ws)) / (len(refs) + 1)          # egyenletes hézag a valódi szélességekkel
        x = xa + gap
        for r, w_ in zip(refs, ws):
            fixed[r] = (x + w_ / 2, 4.5 if edge == 'N' else Hh - 4.5, edge)
            x += w_ + gap
    if cfg.get('csatorna_oszlop'):                       # D86: bemenetenként egy oszlop a csatlakozó mellett
        noded = {}
        for name, nodes in nets.items():
            for rr, pp in nodes:
                noded[(rr, pp)] = name
        def masik(ref, net):
            return [n_ for (rr, pp), n_ in noded.items() if rr == ref and n_ != net]
        for j in [r for r in fixed if r.startswith('J3') and len(r) == 4 and r[2:].isdigit() and r != 'J320']:
            sig = noded.get((j, '3'))
            if not sig:
                continue
            on_sig = [rr for rr, _ in nets[sig] if rr.startswith('R')]
            felh = [rr for rr in on_sig if any(n_.split('/')[-1].startswith('SUP') for n_ in masik(rr, sig))]
            soros = [rr for rr in on_sig if rr not in felh]
            mcu = masik(soros[0], sig)[0] if soros else None
            tobbi = sorted([rr for rr, _ in nets[mcu] if rr[0] in 'RC' and rr not in soros]) if mcu else []
            sor = felh + soros + [rr for rr in tobbi if rr.startswith('C')] + [rr for rr in tobbi if rr.startswith('R')]
            cx, cy, e = fixed[j]
            yy = cy + 5.1 if e == 'N' else cy - 5.1
            for i, rr in enumerate(sor[:4]):
                fixed[rr] = (cx + (i - 1.5) * 2.1, yy, 90)
        for i, u in enumerate(cfg['csatorna_oszlop'].get('esd', [])):
            fixed[u] = (cfg['csatorna_oszlop']['esd_x'], cfg['csatorna_oszlop']['esd_y0'] + i * 4.0, 90)
    fixed_c = {}
    for ref, (x, y, mode) in fixed.items():
        fp = fps[ref]
        orient(fp, mode)
        center_at(fp, x, y)
        r = bbox_mm(fp)
        r = (r[0] - OX, r[1] - OY, r[2] - OX, r[3] - OY)
        fixed_c[ref] = ((r[0] + r[2]) / 2, (r[1] + r[3]) / 2)
        if overlaps(r, rects):
            report.append(f'ÜTKÖZÉS (rögzített): {ref}')
        if r[0] < 0 or r[1] < 0 or r[2] > W or r[3] > Hh:
            report.append(f'LELÓG a NYÁK-ról (rögzített): {ref} {tuple(round(v, 1) for v in r)}')
        rects.append(r)
    anchors = {r: v for r, v in cfg['anchors'].items() if r in fps}
    grp = groups(comps, nets, anchors, fixed, cfg.get('attach'))
    hv = cfg.get('hv')
    if 'blokk' in cfg:                                   # D86: a modulmag-blokkba más alkatrész nem kerül
        bx, by = cfg['blokk']
        forbid.append((bx, by, bx + BLOKK_MERET[0], by + BLOKK_MERET[1]))
    lv_forbid = forbid + ([hv] if hv else [])
    # horgonyok a régiójuk közepére, aztán a csoportjuk köréjük (nagyobbak előbb)
    order = list(anchors)
    centers = {}
    for a in order:
        reg = anchors[a]
        near = ((reg[0] + reg[2]) / 2, (reg[1] + reg[3]) / 2)
        r = try_place(fps[a], reg, near, rects, (W, Hh), lv_forbid)
        if not r:
            r = try_place(fps[a], (0, 0, W, Hh), near, rects, (W, Hh), lv_forbid)
        if not r:
            unplaced.append(a); continue
        rects.append(r)
        centers[a] = ((r[0] + r[2]) / 2, (r[1] + r[3]) / 2)
    pinatt = {r: tgt for r, tgt in cfg.get('pin_attach', {}).items() if r in fps and tgt in fps and r not in fixed}
    hasznalt = {}
    tap = lambda n: n.split('/')[-1] in POWER
    for r, tgt in pinatt.items():                       # D86: a közös (nem GND) hálózatú láb mellé
        hal = {p.GetNetname() for p in fps[r].Pads() if p.GetNetname() and p.GetNetname() != 'GND'}
        # D87: a jelláb előbb (pl. a felhúzó a jel-, nem a 3V3-lábhoz); több azonos hálózatú lábnál (a W5500 hat VDD-je) sorban
        # mindegyikhez jut egy
        pads = [p for p in fps[tgt].Pads() if p.GetNetname() in hal and not tap(p.GetNetname())] or \
            [p for p in fps[tgt].Pads() if p.GetNetname() in hal] or list(fps[tgt].Pads())
        pad = min(pads, key=lambda p: hasznalt.get((tgt, p.GetNumber()), 0))
        hasznalt[(tgt, pad.GetNumber())] = hasznalt.get((tgt, pad.GetNumber()), 0) + 1
        px = pcbnew.ToMM(pad.GetPosition().x) - OX
        py = pcbnew.ToMM(pad.GetPosition().y) - OY
        got = try_place(fps[r], (px - 7, py - 7, px + 7, py + 7), (px, py), rects, (W, Hh), lv_forbid) or \
            try_place(fps[r], (0, 0, W, Hh), (px, py), rects, (W, Hh), lv_forbid)
        if got:
            rects.append(got)
        else:
            unplaced.append(r)
    members = {}
    for r, g in grp.items():
        if g and r not in anchors and r not in fixed and r in fps and r not in pinatt:
            members.setdefault(g, []).append(r)
    for g, refs in members.items():
        refs.sort(key=lambda r: -((bbox_mm(fps[r])[2] - bbox_mm(fps[r])[0]) * (bbox_mm(fps[r])[3] - bbox_mm(fps[r])[1])))
        reg = anchors.get(g, (0, 0, W, Hh))
        near = fixed_c[g[1:]] if g.startswith('@') else centers.get(g, ((reg[0] + reg[2]) / 2, (reg[1] + reg[3]) / 2))
        for r in refs:
            # a 230 V-os tartományba csak a relé-érintkezőhöz tartozó elemek mehetnének – ide semmi más
            got = try_place(fps[r], reg, near, rects, (W, Hh), lv_forbid) or \
                try_place(fps[r], (0, 0, W, Hh), near, rects, (W, Hh), lv_forbid)
            if got:
                rects.append(got)
            else:
                unplaced.append(r)
    # szabályzónák: 230 V (belső rétegeken nincs réz a nagyfeszültségű rész alatt és körülötte 8 mm-en belül),
    # antenna (egyik rétegen sincs réz az ESP-modul antennája alatt)
    def rule_area(rect, layers, name):
        z = pcbnew.ZONE(b)
        z.SetIsRuleArea(True); z.SetZoneName(name)
        z.SetDoNotAllowTracks(True); z.SetDoNotAllowVias(True); z.SetDoNotAllowZoneFills(True)
        z.SetDoNotAllowPads(False); z.SetDoNotAllowFootprints(False)
        ls = pcbnew.LSET()
        for l in layers:
            ls.AddLayer(l)
        z.SetLayerSet(ls)
        o = z.Outline(); o.NewOutline()
        x0, y0, x1, y1 = rect
        for x, y in ((x0, y0), (x1, y0), (x1, y1), (x0, y1)):
            o.Append(mm(OX + x), mm(OY + y))
        b.Add(z)
    if 'hv_parts' in cfg:
        ys_hv = []
        for r in cfg['hv_parts']:
            for pd in fps[r].Pads():
                if pd.GetNumber() not in ('A1', 'A2'):
                    ys_hv.append(pcbnew.ToMM(pd.GetPosition().y) - OY - pcbnew.ToMM(pd.GetSize().y) / 2)
        y_hv = min(ys_hv)
        rule_area((0, y_hv - 8, W, Hh), (pcbnew.In1_Cu, pcbnew.In2_Cu), 'HV_230V_belso_retegek')
        guide(0, y_hv - 8, W, y_hv, f'≥ 8 mm: SELV-réz egyik rétegen sem (a 230 V-os pad {y_hv:.1f} mm-nél kezdődik)', pcbnew.Cmts_User)
        report.append(f'230 V: a legfelső nagyfeszültségű pad y = {y_hv:.1f} mm → belső rétegeken réz-tiltás {y_hv - 8:.1f} mm-től')
    if 'antenna_of' in cfg:
        ref_a, depth, *irany = cfg['antenna_of']
        q = bbox_mm(fps[ref_a])
        if irany == ['E']:                              # D87: az antenna a jobb él felé, ±4 mm-rel a két oldalán
            rect = (q[2] - OX - depth, q[1] - OY - 4, W, q[3] - OY + 4)
        else:
            rect = (q[0] - OX - 1, 0, W, q[1] - OY + depth)
        rule_area(rect, (pcbnew.F_Cu, pcbnew.In1_Cu, pcbnew.In2_Cu, pcbnew.B_Cu), 'ANTENNA_keepout')
        report.append(f'antenna-tiltás: {tuple(round(v, 1) for v in rect)} minden rézrétegen')
    zar = set(cfg.get('lock', []))
    for r in fps:                                        # D86: minden nem zárolt alkatrész rácsra (a footprint origója)
        if r not in zar and r not in unplaced:
                p = fps[r].GetPosition()
                g = lambda v, o: mm(o + round((pcbnew.ToMM(v) - o) / BLOKK_RACS) * BLOKK_RACS)
                fps[r].SetPosition(pcbnew.VECTOR2I(g(p.x, OX), g(p.y, OY)))
    for r in cfg.get('lock', []):                       # D86: mechanikailag kötött helyű alkatrészek zárolva
        if r in fps:
            fps[r].SetLocked(True)
    # ami nem fért el: a NYÁK mellé, jól láthatóan
    for i, r in enumerate(unplaced):
        center_at(fps[r], W + 10 + (i % 4) * 9, 5 + (i // 4) * 9)
    pcbnew.SaveBoard(out, b)
    if cfg.get('outer_oz', 1) == 2:
        add_stackup(out)
    area = sum((q[2] - q[0]) * (q[3] - q[1]) for q in rects)
    print(f'{board}: {len(fps)} footprint, elhelyezve {len(fps) - len(unplaced)}, NEM FÉRT EL: {len(unplaced)} {unplaced}')
    print(f'  courtyard-kihasználtság: {area:.0f} / {W * Hh:.0f} mm² = {100 * area / (W * Hh):.0f} %')
    for line in report:
        print('  ' + line)
    print('  ->', out)


if __name__ == '__main__':
    main()
