Cloudhunter77/szakdolgozat/(commit log)

2026-09-30 Matter tanulási terv hozzáadása
    4 órás labor: ESP-Matter light példa, párosítás Home Assistantba,
    saját 5 csatornás LED-meghajtó és 4 relés, több endpointos eszköz.
2026-10-09 Matter over Thread C6 projekt (esp-matter v1.6 alap) – még teszteletlen
    Ismert hiba: a firmware/main/CMakeLists.txt PRIV_INCLUDE_DIRS-e a
    "../../common/utils" mappára mutat, ami nem létezik (az esp-matter
    példákból maradt). Az első build valószínűleg ezen elhasal – javítani kell.
    [partitions.csv]
2026-10-09 Matter: párosítási tanulságok a dokumentációban
    - README: Developer Console mentése, HA Matter Server „Enable test-net DCL usage”
    - CLAUDE.md: QR kód ellenőrzése a logból, a log script resetel, két fabric (Google + HA),
    az attesztációs hiba felismerése
2026-10-09 Dokumentáció: konzulensi összefoglaló – Matter over Thread, cp-02
2026-10-09 Checkpoint: cp-02 Matter over Thread + Home Assistant
2026-10-09 Dokumentáció: cp-02 pontosítás – szín csak részben, BOOT gomb működik
    A diagnosztikai log szerint a HA a színválasztóból MoveToColor (XY) parancsot küld,
    a gyári driver csak a hue/saturation és a színhőmérséklet attribútumot kezeli.
2026-10-11 Kontextus: chat-jegyzetek – LED-meghajtó breadboard, node/modul architektúra
    Claude-Session: https://claude.ai/code/session_01TxctCd24okXHPtDWLQus53
2026-10-11 Kontextus: döntések D15–D25 (CCT szalag, végleges LED-modul, CAN, Matter-híd), D06 elvetve
    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
2026-10-11 Kontextus: áttekintés – node/modul architektúra, NYÁK-határidő, nyitott kérdések
    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
2026-10-11 Kontextus: STM32F303RET6 – CAN megerősítve, D04 elvetve, matter-c6 terv a hídra
    - D26: modul MCU = STM32F303RET6 (8 db, bxCAN), CAN a PA11/PA12 lábakon, csereút: STM32G431RBT6
    - D19 feltétele teljesül; D04 (TCA9554) elvetve
    - ATTEKINTES: blokkoló kérdés lezárva; NAPLO: 2026-10-11
    - matter-c6/CLAUDE.md: a következő fázis a Matter-híd (D21)
2026-10-14 Kontextus: Projekt-szinkron 2026-10-13/14 – specifikációk, D27–D61
    - Új: MODULMAG-SPEC.md, VEZERLO-SPEC.md, SAMPLE-KERESEK.md, NYAK-ELOKESZITES.md, V2-OTLETEK.md
    - Új chat-jegyzetek: CAN-izoláció/STM32F303, NYÁK-előkészítés/modulmag, alkatrészkészlet/P78E05, vezérlő-spec
    - DONTESEK.md: D27–D61; a repó D26-ja (STM32F303RET6) a Projekt számozásában D27, D26 = projektnév
    - ATTEKINTES.md: a Projekt 2026-10-14-i változata
    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
2026-10-14 Kontextus: ütemterv a NYÁK-rendelésig (10-14 → 10-31)
2026-10-14 Hardver: KiCad 10 projektváz (vezérlő, modulmag, 3 modul, közös könyvtár)
    [bemeneti-modul.kicad_sch, led-modul.kicad_sch, modulmag.kicad_sch, rele-modul.kicad_sch, vezerlo.kicad_sch]
2026-10-14 Hardver: modulmag + vezérlő kapcsolási rajz (vázlat, ERC tiszta)
    Elektromosan a MODULMAG-SPEC és a VEZERLO-SPEC szerint, elrendezés nélkül.
    Közös könyvtár: saját szimbólumok, ESP32-C6-WROOM-1/-1U footprint (Espressif,
    CC-BY-SA, licenc a lib/-ben). A KiCad .history/ mappája gitignore-ba.
    [modulmag.kicad_sch, vezerlo.kicad_sch]
2026-10-14 Hardver: modulmag – PTC (F2) ki a V_BUS-ról, TVS marad (D55)
    A J2/J3 V_BUS-a közvetlenül a V_BUS_P; a D5 TVS az ESD / hot-plug ellen.
    A HW-ID osztó továbbra is a modul saját lapján (a modulmag csak HW_ID-t ad).
    [modulmag.kicad_sch]
2026-10-14 Kontextus: D55 lezárva, D62 relémodul, D63 WROOM-footprint, D64 V_BUS-mérleg
    - D55: nincs 24 V elleni védelem a V_BUS-on, PTC ki, TVS marad
    - D62: Schrack RTD14024, COM + NO (4 × 2 pólus), 230 V-ra tervezve
    - D63: WROOM-1 és -1U ugyanazon a footprinten (az EPAD is egyezik)
    - D64: V_BUS 5 V / 425 mA marad; a mérleg pontosítva (73 mA csak az adón)
    - MODULMAG-SPEC 3.5: HW-ID osztó a modul lapján, kerekítő sávképzés
    - SAMPLE-KERESEK, NYAK-ELOKESZITES, UTEMTERV, ATTEKINTES frissítve
2026-10-14 Hardver: relémodul kapcsolási rajz (vázlat) + modulmag hierarchikus lapként
    ULN2803A + 4 × Schrack RTD14024, kimenet COM + NO (D62), csatornánként
    visszajelző LED, HW-ID 10k/10k (4. sáv). A modulmag kiadja a +24V_P-t is
    (relétáp), és mindhárom modulprojekthez tartalmazza a hivatkozásokat.
    ERC: 0 hiba (4 lib_symbol_mismatch figyelmeztetés a relé-szimbólumon).
    [modulmag.kicad_sch, rele-modul.kicad_sch]
2026-10-14 Hardver: vázlat-generátor szkriptek a repóba (hardware/gen)
    kigen.py + sx.py (KiCad S-kifejezés író), laponként egy generátor
    (modulmag, vezerlo, rele-modul), build.sh: generálás + ERC + netlista + PDF
    + footprint-ellenőrzés. A KiCad-könyvtár másolata (gen/kilib/) nincs a repóban.
2026-10-14 Hardver: LED-modul kapcsolási rajz (vázlat) + generátor
    6 low-side csatorna (NTD5C648NL, 3 × UCC27524, B360B szabadonfutó, RC snubber
    DNP), blokkonként SMD biztosíték, ideális dióda (LM74700-Q1 + NTMFS5C604NL)
    a 20 A-es ágon, gate- és drain-LED-ek, drain → ADC, 1 mΩ sönt + INA181A2,
    NTC, MC78L12, HW-ID 2. sáv. DRV_EN-lehúzás 1 kΩ (D65). ERC: 0 hiba.
    [led-modul.kicad_sch]
2026-10-14 Kontextus: D65 – LED-modul részletei, sample-lista, lábkiosztás
    - D65: FET, blokk-biztosítékok, LED-ek, drain-mérés, snubber, ideális dióda
    - MODULMAG-SPEC 7: PA0–PA3, PA5, PA6 = drain-mérés; DRV_EN-lehúzás 1 kΩ
    - SAMPLE-KERESEK: + LM74700-Q1 (TI), + NTMFS5C604NL, B360B (onsemi),
    Littelfuse NANO² biztosítékok
    - ATTEKINTES: LED-modul sor
2026-10-16 Hardver: bemeneti modul kapcsolási rajz + HDC3020 + buszos táp opció
    16 bemenet JST-PH-n (1k + 10k felhúzás + 10 nF, osztó-footprint, ESD),
    4 érzékelő-tápcsoport (3,3 / 5 V forrasztható választó + PTC, külön NCP1117),
    HDC3020 (saját szimbólum + DEF0008A footprint) + külső I²C PH-csatlakozó.
    Modulmag: opcionális buszos táp (D6 + JP2, alapból üres) – D66. ERC: 0 hiba.
    [bemeneti-modul.kicad_sch, modulmag.kicad_sch]
2026-10-16 Kontextus: D66 – bemeneti modul, B változat elvetve, buszos táp opció
    - D66: saját 24 V (A változat), érzékelő-tápcsoportok, bemeneti fokozat,
    HDC3020 + külső I²C, buszos táp (D6 + JP2)
    - MODULMAG-SPEC: B változat elvetve, V_BUS-mérleg, PC2 = HDC_ALERT, FT-lábak
    - VEZERLO-SPEC, ATTEKINTES, NYAK-ELOKESZITES, UTEMTERV, SAMPLE-KERESEK frissítve
2026-10-19 Hardver: mind az öt kapcsolási rajz elrendezve (vezetékes, blokkos), netlista-ellenőrzővel
    Funkcionális blokkok, balról jobbra jelút, tápsín felül / GND alul; blokkon belül
    vezeték, blokkok között és az IC-lábakon címke. kigen: lábpozíció, place(),
    wire/junction/rail, tükrözés, 1,27 mm-es rács, olvasható mezők. gen/netcmp.py:
    két netlista lábszintű összevetése – a bekötés az átrendezés előttivel azonos
    (a modulmag D66-os D6/JP2-jét kivéve). ERC: 0 hiba mind az öt lapon.
    [bemeneti-modul.kicad_sch, led-modul.kicad_sch, modulmag.kicad_sch, rele-modul.kicad_sch, vezerlo.kicad_sch]
2026-10-19 Kontextus: TI sample-kérés elküldve, TI-rendelés leadva
2026-10-19 Hardver: kapcsolási rajzok olvashatósága (KiCad MCP vizuális ellenőrzés alapján), output/ gitignore
    [bemeneti-modul.kicad_sch, led-modul.kicad_sch, modulmag.kicad_sch, rele-modul.kicad_sch, vezerlo.kicad_sch]
2026-10-19 Kontextus: D67 – a kapcsolási rajz forrása kézi szerkesztés után a .kicad_sch, napló, áttekintés, ütemterv
2026-10-19 Hardver: átnézés (C320 javítva), LoRa-előkészítés (D68), bővítők (D69), R6/R7 = 0 Ω (D70)
    - bemeneti modul: a HDC3020 hidegítője C330 lett (a C320 kétszer szerepelt);
    a generátor mostantól hibát dob duplikált jelölésre
    - vezérlő: E22-900M22S LoRa + u.FL + 74LVC1G04, minden DNP; J8 bővítő (GPIO5),
    7 mérőpont; spec szerinti DNP-k (USB C, 1 MΩ, PMODE, CAN-fojtó + áthidalók);
    saját footprint az LMR36015-höz (RNX) és az E22-höz
    - modulmag: HW_REV osztó (PB0), DNP J4 2 × 5 bővítő; relé: DNP SCT-013 → PA0
    - mind az öt lap vizuálisan rendbe téve; R6/R7 = 0 Ω
    - specek és döntésnapló frissítve (D68–D70)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
    [bemeneti-modul.kicad_sch, led-modul.kicad_sch, modulmag.kicad_sch, rele-modul.kicad_sch, vezerlo.kicad_sch]
2026-10-20 Hardver: STM32CubeMX-projektek a három modulhoz, lábkiosztás ellenőrizve
    - gen/cubemx.py: .ioc a MODULMAG-SPEC 7. fejezetéből (jelnevek a CubeMX 6.18 adatbázisából)
    - CubeMX-ben: nincs lábütközés; COMP2 INM = DAC1_CH1 és COMP2 → TIM1/TIM8 BKIN2 választható
    - megkötés: a HDC3020 ALERT (PC2) nem kaphat EXTI-t (az IN2 foglalja), lekérdezéssel megy
2026-10-20 Hardver: központi 5 V, közös föld, 12–26 V, HW-ID 16 sáv (D71)
    Vezérlő: LMR33630 (5,2 V) + LM66200 (USB-vel VAGY-olva) + TPS259531 eFuse (2 A);
    F1 2 A, D1 B360 a 12 V-os működéshez. Modulmag: táp a buszról (AP2112K), TCAN1044AV,
    nincs izoláció, PC1 = VBUS_SENSE. LED/relé: VIN_SENSE a PB11-en, relémodul saját
    tekercs-táppal. Bemeneti modul: nincs 24 V. HW-ID/HW_REV 16 sáv. Specifikációk,
    áttekintés, beszerzés, ütemterv frissítve.
    [bemeneti-modul.kicad_sch, led-modul.kicad_sch, modulmag.kicad_sch, rele-modul.kicad_sch, vezerlo.kicad_sch]
2026-10-20 Hardver: footprintek a gyártói rajzokkal ellenőrizve, W5500 MDI a WIZnet-referencia szerint (D72)
    E22 padok ±7,0 mm-re (két referencia-footprinttel egyezik), TPS2595 ThermalVias,
    LMR36015 RNX és LM66200 DRL összevetve. W5500 RX: soros 6,8 nF, a lezárás közepe
    az RCT-re + 10 nF, a MagJack 8-as lába és árnyékolása ETH_CGND (1 nF / 2 kV).
    [vezerlo.kicad_sch]
2026-10-20 Kontextus: DIN-ház és NYÁK-méret (D73) – Gainta D4MG, 86,5 × 68 mm, bemeneti modul 6 M
2026-10-20 Hardver: NYÁK-előkészítés – körvonal, rétegek, footprintek és kezdő elhelyezés mind a négy lapon; HDC3020 footprint javítva
    pcbgen.py: 86,5 × 68 mm (bemeneti 86,5 × 103 mm), DIN-zónák, a footprintek a hálózatokkal és a
    kapcsolási rajzhoz kötve; csatlakozók a ház szerinti élen, a többi a saját IC-je köré.
    HDC3020 (DEF0008A): padsorok ±1,15 mm a TI-rajz szerint (a hűtőpad rálógott a lábakra).
    Min. furat 0,2 mm (TPS2595 hűtőpad-viák).
    [bemeneti-modul.kicad_pcb, led-modul.kicad_pcb, rele-modul.kicad_pcb, vezerlo.kicad_pcb]
2026-10-22 Hardver: szakértői javítások (D74–D77), STM32L433 + SN65HVD230 + GND-ági polaritásvédelem (D78–D81), teljes ellenőrzés
    - D74–D77: busz-GND ellenállás, CAN-fojtó-hely, TVS a +5V_BUCK-on és a VUSB-n, bemenetvédelem,
    230 V-os és antenna-tiltás a NYÁK-on, SCT-jack footprint
    - D78–D80: modul-MCU STM32L433RCT3 (VIN_SENSE PB1, LED: TIM15/TIM16, I_SENSE PA3), modul-transceiver
    SN65HVD230, N-FET a GND-ágban (vezérlő Q1, LED Q201, relé Q100), MCP9701A, táp-LED a +5V-ról,
    2 oz a LED-/relémodulon, AP2112K marad; D81 javaslat (TPD4E02B04 a bemeneteken)
    - CubeMX-projektek L433-ra, fejsoros kódgenerálással ellenőrizve (minden periféria inicializálódik)
    - gen/ell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
    [bemeneti-modul.csv, bemeneti-modul.kicad_pcb, bemeneti-modul.kicad_sch, led-modul.csv, led-modul.kicad_pcb, led-modul.kicad_sch, modulmag.kicad_sch, rele-modul.csv]
2026-10-22 Hardver: determinisztikus UUID-k – a NYÁK-footprintek újra a rajzi szimbólumokra mutatnak
    - kigen: a szimbólum-UUID a projekt + hivatkozási jel alapján (uuid5), a többi elemé laponként sorszámból –
    két generálás bájtra azonos fájlt ad, és az újragenerálás nem töri el a „Update PCB from Schematic”-ot (D67)
    - a négy NYÁK újragenerálva: mind a 581 footprint a saját szimbólumára mutat (előtte egy sem)
    - ellenorzes.py: új ellenőrzés a NYÁK ↔ rajz szimbólum-kapcsolatra; teljes futás: 0 hiba
    - README, NAPLO
    [bemeneti-modul.kicad_pcb, bemeneti-modul.kicad_sch, led-modul.kicad_pcb, led-modul.kicad_sch, modulmag.kicad_sch, rele-modul.kicad_pcb, rele-modul.kicad_sch, vezerlo.kicad_pcb]
2026-10-22 Hardver: 1 oz + fedetlen nagyáramú sávok (D82), reprodukálható rajzgenerálás; kontextus: rajzlezárás
    - D82: minden NYÁK 1 oz (a JLC 2 oz-nál ≥ 0,2 mm szélességet/távolságot kér, az LQFP-64 rése épp ennyi);
    a nagyáramú sávok fedetlenek, utólag ónozva / vezetékkel – leírás a NYAK-ELOKESZITES-ben (a söntöt nem ónozni)
    - LED- és relé-NYÁK újragenerálva 1 oz-zal; az ellenőrző az 1 oz-ot figyeli
    - kigen: minden egységpéldány a szimbólum összes lábát felsorolja → a „sch upgrade” nem pótol véletlen UUID-t,
    mind az öt rajz bájtra reprodukálható
    - kontextus: ATTEKINTES (rajzok lezárva 10-22), UTEMTERV, NAPLO, DONTESEK D82; komponenslista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
    [led-modul.kicad_pcb, rele-modul.kicad_pcb, vezerlo.kicad_sch]
2026-10-22 Hardver: relékimenet 5,08 mm-es THT sorkapocs (D83), D81 elvetve – marad a TPD4E05U06
    Claude-Session: https://claude.ai/code/session_01KVtZMUPbtveTXy9VyJshyt
    [bemeneti-modul.kicad_sch, rele-modul.kicad_sch]
2026-10-22 Hardver: legolcsóbb beszerzés (D84) – Hestore + DigiKey, a rajz a kapható típusokra igazítva; beszerzési lista
    - gen/beszerzes.py → bom/beszerzes.csv: BOM-tételenként forrás, Hestore-kód, nettó ár, készlet
    - J1/J100 Degson DG250, J201 DG128 (15 A), J202–J204 KF128, F201 15 A; L1/L3 HPI0630 (saját footprint);
    R209 CRE2512; C40/C41 12 pF; ESP32-C6-WROOM-1-N8; SS56C, BAT54HT1G, STPS3L60U, BLM18EG221
    - NYÁK-ok újragenerálva (a layout még nem indult el); bekötés változatlan, ellenorzes.py: 0 hiba
    - SAMPLE-KERESEK: az NTMFS5C604NL nincs kézben (javítva)
    Claude-Session: https://claude.ai/code/session_01KVtZMUPbt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
    [bemeneti-modul.csv, bemeneti-modul.kicad_pcb, beszerzes.csv, led-modul.csv, led-modul.kicad_pcb, led-modul.kicad_sch, modulmag.kicad_sch, rele-modul.csv]
2026-10-22 Hardver: legolcsóbb beszerzés LCSC-ről (D85), megszűnt FET-ek pótlása, LCSC-kosárlista
    - gen/lcsc.py: LCSC-árak a JLC alkatrészkeresőjéből; gen/beszerzes.py soronként a legolcsóbb forrás (Hestore / LCSC, ÁFA-val)
    - bom/lcsc-kosar.csv: 99 tétel (~15 eFt), az LCSC BOM Tooljába feltölthető; házak később, ST-Link/Nucleo kézben
    - Q202–Q207 NTD5C648NL → NCE6080K, Q201 NTMFS5C604NL → NCEP6090AGU (nem kaphatók), F201 → NANO² 15 A,
    D211–D216 SS56B, J1/J100 DG128, L1/L3 LCSC-s 0630-as tekercs, kis ESR-ű kvarcok
    - bekötés változatlan (netlista 0 / 0), ellenorzes.py: 0 hiba
    Claude-Session: https://claude.a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
    [bemeneti-modul.csv, beszerzes.csv, lcsc-kosar.csv, led-modul.csv, led-modul.kicad_pcb, led-modul.kicad_sch, modulmag.kicad_sch, rele-modul.csv]
2026-10-23 Hardver: kézzel átrendezett kapcsolási rajzok (D67), védelem a generátor felülírása ellen; rajzdátum 10-23
    - mind az öt lap kézi szerkesztésű – gen/kezi-lapok.txt; a build.sh ezeket nem generálja újra, csak ellenőrzi (felülírás: --force)
    - bekötés változatlan (netlista 0 / 0), ERC rendben, ellenorzes.py: 0 hiba
    - komponenslista: állapot 10-23
    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
    [bemeneti-modul.kicad_sch, led-modul.kicad_sch, modulmag.kicad_sch, rele-modul.kicad_sch, vezerlo.kicad_sch]
2026-10-23 Hardver: konzulensi PDF egy paranccsal (gen/pdf.sh) – minden lap egyszer, a komponenslista sorrendjében
    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
2026-10-23 Hardver: layout-előkészítés (D86) – JLC-szabályok és via-méretek, modulmag-blokk, a modulok elrendezése
    - laponként .kicad_dru: JLC 4 réteg / 1 oz; via 0,3/0,45 (jel), 0,4/0,7 (táp), 0,6/1,0 mm (15 A); 230 V ↔ SELV 8 mm
    - modulmag-blokk mindhárom modulon azonos relatív elrendezéssel (átvihető layout), 0,25 mm-es rács
    - a sorkapcsok a Gainta D4MG fedélfurataira igazítva (5,08 mm), a kötött helyű alkatrészek zárolva
    - LED-modul: LED-sor, meghajtók, FET-sor; relé: betáp és LED-sor; bemeneti: csatornánkénti oszlopok, ESD-sor
    - lábhoz rendelés: hidegítők a tápjukhoz, gate-ellenállások a gate-hez; a vezérlő elrendezése még hátra (U4)
    - docs/d4mg.pdf: a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
    [bemeneti-modul.kicad_pcb, led-modul.kicad_pcb, rele-modul.kicad_pcb, vezerlo.kicad_pcb]
2026-10-27 Hardver: segédszkriptek – szitanyomat-feliratozó, maszknyitás (D82), rajzszerkesztés szkriptből (D90)
    - gen/felirat.py: a jelölések a saját alkatrészük mellé, padra/viára/fedetlen sávra/más feliratra
    nem lógva; --csak R1,C2,… a kézzel igazított feliratok megtartásához
    - gen/maszknyitas.py: forrasztásgátló-nyitás a nagyáramú sávokon és zónákon (D82), az udvarok és
    a sönt környéke fedett marad; újrafuttatható („D82 maszknyitás” csoport)
    - gen/schedit.py: kézi .kicad_sch-ok módosítása (lábpozíciók, vezeték, címke, tápszimbólum,
    PWR_FLAG, áthelyezés, D-hivatkozások kivétele); csak akkor ír, ha a fájl közben nem változott
    Co-Au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
2026-10-27 Hardver: vezérlő-elrendezés (D87/D88), LED-modul huzalozása és átnézése, HW_REV a modul lapján (D89), konzulensi visszajelzés (D90)
    - D87/D88: a vezérlő elrendezése (U4 a jobb élen, buckok a TI-ajánlás szerint), via-in-pad nélkül
    - LED-modul: a modulmag-blokk téglalapba rendezve, a mérőpontok egymás mellett; Balázs huzalozása;
    átnézés: a fő áramutak végig széles rézen, a via/rés/csonk-hibák javítva, feliratok újra,
    forrasztásgátló-nyitás a nagyáramú utakon (D82)
    - D89: a HW_REV-osztó a modul saját lapjára, a NYÁK-on is a blokkon kívül; a pcbgen a DNP-t és
    a mezőket is átviszi (relé, bemeneti újragenerálva)
    - D90 (konzulens): NRST 10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
    [bemeneti-modul.csv, bemeneti-modul.kicad_pcb, bemeneti-modul.kicad_sch, beszerzes.csv, lcsc-kosar.csv, led-modul.csv, led-modul.kicad_pcb, led-modul.kicad_sch]
2026-10-28 Hardver + kontextus: fő áramutak ellenőrzése (D91), ház-ellenőrzés, konzultáció-előkészítés, prémium halványítás (D92)
    - D91: a táp- és nagyáramú sávok minimuma 0,2 mm a DRC-szabályban (mind a négy lapon); a fő áramutak
    legszűkebb pontját a gen/aramut.py nézi (az ellenorzes.py 6. lépése)
    - LED-modul NYÁK: Balázs huzalozása (R6 bekötve) – bekötetlen 0, rajz ↔ NYÁK eltérés 0
    - NYAK-ELOKESZITES: a lapok ellenőrzése a Gainta D4MG rajzából (bordák, fésű, kivágások)
    - docs/konzultacio/2026-10-27-valaszok.md: válaszok Pali kérdéseire és a nyitott kérdések a 10-28-i konzultációhoz
    (polaritásvédelem, C1 / R7, 5,2 V, blokkbiztosíték,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
    [led-modul.kicad_pcb]
2026-11-02 Hardver + kontextus: konzultáció utáni módosítások – R7 / +24V_F törölve, R207 = 1 kΩ (D93), a LED-modul leválasztása a busztól (D94), DC-DC-hely a relén és a bemenetin (D95)
    - modulmag: CA-IS3052G izolált CAN-transceiver, V_BUS / GND_BUS busz-oldal
    - LED-modul: U208 B0505S-1WR3 + C216–C218, az R12 és az R293 kikerült
    - relé / bemeneti: 0 Ω-os átkötők + DNP DC-DC-hely, NYÁK-ok újragenerálva
    - ellenorzes.py, pcbgen.py, aramut.py, BOM-ok és beszerzési lista frissítve
    - NYAK-ELOKESZITES.md: huzalozás előtti teendők
    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
    [bemeneti-modul.csv, bemeneti-modul.kicad_pcb, bemeneti-modul.kicad_sch, beszerzes.csv, lcsc-kosar.csv, led-modul.csv, led-modul.kicad_pcb, led-modul.kicad_sch]
2026-11-02 Hardver + kontextus: relé – Zener a ULN2803A COM-ágában (D96), bemeneti – visszatáplálás leírva, rendelés 11-05 (D97)
    - relé-rajz: D107 BZT52C15 (katód a COM-on) + R117 0 Ω áthidalás (DNP) a COM és a +24V_P között
    - relé-NYÁK: a D107/R117 a COM mellé, a C104 a D105 mellé, az R9 a D4 mellé; a többi elhelyezés változatlan
    - bemeneti rajz: osztó nélkül csak ≤ 5 V-os jel (a felhúzás a +3V3-ra táplálna vissza)
    - vezérlő: az U2 (LMR33630) marad
    - BOM, beszerzési lista, komponenslista, konzultációs válaszok, áttekintés, ütemterv (11-02 → 11-05)
    Claude-Session: https://claude.ai/code/session_01KV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
    [bemeneti-modul.kicad_sch, beszerzes.csv, lcsc-kosar.csv, rele-modul.csv, rele-modul.kicad_pcb, rele-modul.kicad_sch]
2026-11-02 Hardver: LED-NYÁK huzalozva – busz-sarok a D94 szerint, GND_BUS-zóna az In1-en, U208 a J3 alatt (D98); modulmag #PWR9xx
    - modulmag: a tápszimbólumok jelölése #PWR9xx / #FLG9xx (ütközött a modulok saját #PWR001–049-ével → a KiCad nem engedte az F8-at)
    - ellenorzes.py: annotálási hiba keresése a netlista-exporttal (a parancssori ERC nem nézi)
    - LED-NYÁK: U2 széles SOIC-8 (CA-IS3052G), a kondenzátorok szerep szerint, a busz-sor egy vonalban; huzalozás (Balázs);
    GND_BUS-zóna az In1-en a busz-sarokban; DRC tiszta (csak szitanyomat), nincs bekötetlen, rajz ↔ NYÁK egyezik
    - D98: az U208 átnyúlik a ház ~13 mm-es bordáján → a bordát helyben ki kell vágni
    - RE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
    [led-modul.kicad_pcb, modulmag.kicad_sch]
2026-11-02 LED-modul: áram- és hőátnézés (D99) – F201 20 A, FET-hűtés az In2-n és a B.Cu-n, C203 low-ESR
    - F201 0451020.MRL (20 A, a 75 %-os szabállyal tartósan 15 A); blokkbiztosíték: a szalag ≤ 75 %, 10 A-es csatornához 15 A
    - Q202–Q207: CHx_D-zóna az In2-n és a B.Cu-n + 9–19 termikus via a fülben (drain-réz ~0,9 → ~2,5–3 cm² FET-enként)
    - C203 ERG50V470M10X20 (low-ESR, 1,56 A @ 100 kHz, 43 mΩ) a 705 mA-es általános elkó helyett
    - réz drót a nagyáramú utakra (beültetési teendő), firmware: a TIM1 csatornái fázisban eltolva
    - BOM, LCSC-kosár, komponenslista, áttekintés, NYÁK-előkészítés
    Claude-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
    [beszerzes.csv, lcsc-kosar.csv, led-modul.csv, led-modul.kicad_pcb, led-modul.kicad_sch]
2026-11-02 Bemeneti modul: 7 bemenet, 2 tápcsoport, 4 M-es NYÁK (D100)
    - rajz: kikerült a J308–J316 a csatornáikkal, az U305/U306, a JP303/JP304, az F303/F304, a C306/C307; a PA7–PB15 no-connect
    - NYÁK: 86,5 × 68 mm, újragenerált kezdő elhelyezés (alul a 7 PH egy sorban)
    - MODULMAG-SPEC lábkiosztás, CubeMX-projekt, BOM, beszerzés (4 × D4MG), komponenslista, áttekintés
    - D100; a D48 elvetve, a D73 bemeneti része elvetve
    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
    [bemeneti-modul.csv, bemeneti-modul.kicad_pcb, bemeneti-modul.kicad_sch, beszerzes.csv, lcsc-kosar.csv]
2026-11-02 Hardver: a LED-modul modulmag-blokkja (elhelyezés + huzalozás) a relé- és a bemeneti NYÁK-ra
    - a 40 modulmag-alkatrész a LED szerinti helyen (a bemenetin 32,5 mm-rel balrább), az előlapi LED-ek (D3/D4, R8/R9) kivételével
    - a DC-DC helye (U100 / U300 + kondenzátorok) az U208 helyén; a relén a J4 most a lapon
    - a blokk sávjai és viái, a busz-sarok GND_BUS-zónája (In1), egész lapos GND-sík az In1-en
    - a lelógó maradék kitakarítva; a modul saját alkatrészei felé fanout-csonkok maradtak (HW-ID, HW_REV, VIN_SENSE, LED-ek)
    - DRC: nincs rövidzár / clearance-hiba; huzalozandó: a modul saját része, a 0 Ω-os átkötők, a relén a C105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
    [bemeneti-modul.kicad_pcb, rele-modul.kicad_pcb]
2026-11-03 Hardver: vezérlő – F8 a D93 után, blokkokba rendezett elrendezés (D101), az újrahuzalozás eleje
    - F8: az R7 törölve, a C1/C2/C53/U2 bemenete a +24V_P-n
    - D101: betáp, V_BUS, 5 V-os és 3,3 V-os buck, CAN, ESP-sor, Ethernet, LoRa, USB, kezelő külön blokkban
    (körvonal + név a User.Comments rétegen); az L1 a ~13 mm-es borda fölé került
    - a felső fél régi bekötése törölve, az új huzalozás elkezdve
    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
    [vezerlo.kicad_pcb, vezerlo.kicad_sch]
2026-11-06 Hardver: a vezérlő- és a relé-NYÁK kész – vezérlő átnézve, feliratokkal (D102), relé huzalozva, a K1/K3/K4 COM-ja dróttal (D103)
    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
    [rele-modul.kicad_pcb, vezerlo.kicad_pcb]
2026-11-06 Hardver: a bemeneti NYÁK huzalozva, feliratokkal (D104)
    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
    [bemeneti-modul.kicad_pcb]
