Cloudhunter77/szakdolgozat/(notices)

Notices in the files:
parts and their libraries:
ESP32-C6-WROOM-1/U is a module that supports 2.4 GHz Wi-Fi 6 (802.11 ax), Bluetooth® 5 (LE), Zigbee and Thread (802.15.4) – Forrás: espressif/kicad-libraries (CC-BY-SA 4.0 + KiCad-kivétel).
